langxie29-cpu/QS30-driver/symbols/README.md

# QS30-1 原理图符号建库说明书（供立创EDA 建库）

配套文件：
- 脚号映射：`docs/qs30_1_pin_mapping.csv`
- 符号规格（机器可读）：`symbols/QS30-1_symbol_spec.json`
- 管座封装草案：`symbols/QS30-1_socket_footprint_draft.json`（TBD，H03）
- 管座实测工作表：`docs/footprint/H03_管座实测工作表.md`
- 1:1 校对页：`docs/footprint/QS30-1_管座_1比1校对页.pdf`

## 1. 符号基本信息

| 属性 | 值 |
|---|---|
| 器件名（Symbol Name） | `QS30-1` |
| 位号前缀（Designator） | `J_T`（六只管座 J_T1…J_T6） |
| 器件类型 | 显示管 / 13 脚 |
| 数据手册来源 | S6 南昌电子管厂《QS30 型辉光放电数码管说明书》（版本见 `source_register.md`） |
| 封装 | 13 脚管座（J13-1A 形式）——**封装暂用 PROVISIONAL 草案，H03 关闭前不得投板** |
| 状态 | 符号 VERIFIED；封装 PROVISIONAL |

## 2. 脚号与命名（**必须 1:1，禁止按数字 0–9 重排**）

| 脚号 | 名称 | 电气类型 | 处理 |
|---|---|---|---|
| 1 | IC_KEEP_OPEN | 无连接 | 悬空 |
| 2 | A | 阳极 | 接 HV_BUS 经 20 kΩ 限流 |
| 3 | K0 | 阴极 | 数字 0 |
| 4 | K9 | 阴极 | 数字 9 |
| 5 | K8 | 阴极 | 数字 8 |
| 6 | K7 | 阴极 | 数字 7 |
| 7 | K6 | 阴极 | 数字 6 |
| 8 | IC8_KEEP_OPEN | 无连接 | 悬空（**不接地**） |
| 9 | K5 | 阴极 | 数字 5 |
| 10 | K4 | 阴极 | 数字 4 |
| 11 | K3 | 阴极 | 数字 3 |
| 12 | K2 | 阴极 | 数字 2 |
| 13 | K1 | 阴极 | 数字 1 |

> 注意：3–7、9–13 的**顺序不是 0,1,2…9**，而是原厂电极接线图的顺序（3=K0、4=K9、5=K8、6=K7、7=K6、9=K5、10=K4、11=K3、12=K2、13=K1）。
> 任何"按数字顺序重排"都会导致显示错位，属必须拦截的错误。

## 3. 建库步骤（立创EDA 专业版）

1. 新建符号 → 名称 `QS30-1`，位号前缀 `J_T`。
2. 画矩形外框（建议 20 × 30 mm 视觉比例，非机械尺寸）。
3. 放置 13 个引脚，按上表填 **脚号** 与 **名称**；引脚朝向：阳极在上、阴极在下或按可读性分列（不影响网表）。
4. 引脚电气类型：1/8 设为 `无连接/NC`；2 设为 `阳极`；其余设为 `无源/阴极`（立创EDA 中按可用的电气类型选择即可）。
5. 属性里填写：`Manufacturer=南昌电子管厂`、`MPN=QS30-1`、`Datasheet=S6 原厂说明书（归档文件）`、`Status=HOLD(批次验证)`。
6. 关联封装：使用 13 脚管座封装草案（H03 关闭后替换为实测版）；**封装焊盘号必须等于 1–13**。
7. 在符号上标注：`1/8脚悬空`、`Ea=170V Ra=20k Ik≈2.25mA`，避免后人误接。

## 4. 建库后必须做的核对（签审证据）

- [ ] 原理图符号脚号 = 本表 = 封装焊盘号 = 实物管脚号（4 方一致，逐页签字）
- [ ] 用"1 脚方向图 + 1:1 打印图"与实物管座比对
- [ ] 3D 模型只作外观参考，**不得**用外观吻合替代脚号正确
- [ ] 与 `docs/qs30_1_pin_mapping.csv` 逐行比对（可用脚本：`python design/build.py` 的 ERC 检查不覆盖本项，需人工签字）

## 5. 已知限制

- 符号电气映射 VERIFIED（原厂图）；**观察面/封装坐标**仍是 H03 的实测内容。
- 无小数点/冒号电极；若后续需要，必须另立显示器件与 BOM/HOLD，不占用 1/8 脚。
