langxie29-cpu/QS30-driver/design_decisions.md

# QS30-6 REV.A 设计决策表

版本 REV.A ｜ 日期 2026-10-18 ｜ 状态：**HOLD（可继续 PCB 预布局，禁止投板/生产放行）**

状态定义：`VERIFIED` 有原厂原文或实测证据 ｜ `STRONGLY SUPPORTED` 有充分可靠资料 ｜
`PROVISIONAL` 合理候选、仍需验证 ｜ `HOLD` 缺关键证据 ｜ `FAIL` 已发现不满足要求。

---

## D-01 QS30-1 电极与脚号定义 —— VERIFIED（原厂说明书 S6）

依据：南昌电子管厂《QS30 型辉光放电数码管说明书》"电极接线图"（扫描页放大读图，见
`docs/source_scans/QS30-1_电极接线图.png`）。图为**管底 13 脚圆周排列**，编号 1–13 顺时针；
图内未标注"顶视/底视"，观察方向仍属 H03 的验证内容，但**电气映射本身已由原厂图确定**。

| 物理脚号 | 功能 | 原理图处理 | 封装焊盘 |
|---|---|---|---|
| 1 | 内部电极（非显示，原厂图仅标 ①） | `IC_KEEP_OPEN`，悬空 | 保留焊盘，不接线 |
| 2 | 阳极 A | `A_T1..A_T6` | 1:1 |
| 3 | 数字 0 阴极 K0 | `K_Tn_0` | 1:1 |
| 4 | 数字 9 阴极 K9 | `K_Tn_9` | 1:1 |
| 5 | 数字 8 阴极 K8 | `K_Tn_8` | 1:1 |
| 6 | 数字 7 阴极 K7 | `K_Tn_7` | 1:1 |
| 7 | 数字 6 阴极 K6 | `K_Tn_6` | 1:1 |
| 8 | 内部电极（非显示） | `IC8_KEEP_OPEN`，悬空，**不接地** | 保留焊盘，不接线 |
| 9 | 数字 5 阴极 K5 | `K_Tn_5` | 1:1 |
| 10 | 数字 4 阴极 K4 | `K_Tn_4` | 1:1 |
| 11 | 数字 3 阴极 K3 | `K_Tn_3` | 1:1 |
| 12 | 数字 2 阴极 K2 | `K_Tn_2` | 1:1 |
| 13 | 数字 1 阴极 K1 | `K_Tn_1` | 1:1 |

**结论**：旧交接文件的候选映射（3=K0、4=K9、5=K8、6=K7、7=K6、9=K5…13=K1，1/8 脚不接）
与原厂图一致，予以采纳；符号脚号 = 物理脚号 = 封装焊盘号，**禁止按数字 0–9 重排**。
无小数点/冒号电极（原厂图只有 10 个数字阴极 + 阳极 + 2 个内部电极）。

## D-02 工作参数与额定值 —— VERIFIED（S6 原厂"基本参数"表）

| 参数 | 原厂值 | 本单位处理 |
|---|---|---|
| 起辉电压 Uz | ≤150 V | HV_BUS 设计 172 V > 150 V，正常起辉 |
| 熄灭电压 Ux | ≥100 V | 断电/降额时低于 100 V 全灭，可用于安全判定 |
| 工作电压(直流) Ea | 170 V（原厂推荐点） | 设计 172.18 V（+1.3%），见 D-04 |
| 阴极工作电流 Ik | 1.5 / 2.25 / 3 mA（最小/中心/最大） | 设计 ≈2.36 mA，在 1.5–3 mA 内 |
| 限流电阻 Ra | 20 kΩ @170 V（推荐表：170/20、200/33、220/43、250/56、280/68、300/82） | 20 kΩ（2×10 kΩ/2 W 串联） |
| 寿命 | 1000 h | 长期常亮显示需按此评估（记录为限制条件） |
| 外形 | φ30.2；总高 34±1.5；本体 26±0.5；13×φ1.3；显示高度 15–16 mm | 用于结构/管座间距初值 |
| 管基 | GB 787-74 J13-1A | 机械尺寸仍需 H03 证据 |
| 重量 | ≤15 g | 结构评估参考 |

## D-03 驱动架构与 HV5622 数量 —— VERIFIED（S5 数据手册重算）

- 需求：6 管 × 10 数字 = **60 路**独立数字阴极通道（静态驱动，不扫描）。
- S5：HV5622 = 32-bit 移位寄存器 + **32 路**开漏高压输出；VDD 10.8–13.2 V；
  HVOUT 推荐 ≤220 V、绝对最大 230 V；灌电流 ≥100 mA；44 脚 PQFP/PLCC。
- **重算结论：2 片 × 32 = 64 路 ≥ 60 路，采用 2 片**。旧交接文件的"3 片 / 96 路"不再成立，
  除非增加 4 位以上扩展显示；本次无该需求。帧长相应由 96 bit 改为 **64 bit**。
- 通道分配：CH0–31 → U21（HVOUT1–32），CH32–63 → U22（HVOUT1–32）；CH60–63 备用、输出不接。
- 每管 10 路连续分配：`CH = (管位−1)×10 + 数字`，于是 **J_T4 跨越 U21/U22 边界**
  （数字 0–1 在 U21，数字 2–9 在 U22），必须逐位验证，见 D-07。

## D-04 高压工作点与阳极支路 —— PROVISIONAL（值），VERIFIED（依据）

- HV_BUS 目标 172.18 V = 2.5 V × (1 + 1500 kΩ / 22.1 kΩ)，由 R69/R70（2×750 kΩ）+ R71（22.1 kΩ）设定。
- 每管限流：R90…R101 = 2×10 kΩ/2 W 串联 = 20 kΩ（原厂推荐值）。
  - 正常：I ≈ (172.18 − U_tube)/20 kΩ；若 U_tube≈125 V 则 2.36 mA，管耗 ≈0.29 W。
  - 单管短路（阳极–阴极直通）：电阻耗散 172.18²/20 kΩ ≈ **1.48 W**（每只 2 W 电阻 0.74 W，37%）。
  - 因此**不得**用 1/4 W 或单只 1 W 电阻替代。
- 六管总负载：6×2.36 mA ≈ 14.2 mA → 2.44 W；加泄放 0.86 mA + 反馈分压 0.11 mA → ≈2.61 W。
- 工作点未冻结原因：U_tube 随批次/电流/温度变化，必须用单管夹具实测（H02/H06）后按
  `R_A = (Ea − U_tube − V_sink) / I` 复核。

## D-05 HV5622 控制极性与安全默认态 —— VERIFIED（S5 Table 3-2）

| 输入 | 取值 | 结论 |
|---|---|---|
| POL | 固定接 DRV_VDD（高） | POL=H 时 BL=L → 全部关断；BL=H → 由锁存数据决定 |
| BL | 低 = 消隐（全部关断） | 12 V 域 10 kΩ 下拉，3.3 V 失电/转换器未供电时为低 |
| LE | 高电平把移位寄存器装入锁存器（Table 3-2 "Load Latches"） | 数据手册引脚名带横线，但真值表明确 LE=H 装载，按真值表执行 |
| CLK | **下降沿**移位 | SPI 采样边沿须实测匹配 |
| DATA | 1 = 通道导通（POL=H、BL=H） | 全 0 帧 = 全灭 |

**关键风险（已在硬件中处理）**：POL=L 且 BL=L 时器件为"All On"。因此 POL 不接 MCU、不悬空；
同时升压使能受 DRV_VDD 电源良好（DRV_PG）门控，驱动未上电时高压不会建立。

## D-06 3.3 V → 12 V 电平转换 —— VERIFIED（S13 引脚），PROVISIONAL（时序实测）

- U3/U4 = CD40109B：VCC=3V3、VDD=DRV_VDD、VSS=GND；每个通道独立 ENABLE 接 3V3。
  - 3.3 V 失电 → ENABLE=0 → 输出高阻，同时 12 V 域每个输入有 10 kΩ 下拉 → **确定低电平/消隐**。
  - 引脚：1 VCC、2/7/9/15 ENABLE A–D、3/6/10/14 A–D、4/5/11/13 E–H、8 VSS、12 NC、16 VDD。
  - 通道分配：DIN/CLK/LAT/ALLOW → E/F/G/H；第二片用于 HV_EN_REQ（其余通道输入接地）。
- 输入高电平要求：器件规定输入摆幅须到 ≥0.7·VCC；VCC=3.3 V → VIH≈2.31 V，3.3 V GPIO 满足。
- 传播延迟：VCC=5 V/VDD=10 V 时最大 300 ns；3.3 V/12 V 条件下按 **≤600 ns 暂估**（待实测）。
  → **SPI 起始频率取 100 kHz，上限按 200 kHz 评估**（周期 5 µs，留 ≥8 倍裕量）。
  该限值远低于 HV5622 的 8 MHz 能力，显示刷新不受影响。

## D-07 通道映射与串行位序 —— 映射 VERIFIED，位序 PROVISIONAL

- 完整表见 `docs/channel_mapping.csv`（64 行）与 `docs/schematic/QS30-6_REV.A_通道映射表.png`。
- HVOUT↔PQFP 引脚（S5 Table 2-1）：HVOUT1→pin22、HVOUT2→pin21 … HVOUT22→pin1；
  HVOUT23→pin44、HVOUT24→pin43 … HVOUT32→pin35。
- 串行位序假设：64 bit 帧，bit0 先发，`bit_j = CH(63−j)`（U21 的近端位在最后）。
  **必须用 walking-one 实测**（0x0000000000000001、0x0000000000000002…逐位）确定
  近端/远端器件与字节位序，不得用软件数组掩盖镜像封装。位序确认前不得写死固件 LUT。

## D-08 电源架构与预算 —— PROVISIONAL（数值来自计算/仿真）

```
J1 12V → F1(PPTC 1.5A) → D1(TVS) → D2(SS54 反接) = EXT12 (≈11.5 V)
EXT12 → U1 TPS54202 → EXT5 (5.08 V) ─┐
VBUS (USB-C) ────────────────────────┴→ D3/D4 双肖特基 OR → 5V_SYS (≈4.73 V) → U2 SY8089A → 3V3 (3.315 V)
EXT12 → Q1(DMP3098L, 默认关断) → DRV_VDD (≈11.45 V) → U21/U22 VDD、CD40109B VDD
EXT12 → Q26(默认关断) → HV_IN → U20 UC3843 升压 → HV_BUS 172 V
```

| 域 | 设计值 | 负载/预算 | 依据 |
|---|---|---|---|
| EXT12 | 11.5 V（12 V−0.5 V） | 总 ≈0.60 A（7.2 W） | 计算：升压 0.29 A + 5 V 级 0.28 A + 驱动逻辑 0.03 A |
| EXT5 | 5.08 V | ≤0.8 A | TPS54202 2 A |
| 5V_SYS | ≈4.73 V（EXT5−0.35 V）或 4.65 V（VBUS−0.35 V） | ≈0.63 A | SY8089A 2 A / TPS54202 2 A |
| 3V3 | 3.315 V | 800 mA 分配（模组 500 + 接口 50 + 扩展 50 + 瞬态 200） | S1 要求 ≥500 mA 供电能力；1 A 以上稳压器 |
| DRV_VDD | ≈11.45 V | HV5622 静态 + 6 路灌电流 | 必须在 10.8–13.2 V 内（S5） |
| HV_BUS | 172.18 V | 六管 14.2 mA + 泄放/分压 | S6 + D-03 |

- **USB 单独供电限制**：USB-C 仅声明默认 500 mA（CC 5.1 kΩ）。仅 USB 供电时固件必须关闭
  Wi-Fi 发射并限制负载；整机满功能不得依赖 USB 供电（H05 验证项）。
- 3.3 V 瞬态：模组 Wi-Fi 发射峰值按 S1 的 ≥500 mA 供电要求预留，实测项见 test_plan 阶段 A。

## D-09 硬件使能门控 —— PROVISIONAL（门限已计算，器件候选）

| 信号 | 判据 | 计算 |
|---|---|---|
| EXT12_PG | EXT12 ≥ 10.80 V | 2.5 V×(100 k+30.1 k)/30.1 k = 10.80 V |
| P3V3_PG | 3V3 ≥ 3.107 V | 2.5 V×(10 k+41.2 k)/41.2 k = 3.107 V |
| DRV_PG | DRV_VDD ≥ 10.41 V | 2.5 V×(100 k+31.6 k)/31.6 k = 10.41 V |
| FAULT_OK | HV_FAULT_N 高（无故障） | 故障分压：11.45 V→3.06 V；故障时 0 V |
| **DRV_VDD_EN** | EXT12_PG · 3V3_PG · HV_EN_REQ | 74HC08 门 1+2 |
| **HV_EN** | DRV_PG · FAULT_OK · HV_EN_REQ | 74HC08 门 3+4 |

- MCU 只能"请求"（GPIO16 = HV_EN_REQ）；上述组合由 **74HC08 + 比较器 + 基准** 在硬件中完成。
- 全部输出默认低：74HC08 由 3V3 供电，3V3 未建立时输出低；HV_EN 另有 100 kΩ 下拉；
  Q1/Q26 栅极经 100 kΩ 上拉到源极 → **默认关断**。
- 掉电顺序：先消隐（DRV_BL 低）→ 关升压 → HV 泄放 → 再撤驱动逻辑电源；失电时
  12 V 域下拉保证 BL 低、HV_EN 低。

## D-10 独立硬件过压保护 —— PROVISIONAL（电路已设计，尚需实物验证）

- 取样：R75/R76 = 2×750 kΩ、R77 = 19.1 kΩ → 触发 198.8 V（2.5 V TL431 基准）。
- 比较器：U23 LM393（由 EXT12 供电，独立于 MCU 与 3.3 V）。
- 锁存：Q21(PNP)+Q22(NPN) 分立 SCR；触发后 Q23 拉低 UC3843 COMP（占空比→0），
  Q24 拉低 `HV_FAULT_N`（低有效，经分压进 MCU GPIO7，并作为 FAULT_OK 参与门控）。
- 受控恢复：MCU GPIO18 脉冲 → Q25 拉低 OVP_LATCH；仅当 HV 已降到 198.8 V 以下才真正释放。
- 阈值裕量：HV_BUS 172 V < 198.8 V < HV5622 推荐 220 V / 绝对最大 230 V；
  输出电容 250 V 额定 > 198.8 V（含启动过冲 180.7 V，仿真值）。
- **仿真（`design/sim_boost.py` S7/S8）**：反馈分压开路时输出在 142 ms 冲到 198.8 V，
  被 OVP 关断并锁存；复位后因故障未消除在 558 ms 再次触发。

### 故障 → 关断路径矩阵

| 故障 | 关断路径 | 仿真/证据 | 仍需实物验证 |
|---|---|---|---|
| ESP32 死机/复位 | HV_EN_REQ 复位为低 → HV_EN 低 → Q26 关断；无 MCU 也能保持 OVP/过流保护 | 逻辑分析 | 上电/复位瞬态 |
| ADC 读数错误 | ADC 仅监控；硬件 OVP 独立 | 设计 | 分压/ADC 校准 |
| GPIO 卡在高电平（HV_EN_REQ） | 仍需 EXT12_PG·3V3_PG·DRV_PG·FAULT_OK 同时成立；OVP 独立 | 设计 | 注入故障测试 |
| 反馈分压断路 | FB=0 → 满占空 → 198.8 V OVP 锁存（S7） | 仿真 S7 | 实物断路测试 |
| 升压输出超过上限 | OVP 比较器 → SCR 锁存 → COMP 拉低 + HV_FAULT_N | 仿真 S7/S8 | 阈值容差实测 |
| 驱动电源先于高压掉电 | DRV_BL/DRV 域下拉 → 全关；且 HV_EN 需 DRV_PG | 设计 | 时序示波器 |
| 输入电源突然断开 | HV 通过 200 kΩ 泄放到 50 V 需 ≈3.8 s（S9）；期间保持隔离 | 仿真 S9 | 实测下降曲线/等待时间 |
| 单通道/单管短路 | 阳极电阻限流 1.48 W；驱动输出 Off 态 10 µA | 计算 | 单管短路试验 |

## D-11 升压变换器设计 —— PROVISIONAL（计算+仿真），待实测

| 项目 | 取值 | 依据 |
|---|---|---|
| 拓扑 | Boost，UC3843 峰值电流模式 | 12 V→172 V，输出 ≈2.6 W |
| fsw | 78 kHz = 1.72/(10 kΩ×2.2 nF) | UC3843 RT/CT |
| L20 | 220 µH，**Isat ≥5 A** | 稳态 ΔI≈0.65 A；启动浪涌峰值 2.9–3.1 A（仿真） |
| Q20 | IRF740（400 V/10 A，TO-220） | 172 V + 振铃，2 倍以上裕量 |
| D20 | UF4007（1000 V/1 A，快恢复） | 反压 172 V；浪涌电流容限 |
| 采样 | 1 Ω/1 W → 1 V 门限 = 1 A 峰值限流 | UC3843 ISENSE 1 V |
| Cout | 2×10 µF/250 V + 0.1 µF/630 V | 纹波/储能；250 V 额定 |
| 泄放 | 2×100 kΩ = 200 kΩ（τ≈4 s） | 断电到 50 V 实测仿真 3.84 s |
| 反馈 | 2×750 kΩ / 22.1 kΩ → 172.18 V | UC3843 VFB 2.5 V |
| 软启动 | COMP 22 µF（≈1 mA 上拉，参考斜坡 150 ms） | 启动过冲 180.7 V（+5.0%） |
| RCD 钳位 | D21 + 10 nF/630 V + 100 kΩ/2 W | 抑制漏感尖峰 |

**启动浪涌发现（重要）**：HV_EN 接通瞬间，HV_IN 经 L20、D20 直接给 20 µF 充电，
峰值电流由 L–C 与 DCR 决定，仿真 **2.9–3.1 A**（12 V/220 µH/20 µF）。
→ 必须选用 Isat ≥5 A 电感；PPTC(1.5 A hold) 的 I²t 需实测确认不误动作；
  二极管 30 A 浪涌余量足够。若实测浪涌超标，在 H06 内评估 NTC/预充电阻方案。

**仿真关键结果**（行为模型，详见 `sim/results/summary.json`）：

| 场景 | 稳态电压 | 峰值 | 过冲 | 备注 |
|---|---|---|---|---|
| S1 启动（六管） | 172.08 V | 180.75 V | +4.97% | 未触发 OVP |
| S4 六管稳态 | 172.08 V | — | — | 纹波 1.1 Vpp，效率 77.6% |
| S2 空载（消隐） | 172.19 V | 187.4 V | +8.8% | 效率 57%（轻载） |
| S3 单管 | 171.81 V | — | +7.9% | 效率 59.6% |
| S5 负载突变 6→1→6 | 172.34 V | 180.75 V | — | 效率 79.0% |
| S6 输入 12/11.4/12.6 V | 172.21 V | 180.3 V | — | 效率 77.7% |
| S7 反馈开路 | — | 198.80 V | — | 142 ms 触发 OVP 并锁存 |
| S8 锁存→复位 | — | 198.81 V | — | 558 ms 再次触发 |
| S9 断电 | — | — | — | 到 50 V 用时 **3.84 s** |
| S10 输出短路 10 Ω | 10.8 V | — | — | 峰值限流工作，无 OVP 误动作 |

## D-12 MCU / USB / 接口分配 —— 与交接文件一致（可追溯）

- 焊接焊盘编号已用 S1/S2 核对，GPIO/焊盘/网络对照由 `docs/erc_report.md` 的 ERC-04 自动校验通过。
- 与交接文件的差异：新增 **GPIO18=OVP_RST**（过压锁存受控复位）；GPIO13/GPIO21 仍作扩展。
- USB：GPIO19=D−、GPIO20=D+；22 Ω 串联（S1b 建议 22/33 Ω）；CC1/CC2 各 5.1 kΩ；
  U11 USBLC6-2SC6 靠近连接器；VBUS 与 5V_SYS 经肖特基 OR（反向阻断）。
- UART0：GPIO43(TXD0)/GPIO44(RXD0)，TXD0 串 499 Ω（S1b 建议），3V3 参考点经 0 Ω（默认不装）。
- 启动：EN=10 kΩ+1 µF；GPIO0=10 kΩ 上拉 + BOOT 按键；GPIO46=10 kΩ 下拉；GPIO3/45 不接外设。
- 扩展/测试：TP1–TP20、J4（3V3/GND/IO13/IO21/I2C）。

## D-13 PCB 分区与层叠 —— PROVISIONAL（预布局）

- 建议外形 **230 × 120 mm**，4 层（信号–地–电源–底层），两层板仅在回流/禁布/抗扰实测通过后采用。
- 六个管座沿上侧排布，中心距 **36 mm**（φ30.2 + 插拔/散热余量；待 H03 实测管座后冻结）。
- 天线：模组天线端朝板边并伸出；天线投影区及两侧全层禁铜/禁线/禁孔/禁件；
  外壳各方向建议 ≥15 mm 净空（H08）。
- 高压区（升压/OVP/驱动）与 USB/天线/按键分区，中间设 2 mm 隔离槽/禁布带（H07 定稿）。
- USB 差分 90 Ω ±10%（按板厂层叠计算，不复制他板线宽）；下方连续地参考。
- HV 网络（HV_BUS、SW_HV、阳极、阴极、采样/反馈）单独网络类别，规则暂按 1.0 mm 间距占位。

## D-15 管座封装草案的“不猜测”策略 —— PROVISIONAL

- 原厂资料只给**管子**尺寸（φ30.2、34±1.5、26±0.5、13×φ1.3）与**电气脚号关系**，
  不给**管座焊脚坐标**；GB 787-74 正文未取得，且"J13-1A"是管基型号、不等于任何在售管座。
- 因此封装草案（`symbols/QS30-1_socket_footprint_draft.json`）只包含：
  脚号 1:1 规则、管体参考尺寸、13 等分角度（360/13），**所有焊盘几何字段为 TBD/None**；
  生成脚本内置校验，若出现任何被猜出来的数值数字则直接失败（已验证 PASS）。
- 1:1 校对页（300 dpi）只画已核实尺寸 + 100 mm 标尺 + 待填表格，用于现场叠图测量；
  实测结果填回 JSON 后方可生成封装 v2（H03 关闭证据）。

## D-16 仿真可信度策略 —— 步长必须收敛

- 开关级模型用固定步长（开关周期 1/N）。步长过粗会显著改变结论：
  Ts/40 时稳态电压偏高 **13.5%**、峰值偏高 8.7%（见 `sim/results/convergence.md`）。
- 因此规定：**主仿真使用 Ts/80**（相对 Ts/160 的稳态偏差 ≤0.4%、峰值 ≤0.01%）；
  任何引用仿真数字的文档必须同时写明模型类型与步长，禁止只报结果。
- 该模型不是器件级 SPICE；SPICE 引擎在本环境不可用（KiCad 安装需管理员权限、
  ngspice 下载被 403），`sim/boost_uc3843.cir` 为参考网表且**未执行**。

## D-18 仿真证据分级 —— 三种证据，用途不同

| 级别 | 工具 | 覆盖 | 已执行? |
|---|---|---|---|
| A. 厂商 SPICE | ngspice/LTspice | 器件级开关/寄生/环路 | **否**（环境无该软件，网表未执行） |
| B. 仓库自带 SPICE 子集 | `sim/minispice.py` | 功率级 RLC+二极管+压控开关、固定占空比 | **是**：解析解自检 PASS；升压功率级 Vout 171.99 V vs 解析 171.95 V、iL 峰值 503 vs 510 mA、纹波 8.7 vs 9.0 mVpp、效率 95.9% |
| C. 行为模型 | `design/sim_boost.py` | 闭环、软启动、OVP 锁存/复位、泄放、短路 | **是**：S1–S10，步长 Ts/80 收敛 |

- 结论引用规则：**功率级数值**优先用 B（有解析对照）；**闭环/保护行为**用 C；
  器件级尖峰、EMI、温升必须等 A 或实物（H06）。
- Coss 敏感性（B）：100 pF 开关节点电容使效率从 95.9% 降到 91.0% → 低 Coss 器件是硬要求。
- B 源已支持并自检 PASS；但**闭环** SPICE 的环路时间常数 ≈170 ms（CINT 22 µF + Ki 1.3e-4），
  按开关级步长需 >10⁶ 步，超出本环境算力 → 闭环仍以 C（行为模型）为准，
  `sim/boost_uc3843.cir` 继续标注为未执行参考网表。

## D-19 网表级 DRC 预检 —— 把能机器检查的项先查掉

在无立创EDA 的环境里，用 `design/drc_precheck.py` 从同一设计数据库做 10 项
**隔离/端点/规则覆盖**检查（当前 10/10 PASS）：

| 检查 | 内容 |
|---|---|
| D1 | HV 网络端点必须在高压允许清单（防高压误连低压器件） |
| D2 | 3.3 V 器件不得直接连 HV/DRV 网络 |
| D3 | 12 V 域器件不得连 3V3 |
| D4/D5 | 60 路阴极 / 6 路阳极网络端点结构正确（各 2 端点） |
| D6 | HV_BUS 端点清单审计（17 个端点全部白名单） |
| D7 | HV 网络测试点白名单（TP6/TP19，须丝印高压警告） |
| D8 | HV 网络类别/间距规则覆盖（1.0 mm 占位，H07 定稿） |
| D9 | MCU 页不出现 HV 器件（HV 分压电阻画在 MCU 页 → 必须在高压区布置） |
| D10 | HV 网络与 3V3 网络无共享器件 |

**边界**：这不是原生 DRC；布线间距、孔径、天线禁布、爬电距离必须等 H07/H09 的 EDA 执行。

## 基线数字（单一事实来源：docs/design_summary.json）

- 器件 **227** 个、引脚 **736** 个、网络 **172** 个、已用通道 **60** 路（2×HV5622 共 64 路，4 路备用）；
- 19 项 ERC 检查 0 错误 0 告警；DRC 预检 14/14；测试计划一致性 5/5。

## D-20 HOLD 证据验收框架 —— 把"缺什么证据"变成可执行检查

`design/evidence_templates.py` 从设计数据库生成 10 个证据模板（`docs/evidence/`），
**期望值/判据自动填入**（如 QS30-1 期望发光脚、OVP 197.3–200.3 V、纹波 <200 mVpp、
滞放 ≤5 s、浪涌 ≤3.5 A），避免人工抄错；`design/evidence_check.py` 把每个 HOLD 判为：

| 状态 | 含义 |
|---|---|
| 未提交 | 全部单元格仍为 FILL |
| 部分提交 | 有填写但未填完 |
| 已提交·判据通过 | 全部填写且落在设计判据内 |
| 已提交·判据失败 | 有数值越界/映射错误（输出具体失败项） |

框架自测（`docs/evidence_selftest.md`）用合成数据证明：未提交→正确识别；合法数据→7/7 通过；
人为注入 3 处错误（OVP 215 V、walking-one 错位、非显示脚"发光"）→ 校验器准确捕获并退出码 2。
**自动校验不替代签审**：PASS 后仍需在 `HOLD_REGISTER.md` 记录签署人/日期/版本。

## D-21 闭环 SPICE：平均模型（已执行）

| 项 | 内容 |
|---|---|
| 模型 | 平均开关节点 `v_sw=(1−d)(Vout+Vf)`；平均二极管电流 `(1−d)·iL` 注入输出；L/C 显式积分 |
| 控制器 | 与 BOM 相同的 CINT 22 µF、Ki=1.3e-4 A/V、Kp=0.05（PI） |
| 已执行 | 启动/稳态 300 ms、负载 +50% 与输入 12→11.4 V 阶跃 500 ms（步长 20 µs） |
| 结果 | 172.18 V（误差 3 mV）、duty 0.931、iL 219 mA；负载 +50% 下探 0.25 V；输入 12→11.4 V 下探 3.90 V/恢复 8 ms；闭环判据 **8/8**；初值取工作点，启动暂态由行为模型 S1 覆盖 |
| 边界 | 不含开关纹波/器件应力（开关级覆盖）；不含 OVP 锁存（行为模型 S7/S8 覆盖）；R72/C56 实际补偿相位裕度需 H06 实测 |
| 与开关级闭环的关系 | 开关级闭环受算力限制未执行（I-23）→ 用「平均模型闭环 + 开关级开环 + 行为模型」三段证据组合 |

## D-22 独立 OVP 的 SPICE 侧证据（保护逻辑行为模型）

`sim/boost_ovp_logic.cir`：升压级等效为限流受控电流源 + 输出电容，验证保护**时序**：

| 判据 | 结果 |
|---|---|
| 首次触发电压 198.8±3 V | **198.92 V**（1.14 ms） |
| 触发后锁存并关断 | PASS（0.05–0.59 s 内 latch≈1、EN=0） |
| 泄放（0.3 s 时 <150 V） | 123.1 V |
| 复位脉冲释放锁存 | PASS（GPIO18 脉冲；等价"SCR 在 OVP 有效时不可复位"，故复位仅在 HV 低于阈值时生效） |
| 故障未消除 → 再次锁存 | PASS |
| 全过程最大电压 ≤205 V | 201.92 V |
| 最终保持锁存/关断 | PASS |

与行为模型 S7/S8（198.80 V 触发 / 142 ms；复位后 558 ms 再触发）互为独立证据；
器件级 SCR 维持电流/触发延迟/结温仍属 H06。

## D-23 HOLD 签署联动 —— 自动证据 + 人工签审

`design/hold_signoff.py` 读取自动证据状态与 `docs/HOLD_SIGNOFF.csv` 签署表，联动规则：

| 自动证据 | 签署 | 联动结果 |
|---|---|---|
| complete | 签署齐全 + CLOSED | **CLOSED**（解除阻塞） |
| complete | 未签署 | PENDING_SIGN |
| missing/partial/fail | 决定 CLOSED | **VIOLATION**（必须撤销） |
| H01/H09（无 CSV） | 未签署 | MANUAL（需人工审查记录） |

**自动校验不能单独关闭 HOLD**：证据通过只把状态推进到"待签署"，必须人工签审才解除投板/生产阻塞。

## D-24 环路参数敏感性扫描（供 H06 补偿调整）

`design/loop_scan.py`：27 组 CINT/Ki/Kp × 输入阶跃，结果 `docs/loop_scan.md/csv`：

| 结论 | 数据 |
|---|---|
| 比例项主导下探 | Kp 0→0.05→0.15：下探 8.2→4.1→2.1 V |
| 积分项影响恢复/稳态 | Ki 过小 + CINT 47 µF + Kp 0.15 → 末段振荡 95 mV（不稳定） |
| BOM 参考点 | CINT 22 µF / Ki 1.3e-4 / Kp 0.05 → 下探 4.10 V，恢复 9 ms |
| 26/27 组稳定 | 仅 1 组振荡（给出稳定边界） |

**边界**：PI 等效 ≠ UC3843 电流模式 Type-II 补偿（R72 10 k / C56 0.1 µF / C55 22 µF 软启动）；
本扫描只用于趋势与稳定性边界，R72/C56 最终值须 H06 实测相位裕度确定。

## D-25 OVP 复位时序窗口（SPICE 行为模型）

`design/ovp_timing_scan.py`（7 组复位脉宽）：

| 结论 | 数据 |
|---|---|
| 不复位时锁存保持 | 0.9 s 内保持（latch>0.9），输出安全泄放 |
| 可靠复位最小脉宽 | 0.2 ms（20 µs 步长分辨率） |
| 复位后故障未消除 | 再次锁存，最大电压 201.3–201.9 V |
| 复位有效性条件 | 仅当 HV 低于 OVP 阈值（OVP 有效时复位无效） |

**边界**：行为级 SCR 等效，不含维持电流/门极延迟/结温/dV/dt 误触发 → H06 实物时序窗口。

## D-26 测试计划机器可读化与一致性检查

`docs/test_plan.md`（人读）整理为 `docs/test_plan.csv`（37 项，阶段 A–E，含证据目标），
`design/test_plan_check.py` 做 5 项检查（**5/5 PASS**）：

| 检查 | 内容 |
|---|---|
| T1 | 序号唯一、阶段 A–E 齐全、状态合法 |
| T2 | 每个 evidence_target 的 HOLD 合法且证据文件存在 |
| T3 | 10 个证据 CSV 全部被测试计划引用（无孤立证据） |
| T4 | 阶段↔证据映射（C→H06、C0→H07、D→H02/H03、B→H04、E3→H08） |
| T5 | test_plan.md 与 CSV 序号集合一致（防文档漂移） |

新增 C0（PCB 高压间距/爬电实测）测试项，补上 H07 的硬件验证入口。

## D-27 固件约束清单（从设计数据库派生）

`design/firmware_constraints.py` 从网表与通道映射自动生成 `docs/firmware_constraints.md/json`，
**GPIO/网络名不手写**（防止与原理图脱节）。当前：8 个控制脚（DISP_DIN/CLK/LAT/ALLOW、
HV_EN_REQ、OVP_RST、HV_SENSE_ADC、HVF_NODE）、**64 位帧**（60 用 + 4 备）、13 条约束：

| 类别 | 关键约束 |
|---|---|
| 帧/位序 | 64 位，MSB-first，bit=63−ch（H04 实测前 PROVISIONAL） |
| 时序 | CLK 下降沿移位，LE 高装载；SPI ≤200 kHz（起始 100 kHz） |
| 消隐 | DISP_ALLOW(IO15) → CD40109B → DRV_BL：BL=0 全关 |
| 门控 | HV_EN_REQ 仅在自检通过后置 1；复位期间必须为 0 |
| 故障 | 读 HVF_NODE(IO7)；FAULT_OK=0 硬件关 HV；不得自动反复复位 |
| OVP 复位 | 脉宽 ≥0.2 ms，且 HV<198.8 V 时才有效 |
| 供电 | USB-only ≤500 mA；备用通道 ch60–63 发 0 |

## D-28 跨文档关键数字一致性检查

`design/doc_number_check.py` 把"单一事实来源=机器可读结果"落到检查上（**5/5 PASS**）：

| 检查 | 内容 |
|---|---|
| C1 | 关键数字在 README 与 design_decisions 均出现（172.18/198.8/95.9%/227/736/60） |
| C2 | 当前文档不得出现废弃旧值（95.8%、"负载 158 ms"误归因、"启动建立时间"） |
| C3 | 平均模型判据必须是 8/8（曾为 7/7） |
| C4 | 审查包页数与 CHANGELOG 最后记录一致 |
| C5 | 与 design_summary/spice_validation/drc_precheck/test_plan_check 的机器结果一致 |

本轮它实际抓到 4 处漂移（95.8%、158 ms 误归因、7/7、缺少基线数字）并已修正——说明检查有效。

## D-29 BOM 选型复核（关键器件降额/替代料）

`design/bom_review.py` 对 14 个关键器件做自动化降额检查（**5/5 PASS**）：

| 检查 | 规则 | 结果 |
|---|---|---|
| H1 | 关键器件均在 BOM 中 | 14/14 |
| H2 | L20 满足 Isat ≥5 A（F-04） | BOM 已更新为 `220 µH ≥5 A` |
| H3 | 高压器件额定 ≥ 248 V（max(172.18,198.8)×1.25） | Q20 400 V、D20 1000 V、C49/C52 630 V、C50/C51 250 V |
| H4 | 阳极电阻降额 ≤80% | 1.48 W / 2 W = 74% |
| H5 | 替代料/封装状态已列 | WARN：U20 的 DIP-8/SOIC-8 需在结构确定后冻结 |

**边界**：温度降额、纹波电流/ESR、磁芯饱和曲线、封装热阻仍需手册与实测（H06/H07）；
本复核不构成可下单依据；HOLD 未关闭前不得释放 Gerber。

## D-30 热与浪涌复核（参数区间法）

`design/thermal_review.py`：

- **HV5622 功耗**：静态驱动每管恒 1 路导通 → 每片同时导通 3 路；I=2.36 mA、VDD=11.45 V，
  静态电流 1–5 mA、Von 1–3 V、Rth_ja 40–80 °C/W（**均待手册核实**）→
  总功耗 19–78 mW，**温升 0.7–6.3 °C**（环境 25 °C）→ 热风险低；
- **PPTC/浪涌**（S1 波形）：峰值 3.12 A、60 ms 内 I²t ≈ **0.0010 A²·s**、超 1.5 A 仅 0.1 ms
  → 远低于典型 1812 PPTC 的 I²t 下限（0.1 A²·s 量级），**预期不误动作**；
- 新增 open_issues **I-25**：PPTC 手册 I²t/触发曲线与 HV5622 手册参数需核实 → H05/H06 实测。

## D-31 投板前检查清单（自动汇总，硬性拒绝放行）

`design/preflight_checklist.py` 汇总 11 项机器检查与 9 个 HOLD，输出
`docs/preflight_checklist.md`：

- 规则：**任一 HOLD 未 CLOSED 或任一机器检查 FAIL → RELEASE BLOCKED**；
- 当前：机器检查 **11/11 PASS**，HOLD **CLOSED 0/9** → **RELEASE BLOCKED**（不得投板/下单/Gerber）；
- 明确"本脚本不会自动放行"，放行必须人工签署 + 原生 EDA ERC/DRC（H09）；
- 列出 12 项投板前必须关闭/冻结的事项（含 U20 封装、HV5622 手册参数、PPTC I²t）。

## D-17 仍未冻结的内容

见 `HOLD_REGISTER.md`（H01–H09）。**任何 HOLD 未关闭前，本设计不得投板、不得标注 production-ready。**
