langxie29-cpu/QS30-driver/HOLD_REGISTER.md

# QS30-6 REV.A HOLD 登记册

只保留**真正缺乏证据、必须阻止设计冻结或生产放行**的问题。
关闭单项 ≠ 整机放行；全部关闭后仍须另行设计审查与授权。

当前状态：**H01–H09 全部未关闭**。更新日期 2026-10-18。

**签署联动已就绪**：`docs/HOLD_SIGNOFF.csv` + `design/hold_signoff.py`
（CLOSED = 自动证据通过 **且** 签署齐全；证据未通过却签 CLOSED 记为 VIOLATION）。

**证据模板已就绪**：`docs/evidence/`（10 个 CSV，期望值与判据自动填入）；
填表后运行 `python design/evidence_check.py` 自动判定「未提交/部分/通过/失败」，
报告见 `docs/hold_closure_report.md`；框架自身已用合成数据自测（`docs/evidence_selftest.md`）。
自动校验通过后仍需在本表人工签署关闭。

| 编号 | 待关闭事项 | 关闭所需证据（可验收） | 当前进展 | 责任（建议） |
|---|---|---|---|---|
| H01 | 完整基线 / 原理图审查 | 旧交接正文、旧原理图/网表、BOM 纳入版本库；本 REV.A 网表逐网络比对记录；逐页审查签字 | 本仓库已产出 REV.A 网表（225 器件/732 引脚/172 网络）与连接表；旧基线缺失 | 硬件设计与复核 |
| H02 | QS30-1 实物管脚与工作点 | 商标/批次照片；逐脚限流点亮记录（2=A、3..13=K0,K9..K1、1/8 不接）；U_tube、I、起辉/熄灭电压；观察面记录 | 原厂图映射已 VERIFIED；实物未测 | 硬件测试 |
| H03 | J13-1A 管座与 PCB 封装 | 厂家机械图或实测：13 触点→焊脚通断表、各焊脚 XY/脚径/公差、1 脚定位缺口、观察面标注、1:1 打印比对、试插证据 | **封装未定义**：已产出参数化草案（全部 TBD、脚本校验无猜测数值）+ 1:1 校对页 + H03 实测工作表；仍缺实测数据与采购件型号。GB 787-74 正文未取得 | 结构与 PCB |
| H04 | 驱动器与电平转换 | HV5622 型号/封装锁定（PQFP-44）；CD40109B 时序实测；96→64 bit 链路 walking-one 位序表；极性真值表；失电回灌与上电状态实测 | 引脚/真值表 VERIFIED；位序与时序未测 | 硬件 + 固件 |
| H05 | 输入、3.3 V 与 USB 供电 | 12 V 输入范围/浪涌/PPTC 实测；TPS54202/SY8089A 选型与热/纹波/瞬态；Wi-Fi TX 峰值与压降；USB-only 电流 ≤500 mA；电源切换四状态 | 预算与候选件已定；全部未实测 | 电源设计 |
| H06 | 高压电源与每管限流 | 实物工作点（H02）确认；仿真→实物：启动过冲、空载/单管/六管、输入变化、负载突变、短路；OVP 阈值容差与锁存/复位；断电泄放曲线与等待时间；阳极电阻温升；浪涌电流；**开关损耗/Coss（SPICE 提示 100 pF 时效率 91%）**；**环路相位裕度（R72/C56 最终取值，见 loop_scan.md）**；**OVP 复位最小脉宽/锁存保持（见 ovp_timing.md）**；**U21/U22 温升与 VDD 电流、PPTC 启动波形（见 thermal_review.md）** | 行为模型 S1–S10 + 功率级 SPICE + 平均模型闭环（8/8）+ OVP 保护逻辑 SPICE（7/7）+ 环路扫描（26/27 稳定） | 电源 + 硬件测试 |
| H07 | 高压布局与结构绝缘 | 最大工作电压/瞬态前提；材料/污染等级/适用标准；间隙与爬电距离定稿并写入 EDA 规则；管座耐压；可触及区域审查 | 预布局分区草案；规则为 1.0 mm 占位；**网表级 DRC 预检 10/10 PASS（隔离/端点/覆盖）** | PCB + 结构 |
| H08 | 天线与整机 RF | 最终外壳与天线位置；禁布区检查；升压关闭/带载/六管切换三状态下的 Wi-Fi 吞吐、重连、距离；装壳复测 | 天线禁布与模组摆放草案 | PCB + 固件测试 |
| H09 | EDA 规则与系统验收 | 符号脚号↔封装焊盘↔实物触点一致性签字；立创EDA 原生 ERC/DRC 报告与逐条解释；BOM 可制造性；复位/下载/失效状态；温升与长时显示记录 | 网表级自动检查 17 项通过；原生 ERC/DRC 未执行 | 联合复核 |

## 放行判据（闸门）

1. **不得投板**：H01、H02、H03、H04、H05、H06、H07 任一未关闭 → 不允许生成/释放 Gerber。
2. **不得生产**：H08、H09 未关闭或不通过 → 不做小批量。
3. **不得标注 production-ready**：全部关闭且整机按 `docs/test_plan.md` 阶段 E 通过。
4. 任何"相似料号替代/近似尺寸/参考其他板"的做法都必须先回到本表新增 HOLD 项，不得口头放行。
