langxie29-cpu/QS30-driver/docs/doc_consistency.md

# 文档关键数字一致性检查

由 `design/doc_number_check.py` 自动生成；**5/5 项通过**。

| 编号 | 结果 | 内容 |
|---|---|---|
| C1 | PASS | README 与 design_decisions 均包含关键数字 |
| C2 | PASS | 当前状态文档无废弃旧值 |
| C3 | PASS | 平均模型判据数量为 8/8 |
| C4 | PASS | 审查包实际 29 页，CHANGELOG 最后记录 29 页 |
| C5 | PASS | 机器结果一致（design_summary/spice/drc/test_plan） |

## 当前关键数字（单一事实来源：机器可读结果）

| 项目 | 值 |
|---|---|
| HV_BUS 稳态 | 172.18 V（误差 3 mV） |
| OVP 阈值 / 首次触发 | 198.8 V / 198.92 V |
| 功率级 SPICE 输出/效率 | 171.99 V / 95.9% |
| 平均模型闭环判据 | 8/8 |
| OVP 保护逻辑判据 | 7/7 |
| 器件/引脚/网络/通道 | 227 / 736 / 172 / 60 |
| ERC / DRC 预检 | 0/0 错误告警 / 14/14 |
| 测试计划一致性 | 5/5 |
| 审查包 | 29 页 |
