langxie29-cpu/QS30-driver/docs/hold_dashboard.md

# HOLD 进度看板（证据填写 + 关键路径）

- 证据提交：**0/7**；判据通过：**0/7**
- 说明：DASH 由 `design/hold_dashboard.py` 从 `docs/evidence/` 自动统计；自动校验不替代 `HOLD_REGISTER.md` 的人工签署。

| HOLD | 模板填写进度 | 自动校验状态 | 关键路径 / 下一步 |
|---|---|---|---|
| H02 | `----------` 0% (0/198) | 未提交 | 阻塞 H06 工作点与固件映射；先买 2–3 只 QS30-1 做单管夹具 |
| H03 | `----------` 0% (0/81) | 未提交 | **唯一阻塞 PCB 封装的机械项**；购样 13 脚管座后实测 |
| H04 | `----------` 0% (0/192) | 未提交 | 阻塞固件通道 LUT；需要焊好的驱动板 + 低压测试负载 |
| H05 | `----------` 0% (0/11) | 未提交 | 低压电源/ USB 供电实测；可与 H06 部分并行 |
| H06 | `----------` 0% (0/14) | 未提交 | 高压工作点/OVP/泄放/浪涌/温升；需隔离测试区与差分探头 |
| H07 | `----------` 0% (0/10) | 未提交 | 高压间距与爬电标准定稿；与 H03 封装尺寸联动 |
| H08 | `----------` 0% (0/16) | 未提交 | 整机 RF；需外壳与整机装配 |

## 关键路径（按阻塞影响排序）

1. **H03 管座实测** → 冻结 PCB 封装（唯一机械阻塞项）→ 才能投板；
2. **H02 单管工作点** → 确认 Ea/Ra/电流 → H06 高压额定值；
3. **H06 高压实测** → OVP/泄放/浪涌/温升 → 安全放行依据；
4. **H04 walking-one** → 冻结固件通道 LUT；
5. **H05 低压实测** → 3.3 V/USB 供电验收；
6. **H07 间距标准** → 写入 EDA 规则（与 H03 联动）；
7. **H08 整机 RF** → 装壳后验收（最后一项）。

## 当前可并行推进的软件侧工作

- 立创EDA 工程按 `docs/lceda_implementation_guide.md` 重建（H01/H09）；
- 固件通道映射以 `docs/channel_mapping.csv` 为输入，位序待 H04 回填；
- 高压/低压测试按 `docs/test_plan.md` 阶段 A–E 执行并回填证据模板。
