langxie29-cpu/QS30-driver/docs/loop_scan.md

# 环路参数敏感性扫描（平均模型）

- 扫描：CINT ∈ [10.0, 22.0, 47.0] µF × Ki ∈ [65.0, 130.0, 260.0]e-6 × Kp ∈ [0.0, 0.05, 0.15] = **27 组**；步长 20 µs，450 ms
- 场景：初值=工作点，150 ms 时输入 12→11.4 V（负载不变）；指标=电压下探、恢复(±1%)、稳态误差、末段峰峰值（振荡指示）

## 参考点与推荐

- **BOM 参数（参考）**：CINT 22 µF / Ki 1.3e-4 / Kp 0.05 → 下探 4.10 V，恢复 **9 ms**，稳态误差 3.3 mV
- **扫描最优**：CINT 10 µF / Ki 2.60e-04 / Kp 0.15 → 下探 2.12 V，恢复 **2 ms**，末段峰峰 0.0 mV
- 稳定性：**26/27** 组无振荡（末段峰峰 <50 mV）；有振荡/失败 1 组

## 全部结果（按恢复时间排序）

| CINT (µF) | Ki | Kp | 稳态 (V) | 误差 (mV) | 下探 (V) | 恢复 (ms) | 末段峰峰 (mV) | 稳定 |
|---|---|---|---|---|---|---|---|---|
| 10 | 2.60e-04 | 0.15 | 172.18 | 3.3 | 2.12 | 2 | 0.0 | 是 ★推荐 |
| 10 | 1.30e-04 | 0.15 | 172.18 | 3.3 | 2.15 | 2 | 0.0 | 是 |
| 22 | 2.60e-04 | 0.15 | 172.18 | 3.3 | 2.16 | 2 | 0.0 | 是 |
| 10 | 6.50e-05 | 0.15 | 172.18 | 3.2 | 2.17 | 2 | 0.2 | 是 |
| 22 | 6.50e-05 | 0.15 | 172.17 | 14.3 | 2.18 | 2 | 19.9 | 是 |
| 22 | 1.30e-04 | 0.15 | 172.18 | 3.0 | 2.17 | 2 | 0.5 | 是 |
| 47 | 2.60e-04 | 0.15 | 172.18 | 2.9 | 2.17 | 2 | 0.9 | 是 |
| 47 | 6.50e-05 | 0.15 | 172.00 | 176.8 | 2.18 | 2 | 95.0 | 否 |
| 47 | 1.30e-04 | 0.15 | 172.16 | 20.0 | 2.18 | 2 | 24.6 | 是 |
| 10 | 2.60e-04 | 0.05 | 172.18 | 3.3 | 3.77 | 3 | 0.0 | 是 |
| 10 | 1.30e-04 | 0.05 | 172.18 | 3.3 | 3.97 | 3 | 0.0 | 是 |
| 22 | 2.60e-04 | 0.05 | 172.18 | 3.3 | 3.99 | 4 | 0.0 | 是 |
| 10 | 6.50e-05 | 0.00 | 172.18 | 3.3 | 8.13 | 7 | 0.0 | 是 |
| 22 | 1.30e-04 | 0.00 | 172.18 | 3.3 | 8.22 | 8 | 0.0 | 是 |
| 10 | 6.50e-05 | 0.05 | 172.18 | 3.3 | 4.09 | 8 | 0.0 | 是 |
| 22 | 2.60e-04 | 0.00 | 172.18 | 3.3 | 7.49 | 8 | 0.0 | 是 |
| 47 | 2.60e-04 | 0.00 | 172.18 | 3.3 | 8.28 | 8 | 0.0 | 是 |
| 10 | 1.30e-04 | 0.00 | 172.18 | 3.3 | 7.37 | 8 | 0.0 | 是 |
| 22 | 1.30e-04 | 0.05 | 172.18 | 3.3 | 4.10 | 9 | 0.0 | 是 ←BOM |
| 47 | 2.60e-04 | 0.05 | 172.18 | 3.3 | 4.11 | 10 | 0.0 | 是 |
| 22 | 6.50e-05 | 0.00 | 172.18 | 3.3 | 8.74 | 16 | 0.0 | 是 |
| 47 | 1.30e-04 | 0.00 | 172.18 | 3.3 | 8.78 | 17 | 0.0 | 是 |
| 22 | 6.50e-05 | 0.05 | 172.18 | 3.1 | 4.16 | 17 | 0.4 | 是 |
| 47 | 1.30e-04 | 0.05 | 172.18 | 3.0 | 4.16 | 19 | 0.6 | 是 |
| 10 | 2.60e-04 | 0.00 | 172.18 | 3.3 | 6.43 | 21 | 0.0 | 是 |
| 47 | 6.50e-05 | 0.00 | 172.18 | 3.2 | 9.10 | 34 | 0.0 | 是 |
| 47 | 6.50e-05 | 0.05 | 172.15 | 25.6 | 4.19 | 36 | 35.3 | 是 |

## 工程解读与边界

1. **现有参数稳定**：BOM 参考点（CINT 22 µF）输入阶跃下探 4.10 V、恢复 9 ms；静态显示时每管恒有 1 路阴极导通、负载变化很小，故该响应可接受。
2. **加快环路的代价**：减小 CINT 或增大 Ki 会缩短恢复时间，但需关注输入阶跃下探与末段振荡；扫描给出稳定边界，供 H06 调整 R72/C56 时参考。
3. **不等同于 UC3843 补偿设计**：本模型是 PI 等效（电压模式平均模型），真实 UC3843 为电流模式 + Type-II 补偿（R72 10 k / C56 0.1 µF / C55 22 µF 软启动）；R72/C56 的最终取值必须由 H06 实测相位裕度确定，本扫描只提供趋势与稳定性边界。
4. 本扫描不含开关纹波/器件应力（见 `spice_validation.md` 第 2 节）与 OVP 逻辑（见 §3.5）。
