langxie29-cpu/QS30-driver/docs/thermal_review.md

# 热与浪涌复核（HV5622 功耗 / PPTC 启动浪涌）

> 本复核的器件参数（HV5622 静态电流、Von、PQFP-44 Rth_ja、PPTC I²t）**尚未从手册核实**，全部用参数区间表达；结论只作 H06 实测的预期范围，不是验证数据。

## 1. HV5622 驱动 IC 功耗与温升估算

- 静态驱动：每管恒有 1 路阴极导通 → 每片 HV5622 同时导通 **3** 路；
- 单通道电流 **2.36 mA**（H02 期望 1.5–3 mA 中点），DRV_VDD = 11.45 V；

| 假设 VDD 静态电流 | 假设 Von | 导通损耗 | 静态损耗 | 合计 | 温升 @Rth=40/60/80 °C/W |
|---|---|---|---|---|---|
| 1 mA | 1.0 V | 7.1 mW | 11 mW | **19 mW** | 0.7 / 1.1 / 1.5 °C |
| 1 mA | 2.0 V | 14.2 mW | 11 mW | **26 mW** | 1.0 / 1.5 / 2.0 °C |
| 1 mA | 3.0 V | 21.2 mW | 11 mW | **33 mW** | 1.3 / 2.0 / 2.6 °C |
| 3 mA | 1.0 V | 7.1 mW | 34 mW | **41 mW** | 1.7 / 2.5 / 3.3 °C |
| 3 mA | 2.0 V | 14.2 mW | 34 mW | **49 mW** | 1.9 / 2.9 / 3.9 °C |
| 3 mA | 3.0 V | 21.2 mW | 34 mW | **56 mW** | 2.2 / 3.3 / 4.4 °C |
| 5 mA | 1.0 V | 7.1 mW | 57 mW | **64 mW** | 2.6 / 3.9 / 5.1 °C |
| 5 mA | 2.0 V | 14.2 mW | 57 mW | **71 mW** | 2.9 / 4.3 / 5.7 °C |
| 5 mA | 3.0 V | 21.2 mW | 57 mW | **78 mW** | 3.1 / 4.7 / 6.3 °C |

- 估算温升范围 **0.7–6.3 °C**（环境 25 °C → 结温约 26–31 °C），**远低于常规 125 °C 结温上限**；
- 结论：HV5622 热风险低（60 路并非同时导通，静态驱动只有 6 路同时导通）；但仍需 H06 实测 U21/U22 表面温升与 VDD 电流，确认手册参数。

## 2. PPTC 与启动浪涌（来自行为模型 S1 波形）

- 启动电感电流峰值 **3.12 A**（5.1 ms）；
- 启动 60 ms 内 ∫i²dt ≈ **0.0010 A²·s**；超 1.5 A 持续时间 ≈ **0.1 ms**；
- 判据（工程经验量级，待手册确认）：I²t < 0.1 A²·s（典型 1812 PPTC 下限），超保持电流时间 < 50 ms → **通过（预期不误动作）**

| 项 | 结果 | 判据 | 结论 |
|---|---|---|---|
| 峰值电流 | 3.12 A | PPTC 1.5 A 保持（短时可超） | 需实测波形 |
| I²t | 0.0010 A²·s | <0.1（典型 1812 PPTC 下限） | PASS |
| 超 1.5 A 时间 | 0.1 ms | <50 ms | PASS |

## 3. 待关闭项

- **PPTC 手册 I²t / 触发时间曲线**未核实 → 新增 open_issues I-25；H05/H06 实测必须记录启动波形；
- HV5622 手册的 VDD 静态电流、Von、PQFP-44 热阻未核实 → 实测 U21/U22 温升与 VDD 电流；
- 本复核不改变任何 BOM 选型；若实测温升或 PPTC 误动作，按 D-29/CHANGELOG 流程变更。
