langxie29-cpu/QS30-driver/docs/footprint/H03_管座实测工作表.md

# H03 管座实测工作表（QS30-6 REV.A）

用途：关闭 `HOLD_REGISTER.md` 的 **H03（J13-1A 管座与 PCB 封装）**。
配套：`docs/footprint/QS30-1_管座_1比1校对页.pdf`（1:1 打印图）、
`symbols/QS30-1_socket_footprint_draft.json`（待填参数）。

**未完成本表前：不得生成 PCB 封装、不得投板。不得用"13 脚""外观相似"推断兼容。**

## 0. 已知（原厂资料，非本表内容）

| 项 | 值 | 来源 |
|---|---|---|
| 管子玻壳最大直径 | φ30.2 mm | S6 原厂外形图 |
| 管子总高 / 本体高 | 34±1.5 / 26±0.5 mm | S6 |
| 管子引脚 | 13 × φ1.3 mm | S6 |
| 管基标准 | GB 787-74 J13-1A | S6 参数表 |
| 电极映射 | 2=A；3=K0、4=K9、5=K8、6=K7、7=K6、9=K5、10=K4、11=K3、12=K2、13=K1；1/8 悬空 | S6 电极接线图 |

## 1. 采购件信息

| 项 | 填写 |
|---|---|
| 管座完整型号 | |
| 生产厂 / 供应商 | |
| 数据手册或机械图版本（附文件） | |
| 采购批次 | |
| 数量 | |

## 2. 机械实测（每项记录 3 个样本，单位 mm，精度 0.05）

| 编号 | 测量项 | 样本1 | 样本2 | 样本3 | 备注 |
|---|---|---|---|---|---|
| M1 | 节圆直径（13 焊脚所在圆） | | | | 非等分时改为逐个极坐标 |
| M2 | 相邻焊脚中心距（实测 3 处） | | | | |
| M3 | 焊脚直径/宽度 | | | | |
| M4 | 焊脚长度（座底面以下） | | | | |
| M5 | 座体最大外径 | | | | |
| M6 | 座高（PCB 面到插管面） | | | | |
| M7 | 安装孔位置（相对 1 脚）/ 孔径 | | | | |
| M8 | 外形轮廓（方/圆、倒角、缺口） | | | | |
| M9 | 定位缺口或 1 脚特征（照片+描述） | | | | |
| M10 | 插拔行程 / 插拔力（N） | | | | |

## 3. 观察面与方向（必须四项分别标注）

| 视图 | 说明 | 1 脚位置（画/写） |
|---|---|---|
| 管子管底视图（引脚面向观察者） | | |
| 管座插入口顶视图（插管方向看） | | |
| 管座焊脚底视图（焊接面看） | | |
| PCB 顶层封装图（EDA 中） | | |

> 翻转观察会镜像；**不得**沿用屏幕上的顺/逆时针编号。用定位缺口或唯一的不对称脚位配准。

## 4. 触点→焊脚通断表（万用表通断档，仅证明机械/管座连通，不证明管内电极）

| 触点号 | 焊脚号 | 通断 | 是否交叉引出 |
|---|---|---|---|
| 1 | | | |
| 2 | | | |
| … | | | |
| 13 | | | |

管脚实际电气映射仍以 **S6 原厂电极图** 为准（H02 用单管夹具另行验证辉光映射）。

## 5. 1:1 校验

1. 用 `QS30-1_管座_1比1校对页.pdf` 按"实际大小/100%"打印；先量标尺应为 100.0 mm。
2. 把管座放在 φ30.2 圆与灰色 13 等分环上：记录焊脚相对参考环的偏差（角度/径向）。
3. 叠图拍照（管座、打印页、直尺同框）。
4. 依据测量结果填写 `symbols/QS30-1_socket_footprint_draft.json` 的 `tbd_from_h03` 全部字段，
   再生成封装 v2；**不得**在未填写时导出 Gerber。

## 6. H03 关闭判据

- [ ] 采购件型号与机械图/实测一致
- [ ] M1–M10 全部有记录
- [ ] 四种视图各有 1 脚标注
- [ ] 13 触点→焊脚通断表完成
- [ ] 1:1 叠图照片归档
- [ ] 封装草案 TBD 字段全部填齐并升版本（v2），符号-焊盘-实物三方一致签字
