langxie29-cpu/QS30-driver/docs/hold_closure_report.md

# HOLD 关闭证据自动校验报告

- 已提交 HOLD：0/7；通过：0
- 生成时间：由 `design/evidence_check.py` 运行

> 自动校验只检查数据是否齐全、是否落在设计判据内；HOLD 正式关闭仍需 `HOLD_REGISTER.md` 的人工签署。

| HOLD | 状态 | 说明 |
|---|---|---|
| H02 | 未提交 | 逐脚 0/156，工作点 0/42 |
| H03 | 未提交 | 测量 0/30，视图 0/12，通断 0/26 |
| H04 | 未提交 | 0/128 |
| H05 | 未提交 | 0/11 |
| H06 | 未提交 | 0/14 |
| H07 | 未提交 | 0/10 |
| H08 | 未提交 | 0/16 |

## 用法

1. 打开 `docs/evidence/` 下对应 CSV，把 `FILL` 替换为实测值；
2. `python design/evidence_check.py`；
3. 通过后在 `HOLD_REGISTER.md` 记录签署人/日期/版本（自动校验不代替签审）。
