langxie29-cpu/QS30-driver/docs/drc_precheck.md

# QS30-6 REV.A 网表级 DRC 预检

由 `design/drc_precheck.py` 从设计数据库自动生成；**14/14 项通过**。

> 说明：这不是立创EDA 原生 DRC。布线/间距/孔径/天线禁布等必须在 EDA 中执行（H09）；本文件只做**能机器验证的网表级隔离与端点检查**，为 H07（高压间距）与 H09（EDA 规则）提供输入。

| 编号 | 结果 | 内容 |
|---|---|---|
| D1 | PASS | HV 网络 88 个，端点全部在高压允许清单 |
| D2 | PASS | 3.3 V 器件未直接连接 HV/DRV 网络 |
| D3 | PASS | 12 V 域器件未连接到 3V3 网络 |
| D4 | PASS | 60 路阴极网络均为 (HV5622 输出, 管座脚) 两端点 |
| D5 | PASS | 6 路阳极网络均为 (限流电阻, 管座脚) 两端点 |
| D6 | PASS | HV_BUS 端点 17 个：C49.2, C50.1, C51.1, C52.1, D20.1, R100.1, R27.1, R66.2, R67.1, R69.1, R75.1, R90.1, R92.1, R94.1, R96.1, R98.1, TP6.1 |
| D7 | PASS | HV 网络测试点 ['TP19.1', 'TP6.1']（白名单 ['TP19', 'TP6']，须在丝印标注高压） |
| D8 | PASS | HV 网络已分配网络类别（间距规则 1.0 mm 占位，H07 定稿前不得投板） |
| D9 | PASS | 02_MCU 页 HV 器件检查：注意 ['R27(02_MCU)', 'R28(02_MCU)', 'R29(02_MCU)', 'R30(02_MCU)']（高压分压电阻画在 MCU 页，PCB 必须布置在高压区，见预布局 Z4） |
| D10 | PASS | HV 网络与 3V3 网络无共享器件（除电阻分压/限流，白名单已覆盖） |
| D11 | PASS | 封装草案：status=PROVISIONAL, pad_count=13, 脚号 1:1=通过, 猜测尺寸=无 |
| D12 | PASS | 映射表 334 行，符号脚号=封装焊盘 1:1 |
| D13 | PASS | BOM 227 行：重复位号 无，缺封装 无，HOLD 位号 6 个（不得进入可下单 BOM） |
| D14 | PASS | 证据模板 10 个；自动校验状态：已提交 0/7，通过 0/7 |

## HV 网络清单（端点）

| 网络 | 类别 | 端点数 | 端点 |
|---|---|---|---|
| A_MID1 | HV | 2 | R90.2, R91.1 |
| A_MID2 | HV | 2 | R92.2, R93.1 |
| A_MID3 | HV | 2 | R94.2, R95.1 |
| A_MID4 | HV | 2 | R96.2, R97.1 |
| A_MID5 | HV | 2 | R98.2, R99.1 |
| A_MID6 | HV | 2 | R100.2, R101.1 |
| A_T1 | HV | 2 | J31.2, R91.2 |
| A_T2 | HV | 2 | J32.2, R93.2 |
| A_T3 | HV | 2 | J33.2, R95.2 |
| A_T4 | HV | 2 | J34.2, R97.2 |
| A_T5 | HV | 2 | J35.2, R99.2 |
| A_T6 | HV | 2 | J36.2, R101.2 |
| BLEED_MID | HV | 3 | R67.2, R68.1, C53.1 |
| CLAMP_N | HV | 3 | D21.1, C49.1, R66.1 |
| COMP_N | HV | 4 | U20.1, C55.1, R72.1, Q23.3 |
| CS_N | HV | 3 | R62.1, R63.1, Q20.3 |
| FB_HV | HV | 4 | U20.2, R70.2, R71.1, C54.1 |
| FB_MID | HV | 2 | R69.2, R70.1 |
| HVS_MID | HV | 2 | R27.2, R28.1 |
| HVS_NODE | HV | 3 | R28.2, R29.1, R30.1 |
| HV_BUS | HV | 17 | R27.1, R90.1, R92.1, R94.1, R96.1, R98.1, R100.1, D20.1, C49.2, R66.2, C50.1, C51.1, C52.1, R67.1, R69.1, R75.1, TP6.1 |
| K_T1_0 | HV | 2 | J31.3, U21.22 |
| K_T1_1 | HV | 2 | J31.13, U21.21 |
| K_T1_2 | HV | 2 | J31.12, U21.20 |
| K_T1_3 | HV | 2 | J31.11, U21.19 |
| K_T1_4 | HV | 2 | J31.10, U21.18 |
| K_T1_5 | HV | 2 | J31.9, U21.17 |
| K_T1_6 | HV | 2 | J31.7, U21.16 |
| K_T1_7 | HV | 2 | J31.6, U21.15 |
| K_T1_8 | HV | 2 | J31.5, U21.14 |
| K_T1_9 | HV | 2 | J31.4, U21.13 |
| K_T2_0 | HV | 2 | J32.3, U21.12 |
| K_T2_1 | HV | 2 | J32.13, U21.11 |
| K_T2_2 | HV | 2 | J32.12, U21.10 |
| K_T2_3 | HV | 2 | J32.11, U21.9 |
| K_T2_4 | HV | 2 | J32.10, U21.8 |
| K_T2_5 | HV | 2 | J32.9, U21.7 |
| K_T2_6 | HV | 2 | J32.7, U21.6 |
| K_T2_7 | HV | 2 | J32.6, U21.5 |
| K_T2_8 | HV | 2 | J32.5, U21.4 |
| K_T2_9 | HV | 2 | J32.4, U21.3 |
| K_T3_0 | HV | 2 | J33.3, U21.2 |
| K_T3_1 | HV | 2 | J33.13, U21.1 |
| K_T3_2 | HV | 2 | J33.12, U21.44 |
| K_T3_3 | HV | 2 | J33.11, U21.43 |
| K_T3_4 | HV | 2 | J33.10, U21.42 |
| K_T3_5 | HV | 2 | J33.9, U21.41 |
| K_T3_6 | HV | 2 | J33.7, U21.40 |
| K_T3_7 | HV | 2 | J33.6, U21.39 |
| K_T3_8 | HV | 2 | J33.5, U21.38 |
| K_T3_9 | HV | 2 | J33.4, U21.37 |
| K_T4_0 | HV | 2 | J34.3, U21.36 |
| K_T4_1 | HV | 2 | J34.13, U21.35 |
| K_T4_2 | HV | 2 | J34.12, U22.22 |
| K_T4_3 | HV | 2 | J34.11, U22.21 |
| K_T4_4 | HV | 2 | J34.10, U22.20 |
| K_T4_5 | HV | 2 | J34.9, U22.19 |
| K_T4_6 | HV | 2 | J34.7, U22.18 |
| K_T4_7 | HV | 2 | J34.6, U22.17 |
| K_T4_8 | HV | 2 | J34.5, U22.16 |
| K_T4_9 | HV | 2 | J34.4, U22.15 |
| K_T5_0 | HV | 2 | J35.3, U22.14 |
| K_T5_1 | HV | 2 | J35.13, U22.13 |
| K_T5_2 | HV | 2 | J35.12, U22.12 |
| K_T5_3 | HV | 2 | J35.11, U22.11 |
| K_T5_4 | HV | 2 | J35.10, U22.10 |
| K_T5_5 | HV | 2 | J35.9, U22.9 |
| K_T5_6 | HV | 2 | J35.7, U22.8 |
| K_T5_7 | HV | 2 | J35.6, U22.7 |
| K_T5_8 | HV | 2 | J35.5, U22.6 |
| K_T5_9 | HV | 2 | J35.4, U22.5 |
| K_T6_0 | HV | 2 | J36.3, U22.4 |
| K_T6_1 | HV | 2 | J36.13, U22.3 |
| K_T6_2 | HV | 2 | J36.12, U22.2 |
| K_T6_3 | HV | 2 | J36.11, U22.1 |
| K_T6_4 | HV | 2 | J36.10, U22.44 |
| K_T6_5 | HV | 2 | J36.9, U22.43 |
| K_T6_6 | HV | 2 | J36.7, U22.42 |
| K_T6_7 | HV | 2 | J36.6, U22.41 |
| K_T6_8 | HV | 2 | J36.5, U22.40 |
| K_T6_9 | HV | 2 | J36.4, U22.39 |
| LATCH_B | HV | 4 | Q21.1, Q22.3, R79.1, R80.2 |
| OVP_LATCH | HV | 8 | Q21.3, Q22.1, R81.1, C60.1, R82.1, R83.1, Q25.3, TP19.1 |
| OVP_MID | HV | 2 | R75.2, R76.1 |
| OVP_SET | HV | 3 | U23.1, R78.1, R80.1 |
| OVP_SNS | HV | 4 | U23.3, R76.2, R77.1, C58.1 |
| SW_HV | HV | 4 | Q20.2, L20.2, D20.2, D21.2 |
| VREF_OVP | HV | 5 | U23.2, U24.1, U24.2, R74.2, C57.1 |
