langxie29-cpu/QS30-driver/docs/evidence_selftest.md

# 证据校验框架自测（合成数据）

> 本文件由 `design/evidence_selftest.py` 生成。所用数据为**合成数据**，唯一目的是证明校验器能识别「未提交/部分/完整/失败」四种状态，**不代表实物测试结果**。

## 1. 模板原样（未提交）

- 退出码：0（期望 0，无失败项）
- 结论：正确识别为未提交

## 2. 合成数据全部合法

- 退出码：0（期望 0）
- 结论：7 项 HOLD 均判为已提交且通过

## 3. 注入 3 处非法值

- 退出码：2（期望 2）
- 结论：校验器成功捕获（H02/H04/H06 判据失败）

### 校验器输出摘录

```
# HOLD 关闭证据自动校验报告

- 已提交 HOLD：7/7；通过：4
- 生成时间：由 `design/evidence_check.py` 运行

> 自动校验只检查数据是否齐全、是否落在设计判据内；HOLD 正式关闭仍需 `HOLD_REGISTER.md` 的人工签署。

| HOLD | 状态 | 说明 |
|---|---|---|
| H02 | **已提交·判据失败** | J_T1.1 期望 IC_KEEP_OPEN 发光 N，实测 Y |
| H03 | 已提交·判据通过 | — |
| H04 | **已提交·判据失败** | CH0 期望 J_T1/0，实测 J_T2/3; CH13 观测重复 J_T2/3 |
| H05 | 已提交·判据通过 | — |
| H06 | **已提交·判据失败** | C5-OVPtrip 实测 215.0 不在 [197.3, 200.3] |
| H07 | 已提交·判据通过 | — |
| H08 | 已提交·判据通过 | — |

## 用法

1. 打开 `docs/evidence/` 下对应 CSV，把 `FILL` 替换为实测值；
2. `python design/evidence_check.py`；
3. 通过后在 `HOLD_REGISTER.md` 记录签署人/日期/版本（自动校验不代替签审）。
```
