langxie29-cpu/QS30-driver/docs/footprint/QS30-1_管座_1比1校对页.pdf

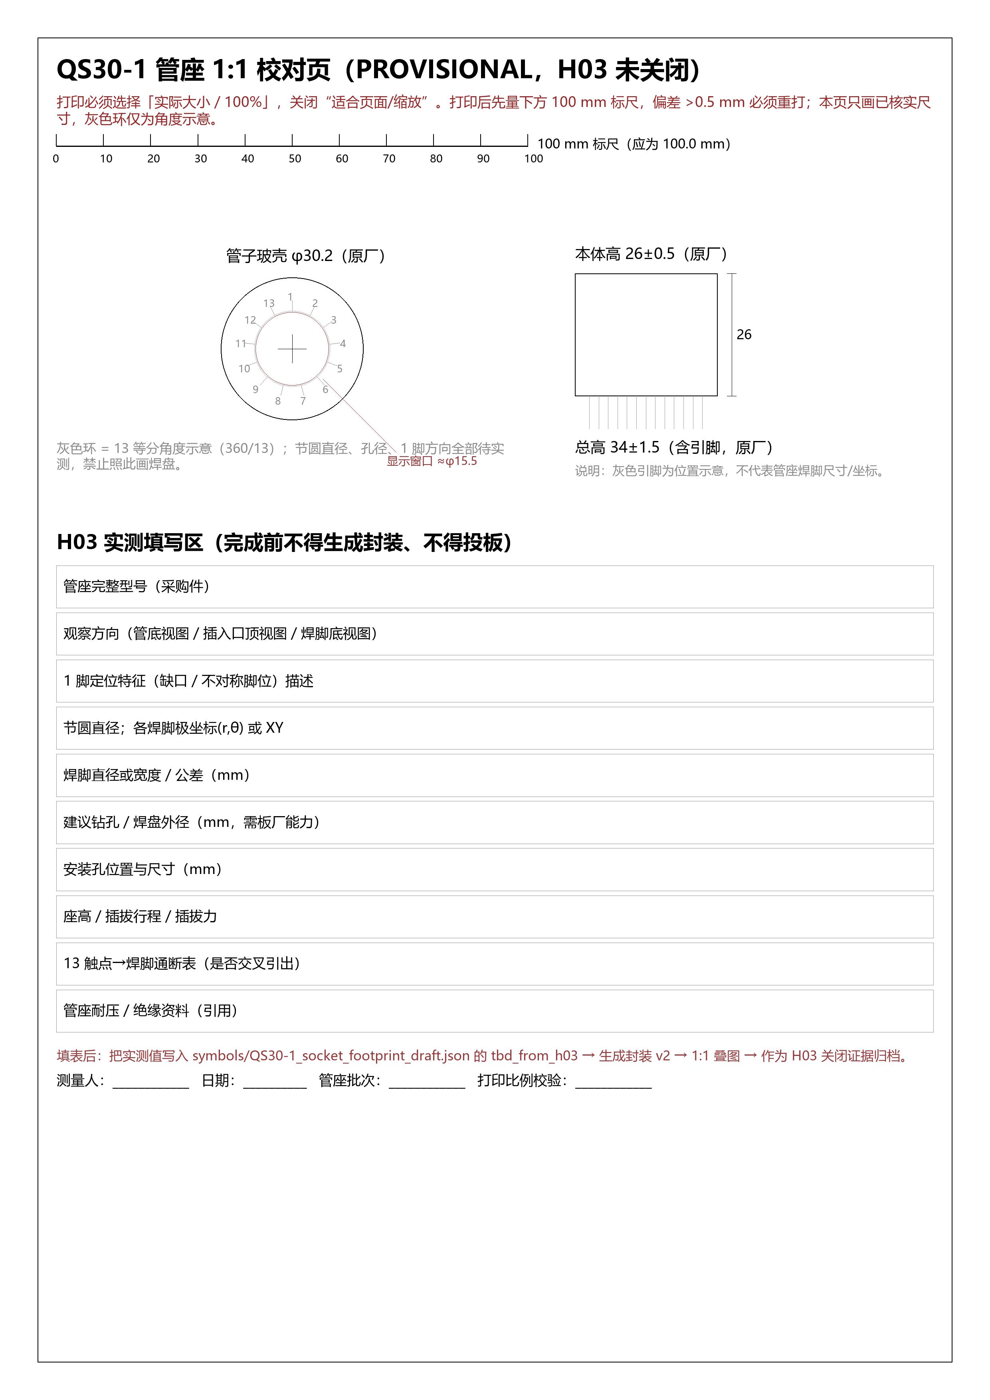
[picture p1: page 1]
