langxie29-cpu/QS30-driver/docs/prelayout/QS30-6_REV.A_prelayout.pdf

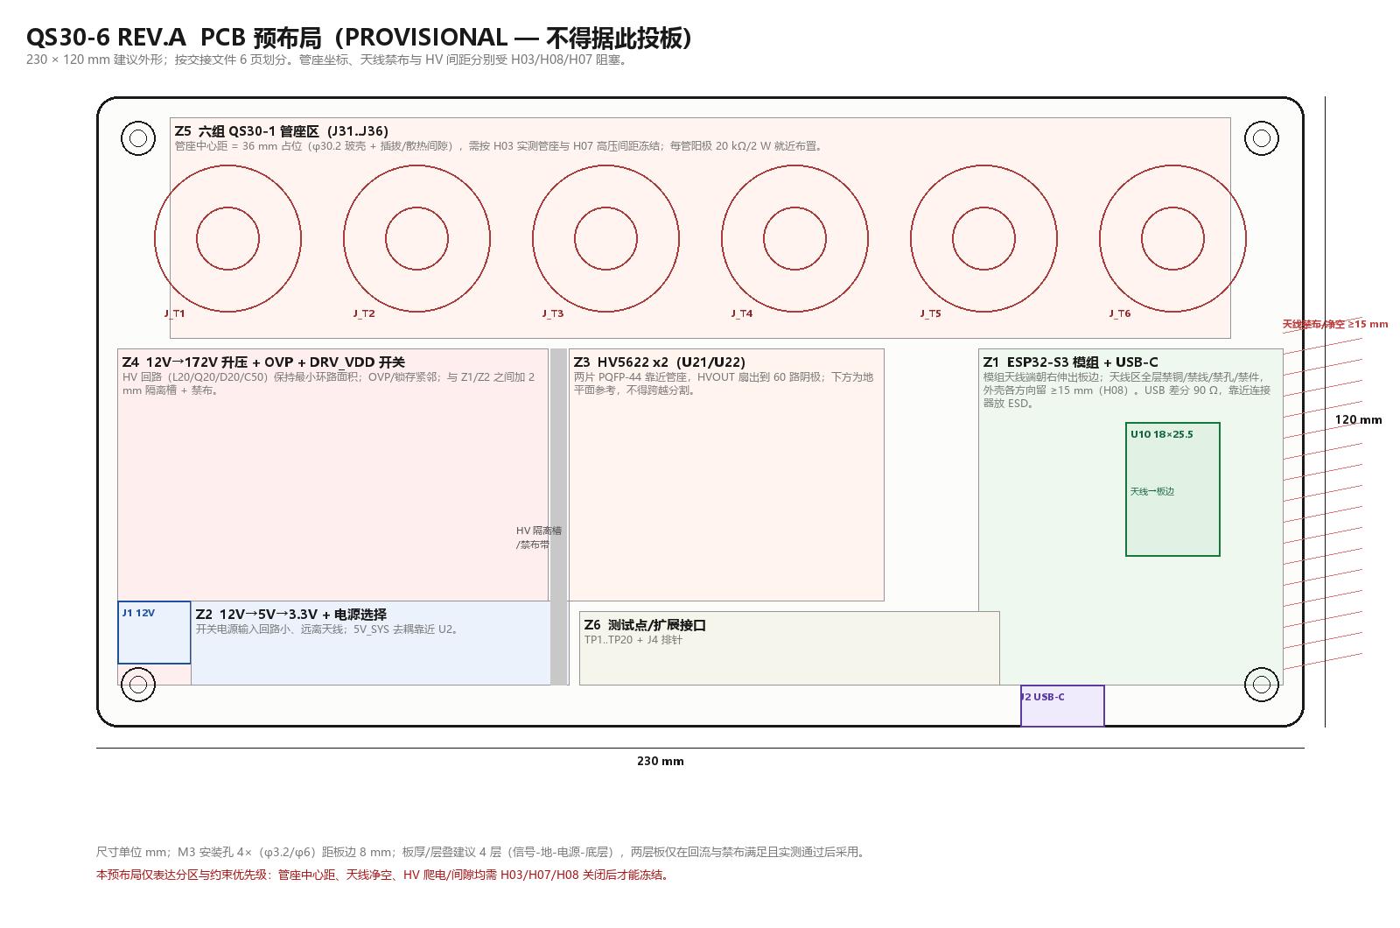
[picture p2: page 1]
