langxie29-cpu/QS30-driver/docs/schematic/page_01.png

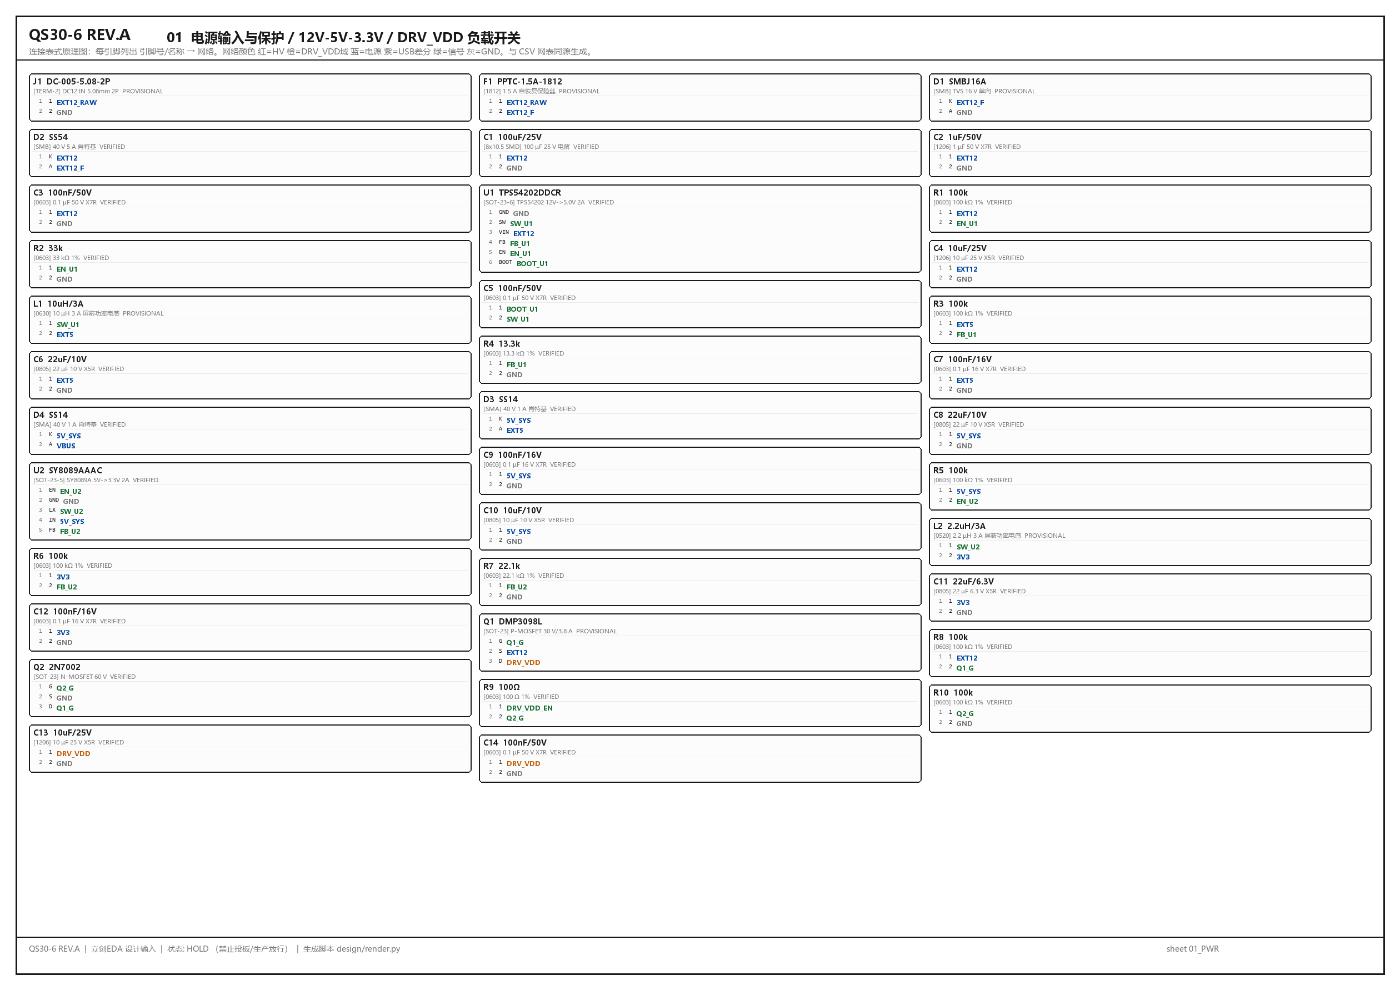
docs/schematic/page_01.png
