langxie29-cpu/QS30-driver/docs/schematic/page_02.png

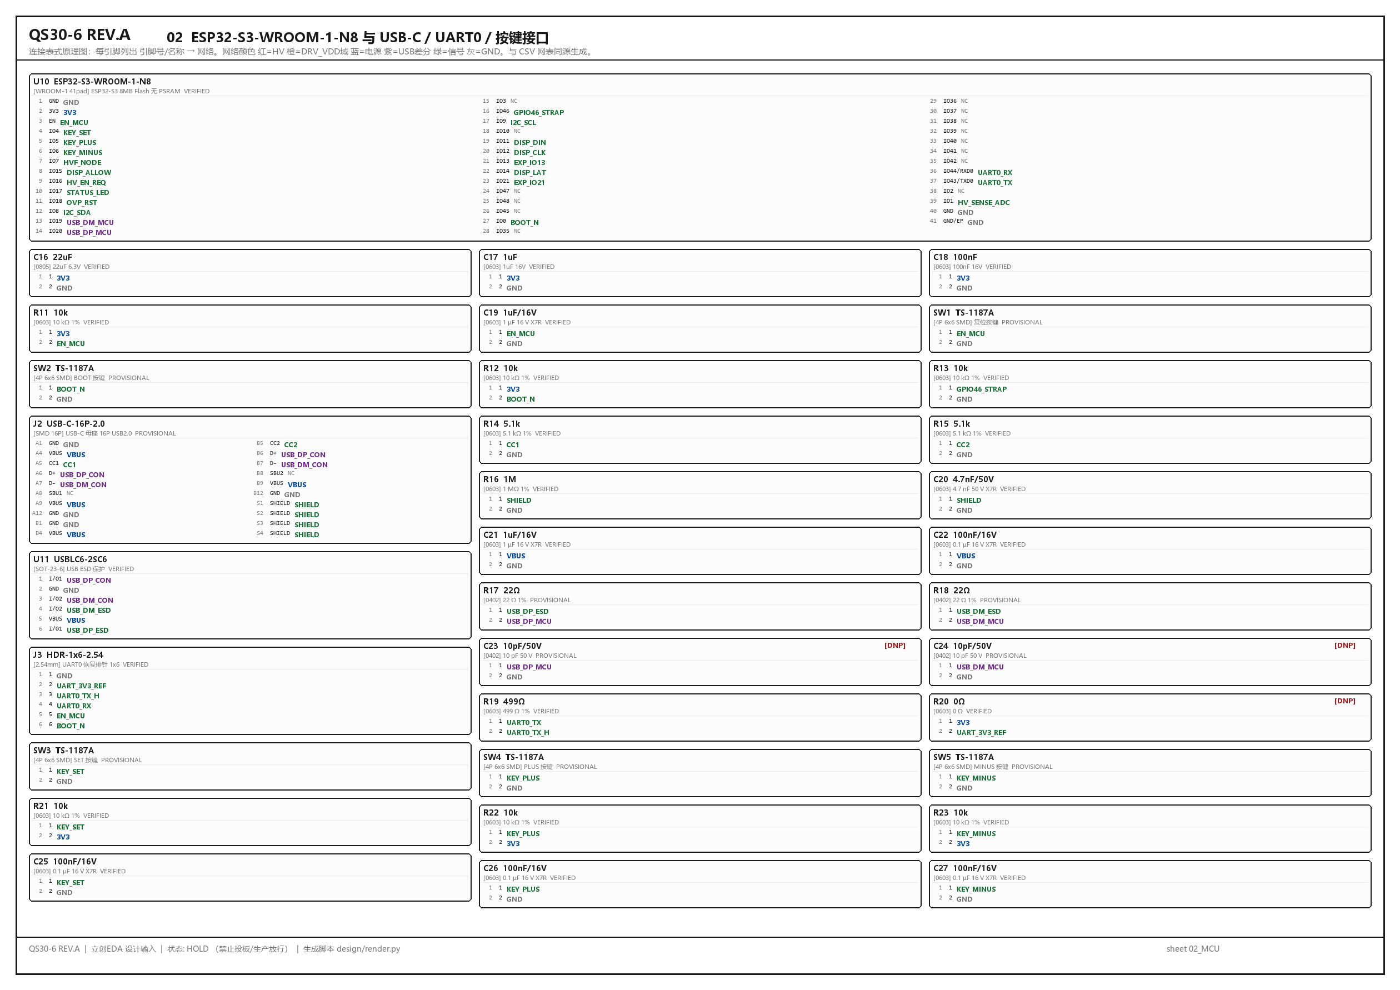
docs/schematic/page_02.png
