langxie29-cpu/QS30-driver/docs/schematic/page_03.png

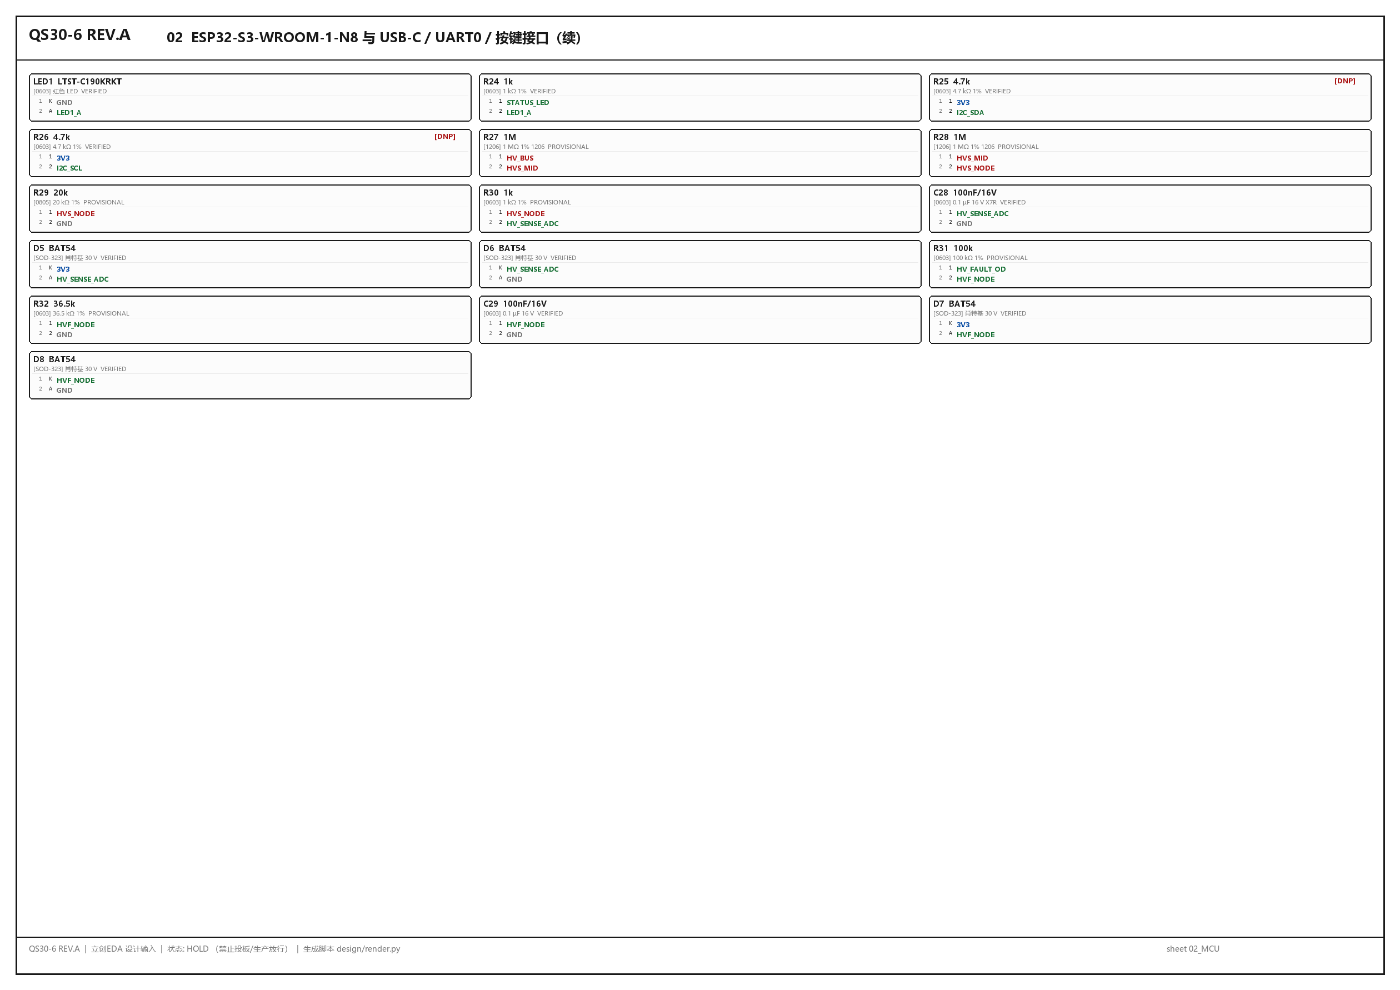
docs/schematic/page_03.png
