langxie29-cpu/QS30-driver/docs/schematic/page_04.png

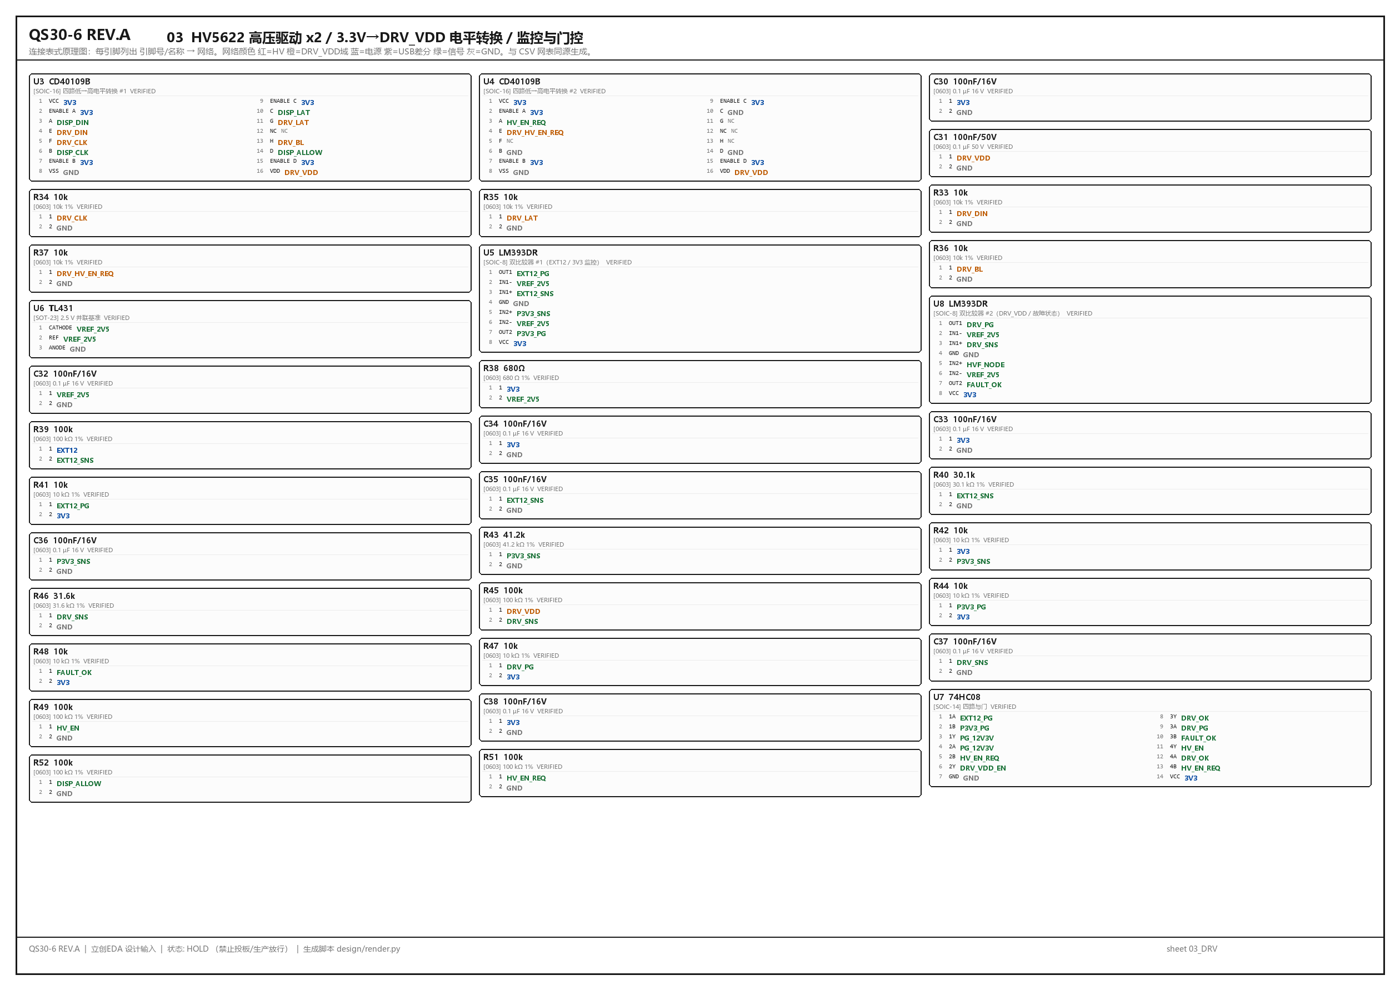
docs/schematic/page_04.png
