langxie29-cpu/QS30-driver/docs/schematic/page_05.png

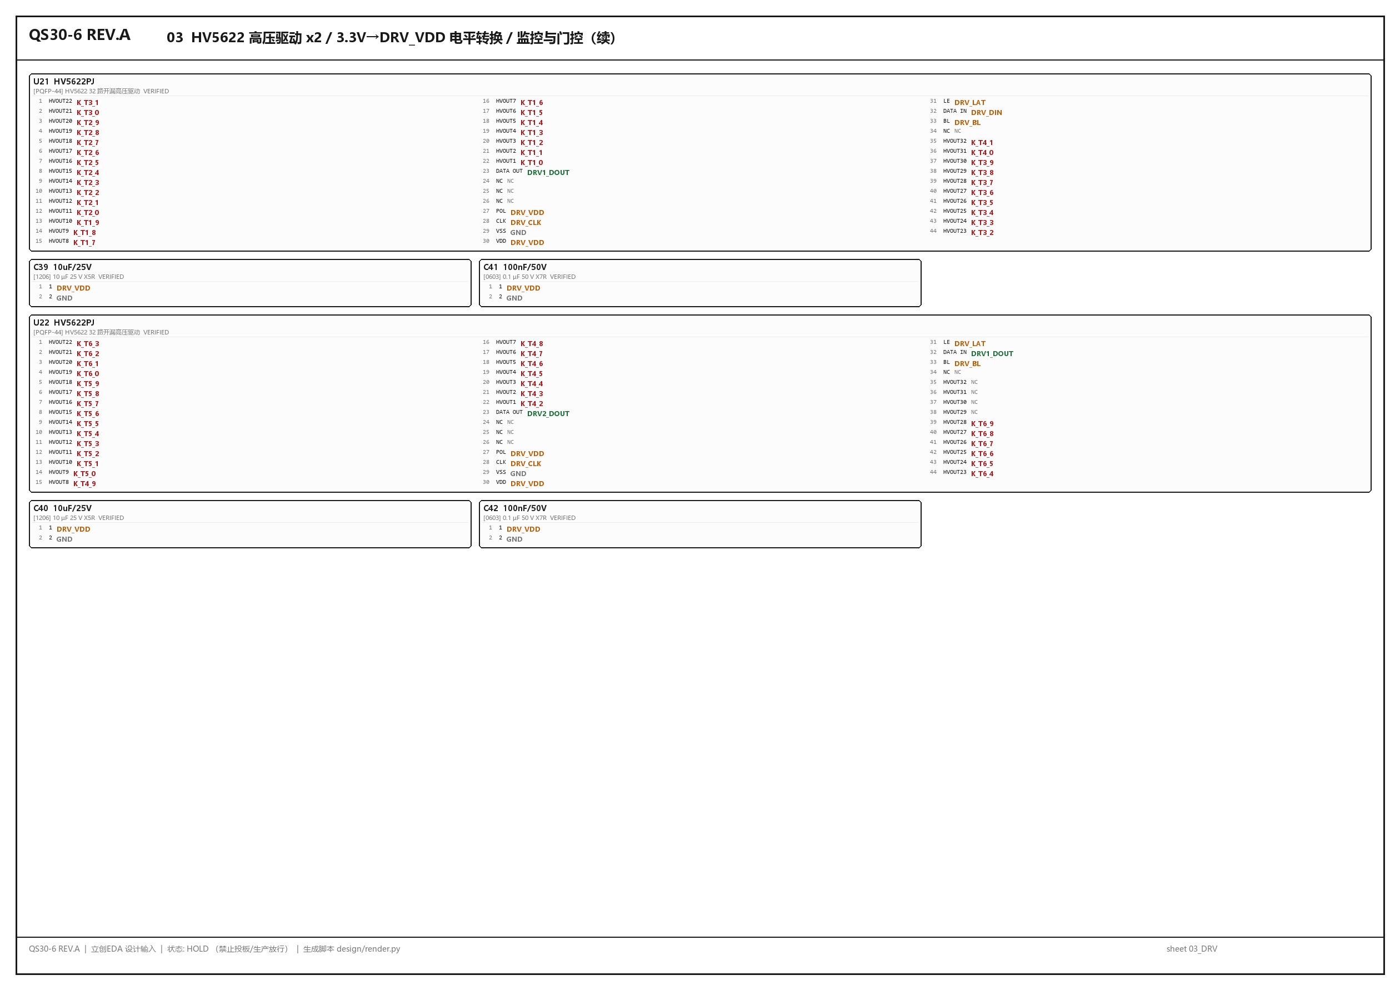
docs/schematic/page_05.png
