langxie29-cpu/QS30-driver/docs/schematic/page_06.png

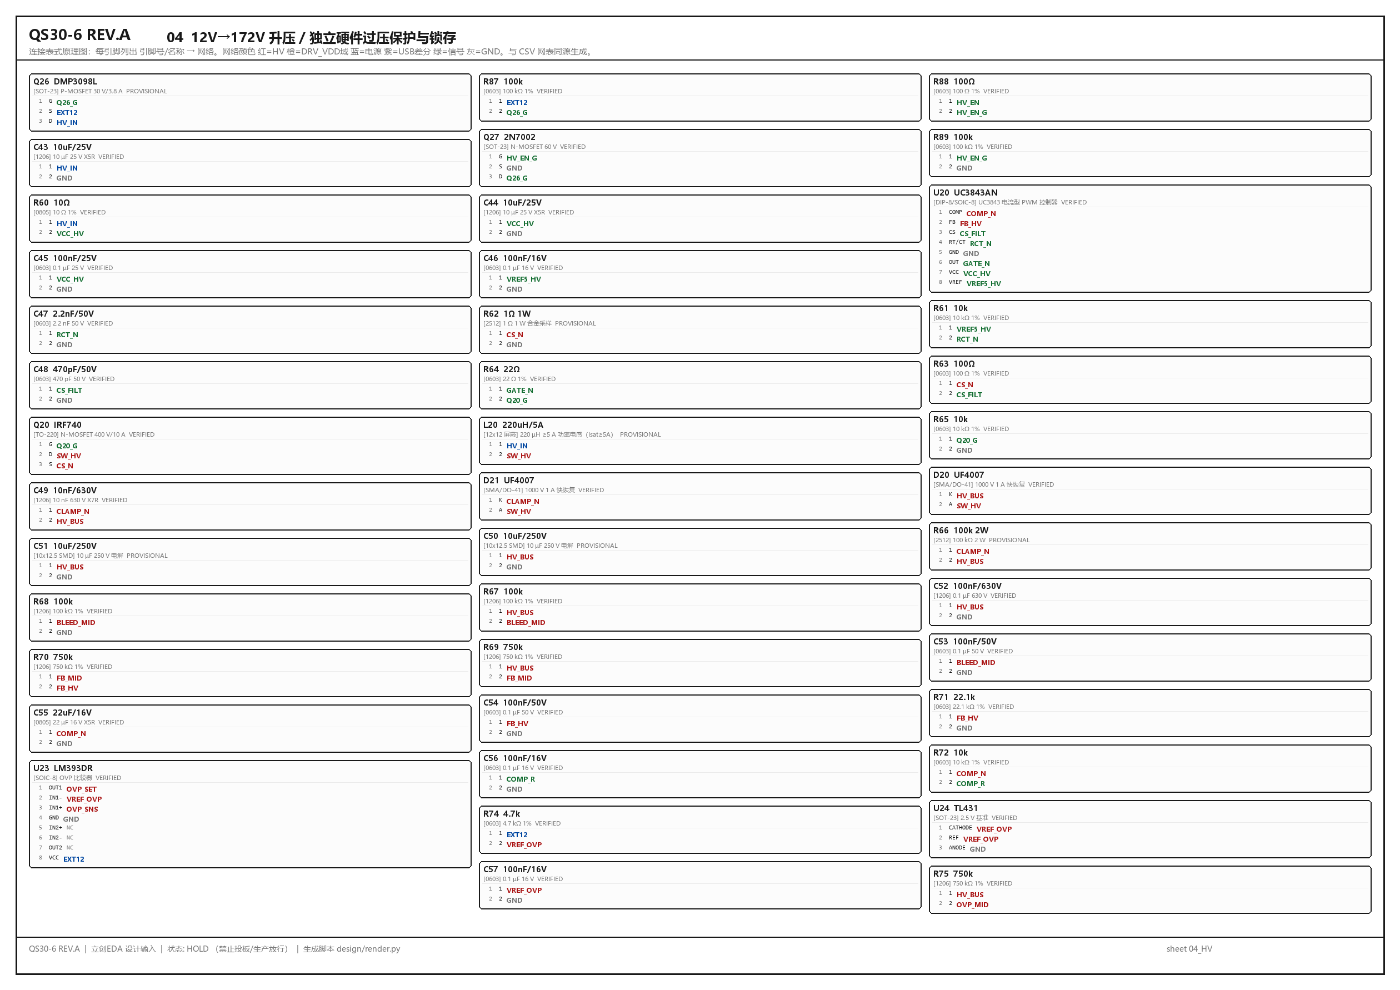
docs/schematic/page_06.png
