langxie29-cpu/QS30-driver/docs/schematic/page_07.png

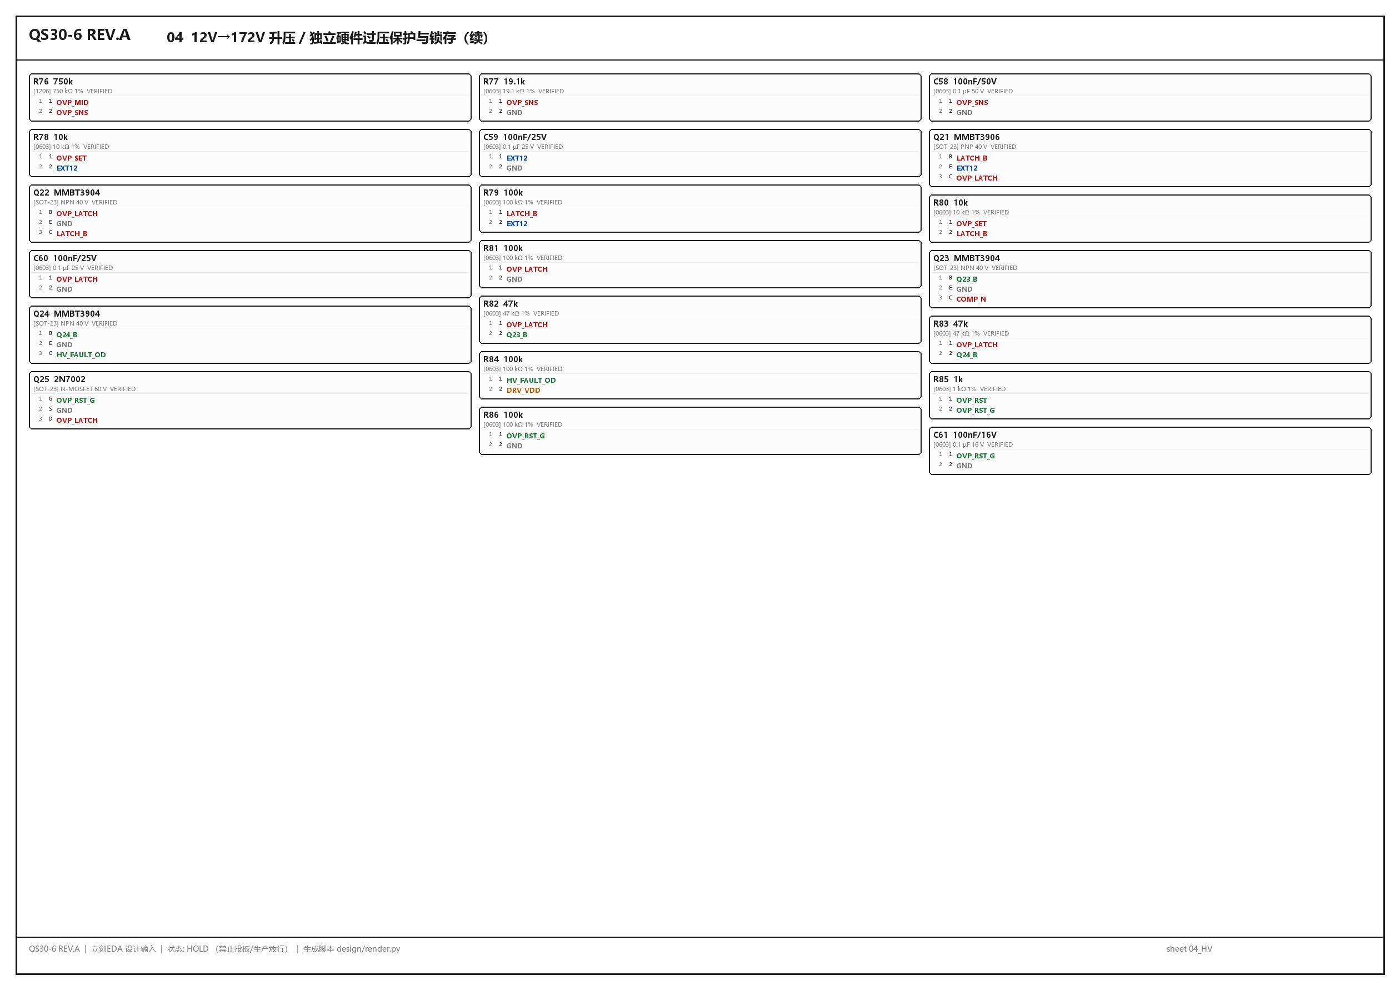
docs/schematic/page_07.png
