langxie29-cpu/QS30-driver/docs/schematic/page_08.png

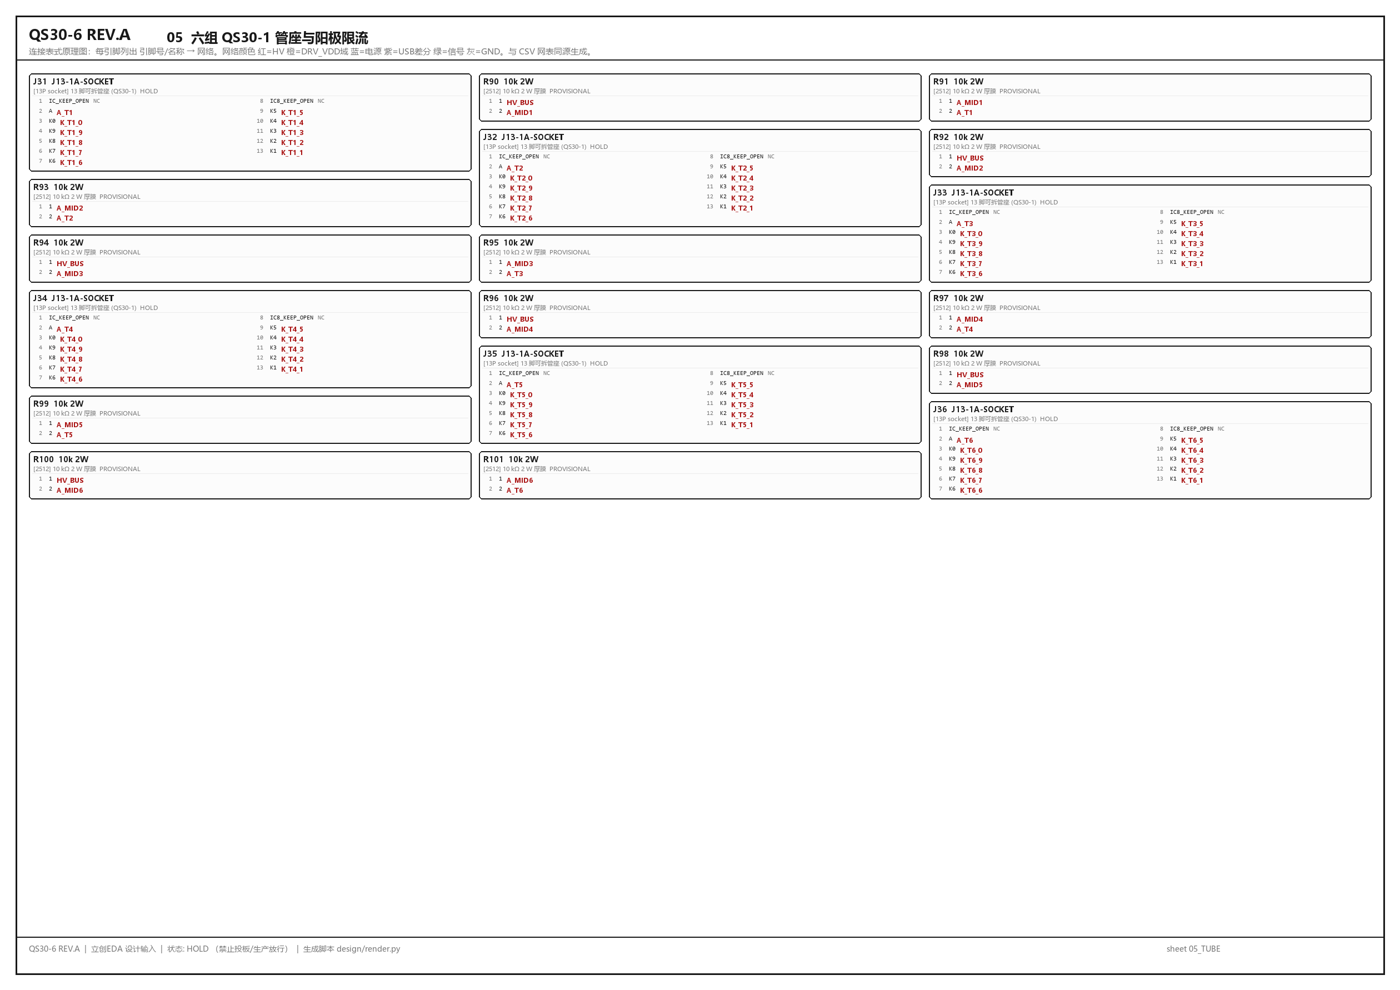
docs/schematic/page_08.png
