langxie29-cpu/QS30-driver/docs/schematic/QS30-6_REV.A_系统框图.png

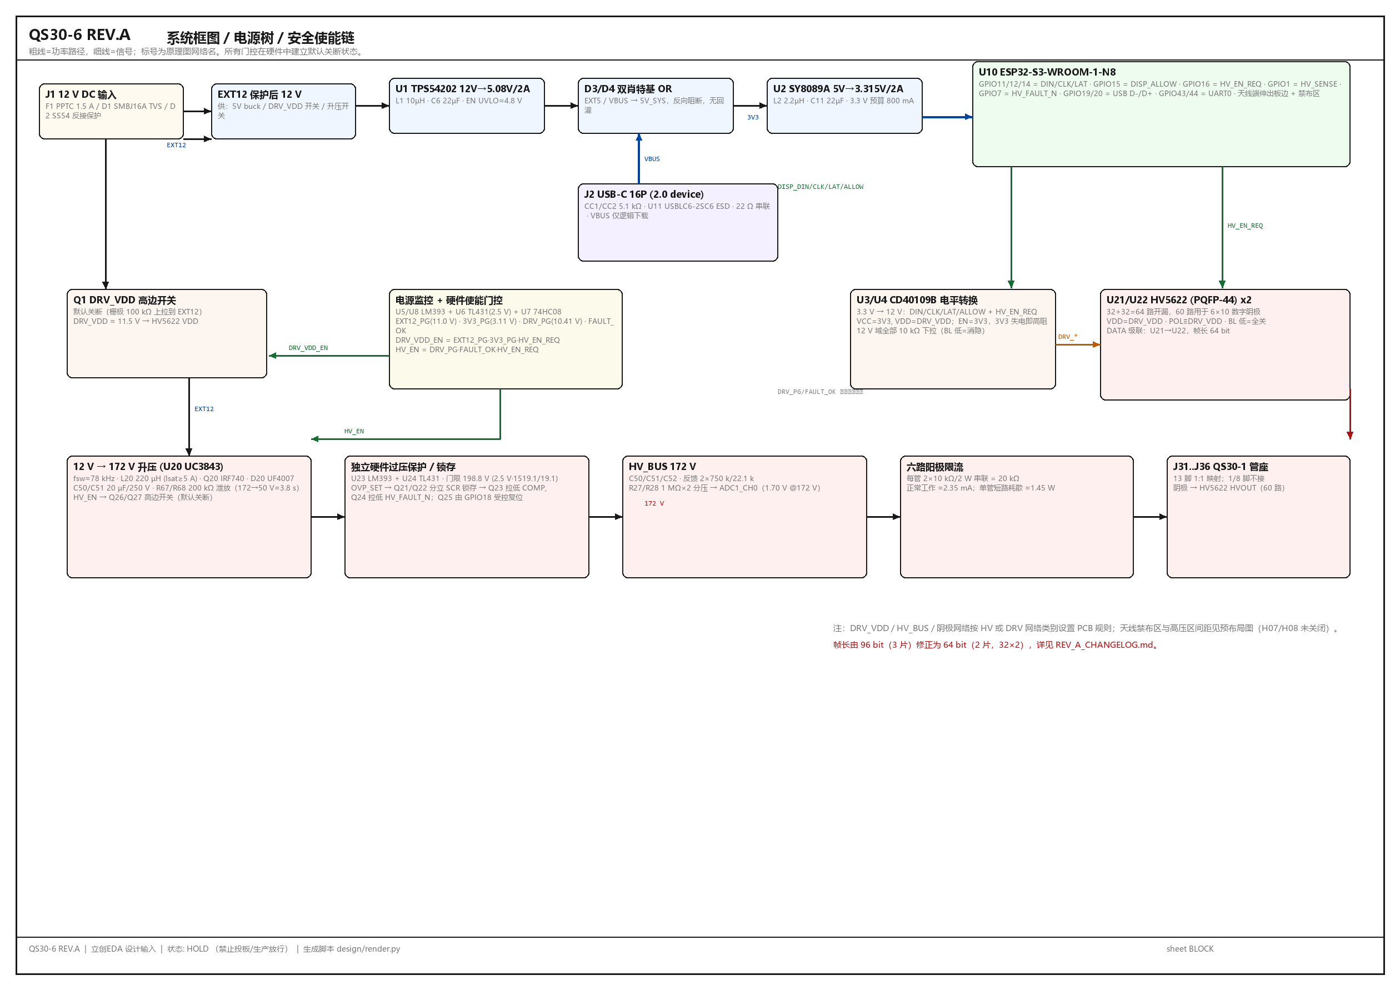
docs/schematic/QS30-6_REV.A_系统框图.png
