langxie29-cpu/QS30-driver/docs/schematic/QS30-6_REV.A_通道映射表.png

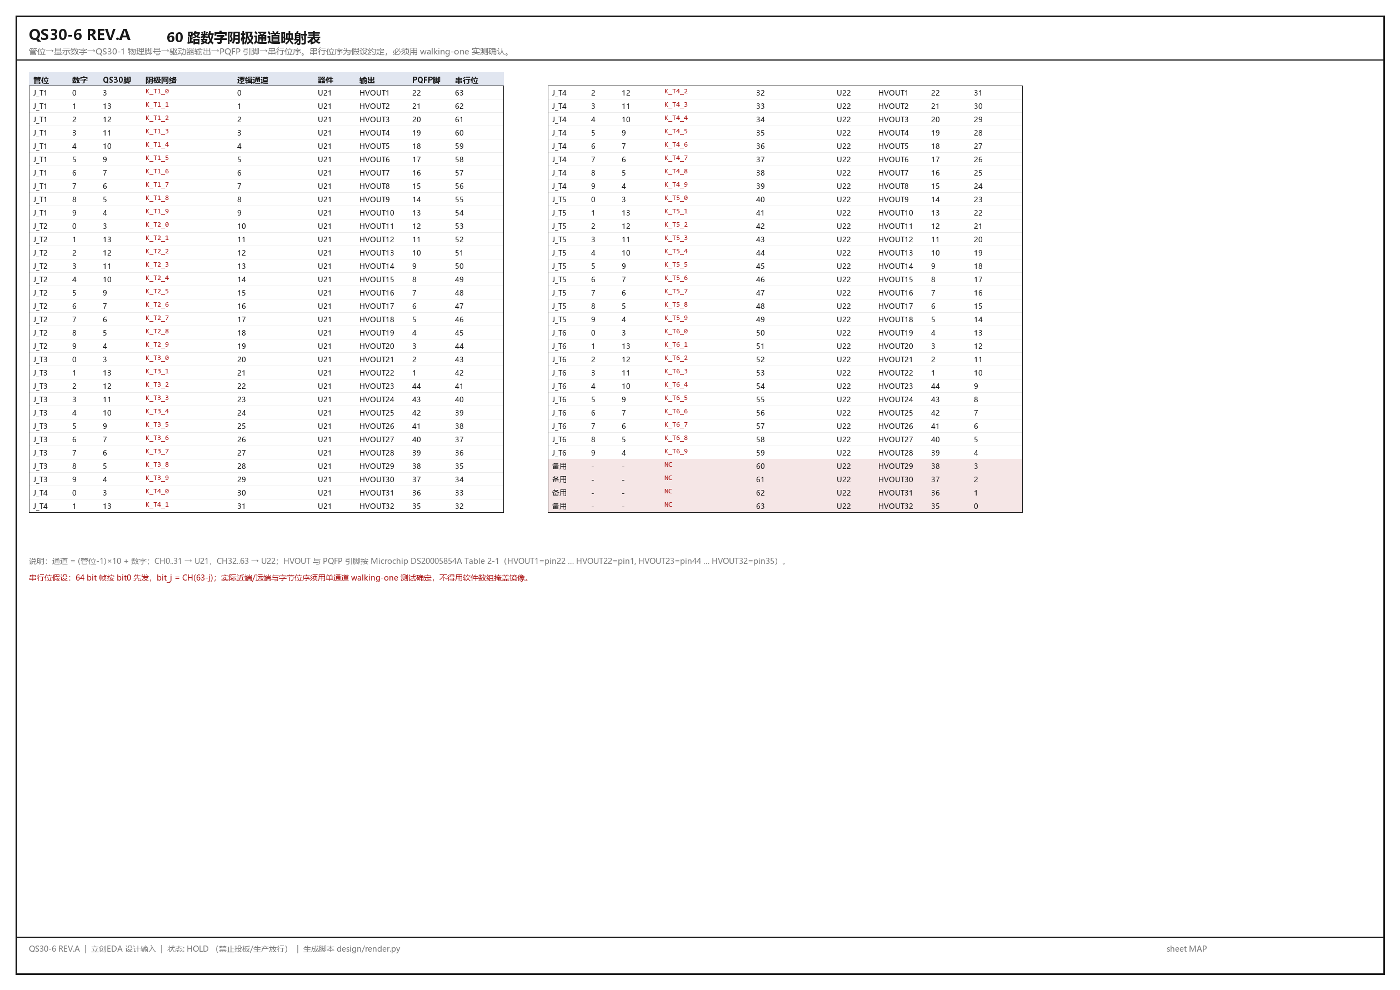
docs/schematic/QS30-6_REV.A_通道映射表.png
