langxie29-cpu/QS30-driver/docs/source_scans/CD40109B_逻辑图引脚注记.png

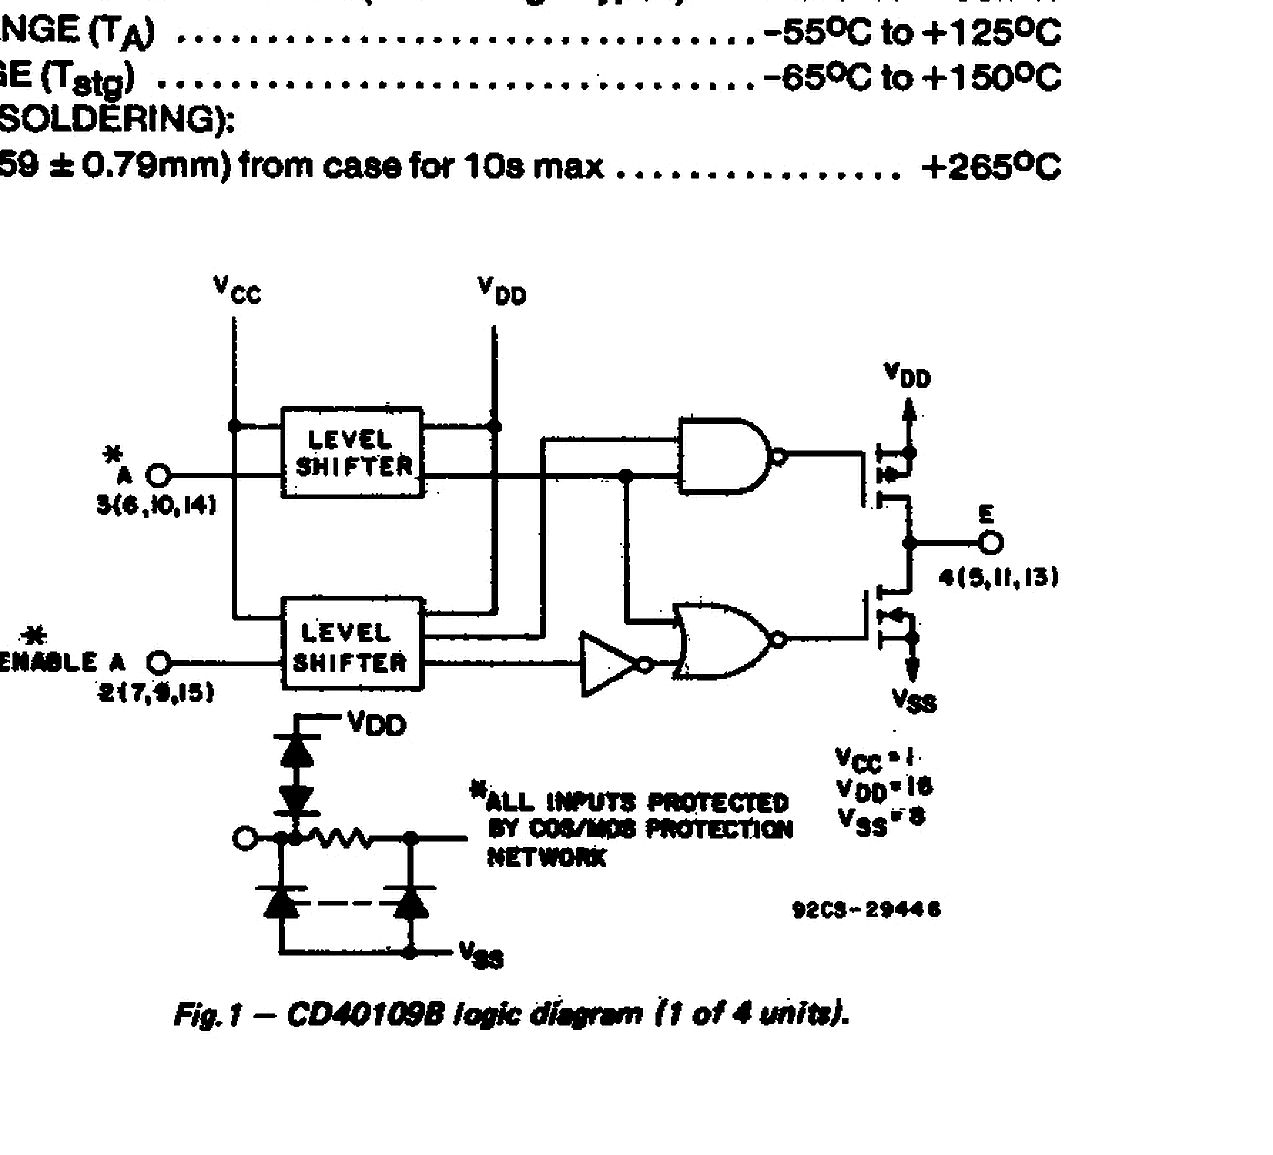
docs/source_scans/CD40109B_逻辑图引脚注记.png
