langxie29-cpu/QS30-driver/docs/source_scans/HV5622_PQFP44_引脚表.png

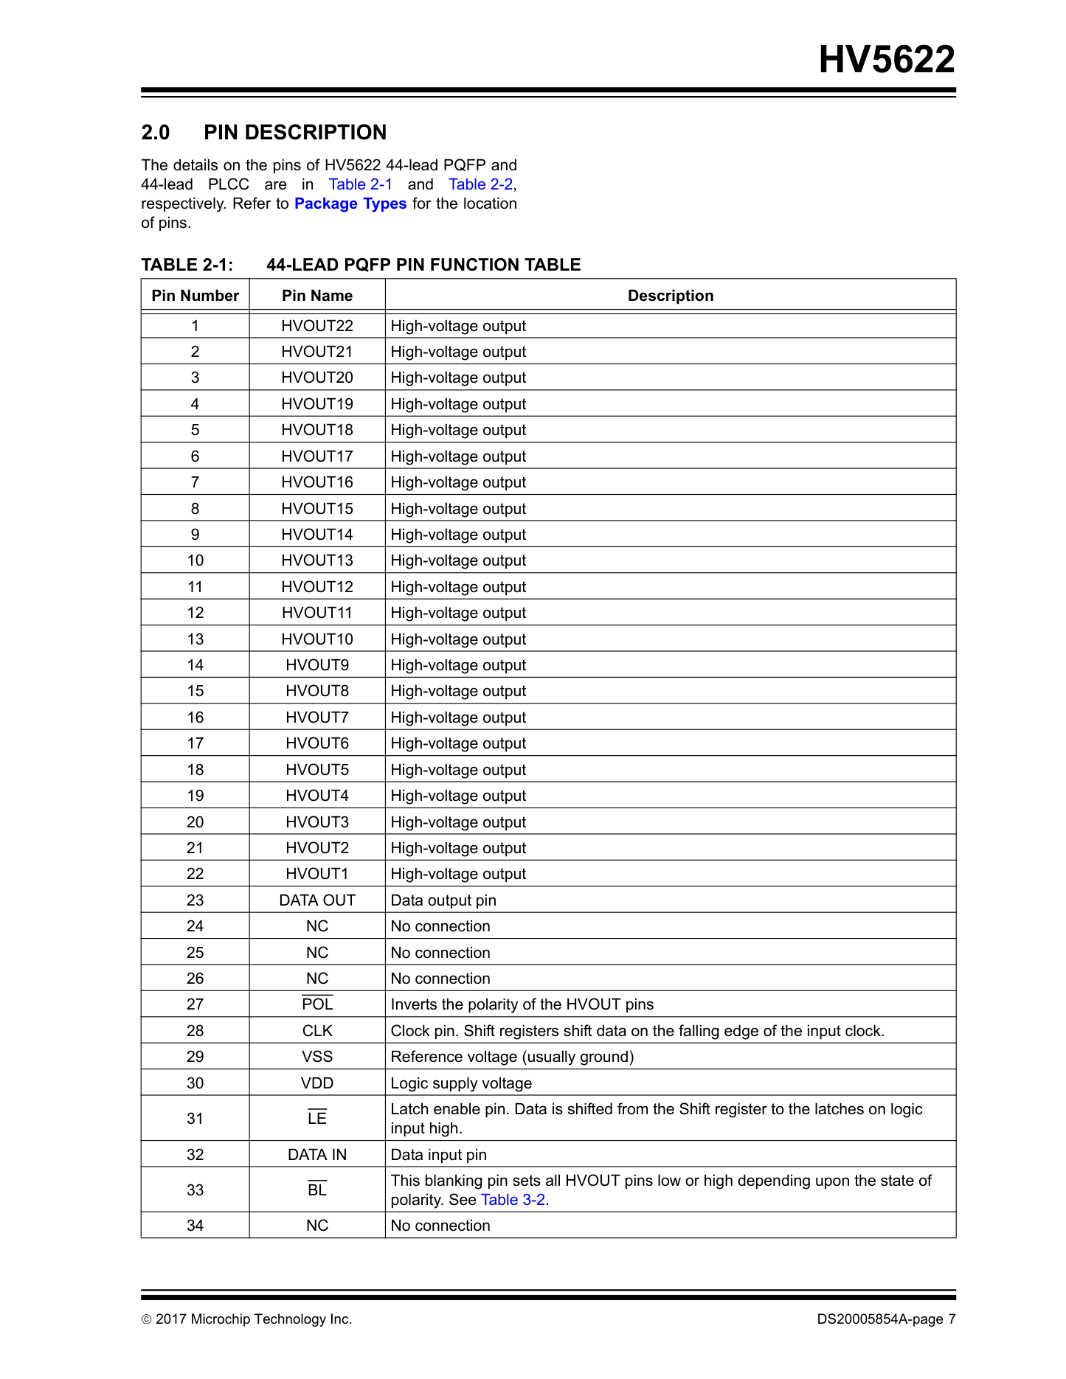
docs/source_scans/HV5622_PQFP44_引脚表.png
