langxie29-cpu/QS30-driver/docs/source_scans/HV5622_真值表.png

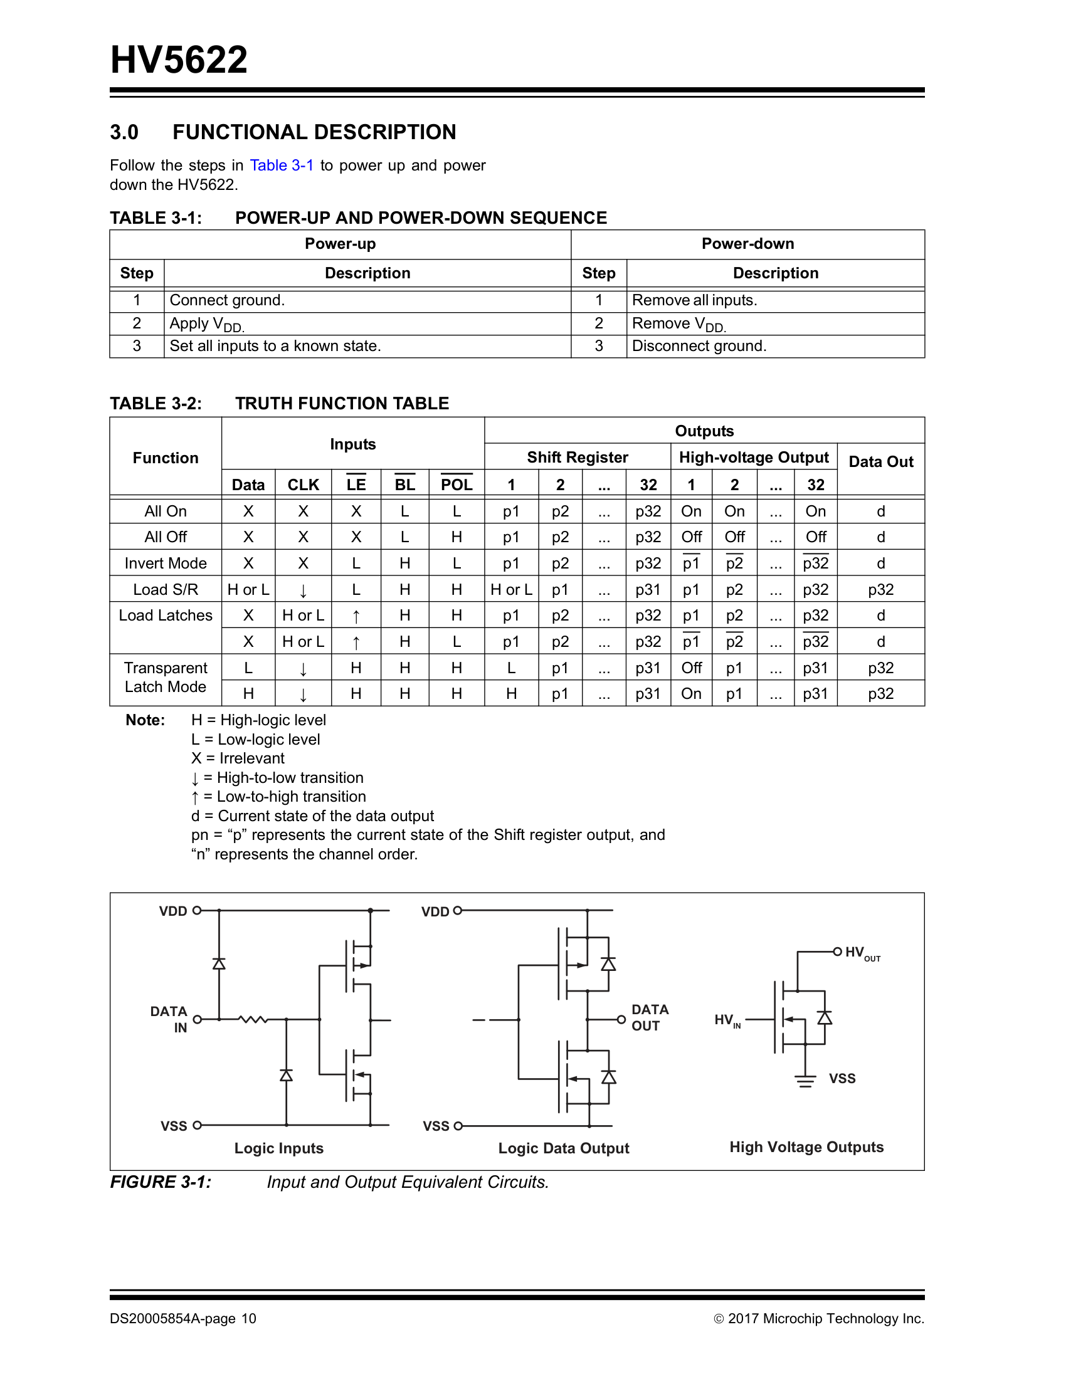
docs/source_scans/HV5622_真值表.png
