langxie29-cpu/QS30-driver/docs/source_scans/QS30-1_原厂说明书_p1_外形与电极接线图.png

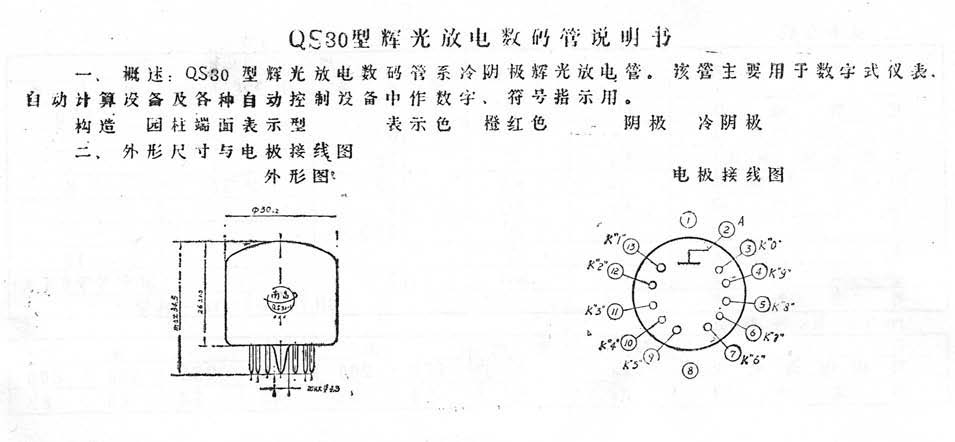
docs/source_scans/QS30-1_原厂说明书_p1_外形与电极接线图.png
