langxie29-cpu/QS30-driver/docs/source_scans/QS30-1_原厂说明书_p2_基本参数表.png

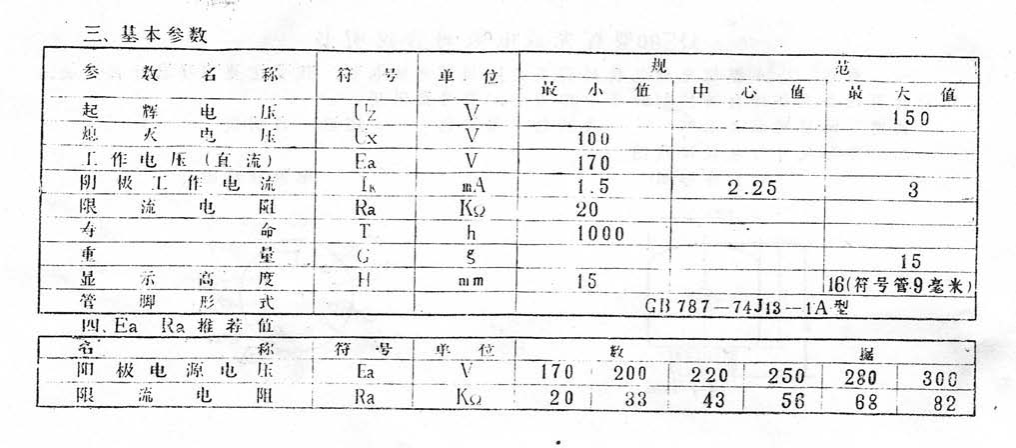
docs/source_scans/QS30-1_原厂说明书_p2_基本参数表.png
