langxie29-cpu/QS30-driver/docs/source_scans/QS30-1_外形图_放大.png

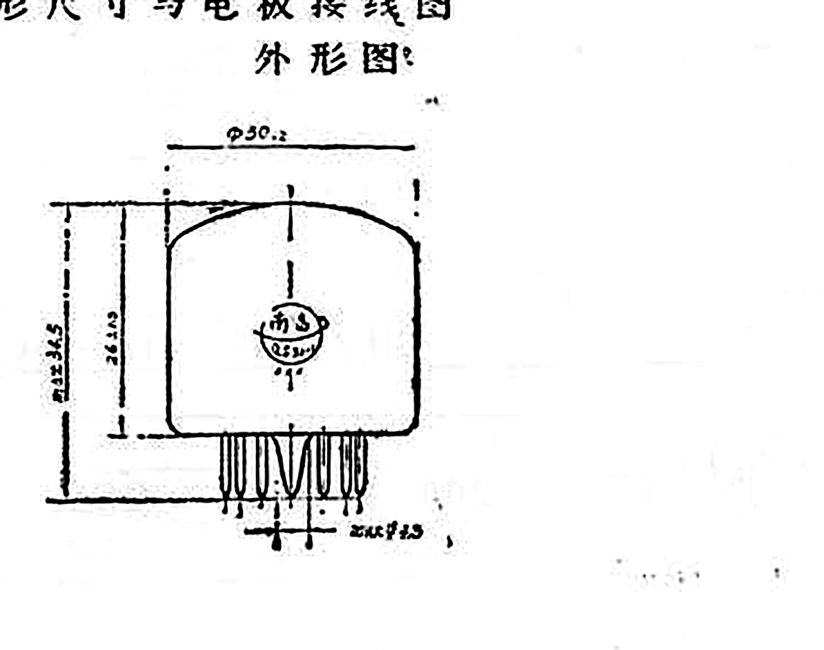
docs/source_scans/QS30-1_外形图_放大.png
