langxie29-cpu/QS30-driver/docs/source_scans/QS30-1_电极接线图_放大.png

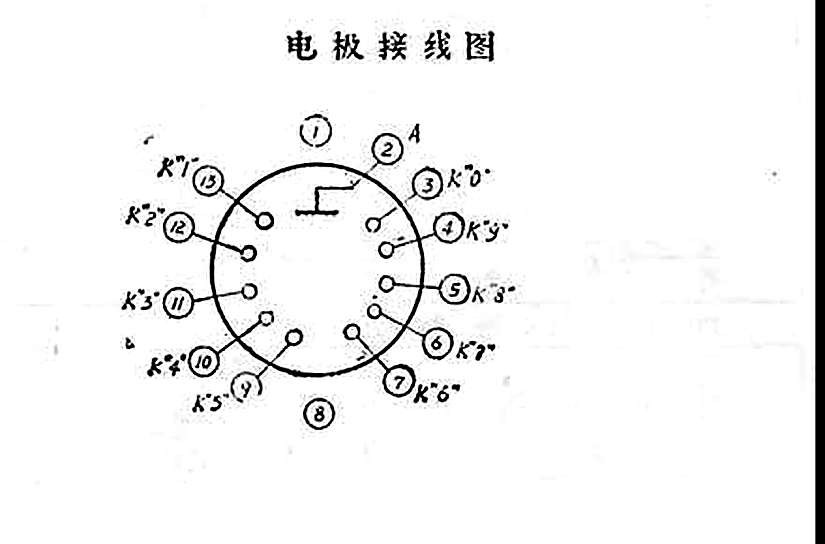
docs/source_scans/QS30-1_电极接线图_放大.png
