langxie29-cpu/QS30-driver/docs/source_scans/SN74HC08_引脚表.png

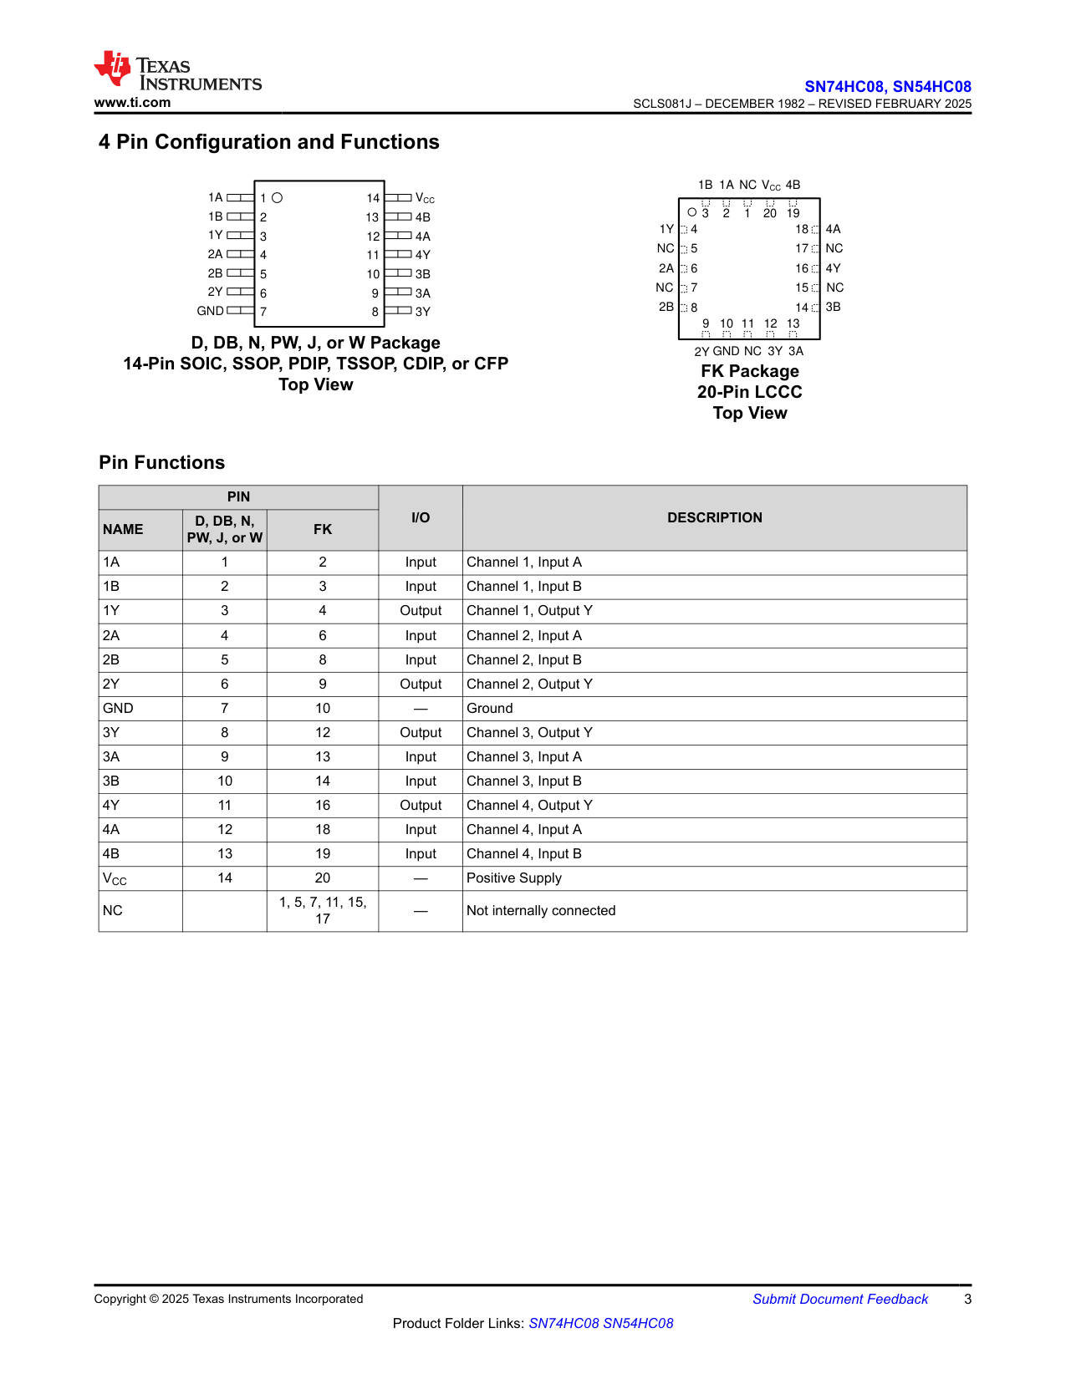
docs/source_scans/SN74HC08_引脚表.png
