langxie29-cpu/QS30-driver/docs/source_scans/TL431_DBZ_SOT23引脚.png

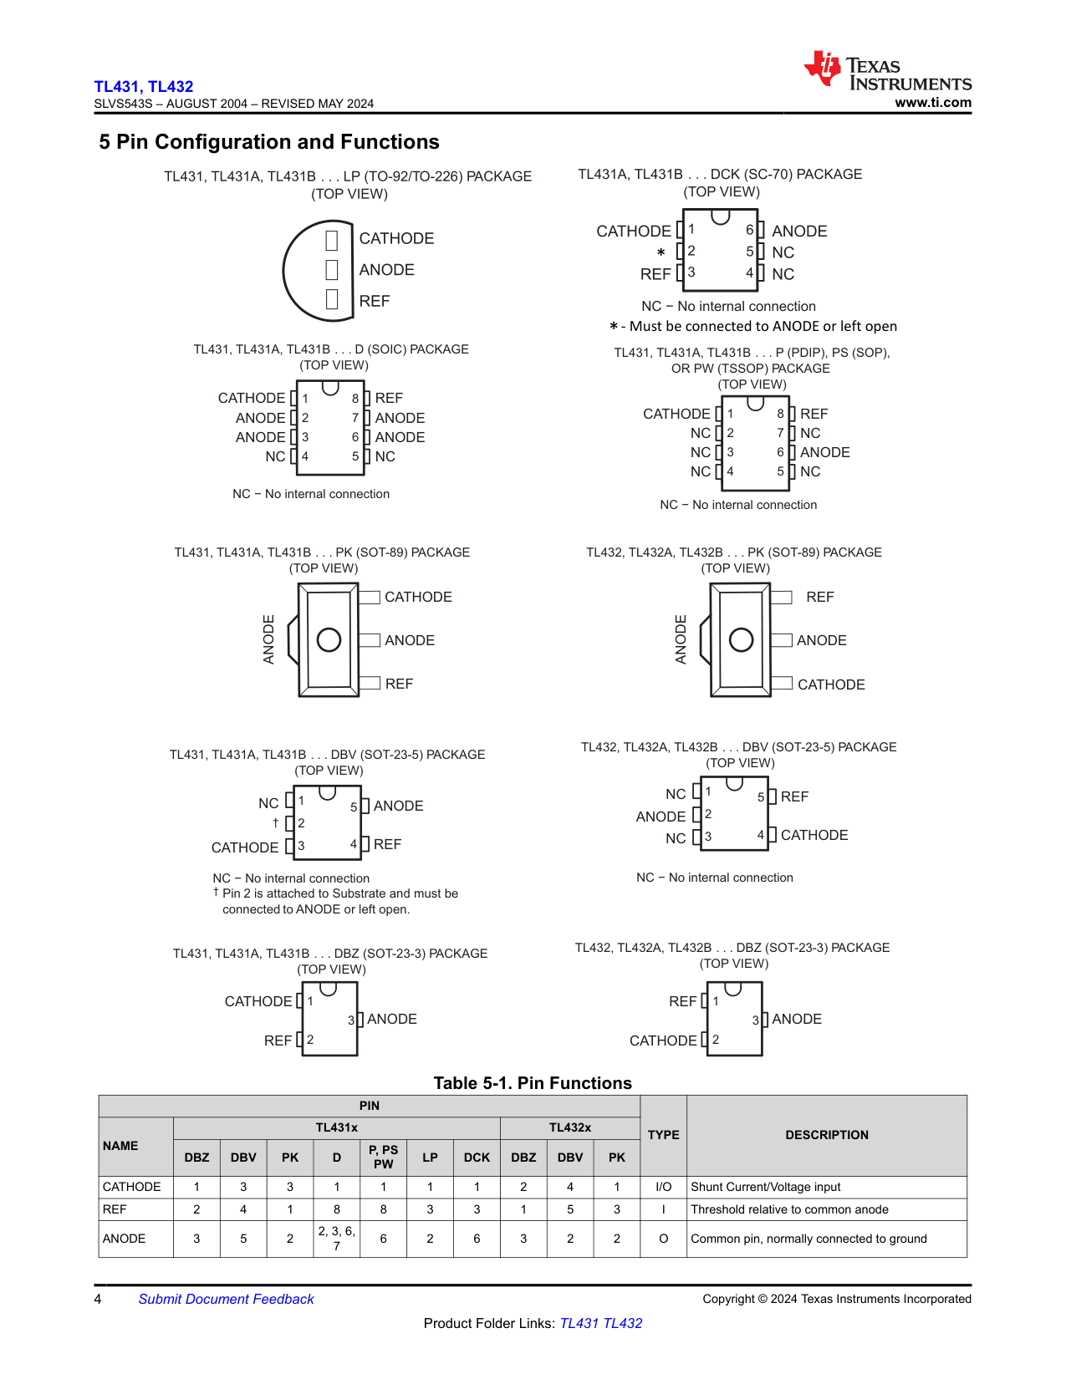
docs/source_scans/TL431_DBZ_SOT23引脚.png
