langxie29-cpu/QS30-driver/docs/source_scans/UC3843_引脚配置.png

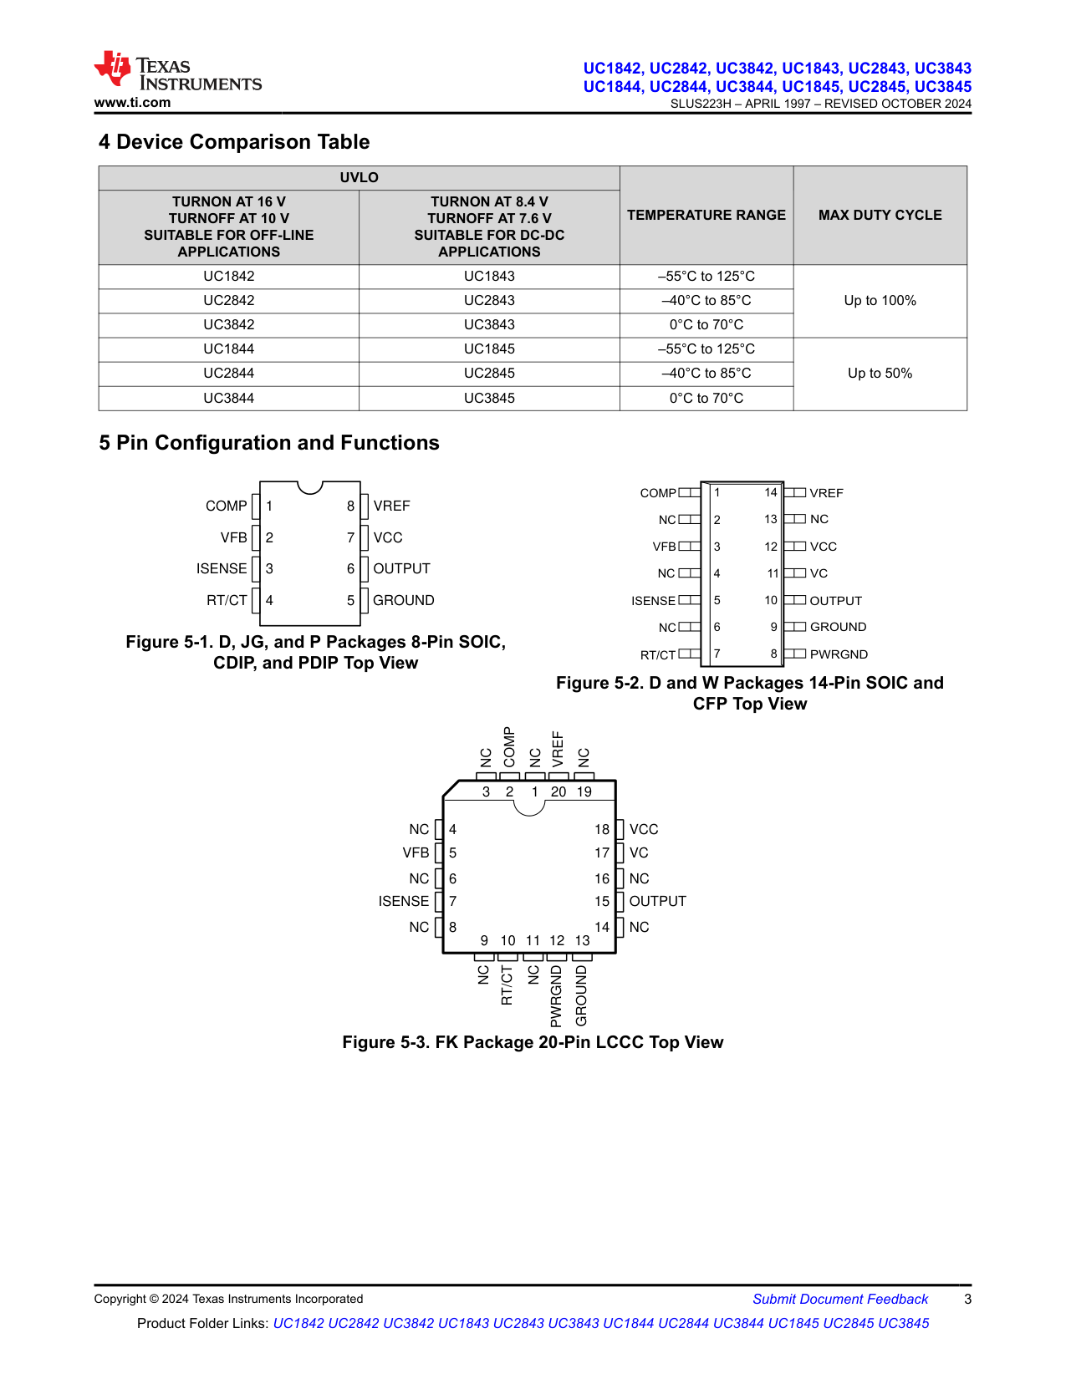
docs/source_scans/UC3843_引脚配置.png
