langxie29-cpu/QS30-driver/docs/source_scans/USBLC6-2SC6_引脚图.png

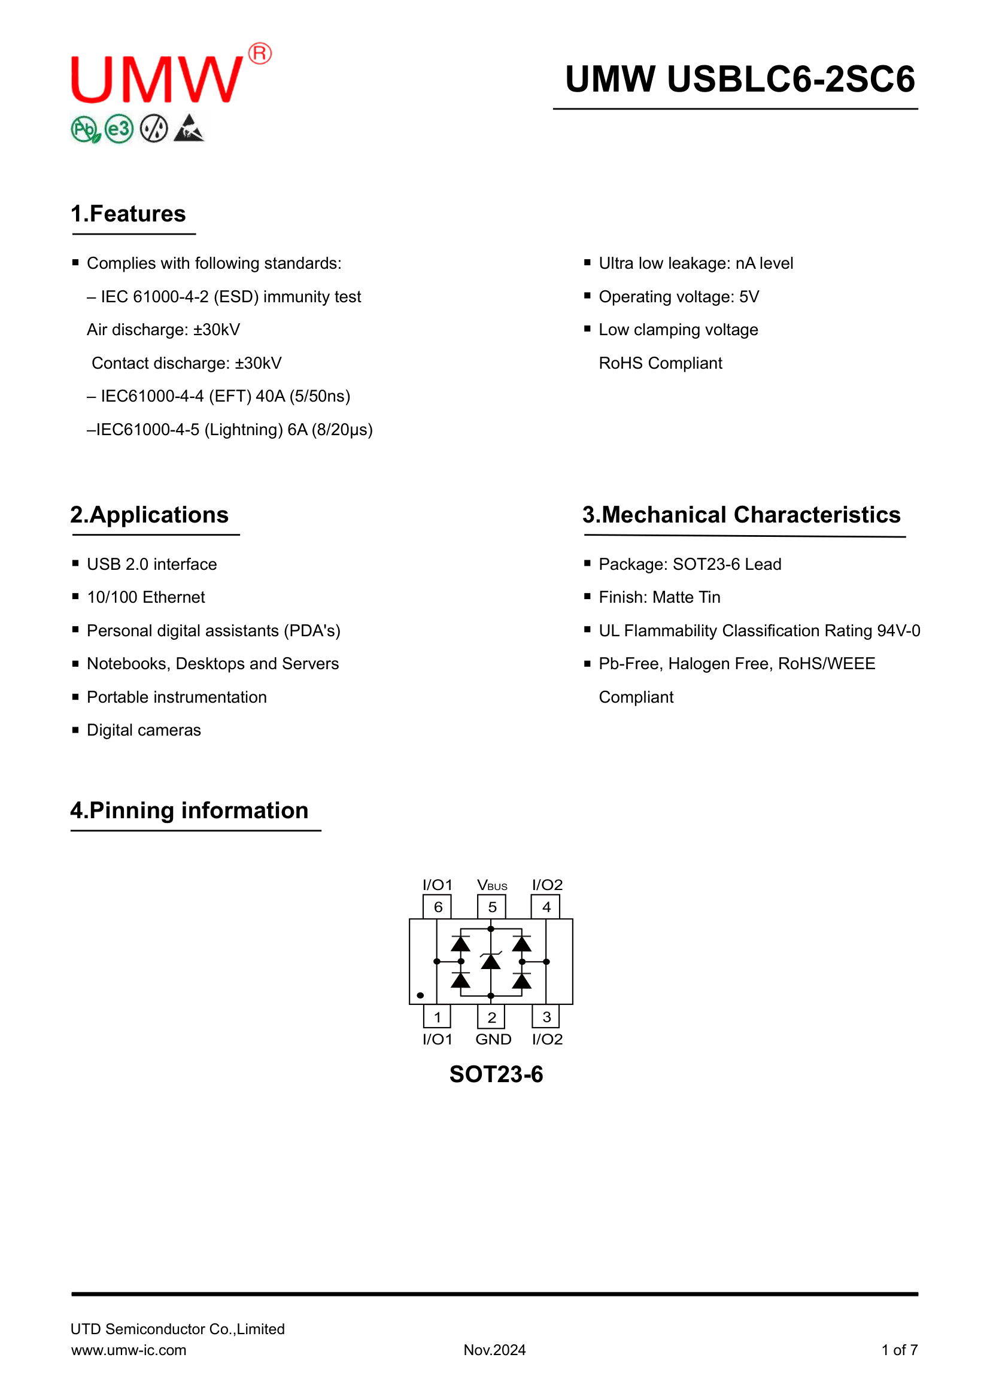
docs/source_scans/USBLC6-2SC6_引脚图.png
