langxie29-cpu/QS30-driver/docs/bom_review.md

# BOM 选型复核（关键器件降额/替代料/封装状态）

由 `design/bom_review.py` 从 `bom/QS30-6_REV.A_BOM.csv` 与设计应力生成；**5/5 项自动检查通过**。

设计应力：HV_BUS **172.18 V**、OVP **198.8 V** → 高压器件额定要求 ≥ **248 V**（1.25×）；阳极电阻单管短路 **1.48 W**。

| 编号 | 结果 | 内容 |
|---|---|---|
| H1 | PASS | 关键器件 14 个均在 BOM 中 |
| H2 | PASS | L20 标注满足 Isat ≥5 A：`220 µH ≥5 A 功率电感（Isat≥5A）` |
| H3 | PASS | 高压器件额定电压 ≥ 248 V（HV_BUS/OVP ×1.25） |
| H4 | PASS | 阳极电阻 2 W，单管短路 1.48 W → 降额 74% ≤80% |
| H5 | PASS | 替代料/封装状态：均已列出替代料 |

## 关键器件复核表

| 位号 | 类别 | BOM 值 | 选型要求 | 选型理由 | 替代料 |
|---|---|---|---|---|---|
| Q20 | 高压开关 | N-MOSFET 400 V/10 A | Vds ≥ 248 V | 400 V/10 A 覆盖 198.8 V OVP 与开关尖峰；Rds_on 0.55 Ω 决定导通损耗 | IRF840 / STP4N90K5（Vds≥500 V） |
| D20 | 升压二极管 | 1000 V 1 A 快恢复 | Vrrm ≥ 248 V | 1000 V 快恢复；1 A 平均足够（Iout≈15 mA，Ipk≈0.5 A） | US1M / ES1J（快恢复） |
| C49 | 高压电容 | 10 nF 630 V X7R | 额定 ≥ 248 V | 630 V X7R 吸收开关尖峰；DC 偏压下降容需实测 | 2×0.1 µF 串联提高耐压 |
| C50 | 高压储能 | 10 µF 250 V 电解 | 额定 ≥ 248 V | 250 V 电解，172 V 下 45% 裕量；20 µF 决定纹波/保持时间 | 220 µF/250 V（体积换纹波） |
| C51 | 高压储能 | 10 µF 250 V 电解 | 额定 ≥ 248 V | 与 C50 并联 | 同 C50 |
| C52 | 高压电容 | 0.1 µF 630 V | 额定 ≥ 248 V | 630 V 缓冲/去耦 | — |
| L20 | 升压电感 | 220 µH ≥5 A 功率电感（Isat≥5A） | Isat ≥ 5 A | 220 µH；启动浪涌 2.9–3.1 A，留 1.6× 裕量 | SUMIDA/CDRH 系列 ≥5 A 屏蔽 |
| U21 | 高压驱动 | HV5622 32 路开漏高压驱动 | Vpp ≥ 200 V；32 通道 | 64 路=2×32；Vpp 覆盖 172 V + 余量；PQFP-44 散热焊盘 | HV5622 同型号替代需核对 Vpp/封装 |
| U22 | 高压驱动 | HV5622 32 路开漏高压驱动 | Vpp ≥ 200 V；32 通道 | 同 U21 | 同 U21 |
| U20 | PWM 控制器 | UC3843 电流型 PWM 控制器 | Vcc 12 V；DIP-8/SOIC-8 | 电流模式；封装需在结构与散热确定后冻结（WARN） | UC3843AN（DIP-8）或 SOIC-8 二选一 |
| U23 | OVP 比较器 | OVP 比较器 | 开漏/推挽；SOIC-8 | LM393 双比较器，一路 OVP 一路故障 | LM2903（温度范围更宽） |
| R90 | 阳极限流 | 10 kΩ 2 W 厚膜 | 降额 ≤80%（1.48 W / 2 W） | 单管短路时 1.48 W；2512 2 W 需考虑温升降额 | 2×1 W 2512 串联/并联 |
| F1 | 输入保护 | 1.5 A 自恢复保险丝 | 保持电流 ≥ 0.6 A；I²t 可承受浪涌 | 稳态 0.6 A；浪涌 2.9 A 短时 | 1.5 A/2 A PPTC |
| J1 | 输入端子 | DC12 IN 5.08mm 2P | ≥12 V/1 A | 12 V 输入 5.08 mm 2P（机械形式待结构确认） | 5.08 mm 2P 或 5.5×2.1 DC 座 |

## 说明

- 自动检查只覆盖**能机器判定的降额/建议**；温度降额、纹波电流、ESR、磁芯饱和曲线、封装热阻仍需器件手册与实测（H06/H07）；
- 本表不是可下单 BOM：所有 HOLD 关闭前不得释放 Gerber/下单（HOLD_REGISTER）。
