langxie29-cpu/QS30-driver/bom/QS30-6_REV.A_BOM.csv

ref | mpn | value | package | sheet | status | population | source | description | note
J1 | DC-005-5.08-2P | DC12 IN 5.08mm 2P | TERM-2 | 01_PWR | PROVISIONAL |  | D4 | 12 V DC 输入端子（机械形式待结构确认） | H05/H07
F1 | PPTC-1.5A-1812 | 1.5 A 自恢复保险丝 | 1812 | 01_PWR | PROVISIONAL |  | D4 | 输入过流保护（保持电流 1.5 A） | H05
D1 | SMBJ16A | TVS 16 V 单向 | SMB | 01_PWR | PROVISIONAL |  | D4 | 12 V 输入端瞬态抑制（Standoff 16 V） | H05
D2 | SS54 | 40 V 5 A 肖特基 | SMB | 01_PWR | VERIFIED |  | D4 | 输入反接保护 + 反向阻断（Vf≈0.45 V @1 A） | H05：如需低压降可改理想二极管
C1 | 100uF/25V | 100 µF 25 V 电解 | 8x10.5 SMD | 01_PWR | VERIFIED |  | D4 | 输入储能
C2 | 1uF/50V | 1 µF 50 V X7R | 1206 | 01_PWR | VERIFIED |  | D4 | 输入高频旁路
C3 | 100nF/50V | 0.1 µF 50 V X7R | 0603 | 01_PWR | VERIFIED |  | D4 | 输入高频旁路
U1 | TPS54202DDCR | TPS54202 12V->5.0V 2A | SOT-23-6 | 01_PWR | VERIFIED |  | S8 | 同步降压 12 V -> 5.08 V / 2 A, 500 kHz, 内置软启动 | H05：纹波/温升/EMI 待测
R1 | 100k | 100 kΩ 1% | 0603 | 01_PWR | VERIFIED |  | S8 | EN 分压上臂（UVLO≈4.8 V）
R2 | 33k | 33 kΩ 1% | 0603 | 01_PWR | VERIFIED |  | S8 | EN 分压下臂
C4 | 10uF/25V | 10 µF 25 V X5R | 1206 | 01_PWR | VERIFIED |  | S8 | U1 输入旁路
C5 | 100nF/50V | 0.1 µF 50 V X7R | 0603 | 01_PWR | VERIFIED |  | S8 | BOOT 自举电容
L1 | 10uH/3A | 10 µH 3 A 屏蔽功率电感 | 0630 | 01_PWR | PROVISIONAL |  | S8 | U1 储能电感，Isat≥3 A
R3 | 100k | 100 kΩ 1% | 0603 | 01_PWR | VERIFIED |  | S8 | 5 V 反馈上臂
R4 | 13.3k | 13.3 kΩ 1% | 0603 | 01_PWR | VERIFIED |  | S8 | 5 V 反馈下臂 → Vout=0.596*(1+100/13.3)=5.08 V
C6 | 22uF/10V | 22 µF 10 V X5R | 0805 | 01_PWR | VERIFIED |  | S8 | 5 V 输出电容
C7 | 100nF/16V | 0.1 µF 16 V X7R | 0603 | 01_PWR | VERIFIED |  | S8 | 5 V 输出高频旁路
D3 | SS14 | 40 V 1 A 肖特基 | SMA | 01_PWR | VERIFIED |  | S9 | 外部 5 V 理想二极管/肖特基 OR（反向阻断） | H05：候选 B 为理想二极管 IC，本图为参考实现
D4 | SS14 | 40 V 1 A 肖特基 | SMA | 01_PWR | VERIFIED |  | S9 | USB VBUS OR 支路（反向阻断）
C8 | 22uF/10V | 22 µF 10 V X5R | 0805 | 01_PWR | VERIFIED |  | S9 | 5V_SYS 储能（Wi-Fi 瞬态）
C9 | 100nF/16V | 0.1 µF 16 V X7R | 0603 | 01_PWR | VERIFIED |  | S9 | 5V_SYS 高频旁路
U2 | SY8089AAAC | SY8089A 5V->3.3V 2A | SOT-23-5 | 01_PWR | VERIFIED |  | S10 | 同步降压 5V_SYS -> 3.315 V / 2 A, 1 MHz | H05：3.3 V 容量按 800 mA 分配实测
R5 | 100k | 100 kΩ 1% | 0603 | 01_PWR | VERIFIED |  | S10 | U2 EN 上拉（默认开启）
C10 | 10uF/10V | 10 µF 10 V X5R | 0805 | 01_PWR | VERIFIED |  | S10 | U2 输入旁路
L2 | 2.2uH/3A | 2.2 µH 3 A 屏蔽功率电感 | 0520 | 01_PWR | PROVISIONAL |  | S10 | U2 储能电感
R6 | 100k | 100 kΩ 1% | 0603 | 01_PWR | VERIFIED |  | S10 | 3.3 V 反馈上臂
R7 | 22.1k | 22.1 kΩ 1% | 0603 | 01_PWR | VERIFIED |  | S10 | 3.3 V 反馈下臂 → Vout=0.6*(1+100/22.1)=3.315 V
C11 | 22uF/6.3V | 22 µF 6.3 V X5R | 0805 | 01_PWR | VERIFIED |  | S10 | 3.3 V 输出电容
C12 | 100nF/16V | 0.1 µF 16 V X7R | 0603 | 01_PWR | VERIFIED |  | S10 | 3.3 V 高频旁路
Q1 | DMP3098L | P-MOSFET 30 V/3.8 A | SOT-23 | 01_PWR | PROVISIONAL |  | S11 | DRV_VDD 高边开关（±20 V Vgs，无需钳位） | H04
R8 | 100k | 100 kΩ 1% | 0603 | 01_PWR | VERIFIED |  | S11 | Q1 栅极上拉至源极 → 默认关断
Q2 | 2N7002 | N-MOSFET 60 V | SOT-23 | 01_PWR | VERIFIED |  | S11 | Q1 栅极下拉驱动（低电平有效）
R9 | 100Ω | 100 Ω 1% | 0603 | 01_PWR | VERIFIED |  | S11 | Q2 栅极串联电阻
R10 | 100k | 100 kΩ 1% | 0603 | 01_PWR | VERIFIED |  | S11 | Q2 栅极下拉 → 上电默认关断
C13 | 10uF/25V | 10 µF 25 V X5R | 1206 | 01_PWR | VERIFIED |  | S11 | DRV_VDD 储能
C14 | 100nF/50V | 0.1 µF 50 V X7R | 0603 | 01_PWR | VERIFIED |  | S11 | DRV_VDD 高频旁路
U10 | ESP32-S3-WROOM-1-N8 | ESP32-S3 8MB Flash 无 PSRAM | WROOM-1 41pad | 02_MCU | VERIFIED |  | S1 | 主控模组，板载 PCB 天线，焊盘编号按 Espressif 数据手册表 3-1 | S1 焊盘表；H08 天线/整机 RF
C16 | 22uF | 22uF 6.3V | 0805 | 02_MCU | VERIFIED |  | S3 | 模组 3V3 去耦
C17 | 1uF | 1uF 16V | 0603 | 02_MCU | VERIFIED |  | S3 | 模组 3V3 去耦
C18 | 100nF | 100nF 16V | 0603 | 02_MCU | VERIFIED |  | S3 | 模组 3V3 去耦
R11 | 10k | 10 kΩ 1% | 0603 | 02_MCU | VERIFIED |  | S3 | EN 上拉（Espressif 推荐 10 kΩ）
C19 | 1uF/16V | 1 µF 16 V X7R | 0603 | 02_MCU | VERIFIED |  | S3 | EN RC 延时电容（Espressif 推荐 10k/1µF）
SW1 | TS-1187A | 复位按键 | 4P 6x6 SMD | 02_MCU | PROVISIONAL |  | S3 | RESET 按键（EN 拉低）
SW2 | TS-1187A | BOOT 按键 | 4P 6x6 SMD | 02_MCU | PROVISIONAL |  | S4 | 强制下载（GPIO0 拉低后释放 RESET）
R12 | 10k | 10 kΩ 1% | 0603 | 02_MCU | VERIFIED |  | S4 | GPIO0 上拉（Espressif 推荐）
R13 | 10k | 10 kΩ 1% | 0603 | 02_MCU | VERIFIED |  | S3 | GPIO46 下拉（保持官方默认启动条件）
J2 | USB-C-16P-2.0 | USB-C 母座 16P USB2.0 | SMD 16P | 02_MCU | PROVISIONAL |  | S2 | USB-C 设备端（USB 2.0 only） | H05：封装/沉板形式待确认
R14 | 5.1k | 5.1 kΩ 1% | 0603 | 02_MCU | VERIFIED |  | S2 | CC1 下拉（UFP 5.1 kΩ）
R15 | 5.1k | 5.1 kΩ 1% | 0603 | 02_MCU | VERIFIED |  | S2 | CC2 下拉（UFP 5.1 kΩ）
R16 | 1M | 1 MΩ 1% | 0603 | 02_MCU | VERIFIED |  | S2 | 屏蔽层泄放（RC 并联到 GND）
C20 | 4.7nF/50V | 4.7 nF 50 V X7R | 0603 | 02_MCU | VERIFIED |  | S2 | 屏蔽层高频接地
C21 | 1uF/16V | 1 µF 16 V X7R | 0603 | 02_MCU | VERIFIED |  | S2 | VBUS 旁路（连接器侧）
C22 | 100nF/16V | 0.1 µF 16 V X7R | 0603 | 02_MCU | VERIFIED |  | S2 | VBUS 高频旁路
U11 | USBLC6-2SC6 | USB ESD 保护 | SOT-23-6 | 02_MCU | VERIFIED |  | S12 | USB D+/D- ESD（I/O1: 1-6, I/O2: 3-4, VBUS:5）
R17 | 22Ω | 22 Ω 1% | 0402 | 02_MCU | PROVISIONAL |  | S2 | USB D+ 串联电阻（Espressif 建议 22/33 Ω，实测调整）
R18 | 22Ω | 22 Ω 1% | 0402 | 02_MCU | PROVISIONAL |  | S2 | USB D- 串联电阻
C23 | 10pF/50V | 10 pF 50 V | 0402 | 02_MCU | PROVISIONAL | DNP | S2 | USB D+ 对地预留电容（默认不装）
C24 | 10pF/50V | 10 pF 50 V | 0402 | 02_MCU | PROVISIONAL | DNP | S2 | USB D- 对地预留电容（默认不装）
J3 | HDR-1x6-2.54 | UART0 恢复排针 1x6 | 2.54mm | 02_MCU | VERIFIED |  | S3 | GND/3V3参考/TX/RX/EN/BOOT | 3V3 参考点经 0Ω(DNP) 连接，不默认向外供电
R19 | 499Ω | 499 Ω 1% | 0603 | 02_MCU | VERIFIED |  | S3 | U0TXD 串联电阻（Espressif 建议 499 Ω 抑制谐波）
R20 | 0Ω | 0 Ω | 0603 | 02_MCU | VERIFIED | DNP | S3 | 3V3 参考点限流/隔离（默认不装）
SW3 | TS-1187A | SET 按键 | 4P 6x6 SMD | 02_MCU | PROVISIONAL |  | S3 | SET 键（按下拉低）
SW4 | TS-1187A | PLUS 按键 | 4P 6x6 SMD | 02_MCU | PROVISIONAL |  | S3 | PLUS 键（按下拉低）
SW5 | TS-1187A | MINUS 按键 | 4P 6x6 SMD | 02_MCU | PROVISIONAL |  | S3 | MINUS 键（按下拉低）
R21 | 10k | 10 kΩ 1% | 0603 | 02_MCU | VERIFIED |  | S3 | 按键上拉
R22 | 10k | 10 kΩ 1% | 0603 | 02_MCU | VERIFIED |  | S3 | 按键上拉
R23 | 10k | 10 kΩ 1% | 0603 | 02_MCU | VERIFIED |  | S3 | 按键上拉
C25 | 100nF/16V | 0.1 µF 16 V X7R | 0603 | 02_MCU | VERIFIED |  | S3 | 按键硬件去抖
C26 | 100nF/16V | 0.1 µF 16 V X7R | 0603 | 02_MCU | VERIFIED |  | S3 | 按键硬件去抖
C27 | 100nF/16V | 0.1 µF 16 V X7R | 0603 | 02_MCU | VERIFIED |  | S3 | 按键硬件去抖
LED1 | LTST-C190KRKT | 红色 LED | 0603 | 02_MCU | VERIFIED |  | S3 | 状态指示（GPIO17 高有效）
R24 | 1k | 1 kΩ 1% | 0603 | 02_MCU | VERIFIED |  | S3 | LED 限流（约 1.3 mA @3.3 V）
R25 | 4.7k | 4.7 kΩ 1% | 0603 | 02_MCU | VERIFIED | DNP | S3 | I2C SDA 上拉（预留，默认不装）
R26 | 4.7k | 4.7 kΩ 1% | 0603 | 02_MCU | VERIFIED | DNP | S3 | I2C SCL 上拉（预留，默认不装）
R27 | 1M | 1 MΩ 1% 1206 | 1206 | 02_MCU | PROVISIONAL |  | S3 | HV 分压上臂 1/2（170 V 下每只约 85 V） | H06
R28 | 1M | 1 MΩ 1% 1206 | 1206 | 02_MCU | PROVISIONAL |  | S3 | HV 分压上臂 2/2 | H06
R29 | 20k | 20 kΩ 1% | 0805 | 02_MCU | PROVISIONAL |  | S3 | HV 分压下臂 → 172 V 对应 1.70 V（ADC1_CH0, ATTEN=3） | H06：分压比/钳位/回灌待复核
R30 | 1k | 1 kΩ 1% | 0603 | 02_MCU | PROVISIONAL |  | S3 | ADC 输入串联限流
C28 | 100nF/16V | 0.1 µF 16 V X7R | 0603 | 02_MCU | VERIFIED |  | S3 | ADC 滤波电容（Espressif 建议 0.1 µF）
D5 | BAT54 | 肖特基 30 V | SOD-323 | 02_MCU | VERIFIED |  | S3 | HV_SENSE 上限钳位到 3V3
D6 | BAT54 | 肖特基 30 V | SOD-323 | 02_MCU | VERIFIED |  | S3 | HV_SENSE 下限钳位到 GND
R31 | 100k | 100 kΩ 1% | 0603 | 02_MCU | PROVISIONAL |  | S3 | 故障开漏上拉分压上臂（DRV_VDD 11.5 V → 3.06 V） | H04
R32 | 36.5k | 36.5 kΩ 1% | 0603 | 02_MCU | PROVISIONAL |  | S3 | 故障分压下臂 → 无故障时 3.06 V
C29 | 100nF/16V | 0.1 µF 16 V | 0603 | 02_MCU | VERIFIED |  | S3 | 故障输入滤波
D7 | BAT54 | 肖特基 30 V | SOD-323 | 02_MCU | VERIFIED |  | S3 | 故障输入上限钳位
D8 | BAT54 | 肖特基 30 V | SOD-323 | 02_MCU | VERIFIED |  | S3 | 故障输入下限钳位
U3 | CD40109B | 四路低→高电平转换 #1 | SOIC-16 | 03_DRV | VERIFIED |  | S13 | DIN/CLK/LAT/ALLOW → 12 V 域，输出三态
U4 | CD40109B | 四路低→高电平转换 #2 | SOIC-16 | 03_DRV | VERIFIED |  | S13 | HV_EN_REQ → 12 V 域；其余通道接地
C30 | 100nF/16V | 0.1 µF 16 V | 0603 | 03_DRV | VERIFIED |  | S13 | U3/U4 VCC 旁路
C31 | 100nF/50V | 0.1 µF 50 V | 0603 | 03_DRV | VERIFIED |  | S13 | U3/U4 VDD 旁路
R33 | 10k | 10k 1% | 0603 | 03_DRV | VERIFIED |  | S3 | 12 V 域下拉：驱动未上电/高阻时保持低电平（BL 低=消隐）
R34 | 10k | 10k 1% | 0603 | 03_DRV | VERIFIED |  | S3 | 12 V 域下拉：驱动未上电/高阻时保持低电平（BL 低=消隐）
R35 | 10k | 10k 1% | 0603 | 03_DRV | VERIFIED |  | S3 | 12 V 域下拉：驱动未上电/高阻时保持低电平（BL 低=消隐）
R36 | 10k | 10k 1% | 0603 | 03_DRV | VERIFIED |  | S3 | 12 V 域下拉：驱动未上电/高阻时保持低电平（BL 低=消隐）
R37 | 10k | 10k 1% | 0603 | 03_DRV | VERIFIED |  | S3 | 12 V 域下拉：驱动未上电/高阻时保持低电平（BL 低=消隐）
U5 | LM393DR | 双比较器 #1（EXT12 / 3V3 监控） | SOIC-8 | 03_DRV | VERIFIED |  | S14 | 开漏输出，VCC=3V3
U8 | LM393DR | 双比较器 #2（DRV_VDD / 故障状态） | SOIC-8 | 03_DRV | VERIFIED |  | S14 | 开漏输出，VCC=3V3
U6 | TL431 | 2.5 V 并联基准 | SOT-23 | 03_DRV | VERIFIED |  | S17 | VREF=2.5 V 基准（Ika≈1.18 mA）；DBZ 引脚 1=C/2=REF/3=A
R38 | 680Ω | 680 Ω 1% | 0603 | 03_DRV | VERIFIED |  | S14 | TL431 偏置（(3.3-2.5)/680 = 1.18 mA）
C32 | 100nF/16V | 0.1 µF 16 V | 0603 | 03_DRV | VERIFIED |  | S14 | 基准旁路
C33 | 100nF/16V | 0.1 µF 16 V | 0603 | 03_DRV | VERIFIED |  | S14 | U5 旁路
C34 | 100nF/16V | 0.1 µF 16 V | 0603 | 03_DRV | VERIFIED |  | S14 | U8 旁路
R39 | 100k | 100 kΩ 1% | 0603 | 03_DRV | VERIFIED |  | S14 | EXT12 检测分压上臂 → 门限 10.80 V（=HV5622 VDD 下限）
R40 | 30.1k | 30.1 kΩ 1% | 0603 | 03_DRV | VERIFIED |  | S14 | EXT12 检测分压下臂（2.5 V*(130.1/30.1)=10.80 V）
C35 | 100nF/16V | 0.1 µF 16 V | 0603 | 03_DRV | VERIFIED |  | S14 | EXT12_PG 滤波（约 3 ms）
R41 | 10k | 10 kΩ 1% | 0603 | 03_DRV | VERIFIED |  | S14 | EXT12_PG 上拉
R42 | 10k | 10 kΩ 1% | 0603 | 03_DRV | VERIFIED |  | S14 | 3V3 检测分压上臂 → 门限 3.11 V
R43 | 41.2k | 41.2 kΩ 1% | 0603 | 03_DRV | VERIFIED |  | S14 | 3V3 检测分压下臂（2.5 V*(51.2/41.2)=3.11 V）
C36 | 100nF/16V | 0.1 µF 16 V | 0603 | 03_DRV | VERIFIED |  | S14 | 3V3_PG 滤波
R44 | 10k | 10 kΩ 1% | 0603 | 03_DRV | VERIFIED |  | S14 | 3V3_PG 上拉
R45 | 100k | 100 kΩ 1% | 0603 | 03_DRV | VERIFIED |  | S14 | DRV_VDD 检测分压上臂 → 门限 10.4 V
R46 | 31.6k | 31.6 kΩ 1% | 0603 | 03_DRV | VERIFIED |  | S14 | DRV_VDD 检测分压下臂（2.5 V*(131.6/31.6)=10.41 V）
C37 | 100nF/16V | 0.1 µF 16 V | 0603 | 03_DRV | VERIFIED |  | S14 | DRV_PG 滤波
R47 | 10k | 10 kΩ 1% | 0603 | 03_DRV | VERIFIED |  | S14 | DRV_PG 上拉
R48 | 10k | 10 kΩ 1% | 0603 | 03_DRV | VERIFIED |  | S14 | FAULT_OK 上拉
U7 | 74HC08 | 四路与门 | SOIC-14 | 03_DRV | VERIFIED |  | S15 | DRV_VDD_EN / HV_EN 硬件门控（EXT12_PG×3V3_PG×请求×DRV_PG×无故障）
C38 | 100nF/16V | 0.1 µF 16 V | 0603 | 03_DRV | VERIFIED |  | S15 | U7 旁路
R49 | 100k | 100 kΩ 1% | 0603 | 03_DRV | VERIFIED |  | S15 | HV_EN 下拉 → 上电/复位默认关断
R51 | 100k | 100 kΩ 1% | 0603 | 03_DRV | VERIFIED |  | S3 | HV_EN_REQ 外部下拉 → 上电/复位默认不请求升压
R52 | 100k | 100 kΩ 1% | 0603 | 03_DRV | VERIFIED |  | S3 | DISP_ALLOW 外部下拉 → 上电/复位默认消隐
U21 | HV5622PJ | HV5622 32 路开漏高压驱动 | PQFP-44 | 03_DRV | VERIFIED |  | S5 | 32-bit 移位寄存器 + 32 路 220 V 开漏输出 | S5：VPP 推荐 ≤220 V，绝对最大 230 V；VDD 10.8–13.2 V
C39 | 10uF/25V | 10 µF 25 V X5R | 1206 | 03_DRV | VERIFIED |  | S5 | U21 VDD 储能
C41 | 100nF/50V | 0.1 µF 50 V X7R | 0603 | 03_DRV | VERIFIED |  | S5 | U21 VDD 高频旁路
U22 | HV5622PJ | HV5622 32 路开漏高压驱动 | PQFP-44 | 03_DRV | VERIFIED |  | S5 | 32-bit 移位寄存器 + 32 路 220 V 开漏输出 | S5：VPP 推荐 ≤220 V，绝对最大 230 V；VDD 10.8–13.2 V
C40 | 10uF/25V | 10 µF 25 V X5R | 1206 | 03_DRV | VERIFIED |  | S5 | U22 VDD 储能
C42 | 100nF/50V | 0.1 µF 50 V X7R | 0603 | 03_DRV | VERIFIED |  | S5 | U22 VDD 高频旁路
J31 | J13-1A-SOCKET | 13 脚可拆管座 (QS30-1) | 13P socket | 05_TUBE | HOLD |  | S6 | 管座焊脚坐标/孔径/视图未实测，封装为 PROVISIONAL | H03：J13-1A 尺寸/触点/1 脚视图/1:1 比对
R90 | 10k 2W | 10 kΩ 2 W 厚膜 | 2512 | 05_TUBE | PROVISIONAL |  | S6 | J_T1 阳极限流电阻 1/2（20 kΩ/2 W 支路） | H06：故障耗散 1.45 W 需实测/降额
R91 | 10k 2W | 10 kΩ 2 W 厚膜 | 2512 | 05_TUBE | PROVISIONAL |  | S6 | J_T1 阳极限流电阻 2/2 | H06
J32 | J13-1A-SOCKET | 13 脚可拆管座 (QS30-1) | 13P socket | 05_TUBE | HOLD |  | S6 | 管座焊脚坐标/孔径/视图未实测，封装为 PROVISIONAL | H03：J13-1A 尺寸/触点/1 脚视图/1:1 比对
R92 | 10k 2W | 10 kΩ 2 W 厚膜 | 2512 | 05_TUBE | PROVISIONAL |  | S6 | J_T2 阳极限流电阻 1/2（20 kΩ/2 W 支路） | H06：故障耗散 1.45 W 需实测/降额
R93 | 10k 2W | 10 kΩ 2 W 厚膜 | 2512 | 05_TUBE | PROVISIONAL |  | S6 | J_T2 阳极限流电阻 2/2 | H06
J33 | J13-1A-SOCKET | 13 脚可拆管座 (QS30-1) | 13P socket | 05_TUBE | HOLD |  | S6 | 管座焊脚坐标/孔径/视图未实测，封装为 PROVISIONAL | H03：J13-1A 尺寸/触点/1 脚视图/1:1 比对
R94 | 10k 2W | 10 kΩ 2 W 厚膜 | 2512 | 05_TUBE | PROVISIONAL |  | S6 | J_T3 阳极限流电阻 1/2（20 kΩ/2 W 支路） | H06：故障耗散 1.45 W 需实测/降额
R95 | 10k 2W | 10 kΩ 2 W 厚膜 | 2512 | 05_TUBE | PROVISIONAL |  | S6 | J_T3 阳极限流电阻 2/2 | H06
J34 | J13-1A-SOCKET | 13 脚可拆管座 (QS30-1) | 13P socket | 05_TUBE | HOLD |  | S6 | 管座焊脚坐标/孔径/视图未实测，封装为 PROVISIONAL | H03：J13-1A 尺寸/触点/1 脚视图/1:1 比对
R96 | 10k 2W | 10 kΩ 2 W 厚膜 | 2512 | 05_TUBE | PROVISIONAL |  | S6 | J_T4 阳极限流电阻 1/2（20 kΩ/2 W 支路） | H06：故障耗散 1.45 W 需实测/降额
R97 | 10k 2W | 10 kΩ 2 W 厚膜 | 2512 | 05_TUBE | PROVISIONAL |  | S6 | J_T4 阳极限流电阻 2/2 | H06
J35 | J13-1A-SOCKET | 13 脚可拆管座 (QS30-1) | 13P socket | 05_TUBE | HOLD |  | S6 | 管座焊脚坐标/孔径/视图未实测，封装为 PROVISIONAL | H03：J13-1A 尺寸/触点/1 脚视图/1:1 比对
R98 | 10k 2W | 10 kΩ 2 W 厚膜 | 2512 | 05_TUBE | PROVISIONAL |  | S6 | J_T5 阳极限流电阻 1/2（20 kΩ/2 W 支路） | H06：故障耗散 1.45 W 需实测/降额
R99 | 10k 2W | 10 kΩ 2 W 厚膜 | 2512 | 05_TUBE | PROVISIONAL |  | S6 | J_T5 阳极限流电阻 2/2 | H06
J36 | J13-1A-SOCKET | 13 脚可拆管座 (QS30-1) | 13P socket | 05_TUBE | HOLD |  | S6 | 管座焊脚坐标/孔径/视图未实测，封装为 PROVISIONAL | H03：J13-1A 尺寸/触点/1 脚视图/1:1 比对
R100 | 10k 2W | 10 kΩ 2 W 厚膜 | 2512 | 05_TUBE | PROVISIONAL |  | S6 | J_T6 阳极限流电阻 1/2（20 kΩ/2 W 支路） | H06：故障耗散 1.45 W 需实测/降额
R101 | 10k 2W | 10 kΩ 2 W 厚膜 | 2512 | 05_TUBE | PROVISIONAL |  | S6 | J_T6 阳极限流电阻 2/2 | H06
Q26 | DMP3098L | P-MOSFET 30 V/3.8 A | SOT-23 | 04_HV | PROVISIONAL |  | S16 | 升压输入高边开关（HV_EN 硬件门控，默认关断） | H06
R87 | 100k | 100 kΩ 1% | 0603 | 04_HV | VERIFIED |  | S16 | Q26 栅极上拉 → 默认关断
R88 | 100Ω | 100 Ω 1% | 0603 | 04_HV | VERIFIED |  | S16 | Q27 栅极串联电阻
Q27 | 2N7002 | N-MOSFET 60 V | SOT-23 | 04_HV | VERIFIED |  | S16 | Q26 栅极驱动
R89 | 100k | 100 kΩ 1% | 0603 | 04_HV | VERIFIED |  | S16 | Q27 栅极下拉 → HV_EN 悬空时关断
C43 | 10uF/25V | 10 µF 25 V X5R | 1206 | 04_HV | VERIFIED |  | S16 | HV_IN 输入储能
U20 | UC3843AN | UC3843 电流型 PWM 控制器 | DIP-8/SOIC-8 | 04_HV | VERIFIED |  | S17 | 升压控制器，fsw≈78 kHz，峰值电流限制≈1 A | H06：开关频率/占空比/环路待实测
R60 | 10Ω | 10 Ω 1% | 0805 | 04_HV | VERIFIED |  | S17 | VCC 滤波电阻
C44 | 10uF/25V | 10 µF 25 V X5R | 1206 | 04_HV | VERIFIED |  | S17 | VCC_HV 储能
C45 | 100nF/25V | 0.1 µF 25 V | 0603 | 04_HV | VERIFIED |  | S17 | VCC_HV 高频旁路
C46 | 100nF/16V | 0.1 µF 16 V | 0603 | 04_HV | VERIFIED |  | S17 | VREF 旁路
R61 | 10k | 10 kΩ 1% | 0603 | 04_HV | VERIFIED |  | S17 | RT（f≈1.72/(RT·CT)=78 kHz）
C47 | 2.2nF/50V | 2.2 nF 50 V | 0603 | 04_HV | VERIFIED |  | S17 | CT
R62 | 1Ω 1W | 1 Ω 1 W 合金采样 | 2512 | 04_HV | PROVISIONAL |  | S17 | 峰值电流采样（1 V 门限 → 1 A） | H06
R63 | 100Ω | 100 Ω 1% | 0603 | 04_HV | VERIFIED |  | S17 | CS 滤波电阻
C48 | 470pF/50V | 470 pF 50 V | 0603 | 04_HV | VERIFIED |  | S17 | CS 前沿消隐滤波（τ≈47 ns）
R64 | 22Ω | 22 Ω 1% | 0603 | 04_HV | VERIFIED |  | S17 | MOSFET 栅极串联电阻
R65 | 10k | 10 kΩ 1% | 0603 | 04_HV | VERIFIED |  | S17 | MOSFET 栅极下拉
Q20 | IRF740 | N-MOSFET 400 V/10 A | TO-220 | 04_HV | VERIFIED |  | S18 | 升压主开关（400 V 器件，Vds 峰值≈172 V+振铃） | H06：需实测 Vds 振铃/温升/雪崩
L20 | 220uH/5A | 220 µH ≥5 A 功率电感（Isat≥5A） | 12x12 屏蔽 | 04_HV | PROVISIONAL |  | S17 | 升压电感，Isat≥2 A，DCR 尽量低 | H06：ΔI≈0.65 A @78 kHz
D20 | UF4007 | 1000 V 1 A 快恢复 | SMA/DO-41 | 04_HV | VERIFIED |  | S17 | 升压整流二极管（反压 172 V，1000 V 额定）
D21 | UF4007 | 1000 V 1 A 快恢复 | SMA/DO-41 | 04_HV | VERIFIED |  | S17 | RCD 钳位二极管
C49 | 10nF/630V | 10 nF 630 V X7R | 1206 | 04_HV | VERIFIED |  | S17 | RCD 钳位电容
R66 | 100k 2W | 100 kΩ 2 W | 2512 | 04_HV | PROVISIONAL |  | S17 | RCD 钳位电阻 | H06
C50 | 10uF/250V | 10 µF 250 V 电解 | 10x12.5 SMD | 04_HV | PROVISIONAL |  | S17 | HV_BUS 储能 | H06
C51 | 10uF/250V | 10 µF 250 V 电解 | 10x12.5 SMD | 04_HV | PROVISIONAL |  | S17 | HV_BUS 储能 | H06
C52 | 100nF/630V | 0.1 µF 630 V | 1206 | 04_HV | VERIFIED |  | S17 | HV_BUS 高频旁路
R67 | 100k | 100 kΩ 1% | 1206 | 04_HV | VERIFIED |  | S17 | HV 泄放电阻 1/2
R68 | 100k | 100 kΩ 1% | 1206 | 04_HV | VERIFIED |  | S17 | HV 泄放电阻 2/2（合计 200 kΩ，τ≈4.0 s）
C53 | 100nF/50V | 0.1 µF 50 V | 0603 | 04_HV | VERIFIED |  | S17 | HV 泄放交流旁路
R69 | 750k | 750 kΩ 1% | 1206 | 04_HV | VERIFIED |  | S17 | HV 反馈上臂 1/2
R70 | 750k | 750 kΩ 1% | 1206 | 04_HV | VERIFIED |  | S17 | HV 反馈上臂 2/2
R71 | 22.1k | 22.1 kΩ 1% | 0603 | 04_HV | VERIFIED |  | S17 | HV 反馈下臂 → Vout=172.2 V
C54 | 100nF/50V | 0.1 µF 50 V | 0603 | 04_HV | VERIFIED |  | S17 | 反馈滤波
C55 | 22uF/16V | 22 µF 16 V X5R | 0805 | 04_HV | VERIFIED |  | S17 | COMP 软启动电容（≈50 ms）
R72 | 10k | 10 kΩ 1% | 0603 | 04_HV | VERIFIED |  | S17 | 环路补偿零极点电阻
C56 | 100nF/16V | 0.1 µF 16 V | 0603 | 04_HV | VERIFIED |  | S17 | 环路补偿电容
U23 | LM393DR | OVP 比较器 | SOIC-8 | 04_HV | VERIFIED |  | S19 | 独立于 MCU 的过压检测（门限 198.8 V）
U24 | TL431 | 2.5 V 基准 | SOT-23 | 04_HV | VERIFIED |  | S17 | OVP 基准（2.5 V），DBZ 1=C/2=REF/3=A
R74 | 4.7k | 4.7 kΩ 1% | 0603 | 04_HV | VERIFIED |  | S19 | OVP 基准偏置（(12-2.5)/4.7k≈2 mA）
C57 | 100nF/16V | 0.1 µF 16 V | 0603 | 04_HV | VERIFIED |  | S19 | OVP 基准旁路
R75 | 750k | 750 kΩ 1% | 1206 | 04_HV | VERIFIED |  | S19 | OVP 取样上臂 1/2
R76 | 750k | 750 kΩ 1% | 1206 | 04_HV | VERIFIED |  | S19 | OVP 取样上臂 2/2
R77 | 19.1k | 19.1 kΩ 1% | 0603 | 04_HV | VERIFIED |  | S19 | OVP 取样下臂 → 触发电压 2.5 V*(1519.1/19.1)=198.8 V
C58 | 100nF/50V | 0.1 µF 50 V | 0603 | 04_HV | VERIFIED |  | S19 | OVP 取样滤波（响应 τ≈2 ms）
R78 | 10k | 10 kΩ 1% | 0603 | 04_HV | VERIFIED |  | S19 | OVP_SET 上拉
C59 | 100nF/25V | 0.1 µF 25 V | 0603 | 04_HV | VERIFIED |  | S19 | OVP 比较器旁路
Q21 | MMBT3906 | PNP 40 V | SOT-23 | 04_HV | VERIFIED |  | S19 | 锁存 SCR 上半（PNP）
Q22 | MMBT3904 | NPN 40 V | SOT-23 | 04_HV | VERIFIED |  | S19 | 锁存 SCR 下半（NPN）
R79 | 100k | 100 kΩ 1% | 0603 | 04_HV | VERIFIED |  | S19 | 锁存初始关断偏置
R80 | 10k | 10 kΩ 1% | 0603 | 04_HV | VERIFIED |  | S19 | OVP_SET → 锁存置位注入
R81 | 100k | 100 kΩ 1% | 0603 | 04_HV | VERIFIED |  | S19 | OVP_LATCH 关断偏置
C60 | 100nF/25V | 0.1 µF 25 V | 0603 | 04_HV | VERIFIED |  | S19 | 锁存抗干扰
Q23 | MMBT3904 | NPN 40 V | SOT-23 | 04_HV | VERIFIED |  | S19 | 锁存 → 拉低 COMP，强制占空比 0
R82 | 47k | 47 kΩ 1% | 0603 | 04_HV | VERIFIED |  | S19 | Q23 基极电阻
Q24 | MMBT3904 | NPN 40 V | SOT-23 | 04_HV | VERIFIED |  | S19 | 锁存 → 拉低 HV_FAULT_N（低有效故障）
R83 | 47k | 47 kΩ 1% | 0603 | 04_HV | VERIFIED |  | S19 | Q24 基极电阻
R84 | 100k | 100 kΩ 1% | 0603 | 04_HV | VERIFIED |  | S19 | HV_FAULT_OD 上拉至 DRV_VDD（失电时被下拉为故障态）
Q25 | 2N7002 | N-MOSFET 60 V | SOT-23 | 04_HV | VERIFIED |  | S19 | 锁存复位开关（MCU GPIO18 脉冲高有效）
R85 | 1k | 1 kΩ 1% | 0603 | 04_HV | VERIFIED |  | S19 | OVP_RST 栅极串联电阻
R86 | 100k | 100 kΩ 1% | 0603 | 04_HV | VERIFIED |  | S19 | OVP_RST 栅极下拉 → 默认不复位
C61 | 100nF/16V | 0.1 µF 16 V | 0603 | 04_HV | VERIFIED |  | S19 | OVP_RST 抗干扰
TP1 | TP-EXT12 | 测试点 EXT12 | 1.0mm pad | 06_TP | VERIFIED |  | S20 | 12 V 保护后输入
TP2 | TP-EXT5 | 测试点 EXT5 | 1.0mm pad | 06_TP | VERIFIED |  | S20 | 12V->5V 输出
TP3 | TP-5V_SYS | 测试点 5V_SYS | 1.0mm pad | 06_TP | VERIFIED |  | S20 | 5 V 电源选择输出
TP4 | TP-3V3 | 测试点 3V3 | 1.0mm pad | 06_TP | VERIFIED |  | S20 | 3.3 V 主电源
TP5 | TP-DRV_VDD | 测试点 DRV_VDD | 1.0mm pad | 06_TP | VERIFIED |  | S20 | HV5622 逻辑电源 12 V
TP6 | TP-HV_BUS | 测试点 HV_BUS | 1.0mm pad | 06_TP | VERIFIED |  | S20 | 170 V 高压母线
TP7 | TP-GND | 测试点 GND | 1.0mm pad | 06_TP | VERIFIED |  | S20 | 地
TP8 | TP-EN_MCU | 测试点 EN_MCU | 1.0mm pad | 06_TP | VERIFIED |  | S20 | 模组 EN
TP9 | TP-BOOT_N | 测试点 BOOT_N | 1.0mm pad | 06_TP | VERIFIED |  | S20 | GPIO0/BOOT
TP10 | TP-UART0_TX | 测试点 UART0_TX | 1.0mm pad | 06_TP | VERIFIED |  | S20 | UART0 TX
TP11 | TP-UART0_RX | 测试点 UART0_RX | 1.0mm pad | 06_TP | VERIFIED |  | S20 | UART0 RX
TP12 | TP-HV_SENSE_ADC | 测试点 HV_SENSE_ADC | 1.0mm pad | 06_TP | VERIFIED |  | S20 | HV 分压 ADC 节点
TP13 | TP-HVF_NODE | 测试点 HVF_NODE | 1.0mm pad | 06_TP | VERIFIED |  | S20 | 故障检测节点
TP14 | TP-EXT12_PG | 测试点 EXT12_PG | 1.0mm pad | 06_TP | VERIFIED |  | S20 | 12 V 电源良好
TP15 | TP-P3V3_PG | 测试点 P3V3_PG | 1.0mm pad | 06_TP | VERIFIED |  | S20 | 3.3 V 电源良好
TP16 | TP-DRV_PG | 测试点 DRV_PG | 1.0mm pad | 06_TP | VERIFIED |  | S20 | DRV_VDD 电源良好
TP17 | TP-HV_EN | 测试点 HV_EN | 1.0mm pad | 06_TP | VERIFIED |  | S20 | 高压使能（门控后）
TP18 | TP-DRV_HV_EN_REQ | 测试点 DRV_HV_EN_REQ | 1.0mm pad | 06_TP | VERIFIED |  | S20 | 12 V 域高压请求
TP19 | TP-OVP_LATCH | 测试点 OVP_LATCH | 1.0mm pad | 06_TP | VERIFIED |  | S20 | 过压锁存状态
TP20 | TP-DRV2_DOUT | 测试点 DRV2_DOUT | 1.0mm pad | 06_TP | VERIFIED |  | S20 | HV5622 级联数据输出
J4 | HDR-1x6-2.54 | 扩展接口 1x6 | 2.54mm | 06_TP | VERIFIED |  | S3 | 3V3/GND/IO13/IO21/I2C（未承诺接口）
