langxie29-cpu/QS30-driver/bom/QS30-6_REV.A_BOM_qty.csv

mpn_or_value | value | package | status | qty_populated | refs_populated | refs_dnp
100k | 100 kΩ 1% | 0603 | VERIFIED | 17 | R1 R3 R5 R6 R8 R10 R39 R45 R49 R51 R52 R87 R89 R79 R81 R84 R86
10k | 10 kΩ 1% | 0603 | VERIFIED | 16 | R11 R12 R13 R21 R22 R23 R41 R42 R44 R47 R48 R61 R65 R72 R78 R80
100nF/16V | 0.1 µF 16 V | 0603 | VERIFIED | 13 | C29 C30 C32 C33 C34 C35 C36 C37 C38 C46 C56 C57 C61
10k 2W | 10 kΩ 2 W 厚膜 | 2512 | PROVISIONAL | 12 | R90 R91 R92 R93 R94 R95 R96 R97 R98 R99 R100 R101
100nF/16V | 0.1 µF 16 V X7R | 0603 | VERIFIED | 8 | C7 C9 C12 C22 C25 C26 C27 C28
10uF/25V | 10 µF 25 V X5R | 1206 | VERIFIED | 6 | C4 C13 C39 C40 C43 C44
J13-1A-SOCKET | 13 脚可拆管座 (QS30-1) | 13P socket | HOLD | 6 | J31 J32 J33 J34 J35 J36
100nF/50V | 0.1 µF 50 V X7R | 0603 | VERIFIED | 5 | C3 C5 C14 C41 C42
10k | 10k 1% | 0603 | VERIFIED | 5 | R33 R34 R35 R36 R37
100nF/50V | 0.1 µF 50 V | 0603 | VERIFIED | 4 | C31 C53 C54 C58
750k | 750 kΩ 1% | 1206 | VERIFIED | 4 | R69 R70 R75 R76
BAT54 | 肖特基 30 V | SOD-323 | VERIFIED | 4 | D5 D6 D7 D8
100nF/25V | 0.1 µF 25 V | 0603 | VERIFIED | 3 | C45 C59 C60
100Ω | 100 Ω 1% | 0603 | VERIFIED | 3 | R9 R88 R63
2N7002 | N-MOSFET 60 V | SOT-23 | VERIFIED | 3 | Q2 Q27 Q25
MMBT3904 | NPN 40 V | SOT-23 | VERIFIED | 3 | Q22 Q23 Q24
100k | 100 kΩ 1% | 1206 | VERIFIED | 2 | R67 R68
10uF/250V | 10 µF 250 V 电解 | 10x12.5 SMD | PROVISIONAL | 2 | C50 C51
1M | 1 MΩ 1% 1206 | 1206 | PROVISIONAL | 2 | R27 R28
1k | 1 kΩ 1% | 0603 | VERIFIED | 2 | R24 R85
1uF/16V | 1 µF 16 V X7R | 0603 | VERIFIED | 2 | C19 C21
22.1k | 22.1 kΩ 1% | 0603 | VERIFIED | 2 | R7 R71
22uF/10V | 22 µF 10 V X5R | 0805 | VERIFIED | 2 | C6 C8
22Ω | 22 Ω 1% | 0402 | PROVISIONAL | 2 | R17 R18
47k | 47 kΩ 1% | 0603 | VERIFIED | 2 | R82 R83
5.1k | 5.1 kΩ 1% | 0603 | VERIFIED | 2 | R14 R15
DMP3098L | P-MOSFET 30 V/3.8 A | SOT-23 | PROVISIONAL | 2 | Q1 Q26
HV5622PJ | HV5622 32 路开漏高压驱动 | PQFP-44 | VERIFIED | 2 | U21 U22
SS14 | 40 V 1 A 肖特基 | SMA | VERIFIED | 2 | D3 D4
UF4007 | 1000 V 1 A 快恢复 | SMA/DO-41 | VERIFIED | 2 | D20 D21
100k | 100 kΩ 1% | 0603 | PROVISIONAL | 1 | R31
100k 2W | 100 kΩ 2 W | 2512 | PROVISIONAL | 1 | R66
100nF | 100nF 16V | 0603 | VERIFIED | 1 | C18
100nF/630V | 0.1 µF 630 V | 1206 | VERIFIED | 1 | C52
100uF/25V | 100 µF 25 V 电解 | 8x10.5 SMD | VERIFIED | 1 | C1
10nF/630V | 10 nF 630 V X7R | 1206 | VERIFIED | 1 | C49
10uF/10V | 10 µF 10 V X5R | 0805 | VERIFIED | 1 | C10
10uH/3A | 10 µH 3 A 屏蔽功率电感 | 0630 | PROVISIONAL | 1 | L1
10Ω | 10 Ω 1% | 0805 | VERIFIED | 1 | R60
13.3k | 13.3 kΩ 1% | 0603 | VERIFIED | 1 | R4
19.1k | 19.1 kΩ 1% | 0603 | VERIFIED | 1 | R77
1M | 1 MΩ 1% | 0603 | VERIFIED | 1 | R16
1k | 1 kΩ 1% | 0603 | PROVISIONAL | 1 | R30
1uF | 1uF 16V | 0603 | VERIFIED | 1 | C17
1uF/50V | 1 µF 50 V X7R | 1206 | VERIFIED | 1 | C2
1Ω 1W | 1 Ω 1 W 合金采样 | 2512 | PROVISIONAL | 1 | R62
2.2nF/50V | 2.2 nF 50 V | 0603 | VERIFIED | 1 | C47
2.2uH/3A | 2.2 µH 3 A 屏蔽功率电感 | 0520 | PROVISIONAL | 1 | L2
20k | 20 kΩ 1% | 0805 | PROVISIONAL | 1 | R29
220uH/5A | 220 µH ≥5 A 功率电感（Isat≥5A） | 12x12 屏蔽 | PROVISIONAL | 1 | L20
22uF | 22uF 6.3V | 0805 | VERIFIED | 1 | C16
22uF/16V | 22 µF 16 V X5R | 0805 | VERIFIED | 1 | C55
22uF/6.3V | 22 µF 6.3 V X5R | 0805 | VERIFIED | 1 | C11
22Ω | 22 Ω 1% | 0603 | VERIFIED | 1 | R64
30.1k | 30.1 kΩ 1% | 0603 | VERIFIED | 1 | R40
31.6k | 31.6 kΩ 1% | 0603 | VERIFIED | 1 | R46
33k | 33 kΩ 1% | 0603 | VERIFIED | 1 | R2
36.5k | 36.5 kΩ 1% | 0603 | PROVISIONAL | 1 | R32
4.7k | 4.7 kΩ 1% | 0603 | VERIFIED | 1 | R74 | R25 R26
4.7nF/50V | 4.7 nF 50 V X7R | 0603 | VERIFIED | 1 | C20
41.2k | 41.2 kΩ 1% | 0603 | VERIFIED | 1 | R43
470pF/50V | 470 pF 50 V | 0603 | VERIFIED | 1 | C48
499Ω | 499 Ω 1% | 0603 | VERIFIED | 1 | R19
680Ω | 680 Ω 1% | 0603 | VERIFIED | 1 | R38
74HC08 | 四路与门 | SOIC-14 | VERIFIED | 1 | U7
CD40109B | 四路低→高电平转换 #1 | SOIC-16 | VERIFIED | 1 | U3
CD40109B | 四路低→高电平转换 #2 | SOIC-16 | VERIFIED | 1 | U4
DC-005-5.08-2P | DC12 IN 5.08mm 2P | TERM-2 | PROVISIONAL | 1 | J1
ESP32-S3-WROOM-1-N8 | ESP32-S3 8MB Flash 无 PSRAM | WROOM-1 41pad | VERIFIED | 1 | U10
HDR-1x6-2.54 | UART0 恢复排针 1x6 | 2.54mm | VERIFIED | 1 | J3
HDR-1x6-2.54 | 扩展接口 1x6 | 2.54mm | VERIFIED | 1 | J4
IRF740 | N-MOSFET 400 V/10 A | TO-220 | VERIFIED | 1 | Q20
LM393DR | 双比较器 #1（EXT12 / 3V3 监控） | SOIC-8 | VERIFIED | 1 | U5
LM393DR | 双比较器 #2（DRV_VDD / 故障状态） | SOIC-8 | VERIFIED | 1 | U8
LM393DR | OVP 比较器 | SOIC-8 | VERIFIED | 1 | U23
LTST-C190KRKT | 红色 LED | 0603 | VERIFIED | 1 | LED1
MMBT3906 | PNP 40 V | SOT-23 | VERIFIED | 1 | Q21
PPTC-1.5A-1812 | 1.5 A 自恢复保险丝 | 1812 | PROVISIONAL | 1 | F1
SMBJ16A | TVS 16 V 单向 | SMB | PROVISIONAL | 1 | D1
SS54 | 40 V 5 A 肖特基 | SMB | VERIFIED | 1 | D2
SY8089AAAC | SY8089A 5V->3.3V 2A | SOT-23-5 | VERIFIED | 1 | U2
TL431 | 2.5 V 并联基准 | SOT-23 | VERIFIED | 1 | U6
TL431 | 2.5 V 基准 | SOT-23 | VERIFIED | 1 | U24
TP-3V3 | 测试点 3V3 | 1.0mm pad | VERIFIED | 1 | TP4
TP-5V_SYS | 测试点 5V_SYS | 1.0mm pad | VERIFIED | 1 | TP3
TP-BOOT_N | 测试点 BOOT_N | 1.0mm pad | VERIFIED | 1 | TP9
TP-DRV2_DOUT | 测试点 DRV2_DOUT | 1.0mm pad | VERIFIED | 1 | TP20
TP-DRV_HV_EN_REQ | 测试点 DRV_HV_EN_REQ | 1.0mm pad | VERIFIED | 1 | TP18
TP-DRV_PG | 测试点 DRV_PG | 1.0mm pad | VERIFIED | 1 | TP16
TP-DRV_VDD | 测试点 DRV_VDD | 1.0mm pad | VERIFIED | 1 | TP5
TP-EN_MCU | 测试点 EN_MCU | 1.0mm pad | VERIFIED | 1 | TP8
TP-EXT12 | 测试点 EXT12 | 1.0mm pad | VERIFIED | 1 | TP1
TP-EXT12_PG | 测试点 EXT12_PG | 1.0mm pad | VERIFIED | 1 | TP14
TP-EXT5 | 测试点 EXT5 | 1.0mm pad | VERIFIED | 1 | TP2
TP-GND | 测试点 GND | 1.0mm pad | VERIFIED | 1 | TP7
TP-HVF_NODE | 测试点 HVF_NODE | 1.0mm pad | VERIFIED | 1 | TP13
TP-HV_BUS | 测试点 HV_BUS | 1.0mm pad | VERIFIED | 1 | TP6
TP-HV_EN | 测试点 HV_EN | 1.0mm pad | VERIFIED | 1 | TP17
TP-HV_SENSE_ADC | 测试点 HV_SENSE_ADC | 1.0mm pad | VERIFIED | 1 | TP12
TP-OVP_LATCH | 测试点 OVP_LATCH | 1.0mm pad | VERIFIED | 1 | TP19
TP-P3V3_PG | 测试点 P3V3_PG | 1.0mm pad | VERIFIED | 1 | TP15
TP-UART0_RX | 测试点 UART0_RX | 1.0mm pad | VERIFIED | 1 | TP11
TP-UART0_TX | 测试点 UART0_TX | 1.0mm pad | VERIFIED | 1 | TP10
TPS54202DDCR | TPS54202 12V->5.0V 2A | SOT-23-6 | VERIFIED | 1 | U1
TS-1187A | 复位按键 | 4P 6x6 SMD | PROVISIONAL | 1 | SW1
TS-1187A | BOOT 按键 | 4P 6x6 SMD | PROVISIONAL | 1 | SW2
TS-1187A | SET 按键 | 4P 6x6 SMD | PROVISIONAL | 1 | SW3
TS-1187A | PLUS 按键 | 4P 6x6 SMD | PROVISIONAL | 1 | SW4
TS-1187A | MINUS 按键 | 4P 6x6 SMD | PROVISIONAL | 1 | SW5
UC3843AN | UC3843 电流型 PWM 控制器 | DIP-8/SOIC-8 | VERIFIED | 1 | U20
USB-C-16P-2.0 | USB-C 母座 16P USB2.0 | SMD 16P | PROVISIONAL | 1 | J2
USBLC6-2SC6 | USB ESD 保护 | SOT-23-6 | VERIFIED | 1 | U11
0Ω | 0 Ω | 0603 | VERIFIED | 0 |  | R20
10pF/50V | 10 pF 50 V | 0402 | PROVISIONAL | 0 |  | C23 C24
