langxie29-cpu/QS30-driver/netlist/QS30-6_REV.A_netlist.csv

ref | mpn | value | package | sheet | pin | pin_name | net | net_class | part_status | population | source | note
J1 | DC-005-5.08-2P | DC12 IN 5.08mm 2P | TERM-2 | 01_PWR | 1 | 1 | EXT12_RAW | POWER | PROVISIONAL |  | D4 | H05/H07
J1 | DC-005-5.08-2P | DC12 IN 5.08mm 2P | TERM-2 | 01_PWR | 2 | 2 | GND | GND | PROVISIONAL |  | D4 | H05/H07
F1 | PPTC-1.5A-1812 | 1.5 A 自恢复保险丝 | 1812 | 01_PWR | 1 | 1 | EXT12_RAW | POWER | PROVISIONAL |  | D4 | H05
F1 | PPTC-1.5A-1812 | 1.5 A 自恢复保险丝 | 1812 | 01_PWR | 2 | 2 | EXT12_F | POWER | PROVISIONAL |  | D4 | H05
D1 | SMBJ16A | TVS 16 V 单向 | SMB | 01_PWR | 1 | K | EXT12_F | POWER | PROVISIONAL |  | D4 | H05
D1 | SMBJ16A | TVS 16 V 单向 | SMB | 01_PWR | 2 | A | GND | GND | PROVISIONAL |  | D4 | H05
D2 | SS54 | 40 V 5 A 肖特基 | SMB | 01_PWR | 1 | K | EXT12 | POWER | VERIFIED |  | D4 | H05：如需低压降可改理想二极管
D2 | SS54 | 40 V 5 A 肖特基 | SMB | 01_PWR | 2 | A | EXT12_F | POWER | VERIFIED |  | D4 | H05：如需低压降可改理想二极管
C1 | 100uF/25V | 100 µF 25 V 电解 | 8x10.5 SMD | 01_PWR | 1 | 1 | EXT12 | POWER | VERIFIED |  | D4
C1 | 100uF/25V | 100 µF 25 V 电解 | 8x10.5 SMD | 01_PWR | 2 | 2 | GND | GND | VERIFIED |  | D4
C2 | 1uF/50V | 1 µF 50 V X7R | 1206 | 01_PWR | 1 | 1 | EXT12 | POWER | VERIFIED |  | D4
C2 | 1uF/50V | 1 µF 50 V X7R | 1206 | 01_PWR | 2 | 2 | GND | GND | VERIFIED |  | D4
C3 | 100nF/50V | 0.1 µF 50 V X7R | 0603 | 01_PWR | 1 | 1 | EXT12 | POWER | VERIFIED |  | D4
C3 | 100nF/50V | 0.1 µF 50 V X7R | 0603 | 01_PWR | 2 | 2 | GND | GND | VERIFIED |  | D4
U1 | TPS54202DDCR | TPS54202 12V->5.0V 2A | SOT-23-6 | 01_PWR | 1 | GND | GND | GND | VERIFIED |  | S8 | H05：纹波/温升/EMI 待测
U1 | TPS54202DDCR | TPS54202 12V->5.0V 2A | SOT-23-6 | 01_PWR | 2 | SW | SW_U1 | SIGNAL | VERIFIED |  | S8 | H05：纹波/温升/EMI 待测
U1 | TPS54202DDCR | TPS54202 12V->5.0V 2A | SOT-23-6 | 01_PWR | 3 | VIN | EXT12 | POWER | VERIFIED |  | S8 | H05：纹波/温升/EMI 待测
U1 | TPS54202DDCR | TPS54202 12V->5.0V 2A | SOT-23-6 | 01_PWR | 4 | FB | FB_U1 | SIGNAL | VERIFIED |  | S8 | H05：纹波/温升/EMI 待测
U1 | TPS54202DDCR | TPS54202 12V->5.0V 2A | SOT-23-6 | 01_PWR | 5 | EN | EN_U1 | SIGNAL | VERIFIED |  | S8 | H05：纹波/温升/EMI 待测
U1 | TPS54202DDCR | TPS54202 12V->5.0V 2A | SOT-23-6 | 01_PWR | 6 | BOOT | BOOT_U1 | SIGNAL | VERIFIED |  | S8 | H05：纹波/温升/EMI 待测
R1 | 100k | 100 kΩ 1% | 0603 | 01_PWR | 1 | 1 | EXT12 | POWER | VERIFIED |  | S8
R1 | 100k | 100 kΩ 1% | 0603 | 01_PWR | 2 | 2 | EN_U1 | SIGNAL | VERIFIED |  | S8
R2 | 33k | 33 kΩ 1% | 0603 | 01_PWR | 1 | 1 | EN_U1 | SIGNAL | VERIFIED |  | S8
R2 | 33k | 33 kΩ 1% | 0603 | 01_PWR | 2 | 2 | GND | GND | VERIFIED |  | S8
C4 | 10uF/25V | 10 µF 25 V X5R | 1206 | 01_PWR | 1 | 1 | EXT12 | POWER | VERIFIED |  | S8
C4 | 10uF/25V | 10 µF 25 V X5R | 1206 | 01_PWR | 2 | 2 | GND | GND | VERIFIED |  | S8
C5 | 100nF/50V | 0.1 µF 50 V X7R | 0603 | 01_PWR | 1 | 1 | BOOT_U1 | SIGNAL | VERIFIED |  | S8
C5 | 100nF/50V | 0.1 µF 50 V X7R | 0603 | 01_PWR | 2 | 2 | SW_U1 | SIGNAL | VERIFIED |  | S8
L1 | 10uH/3A | 10 µH 3 A 屏蔽功率电感 | 0630 | 01_PWR | 1 | 1 | SW_U1 | SIGNAL | PROVISIONAL |  | S8
L1 | 10uH/3A | 10 µH 3 A 屏蔽功率电感 | 0630 | 01_PWR | 2 | 2 | EXT5 | POWER | PROVISIONAL |  | S8
R3 | 100k | 100 kΩ 1% | 0603 | 01_PWR | 1 | 1 | EXT5 | POWER | VERIFIED |  | S8
R3 | 100k | 100 kΩ 1% | 0603 | 01_PWR | 2 | 2 | FB_U1 | SIGNAL | VERIFIED |  | S8
R4 | 13.3k | 13.3 kΩ 1% | 0603 | 01_PWR | 1 | 1 | FB_U1 | SIGNAL | VERIFIED |  | S8
R4 | 13.3k | 13.3 kΩ 1% | 0603 | 01_PWR | 2 | 2 | GND | GND | VERIFIED |  | S8
C6 | 22uF/10V | 22 µF 10 V X5R | 0805 | 01_PWR | 1 | 1 | EXT5 | POWER | VERIFIED |  | S8
C6 | 22uF/10V | 22 µF 10 V X5R | 0805 | 01_PWR | 2 | 2 | GND | GND | VERIFIED |  | S8
C7 | 100nF/16V | 0.1 µF 16 V X7R | 0603 | 01_PWR | 1 | 1 | EXT5 | POWER | VERIFIED |  | S8
C7 | 100nF/16V | 0.1 µF 16 V X7R | 0603 | 01_PWR | 2 | 2 | GND | GND | VERIFIED |  | S8
D3 | SS14 | 40 V 1 A 肖特基 | SMA | 01_PWR | 1 | K | 5V_SYS | POWER | VERIFIED |  | S9 | H05：候选 B 为理想二极管 IC，本图为参考实现
D3 | SS14 | 40 V 1 A 肖特基 | SMA | 01_PWR | 2 | A | EXT5 | POWER | VERIFIED |  | S9 | H05：候选 B 为理想二极管 IC，本图为参考实现
D4 | SS14 | 40 V 1 A 肖特基 | SMA | 01_PWR | 1 | K | 5V_SYS | POWER | VERIFIED |  | S9
D4 | SS14 | 40 V 1 A 肖特基 | SMA | 01_PWR | 2 | A | VBUS | POWER | VERIFIED |  | S9
C8 | 22uF/10V | 22 µF 10 V X5R | 0805 | 01_PWR | 1 | 1 | 5V_SYS | POWER | VERIFIED |  | S9
C8 | 22uF/10V | 22 µF 10 V X5R | 0805 | 01_PWR | 2 | 2 | GND | GND | VERIFIED |  | S9
C9 | 100nF/16V | 0.1 µF 16 V X7R | 0603 | 01_PWR | 1 | 1 | 5V_SYS | POWER | VERIFIED |  | S9
C9 | 100nF/16V | 0.1 µF 16 V X7R | 0603 | 01_PWR | 2 | 2 | GND | GND | VERIFIED |  | S9
U2 | SY8089AAAC | SY8089A 5V->3.3V 2A | SOT-23-5 | 01_PWR | 1 | EN | EN_U2 | SIGNAL | VERIFIED |  | S10 | H05：3.3 V 容量按 800 mA 分配实测
U2 | SY8089AAAC | SY8089A 5V->3.3V 2A | SOT-23-5 | 01_PWR | 2 | GND | GND | GND | VERIFIED |  | S10 | H05：3.3 V 容量按 800 mA 分配实测
U2 | SY8089AAAC | SY8089A 5V->3.3V 2A | SOT-23-5 | 01_PWR | 3 | LX | SW_U2 | SIGNAL | VERIFIED |  | S10 | H05：3.3 V 容量按 800 mA 分配实测
U2 | SY8089AAAC | SY8089A 5V->3.3V 2A | SOT-23-5 | 01_PWR | 4 | IN | 5V_SYS | POWER | VERIFIED |  | S10 | H05：3.3 V 容量按 800 mA 分配实测
U2 | SY8089AAAC | SY8089A 5V->3.3V 2A | SOT-23-5 | 01_PWR | 5 | FB | FB_U2 | SIGNAL | VERIFIED |  | S10 | H05：3.3 V 容量按 800 mA 分配实测
R5 | 100k | 100 kΩ 1% | 0603 | 01_PWR | 1 | 1 | 5V_SYS | POWER | VERIFIED |  | S10
R5 | 100k | 100 kΩ 1% | 0603 | 01_PWR | 2 | 2 | EN_U2 | SIGNAL | VERIFIED |  | S10
C10 | 10uF/10V | 10 µF 10 V X5R | 0805 | 01_PWR | 1 | 1 | 5V_SYS | POWER | VERIFIED |  | S10
C10 | 10uF/10V | 10 µF 10 V X5R | 0805 | 01_PWR | 2 | 2 | GND | GND | VERIFIED |  | S10
L2 | 2.2uH/3A | 2.2 µH 3 A 屏蔽功率电感 | 0520 | 01_PWR | 1 | 1 | SW_U2 | SIGNAL | PROVISIONAL |  | S10
L2 | 2.2uH/3A | 2.2 µH 3 A 屏蔽功率电感 | 0520 | 01_PWR | 2 | 2 | 3V3 | POWER | PROVISIONAL |  | S10
R6 | 100k | 100 kΩ 1% | 0603 | 01_PWR | 1 | 1 | 3V3 | POWER | VERIFIED |  | S10
R6 | 100k | 100 kΩ 1% | 0603 | 01_PWR | 2 | 2 | FB_U2 | SIGNAL | VERIFIED |  | S10
R7 | 22.1k | 22.1 kΩ 1% | 0603 | 01_PWR | 1 | 1 | FB_U2 | SIGNAL | VERIFIED |  | S10
R7 | 22.1k | 22.1 kΩ 1% | 0603 | 01_PWR | 2 | 2 | GND | GND | VERIFIED |  | S10
C11 | 22uF/6.3V | 22 µF 6.3 V X5R | 0805 | 01_PWR | 1 | 1 | 3V3 | POWER | VERIFIED |  | S10
C11 | 22uF/6.3V | 22 µF 6.3 V X5R | 0805 | 01_PWR | 2 | 2 | GND | GND | VERIFIED |  | S10
C12 | 100nF/16V | 0.1 µF 16 V X7R | 0603 | 01_PWR | 1 | 1 | 3V3 | POWER | VERIFIED |  | S10
C12 | 100nF/16V | 0.1 µF 16 V X7R | 0603 | 01_PWR | 2 | 2 | GND | GND | VERIFIED |  | S10
Q1 | DMP3098L | P-MOSFET 30 V/3.8 A | SOT-23 | 01_PWR | 1 | G | Q1_G | SIGNAL | PROVISIONAL |  | S11 | H04
Q1 | DMP3098L | P-MOSFET 30 V/3.8 A | SOT-23 | 01_PWR | 2 | S | EXT12 | POWER | PROVISIONAL |  | S11 | H04
Q1 | DMP3098L | P-MOSFET 30 V/3.8 A | SOT-23 | 01_PWR | 3 | D | DRV_VDD | DRV | PROVISIONAL |  | S11 | H04
R8 | 100k | 100 kΩ 1% | 0603 | 01_PWR | 1 | 1 | EXT12 | POWER | VERIFIED |  | S11
R8 | 100k | 100 kΩ 1% | 0603 | 01_PWR | 2 | 2 | Q1_G | SIGNAL | VERIFIED |  | S11
Q2 | 2N7002 | N-MOSFET 60 V | SOT-23 | 01_PWR | 1 | G | Q2_G | SIGNAL | VERIFIED |  | S11
Q2 | 2N7002 | N-MOSFET 60 V | SOT-23 | 01_PWR | 2 | S | GND | GND | VERIFIED |  | S11
Q2 | 2N7002 | N-MOSFET 60 V | SOT-23 | 01_PWR | 3 | D | Q1_G | SIGNAL | VERIFIED |  | S11
R9 | 100Ω | 100 Ω 1% | 0603 | 01_PWR | 1 | 1 | DRV_VDD_EN | SIGNAL | VERIFIED |  | S11
R9 | 100Ω | 100 Ω 1% | 0603 | 01_PWR | 2 | 2 | Q2_G | SIGNAL | VERIFIED |  | S11
R10 | 100k | 100 kΩ 1% | 0603 | 01_PWR | 1 | 1 | Q2_G | SIGNAL | VERIFIED |  | S11
R10 | 100k | 100 kΩ 1% | 0603 | 01_PWR | 2 | 2 | GND | GND | VERIFIED |  | S11
C13 | 10uF/25V | 10 µF 25 V X5R | 1206 | 01_PWR | 1 | 1 | DRV_VDD | DRV | VERIFIED |  | S11
C13 | 10uF/25V | 10 µF 25 V X5R | 1206 | 01_PWR | 2 | 2 | GND | GND | VERIFIED |  | S11
C14 | 100nF/50V | 0.1 µF 50 V X7R | 0603 | 01_PWR | 1 | 1 | DRV_VDD | DRV | VERIFIED |  | S11
C14 | 100nF/50V | 0.1 µF 50 V X7R | 0603 | 01_PWR | 2 | 2 | GND | GND | VERIFIED |  | S11
U10 | ESP32-S3-WROOM-1-N8 | ESP32-S3 8MB Flash 无 PSRAM | WROOM-1 41pad | 02_MCU | 1 | GND | GND | GND | VERIFIED |  | S1 | S1 焊盘表；H08 天线/整机 RF
U10 | ESP32-S3-WROOM-1-N8 | ESP32-S3 8MB Flash 无 PSRAM | WROOM-1 41pad | 02_MCU | 2 | 3V3 | 3V3 | POWER | VERIFIED |  | S1 | S1 焊盘表；H08 天线/整机 RF
U10 | ESP32-S3-WROOM-1-N8 | ESP32-S3 8MB Flash 无 PSRAM | WROOM-1 41pad | 02_MCU | 3 | EN | EN_MCU | SIGNAL | VERIFIED |  | S1 | S1 焊盘表；H08 天线/整机 RF
U10 | ESP32-S3-WROOM-1-N8 | ESP32-S3 8MB Flash 无 PSRAM | WROOM-1 41pad | 02_MCU | 4 | IO4 | KEY_SET | SIGNAL | VERIFIED |  | S1 | S1 焊盘表；H08 天线/整机 RF
U10 | ESP32-S3-WROOM-1-N8 | ESP32-S3 8MB Flash 无 PSRAM | WROOM-1 41pad | 02_MCU | 5 | IO5 | KEY_PLUS | SIGNAL | VERIFIED |  | S1 | S1 焊盘表；H08 天线/整机 RF
U10 | ESP32-S3-WROOM-1-N8 | ESP32-S3 8MB Flash 无 PSRAM | WROOM-1 41pad | 02_MCU | 6 | IO6 | KEY_MINUS | SIGNAL | VERIFIED |  | S1 | S1 焊盘表；H08 天线/整机 RF
U10 | ESP32-S3-WROOM-1-N8 | ESP32-S3 8MB Flash 无 PSRAM | WROOM-1 41pad | 02_MCU | 7 | IO7 | HVF_NODE | SIGNAL | VERIFIED |  | S1 | S1 焊盘表；H08 天线/整机 RF
U10 | ESP32-S3-WROOM-1-N8 | ESP32-S3 8MB Flash 无 PSRAM | WROOM-1 41pad | 02_MCU | 8 | IO15 | DISP_ALLOW | SIGNAL | VERIFIED |  | S1 | S1 焊盘表；H08 天线/整机 RF
U10 | ESP32-S3-WROOM-1-N8 | ESP32-S3 8MB Flash 无 PSRAM | WROOM-1 41pad | 02_MCU | 9 | IO16 | HV_EN_REQ | SIGNAL | VERIFIED |  | S1 | S1 焊盘表；H08 天线/整机 RF
U10 | ESP32-S3-WROOM-1-N8 | ESP32-S3 8MB Flash 无 PSRAM | WROOM-1 41pad | 02_MCU | 10 | IO17 | STATUS_LED | SIGNAL | VERIFIED |  | S1 | S1 焊盘表；H08 天线/整机 RF
U10 | ESP32-S3-WROOM-1-N8 | ESP32-S3 8MB Flash 无 PSRAM | WROOM-1 41pad | 02_MCU | 11 | IO18 | OVP_RST | SIGNAL | VERIFIED |  | S1 | S1 焊盘表；H08 天线/整机 RF
U10 | ESP32-S3-WROOM-1-N8 | ESP32-S3 8MB Flash 无 PSRAM | WROOM-1 41pad | 02_MCU | 12 | IO8 | I2C_SDA | SIGNAL | VERIFIED |  | S1 | S1 焊盘表；H08 天线/整机 RF
U10 | ESP32-S3-WROOM-1-N8 | ESP32-S3 8MB Flash 无 PSRAM | WROOM-1 41pad | 02_MCU | 13 | IO19 | USB_DM_MCU | DIFF | VERIFIED |  | S1 | S1 焊盘表；H08 天线/整机 RF
U10 | ESP32-S3-WROOM-1-N8 | ESP32-S3 8MB Flash 无 PSRAM | WROOM-1 41pad | 02_MCU | 14 | IO20 | USB_DP_MCU | DIFF | VERIFIED |  | S1 | S1 焊盘表；H08 天线/整机 RF
U10 | ESP32-S3-WROOM-1-N8 | ESP32-S3 8MB Flash 无 PSRAM | WROOM-1 41pad | 02_MCU | 15 | IO3 |  |  | VERIFIED |  | S1 | S1 焊盘表；H08 天线/整机 RF
U10 | ESP32-S3-WROOM-1-N8 | ESP32-S3 8MB Flash 无 PSRAM | WROOM-1 41pad | 02_MCU | 16 | IO46 | GPIO46_STRAP | SIGNAL | VERIFIED |  | S1 | S1 焊盘表；H08 天线/整机 RF
U10 | ESP32-S3-WROOM-1-N8 | ESP32-S3 8MB Flash 无 PSRAM | WROOM-1 41pad | 02_MCU | 17 | IO9 | I2C_SCL | SIGNAL | VERIFIED |  | S1 | S1 焊盘表；H08 天线/整机 RF
U10 | ESP32-S3-WROOM-1-N8 | ESP32-S3 8MB Flash 无 PSRAM | WROOM-1 41pad | 02_MCU | 18 | IO10 |  |  | VERIFIED |  | S1 | S1 焊盘表；H08 天线/整机 RF
U10 | ESP32-S3-WROOM-1-N8 | ESP32-S3 8MB Flash 无 PSRAM | WROOM-1 41pad | 02_MCU | 19 | IO11 | DISP_DIN | SIGNAL | VERIFIED |  | S1 | S1 焊盘表；H08 天线/整机 RF
U10 | ESP32-S3-WROOM-1-N8 | ESP32-S3 8MB Flash 无 PSRAM | WROOM-1 41pad | 02_MCU | 20 | IO12 | DISP_CLK | SIGNAL | VERIFIED |  | S1 | S1 焊盘表；H08 天线/整机 RF
U10 | ESP32-S3-WROOM-1-N8 | ESP32-S3 8MB Flash 无 PSRAM | WROOM-1 41pad | 02_MCU | 21 | IO13 | EXP_IO13 | SIGNAL | VERIFIED |  | S1 | S1 焊盘表；H08 天线/整机 RF
U10 | ESP32-S3-WROOM-1-N8 | ESP32-S3 8MB Flash 无 PSRAM | WROOM-1 41pad | 02_MCU | 22 | IO14 | DISP_LAT | SIGNAL | VERIFIED |  | S1 | S1 焊盘表；H08 天线/整机 RF
U10 | ESP32-S3-WROOM-1-N8 | ESP32-S3 8MB Flash 无 PSRAM | WROOM-1 41pad | 02_MCU | 23 | IO21 | EXP_IO21 | SIGNAL | VERIFIED |  | S1 | S1 焊盘表；H08 天线/整机 RF
U10 | ESP32-S3-WROOM-1-N8 | ESP32-S3 8MB Flash 无 PSRAM | WROOM-1 41pad | 02_MCU | 24 | IO47 |  |  | VERIFIED |  | S1 | S1 焊盘表；H08 天线/整机 RF
U10 | ESP32-S3-WROOM-1-N8 | ESP32-S3 8MB Flash 无 PSRAM | WROOM-1 41pad | 02_MCU | 25 | IO48 |  |  | VERIFIED |  | S1 | S1 焊盘表；H08 天线/整机 RF
U10 | ESP32-S3-WROOM-1-N8 | ESP32-S3 8MB Flash 无 PSRAM | WROOM-1 41pad | 02_MCU | 26 | IO45 |  |  | VERIFIED |  | S1 | S1 焊盘表；H08 天线/整机 RF
U10 | ESP32-S3-WROOM-1-N8 | ESP32-S3 8MB Flash 无 PSRAM | WROOM-1 41pad | 02_MCU | 27 | IO0 | BOOT_N | SIGNAL | VERIFIED |  | S1 | S1 焊盘表；H08 天线/整机 RF
U10 | ESP32-S3-WROOM-1-N8 | ESP32-S3 8MB Flash 无 PSRAM | WROOM-1 41pad | 02_MCU | 28 | IO35 |  |  | VERIFIED |  | S1 | S1 焊盘表；H08 天线/整机 RF
U10 | ESP32-S3-WROOM-1-N8 | ESP32-S3 8MB Flash 无 PSRAM | WROOM-1 41pad | 02_MCU | 29 | IO36 |  |  | VERIFIED |  | S1 | S1 焊盘表；H08 天线/整机 RF
U10 | ESP32-S3-WROOM-1-N8 | ESP32-S3 8MB Flash 无 PSRAM | WROOM-1 41pad | 02_MCU | 30 | IO37 |  |  | VERIFIED |  | S1 | S1 焊盘表；H08 天线/整机 RF
U10 | ESP32-S3-WROOM-1-N8 | ESP32-S3 8MB Flash 无 PSRAM | WROOM-1 41pad | 02_MCU | 31 | IO38 |  |  | VERIFIED |  | S1 | S1 焊盘表；H08 天线/整机 RF
U10 | ESP32-S3-WROOM-1-N8 | ESP32-S3 8MB Flash 无 PSRAM | WROOM-1 41pad | 02_MCU | 32 | IO39 |  |  | VERIFIED |  | S1 | S1 焊盘表；H08 天线/整机 RF
U10 | ESP32-S3-WROOM-1-N8 | ESP32-S3 8MB Flash 无 PSRAM | WROOM-1 41pad | 02_MCU | 33 | IO40 |  |  | VERIFIED |  | S1 | S1 焊盘表；H08 天线/整机 RF
U10 | ESP32-S3-WROOM-1-N8 | ESP32-S3 8MB Flash 无 PSRAM | WROOM-1 41pad | 02_MCU | 34 | IO41 |  |  | VERIFIED |  | S1 | S1 焊盘表；H08 天线/整机 RF
U10 | ESP32-S3-WROOM-1-N8 | ESP32-S3 8MB Flash 无 PSRAM | WROOM-1 41pad | 02_MCU | 35 | IO42 |  |  | VERIFIED |  | S1 | S1 焊盘表；H08 天线/整机 RF
U10 | ESP32-S3-WROOM-1-N8 | ESP32-S3 8MB Flash 无 PSRAM | WROOM-1 41pad | 02_MCU | 36 | IO44/RXD0 | UART0_RX | SIGNAL | VERIFIED |  | S1 | S1 焊盘表；H08 天线/整机 RF
U10 | ESP32-S3-WROOM-1-N8 | ESP32-S3 8MB Flash 无 PSRAM | WROOM-1 41pad | 02_MCU | 37 | IO43/TXD0 | UART0_TX | SIGNAL | VERIFIED |  | S1 | S1 焊盘表；H08 天线/整机 RF
U10 | ESP32-S3-WROOM-1-N8 | ESP32-S3 8MB Flash 无 PSRAM | WROOM-1 41pad | 02_MCU | 38 | IO2 |  |  | VERIFIED |  | S1 | S1 焊盘表；H08 天线/整机 RF
U10 | ESP32-S3-WROOM-1-N8 | ESP32-S3 8MB Flash 无 PSRAM | WROOM-1 41pad | 02_MCU | 39 | IO1 | HV_SENSE_ADC | SIGNAL | VERIFIED |  | S1 | S1 焊盘表；H08 天线/整机 RF
U10 | ESP32-S3-WROOM-1-N8 | ESP32-S3 8MB Flash 无 PSRAM | WROOM-1 41pad | 02_MCU | 40 | GND | GND | GND | VERIFIED |  | S1 | S1 焊盘表；H08 天线/整机 RF
U10 | ESP32-S3-WROOM-1-N8 | ESP32-S3 8MB Flash 无 PSRAM | WROOM-1 41pad | 02_MCU | 41 | GND/EP | GND | GND | VERIFIED |  | S1 | S1 焊盘表；H08 天线/整机 RF
C16 | 22uF | 22uF 6.3V | 0805 | 02_MCU | 1 | 1 | 3V3 | POWER | VERIFIED |  | S3
C16 | 22uF | 22uF 6.3V | 0805 | 02_MCU | 2 | 2 | GND | GND | VERIFIED |  | S3
C17 | 1uF | 1uF 16V | 0603 | 02_MCU | 1 | 1 | 3V3 | POWER | VERIFIED |  | S3
C17 | 1uF | 1uF 16V | 0603 | 02_MCU | 2 | 2 | GND | GND | VERIFIED |  | S3
C18 | 100nF | 100nF 16V | 0603 | 02_MCU | 1 | 1 | 3V3 | POWER | VERIFIED |  | S3
C18 | 100nF | 100nF 16V | 0603 | 02_MCU | 2 | 2 | GND | GND | VERIFIED |  | S3
R11 | 10k | 10 kΩ 1% | 0603 | 02_MCU | 1 | 1 | 3V3 | POWER | VERIFIED |  | S3
R11 | 10k | 10 kΩ 1% | 0603 | 02_MCU | 2 | 2 | EN_MCU | SIGNAL | VERIFIED |  | S3
C19 | 1uF/16V | 1 µF 16 V X7R | 0603 | 02_MCU | 1 | 1 | EN_MCU | SIGNAL | VERIFIED |  | S3
C19 | 1uF/16V | 1 µF 16 V X7R | 0603 | 02_MCU | 2 | 2 | GND | GND | VERIFIED |  | S3
SW1 | TS-1187A | 复位按键 | 4P 6x6 SMD | 02_MCU | 1 | 1 | EN_MCU | SIGNAL | PROVISIONAL |  | S3
SW1 | TS-1187A | 复位按键 | 4P 6x6 SMD | 02_MCU | 2 | 2 | GND | GND | PROVISIONAL |  | S3
SW2 | TS-1187A | BOOT 按键 | 4P 6x6 SMD | 02_MCU | 1 | 1 | BOOT_N | SIGNAL | PROVISIONAL |  | S4
SW2 | TS-1187A | BOOT 按键 | 4P 6x6 SMD | 02_MCU | 2 | 2 | GND | GND | PROVISIONAL |  | S4
R12 | 10k | 10 kΩ 1% | 0603 | 02_MCU | 1 | 1 | 3V3 | POWER | VERIFIED |  | S4
R12 | 10k | 10 kΩ 1% | 0603 | 02_MCU | 2 | 2 | BOOT_N | SIGNAL | VERIFIED |  | S4
R13 | 10k | 10 kΩ 1% | 0603 | 02_MCU | 1 | 1 | GPIO46_STRAP | SIGNAL | VERIFIED |  | S3
R13 | 10k | 10 kΩ 1% | 0603 | 02_MCU | 2 | 2 | GND | GND | VERIFIED |  | S3
J2 | USB-C-16P-2.0 | USB-C 母座 16P USB2.0 | SMD 16P | 02_MCU | A1 | GND | GND | GND | PROVISIONAL |  | S2 | H05：封装/沉板形式待确认
J2 | USB-C-16P-2.0 | USB-C 母座 16P USB2.0 | SMD 16P | 02_MCU | A4 | VBUS | VBUS | POWER | PROVISIONAL |  | S2 | H05：封装/沉板形式待确认
J2 | USB-C-16P-2.0 | USB-C 母座 16P USB2.0 | SMD 16P | 02_MCU | A5 | CC1 | CC1 | SIGNAL | PROVISIONAL |  | S2 | H05：封装/沉板形式待确认
J2 | USB-C-16P-2.0 | USB-C 母座 16P USB2.0 | SMD 16P | 02_MCU | A6 | D+ | USB_DP_CON | DIFF | PROVISIONAL |  | S2 | H05：封装/沉板形式待确认
J2 | USB-C-16P-2.0 | USB-C 母座 16P USB2.0 | SMD 16P | 02_MCU | A7 | D- | USB_DM_CON | DIFF | PROVISIONAL |  | S2 | H05：封装/沉板形式待确认
J2 | USB-C-16P-2.0 | USB-C 母座 16P USB2.0 | SMD 16P | 02_MCU | A8 | SBU1 |  |  | PROVISIONAL |  | S2 | H05：封装/沉板形式待确认
J2 | USB-C-16P-2.0 | USB-C 母座 16P USB2.0 | SMD 16P | 02_MCU | A9 | VBUS | VBUS | POWER | PROVISIONAL |  | S2 | H05：封装/沉板形式待确认
J2 | USB-C-16P-2.0 | USB-C 母座 16P USB2.0 | SMD 16P | 02_MCU | A12 | GND | GND | GND | PROVISIONAL |  | S2 | H05：封装/沉板形式待确认
J2 | USB-C-16P-2.0 | USB-C 母座 16P USB2.0 | SMD 16P | 02_MCU | B1 | GND | GND | GND | PROVISIONAL |  | S2 | H05：封装/沉板形式待确认
J2 | USB-C-16P-2.0 | USB-C 母座 16P USB2.0 | SMD 16P | 02_MCU | B4 | VBUS | VBUS | POWER | PROVISIONAL |  | S2 | H05：封装/沉板形式待确认
J2 | USB-C-16P-2.0 | USB-C 母座 16P USB2.0 | SMD 16P | 02_MCU | B5 | CC2 | CC2 | SIGNAL | PROVISIONAL |  | S2 | H05：封装/沉板形式待确认
J2 | USB-C-16P-2.0 | USB-C 母座 16P USB2.0 | SMD 16P | 02_MCU | B6 | D+ | USB_DP_CON | DIFF | PROVISIONAL |  | S2 | H05：封装/沉板形式待确认
J2 | USB-C-16P-2.0 | USB-C 母座 16P USB2.0 | SMD 16P | 02_MCU | B7 | D- | USB_DM_CON | DIFF | PROVISIONAL |  | S2 | H05：封装/沉板形式待确认
J2 | USB-C-16P-2.0 | USB-C 母座 16P USB2.0 | SMD 16P | 02_MCU | B8 | SBU2 |  |  | PROVISIONAL |  | S2 | H05：封装/沉板形式待确认
J2 | USB-C-16P-2.0 | USB-C 母座 16P USB2.0 | SMD 16P | 02_MCU | B9 | VBUS | VBUS | POWER | PROVISIONAL |  | S2 | H05：封装/沉板形式待确认
J2 | USB-C-16P-2.0 | USB-C 母座 16P USB2.0 | SMD 16P | 02_MCU | B12 | GND | GND | GND | PROVISIONAL |  | S2 | H05：封装/沉板形式待确认
J2 | USB-C-16P-2.0 | USB-C 母座 16P USB2.0 | SMD 16P | 02_MCU | S1 | SHIELD | SHIELD | SIGNAL | PROVISIONAL |  | S2 | H05：封装/沉板形式待确认
J2 | USB-C-16P-2.0 | USB-C 母座 16P USB2.0 | SMD 16P | 02_MCU | S2 | SHIELD | SHIELD | SIGNAL | PROVISIONAL |  | S2 | H05：封装/沉板形式待确认
J2 | USB-C-16P-2.0 | USB-C 母座 16P USB2.0 | SMD 16P | 02_MCU | S3 | SHIELD | SHIELD | SIGNAL | PROVISIONAL |  | S2 | H05：封装/沉板形式待确认
J2 | USB-C-16P-2.0 | USB-C 母座 16P USB2.0 | SMD 16P | 02_MCU | S4 | SHIELD | SHIELD | SIGNAL | PROVISIONAL |  | S2 | H05：封装/沉板形式待确认
R14 | 5.1k | 5.1 kΩ 1% | 0603 | 02_MCU | 1 | 1 | CC1 | SIGNAL | VERIFIED |  | S2
R14 | 5.1k | 5.1 kΩ 1% | 0603 | 02_MCU | 2 | 2 | GND | GND | VERIFIED |  | S2
R15 | 5.1k | 5.1 kΩ 1% | 0603 | 02_MCU | 1 | 1 | CC2 | SIGNAL | VERIFIED |  | S2
R15 | 5.1k | 5.1 kΩ 1% | 0603 | 02_MCU | 2 | 2 | GND | GND | VERIFIED |  | S2
R16 | 1M | 1 MΩ 1% | 0603 | 02_MCU | 1 | 1 | SHIELD | SIGNAL | VERIFIED |  | S2
R16 | 1M | 1 MΩ 1% | 0603 | 02_MCU | 2 | 2 | GND | GND | VERIFIED |  | S2
C20 | 4.7nF/50V | 4.7 nF 50 V X7R | 0603 | 02_MCU | 1 | 1 | SHIELD | SIGNAL | VERIFIED |  | S2
C20 | 4.7nF/50V | 4.7 nF 50 V X7R | 0603 | 02_MCU | 2 | 2 | GND | GND | VERIFIED |  | S2
C21 | 1uF/16V | 1 µF 16 V X7R | 0603 | 02_MCU | 1 | 1 | VBUS | POWER | VERIFIED |  | S2
C21 | 1uF/16V | 1 µF 16 V X7R | 0603 | 02_MCU | 2 | 2 | GND | GND | VERIFIED |  | S2
C22 | 100nF/16V | 0.1 µF 16 V X7R | 0603 | 02_MCU | 1 | 1 | VBUS | POWER | VERIFIED |  | S2
C22 | 100nF/16V | 0.1 µF 16 V X7R | 0603 | 02_MCU | 2 | 2 | GND | GND | VERIFIED |  | S2
U11 | USBLC6-2SC6 | USB ESD 保护 | SOT-23-6 | 02_MCU | 1 | I/O1 | USB_DP_CON | DIFF | VERIFIED |  | S12
U11 | USBLC6-2SC6 | USB ESD 保护 | SOT-23-6 | 02_MCU | 2 | GND | GND | GND | VERIFIED |  | S12
U11 | USBLC6-2SC6 | USB ESD 保护 | SOT-23-6 | 02_MCU | 3 | I/O2 | USB_DM_CON | DIFF | VERIFIED |  | S12
U11 | USBLC6-2SC6 | USB ESD 保护 | SOT-23-6 | 02_MCU | 4 | I/O2 | USB_DM_ESD | SIGNAL | VERIFIED |  | S12
U11 | USBLC6-2SC6 | USB ESD 保护 | SOT-23-6 | 02_MCU | 5 | VBUS | VBUS | POWER | VERIFIED |  | S12
U11 | USBLC6-2SC6 | USB ESD 保护 | SOT-23-6 | 02_MCU | 6 | I/O1 | USB_DP_ESD | SIGNAL | VERIFIED |  | S12
R17 | 22Ω | 22 Ω 1% | 0402 | 02_MCU | 1 | 1 | USB_DP_ESD | SIGNAL | PROVISIONAL |  | S2
R17 | 22Ω | 22 Ω 1% | 0402 | 02_MCU | 2 | 2 | USB_DP_MCU | DIFF | PROVISIONAL |  | S2
R18 | 22Ω | 22 Ω 1% | 0402 | 02_MCU | 1 | 1 | USB_DM_ESD | SIGNAL | PROVISIONAL |  | S2
R18 | 22Ω | 22 Ω 1% | 0402 | 02_MCU | 2 | 2 | USB_DM_MCU | DIFF | PROVISIONAL |  | S2
C23 | 10pF/50V | 10 pF 50 V | 0402 | 02_MCU | 1 | 1 | USB_DP_MCU | DIFF | PROVISIONAL | DNP | S2
C23 | 10pF/50V | 10 pF 50 V | 0402 | 02_MCU | 2 | 2 | GND | GND | PROVISIONAL | DNP | S2
C24 | 10pF/50V | 10 pF 50 V | 0402 | 02_MCU | 1 | 1 | USB_DM_MCU | DIFF | PROVISIONAL | DNP | S2
C24 | 10pF/50V | 10 pF 50 V | 0402 | 02_MCU | 2 | 2 | GND | GND | PROVISIONAL | DNP | S2
J3 | HDR-1x6-2.54 | UART0 恢复排针 1x6 | 2.54mm | 02_MCU | 1 | 1 | GND | GND | VERIFIED |  | S3 | 3V3 参考点经 0Ω(DNP) 连接，不默认向外供电
J3 | HDR-1x6-2.54 | UART0 恢复排针 1x6 | 2.54mm | 02_MCU | 2 | 2 | UART_3V3_REF | SIGNAL | VERIFIED |  | S3 | 3V3 参考点经 0Ω(DNP) 连接，不默认向外供电
J3 | HDR-1x6-2.54 | UART0 恢复排针 1x6 | 2.54mm | 02_MCU | 3 | 3 | UART0_TX_H | SIGNAL | VERIFIED |  | S3 | 3V3 参考点经 0Ω(DNP) 连接，不默认向外供电
J3 | HDR-1x6-2.54 | UART0 恢复排针 1x6 | 2.54mm | 02_MCU | 4 | 4 | UART0_RX | SIGNAL | VERIFIED |  | S3 | 3V3 参考点经 0Ω(DNP) 连接，不默认向外供电
J3 | HDR-1x6-2.54 | UART0 恢复排针 1x6 | 2.54mm | 02_MCU | 5 | 5 | EN_MCU | SIGNAL | VERIFIED |  | S3 | 3V3 参考点经 0Ω(DNP) 连接，不默认向外供电
J3 | HDR-1x6-2.54 | UART0 恢复排针 1x6 | 2.54mm | 02_MCU | 6 | 6 | BOOT_N | SIGNAL | VERIFIED |  | S3 | 3V3 参考点经 0Ω(DNP) 连接，不默认向外供电
R19 | 499Ω | 499 Ω 1% | 0603 | 02_MCU | 1 | 1 | UART0_TX | SIGNAL | VERIFIED |  | S3
R19 | 499Ω | 499 Ω 1% | 0603 | 02_MCU | 2 | 2 | UART0_TX_H | SIGNAL | VERIFIED |  | S3
R20 | 0Ω | 0 Ω | 0603 | 02_MCU | 1 | 1 | 3V3 | POWER | VERIFIED | DNP | S3
R20 | 0Ω | 0 Ω | 0603 | 02_MCU | 2 | 2 | UART_3V3_REF | SIGNAL | VERIFIED | DNP | S3
SW3 | TS-1187A | SET 按键 | 4P 6x6 SMD | 02_MCU | 1 | 1 | KEY_SET | SIGNAL | PROVISIONAL |  | S3
SW3 | TS-1187A | SET 按键 | 4P 6x6 SMD | 02_MCU | 2 | 2 | GND | GND | PROVISIONAL |  | S3
SW4 | TS-1187A | PLUS 按键 | 4P 6x6 SMD | 02_MCU | 1 | 1 | KEY_PLUS | SIGNAL | PROVISIONAL |  | S3
SW4 | TS-1187A | PLUS 按键 | 4P 6x6 SMD | 02_MCU | 2 | 2 | GND | GND | PROVISIONAL |  | S3
SW5 | TS-1187A | MINUS 按键 | 4P 6x6 SMD | 02_MCU | 1 | 1 | KEY_MINUS | SIGNAL | PROVISIONAL |  | S3
SW5 | TS-1187A | MINUS 按键 | 4P 6x6 SMD | 02_MCU | 2 | 2 | GND | GND | PROVISIONAL |  | S3
R21 | 10k | 10 kΩ 1% | 0603 | 02_MCU | 1 | 1 | KEY_SET | SIGNAL | VERIFIED |  | S3
R21 | 10k | 10 kΩ 1% | 0603 | 02_MCU | 2 | 2 | 3V3 | POWER | VERIFIED |  | S3
R22 | 10k | 10 kΩ 1% | 0603 | 02_MCU | 1 | 1 | KEY_PLUS | SIGNAL | VERIFIED |  | S3
R22 | 10k | 10 kΩ 1% | 0603 | 02_MCU | 2 | 2 | 3V3 | POWER | VERIFIED |  | S3
R23 | 10k | 10 kΩ 1% | 0603 | 02_MCU | 1 | 1 | KEY_MINUS | SIGNAL | VERIFIED |  | S3
R23 | 10k | 10 kΩ 1% | 0603 | 02_MCU | 2 | 2 | 3V3 | POWER | VERIFIED |  | S3
C25 | 100nF/16V | 0.1 µF 16 V X7R | 0603 | 02_MCU | 1 | 1 | KEY_SET | SIGNAL | VERIFIED |  | S3
C25 | 100nF/16V | 0.1 µF 16 V X7R | 0603 | 02_MCU | 2 | 2 | GND | GND | VERIFIED |  | S3
C26 | 100nF/16V | 0.1 µF 16 V X7R | 0603 | 02_MCU | 1 | 1 | KEY_PLUS | SIGNAL | VERIFIED |  | S3
C26 | 100nF/16V | 0.1 µF 16 V X7R | 0603 | 02_MCU | 2 | 2 | GND | GND | VERIFIED |  | S3
C27 | 100nF/16V | 0.1 µF 16 V X7R | 0603 | 02_MCU | 1 | 1 | KEY_MINUS | SIGNAL | VERIFIED |  | S3
C27 | 100nF/16V | 0.1 µF 16 V X7R | 0603 | 02_MCU | 2 | 2 | GND | GND | VERIFIED |  | S3
LED1 | LTST-C190KRKT | 红色 LED | 0603 | 02_MCU | 1 | K | GND | GND | VERIFIED |  | S3
LED1 | LTST-C190KRKT | 红色 LED | 0603 | 02_MCU | 2 | A | LED1_A | SIGNAL | VERIFIED |  | S3
R24 | 1k | 1 kΩ 1% | 0603 | 02_MCU | 1 | 1 | STATUS_LED | SIGNAL | VERIFIED |  | S3
R24 | 1k | 1 kΩ 1% | 0603 | 02_MCU | 2 | 2 | LED1_A | SIGNAL | VERIFIED |  | S3
R25 | 4.7k | 4.7 kΩ 1% | 0603 | 02_MCU | 1 | 1 | 3V3 | POWER | VERIFIED | DNP | S3
R25 | 4.7k | 4.7 kΩ 1% | 0603 | 02_MCU | 2 | 2 | I2C_SDA | SIGNAL | VERIFIED | DNP | S3
R26 | 4.7k | 4.7 kΩ 1% | 0603 | 02_MCU | 1 | 1 | 3V3 | POWER | VERIFIED | DNP | S3
R26 | 4.7k | 4.7 kΩ 1% | 0603 | 02_MCU | 2 | 2 | I2C_SCL | SIGNAL | VERIFIED | DNP | S3
R27 | 1M | 1 MΩ 1% 1206 | 1206 | 02_MCU | 1 | 1 | HV_BUS | HV | PROVISIONAL |  | S3 | H06
R27 | 1M | 1 MΩ 1% 1206 | 1206 | 02_MCU | 2 | 2 | HVS_MID | HV | PROVISIONAL |  | S3 | H06
R28 | 1M | 1 MΩ 1% 1206 | 1206 | 02_MCU | 1 | 1 | HVS_MID | HV | PROVISIONAL |  | S3 | H06
R28 | 1M | 1 MΩ 1% 1206 | 1206 | 02_MCU | 2 | 2 | HVS_NODE | HV | PROVISIONAL |  | S3 | H06
R29 | 20k | 20 kΩ 1% | 0805 | 02_MCU | 1 | 1 | HVS_NODE | HV | PROVISIONAL |  | S3 | H06：分压比/钳位/回灌待复核
R29 | 20k | 20 kΩ 1% | 0805 | 02_MCU | 2 | 2 | GND | GND | PROVISIONAL |  | S3 | H06：分压比/钳位/回灌待复核
R30 | 1k | 1 kΩ 1% | 0603 | 02_MCU | 1 | 1 | HVS_NODE | HV | PROVISIONAL |  | S3
R30 | 1k | 1 kΩ 1% | 0603 | 02_MCU | 2 | 2 | HV_SENSE_ADC | SIGNAL | PROVISIONAL |  | S3
C28 | 100nF/16V | 0.1 µF 16 V X7R | 0603 | 02_MCU | 1 | 1 | HV_SENSE_ADC | SIGNAL | VERIFIED |  | S3
C28 | 100nF/16V | 0.1 µF 16 V X7R | 0603 | 02_MCU | 2 | 2 | GND | GND | VERIFIED |  | S3
D5 | BAT54 | 肖特基 30 V | SOD-323 | 02_MCU | 1 | K | 3V3 | POWER | VERIFIED |  | S3
D5 | BAT54 | 肖特基 30 V | SOD-323 | 02_MCU | 2 | A | HV_SENSE_ADC | SIGNAL | VERIFIED |  | S3
D6 | BAT54 | 肖特基 30 V | SOD-323 | 02_MCU | 1 | K | HV_SENSE_ADC | SIGNAL | VERIFIED |  | S3
D6 | BAT54 | 肖特基 30 V | SOD-323 | 02_MCU | 2 | A | GND | GND | VERIFIED |  | S3
R31 | 100k | 100 kΩ 1% | 0603 | 02_MCU | 1 | 1 | HV_FAULT_OD | SIGNAL | PROVISIONAL |  | S3 | H04
R31 | 100k | 100 kΩ 1% | 0603 | 02_MCU | 2 | 2 | HVF_NODE | SIGNAL | PROVISIONAL |  | S3 | H04
R32 | 36.5k | 36.5 kΩ 1% | 0603 | 02_MCU | 1 | 1 | HVF_NODE | SIGNAL | PROVISIONAL |  | S3
R32 | 36.5k | 36.5 kΩ 1% | 0603 | 02_MCU | 2 | 2 | GND | GND | PROVISIONAL |  | S3
C29 | 100nF/16V | 0.1 µF 16 V | 0603 | 02_MCU | 1 | 1 | HVF_NODE | SIGNAL | VERIFIED |  | S3
C29 | 100nF/16V | 0.1 µF 16 V | 0603 | 02_MCU | 2 | 2 | GND | GND | VERIFIED |  | S3
D7 | BAT54 | 肖特基 30 V | SOD-323 | 02_MCU | 1 | K | 3V3 | POWER | VERIFIED |  | S3
D7 | BAT54 | 肖特基 30 V | SOD-323 | 02_MCU | 2 | A | HVF_NODE | SIGNAL | VERIFIED |  | S3
D8 | BAT54 | 肖特基 30 V | SOD-323 | 02_MCU | 1 | K | HVF_NODE | SIGNAL | VERIFIED |  | S3
D8 | BAT54 | 肖特基 30 V | SOD-323 | 02_MCU | 2 | A | GND | GND | VERIFIED |  | S3
U3 | CD40109B | 四路低→高电平转换 #1 | SOIC-16 | 03_DRV | 1 | VCC | 3V3 | POWER | VERIFIED |  | S13
U3 | CD40109B | 四路低→高电平转换 #1 | SOIC-16 | 03_DRV | 2 | ENABLE A | 3V3 | POWER | VERIFIED |  | S13
U3 | CD40109B | 四路低→高电平转换 #1 | SOIC-16 | 03_DRV | 3 | A | DISP_DIN | SIGNAL | VERIFIED |  | S13
U3 | CD40109B | 四路低→高电平转换 #1 | SOIC-16 | 03_DRV | 4 | E | DRV_DIN | DRV | VERIFIED |  | S13
U3 | CD40109B | 四路低→高电平转换 #1 | SOIC-16 | 03_DRV | 5 | F | DRV_CLK | DRV | VERIFIED |  | S13
U3 | CD40109B | 四路低→高电平转换 #1 | SOIC-16 | 03_DRV | 6 | B | DISP_CLK | SIGNAL | VERIFIED |  | S13
U3 | CD40109B | 四路低→高电平转换 #1 | SOIC-16 | 03_DRV | 7 | ENABLE B | 3V3 | POWER | VERIFIED |  | S13
U3 | CD40109B | 四路低→高电平转换 #1 | SOIC-16 | 03_DRV | 8 | VSS | GND | GND | VERIFIED |  | S13
U3 | CD40109B | 四路低→高电平转换 #1 | SOIC-16 | 03_DRV | 9 | ENABLE C | 3V3 | POWER | VERIFIED |  | S13
U3 | CD40109B | 四路低→高电平转换 #1 | SOIC-16 | 03_DRV | 10 | C | DISP_LAT | SIGNAL | VERIFIED |  | S13
U3 | CD40109B | 四路低→高电平转换 #1 | SOIC-16 | 03_DRV | 11 | G | DRV_LAT | DRV | VERIFIED |  | S13
U3 | CD40109B | 四路低→高电平转换 #1 | SOIC-16 | 03_DRV | 12 | NC |  |  | VERIFIED |  | S13
U3 | CD40109B | 四路低→高电平转换 #1 | SOIC-16 | 03_DRV | 13 | H | DRV_BL | DRV | VERIFIED |  | S13
U3 | CD40109B | 四路低→高电平转换 #1 | SOIC-16 | 03_DRV | 14 | D | DISP_ALLOW | SIGNAL | VERIFIED |  | S13
U3 | CD40109B | 四路低→高电平转换 #1 | SOIC-16 | 03_DRV | 15 | ENABLE D | 3V3 | POWER | VERIFIED |  | S13
U3 | CD40109B | 四路低→高电平转换 #1 | SOIC-16 | 03_DRV | 16 | VDD | DRV_VDD | DRV | VERIFIED |  | S13
U4 | CD40109B | 四路低→高电平转换 #2 | SOIC-16 | 03_DRV | 1 | VCC | 3V3 | POWER | VERIFIED |  | S13
U4 | CD40109B | 四路低→高电平转换 #2 | SOIC-16 | 03_DRV | 2 | ENABLE A | 3V3 | POWER | VERIFIED |  | S13
U4 | CD40109B | 四路低→高电平转换 #2 | SOIC-16 | 03_DRV | 3 | A | HV_EN_REQ | SIGNAL | VERIFIED |  | S13
U4 | CD40109B | 四路低→高电平转换 #2 | SOIC-16 | 03_DRV | 4 | E | DRV_HV_EN_REQ | DRV | VERIFIED |  | S13
U4 | CD40109B | 四路低→高电平转换 #2 | SOIC-16 | 03_DRV | 5 | F |  |  | VERIFIED |  | S13
U4 | CD40109B | 四路低→高电平转换 #2 | SOIC-16 | 03_DRV | 6 | B | GND | GND | VERIFIED |  | S13
U4 | CD40109B | 四路低→高电平转换 #2 | SOIC-16 | 03_DRV | 7 | ENABLE B | 3V3 | POWER | VERIFIED |  | S13
U4 | CD40109B | 四路低→高电平转换 #2 | SOIC-16 | 03_DRV | 8 | VSS | GND | GND | VERIFIED |  | S13
U4 | CD40109B | 四路低→高电平转换 #2 | SOIC-16 | 03_DRV | 9 | ENABLE C | 3V3 | POWER | VERIFIED |  | S13
U4 | CD40109B | 四路低→高电平转换 #2 | SOIC-16 | 03_DRV | 10 | C | GND | GND | VERIFIED |  | S13
U4 | CD40109B | 四路低→高电平转换 #2 | SOIC-16 | 03_DRV | 11 | G |  |  | VERIFIED |  | S13
U4 | CD40109B | 四路低→高电平转换 #2 | SOIC-16 | 03_DRV | 12 | NC |  |  | VERIFIED |  | S13
U4 | CD40109B | 四路低→高电平转换 #2 | SOIC-16 | 03_DRV | 13 | H |  |  | VERIFIED |  | S13
U4 | CD40109B | 四路低→高电平转换 #2 | SOIC-16 | 03_DRV | 14 | D | GND | GND | VERIFIED |  | S13
U4 | CD40109B | 四路低→高电平转换 #2 | SOIC-16 | 03_DRV | 15 | ENABLE D | 3V3 | POWER | VERIFIED |  | S13
U4 | CD40109B | 四路低→高电平转换 #2 | SOIC-16 | 03_DRV | 16 | VDD | DRV_VDD | DRV | VERIFIED |  | S13
C30 | 100nF/16V | 0.1 µF 16 V | 0603 | 03_DRV | 1 | 1 | 3V3 | POWER | VERIFIED |  | S13
C30 | 100nF/16V | 0.1 µF 16 V | 0603 | 03_DRV | 2 | 2 | GND | GND | VERIFIED |  | S13
C31 | 100nF/50V | 0.1 µF 50 V | 0603 | 03_DRV | 1 | 1 | DRV_VDD | DRV | VERIFIED |  | S13
C31 | 100nF/50V | 0.1 µF 50 V | 0603 | 03_DRV | 2 | 2 | GND | GND | VERIFIED |  | S13
R33 | 10k | 10k 1% | 0603 | 03_DRV | 1 | 1 | DRV_DIN | DRV | VERIFIED |  | S3
R33 | 10k | 10k 1% | 0603 | 03_DRV | 2 | 2 | GND | GND | VERIFIED |  | S3
R34 | 10k | 10k 1% | 0603 | 03_DRV | 1 | 1 | DRV_CLK | DRV | VERIFIED |  | S3
R34 | 10k | 10k 1% | 0603 | 03_DRV | 2 | 2 | GND | GND | VERIFIED |  | S3
R35 | 10k | 10k 1% | 0603 | 03_DRV | 1 | 1 | DRV_LAT | DRV | VERIFIED |  | S3
R35 | 10k | 10k 1% | 0603 | 03_DRV | 2 | 2 | GND | GND | VERIFIED |  | S3
R36 | 10k | 10k 1% | 0603 | 03_DRV | 1 | 1 | DRV_BL | DRV | VERIFIED |  | S3
R36 | 10k | 10k 1% | 0603 | 03_DRV | 2 | 2 | GND | GND | VERIFIED |  | S3
R37 | 10k | 10k 1% | 0603 | 03_DRV | 1 | 1 | DRV_HV_EN_REQ | DRV | VERIFIED |  | S3
R37 | 10k | 10k 1% | 0603 | 03_DRV | 2 | 2 | GND | GND | VERIFIED |  | S3
U5 | LM393DR | 双比较器 #1（EXT12 / 3V3 监控） | SOIC-8 | 03_DRV | 1 | OUT1 | EXT12_PG | SIGNAL | VERIFIED |  | S14
U5 | LM393DR | 双比较器 #1（EXT12 / 3V3 监控） | SOIC-8 | 03_DRV | 2 | IN1- | VREF_2V5 | SIGNAL | VERIFIED |  | S14
U5 | LM393DR | 双比较器 #1（EXT12 / 3V3 监控） | SOIC-8 | 03_DRV | 3 | IN1+ | EXT12_SNS | SIGNAL | VERIFIED |  | S14
U5 | LM393DR | 双比较器 #1（EXT12 / 3V3 监控） | SOIC-8 | 03_DRV | 4 | GND | GND | GND | VERIFIED |  | S14
U5 | LM393DR | 双比较器 #1（EXT12 / 3V3 监控） | SOIC-8 | 03_DRV | 5 | IN2+ | P3V3_SNS | SIGNAL | VERIFIED |  | S14
U5 | LM393DR | 双比较器 #1（EXT12 / 3V3 监控） | SOIC-8 | 03_DRV | 6 | IN2- | VREF_2V5 | SIGNAL | VERIFIED |  | S14
U5 | LM393DR | 双比较器 #1（EXT12 / 3V3 监控） | SOIC-8 | 03_DRV | 7 | OUT2 | P3V3_PG | SIGNAL | VERIFIED |  | S14
U5 | LM393DR | 双比较器 #1（EXT12 / 3V3 监控） | SOIC-8 | 03_DRV | 8 | VCC | 3V3 | POWER | VERIFIED |  | S14
U8 | LM393DR | 双比较器 #2（DRV_VDD / 故障状态） | SOIC-8 | 03_DRV | 1 | OUT1 | DRV_PG | SIGNAL | VERIFIED |  | S14
U8 | LM393DR | 双比较器 #2（DRV_VDD / 故障状态） | SOIC-8 | 03_DRV | 2 | IN1- | VREF_2V5 | SIGNAL | VERIFIED |  | S14
U8 | LM393DR | 双比较器 #2（DRV_VDD / 故障状态） | SOIC-8 | 03_DRV | 3 | IN1+ | DRV_SNS | SIGNAL | VERIFIED |  | S14
U8 | LM393DR | 双比较器 #2（DRV_VDD / 故障状态） | SOIC-8 | 03_DRV | 4 | GND | GND | GND | VERIFIED |  | S14
U8 | LM393DR | 双比较器 #2（DRV_VDD / 故障状态） | SOIC-8 | 03_DRV | 5 | IN2+ | HVF_NODE | SIGNAL | VERIFIED |  | S14
U8 | LM393DR | 双比较器 #2（DRV_VDD / 故障状态） | SOIC-8 | 03_DRV | 6 | IN2- | VREF_2V5 | SIGNAL | VERIFIED |  | S14
U8 | LM393DR | 双比较器 #2（DRV_VDD / 故障状态） | SOIC-8 | 03_DRV | 7 | OUT2 | FAULT_OK | SIGNAL | VERIFIED |  | S14
U8 | LM393DR | 双比较器 #2（DRV_VDD / 故障状态） | SOIC-8 | 03_DRV | 8 | VCC | 3V3 | POWER | VERIFIED |  | S14
U6 | TL431 | 2.5 V 并联基准 | SOT-23 | 03_DRV | 1 | CATHODE | VREF_2V5 | SIGNAL | VERIFIED |  | S17
U6 | TL431 | 2.5 V 并联基准 | SOT-23 | 03_DRV | 2 | REF | VREF_2V5 | SIGNAL | VERIFIED |  | S17
U6 | TL431 | 2.5 V 并联基准 | SOT-23 | 03_DRV | 3 | ANODE | GND | GND | VERIFIED |  | S17
R38 | 680Ω | 680 Ω 1% | 0603 | 03_DRV | 1 | 1 | 3V3 | POWER | VERIFIED |  | S14
R38 | 680Ω | 680 Ω 1% | 0603 | 03_DRV | 2 | 2 | VREF_2V5 | SIGNAL | VERIFIED |  | S14
C32 | 100nF/16V | 0.1 µF 16 V | 0603 | 03_DRV | 1 | 1 | VREF_2V5 | SIGNAL | VERIFIED |  | S14
C32 | 100nF/16V | 0.1 µF 16 V | 0603 | 03_DRV | 2 | 2 | GND | GND | VERIFIED |  | S14
C33 | 100nF/16V | 0.1 µF 16 V | 0603 | 03_DRV | 1 | 1 | 3V3 | POWER | VERIFIED |  | S14
C33 | 100nF/16V | 0.1 µF 16 V | 0603 | 03_DRV | 2 | 2 | GND | GND | VERIFIED |  | S14
C34 | 100nF/16V | 0.1 µF 16 V | 0603 | 03_DRV | 1 | 1 | 3V3 | POWER | VERIFIED |  | S14
C34 | 100nF/16V | 0.1 µF 16 V | 0603 | 03_DRV | 2 | 2 | GND | GND | VERIFIED |  | S14
R39 | 100k | 100 kΩ 1% | 0603 | 03_DRV | 1 | 1 | EXT12 | POWER | VERIFIED |  | S14
R39 | 100k | 100 kΩ 1% | 0603 | 03_DRV | 2 | 2 | EXT12_SNS | SIGNAL | VERIFIED |  | S14
R40 | 30.1k | 30.1 kΩ 1% | 0603 | 03_DRV | 1 | 1 | EXT12_SNS | SIGNAL | VERIFIED |  | S14
R40 | 30.1k | 30.1 kΩ 1% | 0603 | 03_DRV | 2 | 2 | GND | GND | VERIFIED |  | S14
C35 | 100nF/16V | 0.1 µF 16 V | 0603 | 03_DRV | 1 | 1 | EXT12_SNS | SIGNAL | VERIFIED |  | S14
C35 | 100nF/16V | 0.1 µF 16 V | 0603 | 03_DRV | 2 | 2 | GND | GND | VERIFIED |  | S14
R41 | 10k | 10 kΩ 1% | 0603 | 03_DRV | 1 | 1 | EXT12_PG | SIGNAL | VERIFIED |  | S14
R41 | 10k | 10 kΩ 1% | 0603 | 03_DRV | 2 | 2 | 3V3 | POWER | VERIFIED |  | S14
R42 | 10k | 10 kΩ 1% | 0603 | 03_DRV | 1 | 1 | 3V3 | POWER | VERIFIED |  | S14
R42 | 10k | 10 kΩ 1% | 0603 | 03_DRV | 2 | 2 | P3V3_SNS | SIGNAL | VERIFIED |  | S14
R43 | 41.2k | 41.2 kΩ 1% | 0603 | 03_DRV | 1 | 1 | P3V3_SNS | SIGNAL | VERIFIED |  | S14
R43 | 41.2k | 41.2 kΩ 1% | 0603 | 03_DRV | 2 | 2 | GND | GND | VERIFIED |  | S14
C36 | 100nF/16V | 0.1 µF 16 V | 0603 | 03_DRV | 1 | 1 | P3V3_SNS | SIGNAL | VERIFIED |  | S14
C36 | 100nF/16V | 0.1 µF 16 V | 0603 | 03_DRV | 2 | 2 | GND | GND | VERIFIED |  | S14
R44 | 10k | 10 kΩ 1% | 0603 | 03_DRV | 1 | 1 | P3V3_PG | SIGNAL | VERIFIED |  | S14
R44 | 10k | 10 kΩ 1% | 0603 | 03_DRV | 2 | 2 | 3V3 | POWER | VERIFIED |  | S14
R45 | 100k | 100 kΩ 1% | 0603 | 03_DRV | 1 | 1 | DRV_VDD | DRV | VERIFIED |  | S14
R45 | 100k | 100 kΩ 1% | 0603 | 03_DRV | 2 | 2 | DRV_SNS | SIGNAL | VERIFIED |  | S14
R46 | 31.6k | 31.6 kΩ 1% | 0603 | 03_DRV | 1 | 1 | DRV_SNS | SIGNAL | VERIFIED |  | S14
R46 | 31.6k | 31.6 kΩ 1% | 0603 | 03_DRV | 2 | 2 | GND | GND | VERIFIED |  | S14
C37 | 100nF/16V | 0.1 µF 16 V | 0603 | 03_DRV | 1 | 1 | DRV_SNS | SIGNAL | VERIFIED |  | S14
C37 | 100nF/16V | 0.1 µF 16 V | 0603 | 03_DRV | 2 | 2 | GND | GND | VERIFIED |  | S14
R47 | 10k | 10 kΩ 1% | 0603 | 03_DRV | 1 | 1 | DRV_PG | SIGNAL | VERIFIED |  | S14
R47 | 10k | 10 kΩ 1% | 0603 | 03_DRV | 2 | 2 | 3V3 | POWER | VERIFIED |  | S14
R48 | 10k | 10 kΩ 1% | 0603 | 03_DRV | 1 | 1 | FAULT_OK | SIGNAL | VERIFIED |  | S14
R48 | 10k | 10 kΩ 1% | 0603 | 03_DRV | 2 | 2 | 3V3 | POWER | VERIFIED |  | S14
U7 | 74HC08 | 四路与门 | SOIC-14 | 03_DRV | 1 | 1A | EXT12_PG | SIGNAL | VERIFIED |  | S15
U7 | 74HC08 | 四路与门 | SOIC-14 | 03_DRV | 2 | 1B | P3V3_PG | SIGNAL | VERIFIED |  | S15
U7 | 74HC08 | 四路与门 | SOIC-14 | 03_DRV | 3 | 1Y | PG_12V3V | SIGNAL | VERIFIED |  | S15
U7 | 74HC08 | 四路与门 | SOIC-14 | 03_DRV | 4 | 2A | PG_12V3V | SIGNAL | VERIFIED |  | S15
U7 | 74HC08 | 四路与门 | SOIC-14 | 03_DRV | 5 | 2B | HV_EN_REQ | SIGNAL | VERIFIED |  | S15
U7 | 74HC08 | 四路与门 | SOIC-14 | 03_DRV | 6 | 2Y | DRV_VDD_EN | SIGNAL | VERIFIED |  | S15
U7 | 74HC08 | 四路与门 | SOIC-14 | 03_DRV | 7 | GND | GND | GND | VERIFIED |  | S15
U7 | 74HC08 | 四路与门 | SOIC-14 | 03_DRV | 8 | 3Y | DRV_OK | SIGNAL | VERIFIED |  | S15
U7 | 74HC08 | 四路与门 | SOIC-14 | 03_DRV | 9 | 3A | DRV_PG | SIGNAL | VERIFIED |  | S15
U7 | 74HC08 | 四路与门 | SOIC-14 | 03_DRV | 10 | 3B | FAULT_OK | SIGNAL | VERIFIED |  | S15
U7 | 74HC08 | 四路与门 | SOIC-14 | 03_DRV | 11 | 4Y | HV_EN | SIGNAL | VERIFIED |  | S15
U7 | 74HC08 | 四路与门 | SOIC-14 | 03_DRV | 12 | 4A | DRV_OK | SIGNAL | VERIFIED |  | S15
U7 | 74HC08 | 四路与门 | SOIC-14 | 03_DRV | 13 | 4B | HV_EN_REQ | SIGNAL | VERIFIED |  | S15
U7 | 74HC08 | 四路与门 | SOIC-14 | 03_DRV | 14 | VCC | 3V3 | POWER | VERIFIED |  | S15
C38 | 100nF/16V | 0.1 µF 16 V | 0603 | 03_DRV | 1 | 1 | 3V3 | POWER | VERIFIED |  | S15
C38 | 100nF/16V | 0.1 µF 16 V | 0603 | 03_DRV | 2 | 2 | GND | GND | VERIFIED |  | S15
R49 | 100k | 100 kΩ 1% | 0603 | 03_DRV | 1 | 1 | HV_EN | SIGNAL | VERIFIED |  | S15
R49 | 100k | 100 kΩ 1% | 0603 | 03_DRV | 2 | 2 | GND | GND | VERIFIED |  | S15
R51 | 100k | 100 kΩ 1% | 0603 | 03_DRV | 1 | 1 | HV_EN_REQ | SIGNAL | VERIFIED |  | S3
R51 | 100k | 100 kΩ 1% | 0603 | 03_DRV | 2 | 2 | GND | GND | VERIFIED |  | S3
R52 | 100k | 100 kΩ 1% | 0603 | 03_DRV | 1 | 1 | DISP_ALLOW | SIGNAL | VERIFIED |  | S3
R52 | 100k | 100 kΩ 1% | 0603 | 03_DRV | 2 | 2 | GND | GND | VERIFIED |  | S3
U21 | HV5622PJ | HV5622 32 路开漏高压驱动 | PQFP-44 | 03_DRV | 1 | HVOUT22 | K_T3_1 | HV | VERIFIED |  | S5 | S5：VPP 推荐 ≤220 V，绝对最大 230 V；VDD 10.8–13.2 V
U21 | HV5622PJ | HV5622 32 路开漏高压驱动 | PQFP-44 | 03_DRV | 2 | HVOUT21 | K_T3_0 | HV | VERIFIED |  | S5 | S5：VPP 推荐 ≤220 V，绝对最大 230 V；VDD 10.8–13.2 V
U21 | HV5622PJ | HV5622 32 路开漏高压驱动 | PQFP-44 | 03_DRV | 3 | HVOUT20 | K_T2_9 | HV | VERIFIED |  | S5 | S5：VPP 推荐 ≤220 V，绝对最大 230 V；VDD 10.8–13.2 V
U21 | HV5622PJ | HV5622 32 路开漏高压驱动 | PQFP-44 | 03_DRV | 4 | HVOUT19 | K_T2_8 | HV | VERIFIED |  | S5 | S5：VPP 推荐 ≤220 V，绝对最大 230 V；VDD 10.8–13.2 V
U21 | HV5622PJ | HV5622 32 路开漏高压驱动 | PQFP-44 | 03_DRV | 5 | HVOUT18 | K_T2_7 | HV | VERIFIED |  | S5 | S5：VPP 推荐 ≤220 V，绝对最大 230 V；VDD 10.8–13.2 V
U21 | HV5622PJ | HV5622 32 路开漏高压驱动 | PQFP-44 | 03_DRV | 6 | HVOUT17 | K_T2_6 | HV | VERIFIED |  | S5 | S5：VPP 推荐 ≤220 V，绝对最大 230 V；VDD 10.8–13.2 V
U21 | HV5622PJ | HV5622 32 路开漏高压驱动 | PQFP-44 | 03_DRV | 7 | HVOUT16 | K_T2_5 | HV | VERIFIED |  | S5 | S5：VPP 推荐 ≤220 V，绝对最大 230 V；VDD 10.8–13.2 V
U21 | HV5622PJ | HV5622 32 路开漏高压驱动 | PQFP-44 | 03_DRV | 8 | HVOUT15 | K_T2_4 | HV | VERIFIED |  | S5 | S5：VPP 推荐 ≤220 V，绝对最大 230 V；VDD 10.8–13.2 V
U21 | HV5622PJ | HV5622 32 路开漏高压驱动 | PQFP-44 | 03_DRV | 9 | HVOUT14 | K_T2_3 | HV | VERIFIED |  | S5 | S5：VPP 推荐 ≤220 V，绝对最大 230 V；VDD 10.8–13.2 V
U21 | HV5622PJ | HV5622 32 路开漏高压驱动 | PQFP-44 | 03_DRV | 10 | HVOUT13 | K_T2_2 | HV | VERIFIED |  | S5 | S5：VPP 推荐 ≤220 V，绝对最大 230 V；VDD 10.8–13.2 V
U21 | HV5622PJ | HV5622 32 路开漏高压驱动 | PQFP-44 | 03_DRV | 11 | HVOUT12 | K_T2_1 | HV | VERIFIED |  | S5 | S5：VPP 推荐 ≤220 V，绝对最大 230 V；VDD 10.8–13.2 V
U21 | HV5622PJ | HV5622 32 路开漏高压驱动 | PQFP-44 | 03_DRV | 12 | HVOUT11 | K_T2_0 | HV | VERIFIED |  | S5 | S5：VPP 推荐 ≤220 V，绝对最大 230 V；VDD 10.8–13.2 V
U21 | HV5622PJ | HV5622 32 路开漏高压驱动 | PQFP-44 | 03_DRV | 13 | HVOUT10 | K_T1_9 | HV | VERIFIED |  | S5 | S5：VPP 推荐 ≤220 V，绝对最大 230 V；VDD 10.8–13.2 V
U21 | HV5622PJ | HV5622 32 路开漏高压驱动 | PQFP-44 | 03_DRV | 14 | HVOUT9 | K_T1_8 | HV | VERIFIED |  | S5 | S5：VPP 推荐 ≤220 V，绝对最大 230 V；VDD 10.8–13.2 V
U21 | HV5622PJ | HV5622 32 路开漏高压驱动 | PQFP-44 | 03_DRV | 15 | HVOUT8 | K_T1_7 | HV | VERIFIED |  | S5 | S5：VPP 推荐 ≤220 V，绝对最大 230 V；VDD 10.8–13.2 V
U21 | HV5622PJ | HV5622 32 路开漏高压驱动 | PQFP-44 | 03_DRV | 16 | HVOUT7 | K_T1_6 | HV | VERIFIED |  | S5 | S5：VPP 推荐 ≤220 V，绝对最大 230 V；VDD 10.8–13.2 V
U21 | HV5622PJ | HV5622 32 路开漏高压驱动 | PQFP-44 | 03_DRV | 17 | HVOUT6 | K_T1_5 | HV | VERIFIED |  | S5 | S5：VPP 推荐 ≤220 V，绝对最大 230 V；VDD 10.8–13.2 V
U21 | HV5622PJ | HV5622 32 路开漏高压驱动 | PQFP-44 | 03_DRV | 18 | HVOUT5 | K_T1_4 | HV | VERIFIED |  | S5 | S5：VPP 推荐 ≤220 V，绝对最大 230 V；VDD 10.8–13.2 V
U21 | HV5622PJ | HV5622 32 路开漏高压驱动 | PQFP-44 | 03_DRV | 19 | HVOUT4 | K_T1_3 | HV | VERIFIED |  | S5 | S5：VPP 推荐 ≤220 V，绝对最大 230 V；VDD 10.8–13.2 V
U21 | HV5622PJ | HV5622 32 路开漏高压驱动 | PQFP-44 | 03_DRV | 20 | HVOUT3 | K_T1_2 | HV | VERIFIED |  | S5 | S5：VPP 推荐 ≤220 V，绝对最大 230 V；VDD 10.8–13.2 V
U21 | HV5622PJ | HV5622 32 路开漏高压驱动 | PQFP-44 | 03_DRV | 21 | HVOUT2 | K_T1_1 | HV | VERIFIED |  | S5 | S5：VPP 推荐 ≤220 V，绝对最大 230 V；VDD 10.8–13.2 V
U21 | HV5622PJ | HV5622 32 路开漏高压驱动 | PQFP-44 | 03_DRV | 22 | HVOUT1 | K_T1_0 | HV | VERIFIED |  | S5 | S5：VPP 推荐 ≤220 V，绝对最大 230 V；VDD 10.8–13.2 V
U21 | HV5622PJ | HV5622 32 路开漏高压驱动 | PQFP-44 | 03_DRV | 23 | DATA OUT | DRV1_DOUT | SIGNAL | VERIFIED |  | S5 | S5：VPP 推荐 ≤220 V，绝对最大 230 V；VDD 10.8–13.2 V
U21 | HV5622PJ | HV5622 32 路开漏高压驱动 | PQFP-44 | 03_DRV | 24 | NC |  |  | VERIFIED |  | S5 | S5：VPP 推荐 ≤220 V，绝对最大 230 V；VDD 10.8–13.2 V
U21 | HV5622PJ | HV5622 32 路开漏高压驱动 | PQFP-44 | 03_DRV | 25 | NC |  |  | VERIFIED |  | S5 | S5：VPP 推荐 ≤220 V，绝对最大 230 V；VDD 10.8–13.2 V
U21 | HV5622PJ | HV5622 32 路开漏高压驱动 | PQFP-44 | 03_DRV | 26 | NC |  |  | VERIFIED |  | S5 | S5：VPP 推荐 ≤220 V，绝对最大 230 V；VDD 10.8–13.2 V
U21 | HV5622PJ | HV5622 32 路开漏高压驱动 | PQFP-44 | 03_DRV | 27 | POL | DRV_VDD | DRV | VERIFIED |  | S5 | S5：VPP 推荐 ≤220 V，绝对最大 230 V；VDD 10.8–13.2 V
U21 | HV5622PJ | HV5622 32 路开漏高压驱动 | PQFP-44 | 03_DRV | 28 | CLK | DRV_CLK | DRV | VERIFIED |  | S5 | S5：VPP 推荐 ≤220 V，绝对最大 230 V；VDD 10.8–13.2 V
U21 | HV5622PJ | HV5622 32 路开漏高压驱动 | PQFP-44 | 03_DRV | 29 | VSS | GND | GND | VERIFIED |  | S5 | S5：VPP 推荐 ≤220 V，绝对最大 230 V；VDD 10.8–13.2 V
U21 | HV5622PJ | HV5622 32 路开漏高压驱动 | PQFP-44 | 03_DRV | 30 | VDD | DRV_VDD | DRV | VERIFIED |  | S5 | S5：VPP 推荐 ≤220 V，绝对最大 230 V；VDD 10.8–13.2 V
U21 | HV5622PJ | HV5622 32 路开漏高压驱动 | PQFP-44 | 03_DRV | 31 | LE | DRV_LAT | DRV | VERIFIED |  | S5 | S5：VPP 推荐 ≤220 V，绝对最大 230 V；VDD 10.8–13.2 V
U21 | HV5622PJ | HV5622 32 路开漏高压驱动 | PQFP-44 | 03_DRV | 32 | DATA IN | DRV_DIN | DRV | VERIFIED |  | S5 | S5：VPP 推荐 ≤220 V，绝对最大 230 V；VDD 10.8–13.2 V
U21 | HV5622PJ | HV5622 32 路开漏高压驱动 | PQFP-44 | 03_DRV | 33 | BL | DRV_BL | DRV | VERIFIED |  | S5 | S5：VPP 推荐 ≤220 V，绝对最大 230 V；VDD 10.8–13.2 V
U21 | HV5622PJ | HV5622 32 路开漏高压驱动 | PQFP-44 | 03_DRV | 34 | NC |  |  | VERIFIED |  | S5 | S5：VPP 推荐 ≤220 V，绝对最大 230 V；VDD 10.8–13.2 V
U21 | HV5622PJ | HV5622 32 路开漏高压驱动 | PQFP-44 | 03_DRV | 35 | HVOUT32 | K_T4_1 | HV | VERIFIED |  | S5 | S5：VPP 推荐 ≤220 V，绝对最大 230 V；VDD 10.8–13.2 V
U21 | HV5622PJ | HV5622 32 路开漏高压驱动 | PQFP-44 | 03_DRV | 36 | HVOUT31 | K_T4_0 | HV | VERIFIED |  | S5 | S5：VPP 推荐 ≤220 V，绝对最大 230 V；VDD 10.8–13.2 V
U21 | HV5622PJ | HV5622 32 路开漏高压驱动 | PQFP-44 | 03_DRV | 37 | HVOUT30 | K_T3_9 | HV | VERIFIED |  | S5 | S5：VPP 推荐 ≤220 V，绝对最大 230 V；VDD 10.8–13.2 V
U21 | HV5622PJ | HV5622 32 路开漏高压驱动 | PQFP-44 | 03_DRV | 38 | HVOUT29 | K_T3_8 | HV | VERIFIED |  | S5 | S5：VPP 推荐 ≤220 V，绝对最大 230 V；VDD 10.8–13.2 V
U21 | HV5622PJ | HV5622 32 路开漏高压驱动 | PQFP-44 | 03_DRV | 39 | HVOUT28 | K_T3_7 | HV | VERIFIED |  | S5 | S5：VPP 推荐 ≤220 V，绝对最大 230 V；VDD 10.8–13.2 V
U21 | HV5622PJ | HV5622 32 路开漏高压驱动 | PQFP-44 | 03_DRV | 40 | HVOUT27 | K_T3_6 | HV | VERIFIED |  | S5 | S5：VPP 推荐 ≤220 V，绝对最大 230 V；VDD 10.8–13.2 V
U21 | HV5622PJ | HV5622 32 路开漏高压驱动 | PQFP-44 | 03_DRV | 41 | HVOUT26 | K_T3_5 | HV | VERIFIED |  | S5 | S5：VPP 推荐 ≤220 V，绝对最大 230 V；VDD 10.8–13.2 V
U21 | HV5622PJ | HV5622 32 路开漏高压驱动 | PQFP-44 | 03_DRV | 42 | HVOUT25 | K_T3_4 | HV | VERIFIED |  | S5 | S5：VPP 推荐 ≤220 V，绝对最大 230 V；VDD 10.8–13.2 V
U21 | HV5622PJ | HV5622 32 路开漏高压驱动 | PQFP-44 | 03_DRV | 43 | HVOUT24 | K_T3_3 | HV | VERIFIED |  | S5 | S5：VPP 推荐 ≤220 V，绝对最大 230 V；VDD 10.8–13.2 V
U21 | HV5622PJ | HV5622 32 路开漏高压驱动 | PQFP-44 | 03_DRV | 44 | HVOUT23 | K_T3_2 | HV | VERIFIED |  | S5 | S5：VPP 推荐 ≤220 V，绝对最大 230 V；VDD 10.8–13.2 V
C39 | 10uF/25V | 10 µF 25 V X5R | 1206 | 03_DRV | 1 | 1 | DRV_VDD | DRV | VERIFIED |  | S5
C39 | 10uF/25V | 10 µF 25 V X5R | 1206 | 03_DRV | 2 | 2 | GND | GND | VERIFIED |  | S5
C41 | 100nF/50V | 0.1 µF 50 V X7R | 0603 | 03_DRV | 1 | 1 | DRV_VDD | DRV | VERIFIED |  | S5
C41 | 100nF/50V | 0.1 µF 50 V X7R | 0603 | 03_DRV | 2 | 2 | GND | GND | VERIFIED |  | S5
U22 | HV5622PJ | HV5622 32 路开漏高压驱动 | PQFP-44 | 03_DRV | 1 | HVOUT22 | K_T6_3 | HV | VERIFIED |  | S5 | S5：VPP 推荐 ≤220 V，绝对最大 230 V；VDD 10.8–13.2 V
U22 | HV5622PJ | HV5622 32 路开漏高压驱动 | PQFP-44 | 03_DRV | 2 | HVOUT21 | K_T6_2 | HV | VERIFIED |  | S5 | S5：VPP 推荐 ≤220 V，绝对最大 230 V；VDD 10.8–13.2 V
U22 | HV5622PJ | HV5622 32 路开漏高压驱动 | PQFP-44 | 03_DRV | 3 | HVOUT20 | K_T6_1 | HV | VERIFIED |  | S5 | S5：VPP 推荐 ≤220 V，绝对最大 230 V；VDD 10.8–13.2 V
U22 | HV5622PJ | HV5622 32 路开漏高压驱动 | PQFP-44 | 03_DRV | 4 | HVOUT19 | K_T6_0 | HV | VERIFIED |  | S5 | S5：VPP 推荐 ≤220 V，绝对最大 230 V；VDD 10.8–13.2 V
U22 | HV5622PJ | HV5622 32 路开漏高压驱动 | PQFP-44 | 03_DRV | 5 | HVOUT18 | K_T5_9 | HV | VERIFIED |  | S5 | S5：VPP 推荐 ≤220 V，绝对最大 230 V；VDD 10.8–13.2 V
U22 | HV5622PJ | HV5622 32 路开漏高压驱动 | PQFP-44 | 03_DRV | 6 | HVOUT17 | K_T5_8 | HV | VERIFIED |  | S5 | S5：VPP 推荐 ≤220 V，绝对最大 230 V；VDD 10.8–13.2 V
U22 | HV5622PJ | HV5622 32 路开漏高压驱动 | PQFP-44 | 03_DRV | 7 | HVOUT16 | K_T5_7 | HV | VERIFIED |  | S5 | S5：VPP 推荐 ≤220 V，绝对最大 230 V；VDD 10.8–13.2 V
U22 | HV5622PJ | HV5622 32 路开漏高压驱动 | PQFP-44 | 03_DRV | 8 | HVOUT15 | K_T5_6 | HV | VERIFIED |  | S5 | S5：VPP 推荐 ≤220 V，绝对最大 230 V；VDD 10.8–13.2 V
U22 | HV5622PJ | HV5622 32 路开漏高压驱动 | PQFP-44 | 03_DRV | 9 | HVOUT14 | K_T5_5 | HV | VERIFIED |  | S5 | S5：VPP 推荐 ≤220 V，绝对最大 230 V；VDD 10.8–13.2 V
U22 | HV5622PJ | HV5622 32 路开漏高压驱动 | PQFP-44 | 03_DRV | 10 | HVOUT13 | K_T5_4 | HV | VERIFIED |  | S5 | S5：VPP 推荐 ≤220 V，绝对最大 230 V；VDD 10.8–13.2 V
U22 | HV5622PJ | HV5622 32 路开漏高压驱动 | PQFP-44 | 03_DRV | 11 | HVOUT12 | K_T5_3 | HV | VERIFIED |  | S5 | S5：VPP 推荐 ≤220 V，绝对最大 230 V；VDD 10.8–13.2 V
U22 | HV5622PJ | HV5622 32 路开漏高压驱动 | PQFP-44 | 03_DRV | 12 | HVOUT11 | K_T5_2 | HV | VERIFIED |  | S5 | S5：VPP 推荐 ≤220 V，绝对最大 230 V；VDD 10.8–13.2 V
U22 | HV5622PJ | HV5622 32 路开漏高压驱动 | PQFP-44 | 03_DRV | 13 | HVOUT10 | K_T5_1 | HV | VERIFIED |  | S5 | S5：VPP 推荐 ≤220 V，绝对最大 230 V；VDD 10.8–13.2 V
U22 | HV5622PJ | HV5622 32 路开漏高压驱动 | PQFP-44 | 03_DRV | 14 | HVOUT9 | K_T5_0 | HV | VERIFIED |  | S5 | S5：VPP 推荐 ≤220 V，绝对最大 230 V；VDD 10.8–13.2 V
U22 | HV5622PJ | HV5622 32 路开漏高压驱动 | PQFP-44 | 03_DRV | 15 | HVOUT8 | K_T4_9 | HV | VERIFIED |  | S5 | S5：VPP 推荐 ≤220 V，绝对最大 230 V；VDD 10.8–13.2 V
U22 | HV5622PJ | HV5622 32 路开漏高压驱动 | PQFP-44 | 03_DRV | 16 | HVOUT7 | K_T4_8 | HV | VERIFIED |  | S5 | S5：VPP 推荐 ≤220 V，绝对最大 230 V；VDD 10.8–13.2 V
U22 | HV5622PJ | HV5622 32 路开漏高压驱动 | PQFP-44 | 03_DRV | 17 | HVOUT6 | K_T4_7 | HV | VERIFIED |  | S5 | S5：VPP 推荐 ≤220 V，绝对最大 230 V；VDD 10.8–13.2 V
U22 | HV5622PJ | HV5622 32 路开漏高压驱动 | PQFP-44 | 03_DRV | 18 | HVOUT5 | K_T4_6 | HV | VERIFIED |  | S5 | S5：VPP 推荐 ≤220 V，绝对最大 230 V；VDD 10.8–13.2 V
U22 | HV5622PJ | HV5622 32 路开漏高压驱动 | PQFP-44 | 03_DRV | 19 | HVOUT4 | K_T4_5 | HV | VERIFIED |  | S5 | S5：VPP 推荐 ≤220 V，绝对最大 230 V；VDD 10.8–13.2 V
U22 | HV5622PJ | HV5622 32 路开漏高压驱动 | PQFP-44 | 03_DRV | 20 | HVOUT3 | K_T4_4 | HV | VERIFIED |  | S5 | S5：VPP 推荐 ≤220 V，绝对最大 230 V；VDD 10.8–13.2 V
U22 | HV5622PJ | HV5622 32 路开漏高压驱动 | PQFP-44 | 03_DRV | 21 | HVOUT2 | K_T4_3 | HV | VERIFIED |  | S5 | S5：VPP 推荐 ≤220 V，绝对最大 230 V；VDD 10.8–13.2 V
U22 | HV5622PJ | HV5622 32 路开漏高压驱动 | PQFP-44 | 03_DRV | 22 | HVOUT1 | K_T4_2 | HV | VERIFIED |  | S5 | S5：VPP 推荐 ≤220 V，绝对最大 230 V；VDD 10.8–13.2 V
U22 | HV5622PJ | HV5622 32 路开漏高压驱动 | PQFP-44 | 03_DRV | 23 | DATA OUT | DRV2_DOUT | SIGNAL | VERIFIED |  | S5 | S5：VPP 推荐 ≤220 V，绝对最大 230 V；VDD 10.8–13.2 V
U22 | HV5622PJ | HV5622 32 路开漏高压驱动 | PQFP-44 | 03_DRV | 24 | NC |  |  | VERIFIED |  | S5 | S5：VPP 推荐 ≤220 V，绝对最大 230 V；VDD 10.8–13.2 V
U22 | HV5622PJ | HV5622 32 路开漏高压驱动 | PQFP-44 | 03_DRV | 25 | NC |  |  | VERIFIED |  | S5 | S5：VPP 推荐 ≤220 V，绝对最大 230 V；VDD 10.8–13.2 V
U22 | HV5622PJ | HV5622 32 路开漏高压驱动 | PQFP-44 | 03_DRV | 26 | NC |  |  | VERIFIED |  | S5 | S5：VPP 推荐 ≤220 V，绝对最大 230 V；VDD 10.8–13.2 V
U22 | HV5622PJ | HV5622 32 路开漏高压驱动 | PQFP-44 | 03_DRV | 27 | POL | DRV_VDD | DRV | VERIFIED |  | S5 | S5：VPP 推荐 ≤220 V，绝对最大 230 V；VDD 10.8–13.2 V
U22 | HV5622PJ | HV5622 32 路开漏高压驱动 | PQFP-44 | 03_DRV | 28 | CLK | DRV_CLK | DRV | VERIFIED |  | S5 | S5：VPP 推荐 ≤220 V，绝对最大 230 V；VDD 10.8–13.2 V
U22 | HV5622PJ | HV5622 32 路开漏高压驱动 | PQFP-44 | 03_DRV | 29 | VSS | GND | GND | VERIFIED |  | S5 | S5：VPP 推荐 ≤220 V，绝对最大 230 V；VDD 10.8–13.2 V
U22 | HV5622PJ | HV5622 32 路开漏高压驱动 | PQFP-44 | 03_DRV | 30 | VDD | DRV_VDD | DRV | VERIFIED |  | S5 | S5：VPP 推荐 ≤220 V，绝对最大 230 V；VDD 10.8–13.2 V
U22 | HV5622PJ | HV5622 32 路开漏高压驱动 | PQFP-44 | 03_DRV | 31 | LE | DRV_LAT | DRV | VERIFIED |  | S5 | S5：VPP 推荐 ≤220 V，绝对最大 230 V；VDD 10.8–13.2 V
U22 | HV5622PJ | HV5622 32 路开漏高压驱动 | PQFP-44 | 03_DRV | 32 | DATA IN | DRV1_DOUT | SIGNAL | VERIFIED |  | S5 | S5：VPP 推荐 ≤220 V，绝对最大 230 V；VDD 10.8–13.2 V
U22 | HV5622PJ | HV5622 32 路开漏高压驱动 | PQFP-44 | 03_DRV | 33 | BL | DRV_BL | DRV | VERIFIED |  | S5 | S5：VPP 推荐 ≤220 V，绝对最大 230 V；VDD 10.8–13.2 V
U22 | HV5622PJ | HV5622 32 路开漏高压驱动 | PQFP-44 | 03_DRV | 34 | NC |  |  | VERIFIED |  | S5 | S5：VPP 推荐 ≤220 V，绝对最大 230 V；VDD 10.8–13.2 V
U22 | HV5622PJ | HV5622 32 路开漏高压驱动 | PQFP-44 | 03_DRV | 35 | HVOUT32 |  |  | VERIFIED |  | S5 | S5：VPP 推荐 ≤220 V，绝对最大 230 V；VDD 10.8–13.2 V
U22 | HV5622PJ | HV5622 32 路开漏高压驱动 | PQFP-44 | 03_DRV | 36 | HVOUT31 |  |  | VERIFIED |  | S5 | S5：VPP 推荐 ≤220 V，绝对最大 230 V；VDD 10.8–13.2 V
U22 | HV5622PJ | HV5622 32 路开漏高压驱动 | PQFP-44 | 03_DRV | 37 | HVOUT30 |  |  | VERIFIED |  | S5 | S5：VPP 推荐 ≤220 V，绝对最大 230 V；VDD 10.8–13.2 V
U22 | HV5622PJ | HV5622 32 路开漏高压驱动 | PQFP-44 | 03_DRV | 38 | HVOUT29 |  |  | VERIFIED |  | S5 | S5：VPP 推荐 ≤220 V，绝对最大 230 V；VDD 10.8–13.2 V
U22 | HV5622PJ | HV5622 32 路开漏高压驱动 | PQFP-44 | 03_DRV | 39 | HVOUT28 | K_T6_9 | HV | VERIFIED |  | S5 | S5：VPP 推荐 ≤220 V，绝对最大 230 V；VDD 10.8–13.2 V
U22 | HV5622PJ | HV5622 32 路开漏高压驱动 | PQFP-44 | 03_DRV | 40 | HVOUT27 | K_T6_8 | HV | VERIFIED |  | S5 | S5：VPP 推荐 ≤220 V，绝对最大 230 V；VDD 10.8–13.2 V
U22 | HV5622PJ | HV5622 32 路开漏高压驱动 | PQFP-44 | 03_DRV | 41 | HVOUT26 | K_T6_7 | HV | VERIFIED |  | S5 | S5：VPP 推荐 ≤220 V，绝对最大 230 V；VDD 10.8–13.2 V
U22 | HV5622PJ | HV5622 32 路开漏高压驱动 | PQFP-44 | 03_DRV | 42 | HVOUT25 | K_T6_6 | HV | VERIFIED |  | S5 | S5：VPP 推荐 ≤220 V，绝对最大 230 V；VDD 10.8–13.2 V
U22 | HV5622PJ | HV5622 32 路开漏高压驱动 | PQFP-44 | 03_DRV | 43 | HVOUT24 | K_T6_5 | HV | VERIFIED |  | S5 | S5：VPP 推荐 ≤220 V，绝对最大 230 V；VDD 10.8–13.2 V
U22 | HV5622PJ | HV5622 32 路开漏高压驱动 | PQFP-44 | 03_DRV | 44 | HVOUT23 | K_T6_4 | HV | VERIFIED |  | S5 | S5：VPP 推荐 ≤220 V，绝对最大 230 V；VDD 10.8–13.2 V
C40 | 10uF/25V | 10 µF 25 V X5R | 1206 | 03_DRV | 1 | 1 | DRV_VDD | DRV | VERIFIED |  | S5
C40 | 10uF/25V | 10 µF 25 V X5R | 1206 | 03_DRV | 2 | 2 | GND | GND | VERIFIED |  | S5
C42 | 100nF/50V | 0.1 µF 50 V X7R | 0603 | 03_DRV | 1 | 1 | DRV_VDD | DRV | VERIFIED |  | S5
C42 | 100nF/50V | 0.1 µF 50 V X7R | 0603 | 03_DRV | 2 | 2 | GND | GND | VERIFIED |  | S5
J31 | J13-1A-SOCKET | 13 脚可拆管座 (QS30-1) | 13P socket | 05_TUBE | 1 | IC_KEEP_OPEN |  |  | HOLD |  | S6 | H03：J13-1A 尺寸/触点/1 脚视图/1:1 比对
J31 | J13-1A-SOCKET | 13 脚可拆管座 (QS30-1) | 13P socket | 05_TUBE | 2 | A | A_T1 | HV | HOLD |  | S6 | H03：J13-1A 尺寸/触点/1 脚视图/1:1 比对
J31 | J13-1A-SOCKET | 13 脚可拆管座 (QS30-1) | 13P socket | 05_TUBE | 3 | K0 | K_T1_0 | HV | HOLD |  | S6 | H03：J13-1A 尺寸/触点/1 脚视图/1:1 比对
J31 | J13-1A-SOCKET | 13 脚可拆管座 (QS30-1) | 13P socket | 05_TUBE | 4 | K9 | K_T1_9 | HV | HOLD |  | S6 | H03：J13-1A 尺寸/触点/1 脚视图/1:1 比对
J31 | J13-1A-SOCKET | 13 脚可拆管座 (QS30-1) | 13P socket | 05_TUBE | 5 | K8 | K_T1_8 | HV | HOLD |  | S6 | H03：J13-1A 尺寸/触点/1 脚视图/1:1 比对
J31 | J13-1A-SOCKET | 13 脚可拆管座 (QS30-1) | 13P socket | 05_TUBE | 6 | K7 | K_T1_7 | HV | HOLD |  | S6 | H03：J13-1A 尺寸/触点/1 脚视图/1:1 比对
J31 | J13-1A-SOCKET | 13 脚可拆管座 (QS30-1) | 13P socket | 05_TUBE | 7 | K6 | K_T1_6 | HV | HOLD |  | S6 | H03：J13-1A 尺寸/触点/1 脚视图/1:1 比对
J31 | J13-1A-SOCKET | 13 脚可拆管座 (QS30-1) | 13P socket | 05_TUBE | 8 | IC8_KEEP_OPEN |  |  | HOLD |  | S6 | H03：J13-1A 尺寸/触点/1 脚视图/1:1 比对
J31 | J13-1A-SOCKET | 13 脚可拆管座 (QS30-1) | 13P socket | 05_TUBE | 9 | K5 | K_T1_5 | HV | HOLD |  | S6 | H03：J13-1A 尺寸/触点/1 脚视图/1:1 比对
J31 | J13-1A-SOCKET | 13 脚可拆管座 (QS30-1) | 13P socket | 05_TUBE | 10 | K4 | K_T1_4 | HV | HOLD |  | S6 | H03：J13-1A 尺寸/触点/1 脚视图/1:1 比对
J31 | J13-1A-SOCKET | 13 脚可拆管座 (QS30-1) | 13P socket | 05_TUBE | 11 | K3 | K_T1_3 | HV | HOLD |  | S6 | H03：J13-1A 尺寸/触点/1 脚视图/1:1 比对
J31 | J13-1A-SOCKET | 13 脚可拆管座 (QS30-1) | 13P socket | 05_TUBE | 12 | K2 | K_T1_2 | HV | HOLD |  | S6 | H03：J13-1A 尺寸/触点/1 脚视图/1:1 比对
J31 | J13-1A-SOCKET | 13 脚可拆管座 (QS30-1) | 13P socket | 05_TUBE | 13 | K1 | K_T1_1 | HV | HOLD |  | S6 | H03：J13-1A 尺寸/触点/1 脚视图/1:1 比对
R90 | 10k 2W | 10 kΩ 2 W 厚膜 | 2512 | 05_TUBE | 1 | 1 | HV_BUS | HV | PROVISIONAL |  | S6 | H06：故障耗散 1.45 W 需实测/降额
R90 | 10k 2W | 10 kΩ 2 W 厚膜 | 2512 | 05_TUBE | 2 | 2 | A_MID1 | HV | PROVISIONAL |  | S6 | H06：故障耗散 1.45 W 需实测/降额
R91 | 10k 2W | 10 kΩ 2 W 厚膜 | 2512 | 05_TUBE | 1 | 1 | A_MID1 | HV | PROVISIONAL |  | S6 | H06
R91 | 10k 2W | 10 kΩ 2 W 厚膜 | 2512 | 05_TUBE | 2 | 2 | A_T1 | HV | PROVISIONAL |  | S6 | H06
J32 | J13-1A-SOCKET | 13 脚可拆管座 (QS30-1) | 13P socket | 05_TUBE | 1 | IC_KEEP_OPEN |  |  | HOLD |  | S6 | H03：J13-1A 尺寸/触点/1 脚视图/1:1 比对
J32 | J13-1A-SOCKET | 13 脚可拆管座 (QS30-1) | 13P socket | 05_TUBE | 2 | A | A_T2 | HV | HOLD |  | S6 | H03：J13-1A 尺寸/触点/1 脚视图/1:1 比对
J32 | J13-1A-SOCKET | 13 脚可拆管座 (QS30-1) | 13P socket | 05_TUBE | 3 | K0 | K_T2_0 | HV | HOLD |  | S6 | H03：J13-1A 尺寸/触点/1 脚视图/1:1 比对
J32 | J13-1A-SOCKET | 13 脚可拆管座 (QS30-1) | 13P socket | 05_TUBE | 4 | K9 | K_T2_9 | HV | HOLD |  | S6 | H03：J13-1A 尺寸/触点/1 脚视图/1:1 比对
J32 | J13-1A-SOCKET | 13 脚可拆管座 (QS30-1) | 13P socket | 05_TUBE | 5 | K8 | K_T2_8 | HV | HOLD |  | S6 | H03：J13-1A 尺寸/触点/1 脚视图/1:1 比对
J32 | J13-1A-SOCKET | 13 脚可拆管座 (QS30-1) | 13P socket | 05_TUBE | 6 | K7 | K_T2_7 | HV | HOLD |  | S6 | H03：J13-1A 尺寸/触点/1 脚视图/1:1 比对
J32 | J13-1A-SOCKET | 13 脚可拆管座 (QS30-1) | 13P socket | 05_TUBE | 7 | K6 | K_T2_6 | HV | HOLD |  | S6 | H03：J13-1A 尺寸/触点/1 脚视图/1:1 比对
J32 | J13-1A-SOCKET | 13 脚可拆管座 (QS30-1) | 13P socket | 05_TUBE | 8 | IC8_KEEP_OPEN |  |  | HOLD |  | S6 | H03：J13-1A 尺寸/触点/1 脚视图/1:1 比对
J32 | J13-1A-SOCKET | 13 脚可拆管座 (QS30-1) | 13P socket | 05_TUBE | 9 | K5 | K_T2_5 | HV | HOLD |  | S6 | H03：J13-1A 尺寸/触点/1 脚视图/1:1 比对
J32 | J13-1A-SOCKET | 13 脚可拆管座 (QS30-1) | 13P socket | 05_TUBE | 10 | K4 | K_T2_4 | HV | HOLD |  | S6 | H03：J13-1A 尺寸/触点/1 脚视图/1:1 比对
J32 | J13-1A-SOCKET | 13 脚可拆管座 (QS30-1) | 13P socket | 05_TUBE | 11 | K3 | K_T2_3 | HV | HOLD |  | S6 | H03：J13-1A 尺寸/触点/1 脚视图/1:1 比对
J32 | J13-1A-SOCKET | 13 脚可拆管座 (QS30-1) | 13P socket | 05_TUBE | 12 | K2 | K_T2_2 | HV | HOLD |  | S6 | H03：J13-1A 尺寸/触点/1 脚视图/1:1 比对
J32 | J13-1A-SOCKET | 13 脚可拆管座 (QS30-1) | 13P socket | 05_TUBE | 13 | K1 | K_T2_1 | HV | HOLD |  | S6 | H03：J13-1A 尺寸/触点/1 脚视图/1:1 比对
R92 | 10k 2W | 10 kΩ 2 W 厚膜 | 2512 | 05_TUBE | 1 | 1 | HV_BUS | HV | PROVISIONAL |  | S6 | H06：故障耗散 1.45 W 需实测/降额
R92 | 10k 2W | 10 kΩ 2 W 厚膜 | 2512 | 05_TUBE | 2 | 2 | A_MID2 | HV | PROVISIONAL |  | S6 | H06：故障耗散 1.45 W 需实测/降额
R93 | 10k 2W | 10 kΩ 2 W 厚膜 | 2512 | 05_TUBE | 1 | 1 | A_MID2 | HV | PROVISIONAL |  | S6 | H06
R93 | 10k 2W | 10 kΩ 2 W 厚膜 | 2512 | 05_TUBE | 2 | 2 | A_T2 | HV | PROVISIONAL |  | S6 | H06
J33 | J13-1A-SOCKET | 13 脚可拆管座 (QS30-1) | 13P socket | 05_TUBE | 1 | IC_KEEP_OPEN |  |  | HOLD |  | S6 | H03：J13-1A 尺寸/触点/1 脚视图/1:1 比对
J33 | J13-1A-SOCKET | 13 脚可拆管座 (QS30-1) | 13P socket | 05_TUBE | 2 | A | A_T3 | HV | HOLD |  | S6 | H03：J13-1A 尺寸/触点/1 脚视图/1:1 比对
J33 | J13-1A-SOCKET | 13 脚可拆管座 (QS30-1) | 13P socket | 05_TUBE | 3 | K0 | K_T3_0 | HV | HOLD |  | S6 | H03：J13-1A 尺寸/触点/1 脚视图/1:1 比对
J33 | J13-1A-SOCKET | 13 脚可拆管座 (QS30-1) | 13P socket | 05_TUBE | 4 | K9 | K_T3_9 | HV | HOLD |  | S6 | H03：J13-1A 尺寸/触点/1 脚视图/1:1 比对
J33 | J13-1A-SOCKET | 13 脚可拆管座 (QS30-1) | 13P socket | 05_TUBE | 5 | K8 | K_T3_8 | HV | HOLD |  | S6 | H03：J13-1A 尺寸/触点/1 脚视图/1:1 比对
J33 | J13-1A-SOCKET | 13 脚可拆管座 (QS30-1) | 13P socket | 05_TUBE | 6 | K7 | K_T3_7 | HV | HOLD |  | S6 | H03：J13-1A 尺寸/触点/1 脚视图/1:1 比对
J33 | J13-1A-SOCKET | 13 脚可拆管座 (QS30-1) | 13P socket | 05_TUBE | 7 | K6 | K_T3_6 | HV | HOLD |  | S6 | H03：J13-1A 尺寸/触点/1 脚视图/1:1 比对
J33 | J13-1A-SOCKET | 13 脚可拆管座 (QS30-1) | 13P socket | 05_TUBE | 8 | IC8_KEEP_OPEN |  |  | HOLD |  | S6 | H03：J13-1A 尺寸/触点/1 脚视图/1:1 比对
J33 | J13-1A-SOCKET | 13 脚可拆管座 (QS30-1) | 13P socket | 05_TUBE | 9 | K5 | K_T3_5 | HV | HOLD |  | S6 | H03：J13-1A 尺寸/触点/1 脚视图/1:1 比对
J33 | J13-1A-SOCKET | 13 脚可拆管座 (QS30-1) | 13P socket | 05_TUBE | 10 | K4 | K_T3_4 | HV | HOLD |  | S6 | H03：J13-1A 尺寸/触点/1 脚视图/1:1 比对
J33 | J13-1A-SOCKET | 13 脚可拆管座 (QS30-1) | 13P socket | 05_TUBE | 11 | K3 | K_T3_3 | HV | HOLD |  | S6 | H03：J13-1A 尺寸/触点/1 脚视图/1:1 比对
J33 | J13-1A-SOCKET | 13 脚可拆管座 (QS30-1) | 13P socket | 05_TUBE | 12 | K2 | K_T3_2 | HV | HOLD |  | S6 | H03：J13-1A 尺寸/触点/1 脚视图/1:1 比对
J33 | J13-1A-SOCKET | 13 脚可拆管座 (QS30-1) | 13P socket | 05_TUBE | 13 | K1 | K_T3_1 | HV | HOLD |  | S6 | H03：J13-1A 尺寸/触点/1 脚视图/1:1 比对
R94 | 10k 2W | 10 kΩ 2 W 厚膜 | 2512 | 05_TUBE | 1 | 1 | HV_BUS | HV | PROVISIONAL |  | S6 | H06：故障耗散 1.45 W 需实测/降额
R94 | 10k 2W | 10 kΩ 2 W 厚膜 | 2512 | 05_TUBE | 2 | 2 | A_MID3 | HV | PROVISIONAL |  | S6 | H06：故障耗散 1.45 W 需实测/降额
R95 | 10k 2W | 10 kΩ 2 W 厚膜 | 2512 | 05_TUBE | 1 | 1 | A_MID3 | HV | PROVISIONAL |  | S6 | H06
R95 | 10k 2W | 10 kΩ 2 W 厚膜 | 2512 | 05_TUBE | 2 | 2 | A_T3 | HV | PROVISIONAL |  | S6 | H06
J34 | J13-1A-SOCKET | 13 脚可拆管座 (QS30-1) | 13P socket | 05_TUBE | 1 | IC_KEEP_OPEN |  |  | HOLD |  | S6 | H03：J13-1A 尺寸/触点/1 脚视图/1:1 比对
J34 | J13-1A-SOCKET | 13 脚可拆管座 (QS30-1) | 13P socket | 05_TUBE | 2 | A | A_T4 | HV | HOLD |  | S6 | H03：J13-1A 尺寸/触点/1 脚视图/1:1 比对
J34 | J13-1A-SOCKET | 13 脚可拆管座 (QS30-1) | 13P socket | 05_TUBE | 3 | K0 | K_T4_0 | HV | HOLD |  | S6 | H03：J13-1A 尺寸/触点/1 脚视图/1:1 比对
J34 | J13-1A-SOCKET | 13 脚可拆管座 (QS30-1) | 13P socket | 05_TUBE | 4 | K9 | K_T4_9 | HV | HOLD |  | S6 | H03：J13-1A 尺寸/触点/1 脚视图/1:1 比对
J34 | J13-1A-SOCKET | 13 脚可拆管座 (QS30-1) | 13P socket | 05_TUBE | 5 | K8 | K_T4_8 | HV | HOLD |  | S6 | H03：J13-1A 尺寸/触点/1 脚视图/1:1 比对
J34 | J13-1A-SOCKET | 13 脚可拆管座 (QS30-1) | 13P socket | 05_TUBE | 6 | K7 | K_T4_7 | HV | HOLD |  | S6 | H03：J13-1A 尺寸/触点/1 脚视图/1:1 比对
J34 | J13-1A-SOCKET | 13 脚可拆管座 (QS30-1) | 13P socket | 05_TUBE | 7 | K6 | K_T4_6 | HV | HOLD |  | S6 | H03：J13-1A 尺寸/触点/1 脚视图/1:1 比对
J34 | J13-1A-SOCKET | 13 脚可拆管座 (QS30-1) | 13P socket | 05_TUBE | 8 | IC8_KEEP_OPEN |  |  | HOLD |  | S6 | H03：J13-1A 尺寸/触点/1 脚视图/1:1 比对
J34 | J13-1A-SOCKET | 13 脚可拆管座 (QS30-1) | 13P socket | 05_TUBE | 9 | K5 | K_T4_5 | HV | HOLD |  | S6 | H03：J13-1A 尺寸/触点/1 脚视图/1:1 比对
J34 | J13-1A-SOCKET | 13 脚可拆管座 (QS30-1) | 13P socket | 05_TUBE | 10 | K4 | K_T4_4 | HV | HOLD |  | S6 | H03：J13-1A 尺寸/触点/1 脚视图/1:1 比对
J34 | J13-1A-SOCKET | 13 脚可拆管座 (QS30-1) | 13P socket | 05_TUBE | 11 | K3 | K_T4_3 | HV | HOLD |  | S6 | H03：J13-1A 尺寸/触点/1 脚视图/1:1 比对
J34 | J13-1A-SOCKET | 13 脚可拆管座 (QS30-1) | 13P socket | 05_TUBE | 12 | K2 | K_T4_2 | HV | HOLD |  | S6 | H03：J13-1A 尺寸/触点/1 脚视图/1:1 比对
J34 | J13-1A-SOCKET | 13 脚可拆管座 (QS30-1) | 13P socket | 05_TUBE | 13 | K1 | K_T4_1 | HV | HOLD |  | S6 | H03：J13-1A 尺寸/触点/1 脚视图/1:1 比对
R96 | 10k 2W | 10 kΩ 2 W 厚膜 | 2512 | 05_TUBE | 1 | 1 | HV_BUS | HV | PROVISIONAL |  | S6 | H06：故障耗散 1.45 W 需实测/降额
R96 | 10k 2W | 10 kΩ 2 W 厚膜 | 2512 | 05_TUBE | 2 | 2 | A_MID4 | HV | PROVISIONAL |  | S6 | H06：故障耗散 1.45 W 需实测/降额
R97 | 10k 2W | 10 kΩ 2 W 厚膜 | 2512 | 05_TUBE | 1 | 1 | A_MID4 | HV | PROVISIONAL |  | S6 | H06
R97 | 10k 2W | 10 kΩ 2 W 厚膜 | 2512 | 05_TUBE | 2 | 2 | A_T4 | HV | PROVISIONAL |  | S6 | H06
J35 | J13-1A-SOCKET | 13 脚可拆管座 (QS30-1) | 13P socket | 05_TUBE | 1 | IC_KEEP_OPEN |  |  | HOLD |  | S6 | H03：J13-1A 尺寸/触点/1 脚视图/1:1 比对
J35 | J13-1A-SOCKET | 13 脚可拆管座 (QS30-1) | 13P socket | 05_TUBE | 2 | A | A_T5 | HV | HOLD |  | S6 | H03：J13-1A 尺寸/触点/1 脚视图/1:1 比对
J35 | J13-1A-SOCKET | 13 脚可拆管座 (QS30-1) | 13P socket | 05_TUBE | 3 | K0 | K_T5_0 | HV | HOLD |  | S6 | H03：J13-1A 尺寸/触点/1 脚视图/1:1 比对
J35 | J13-1A-SOCKET | 13 脚可拆管座 (QS30-1) | 13P socket | 05_TUBE | 4 | K9 | K_T5_9 | HV | HOLD |  | S6 | H03：J13-1A 尺寸/触点/1 脚视图/1:1 比对
J35 | J13-1A-SOCKET | 13 脚可拆管座 (QS30-1) | 13P socket | 05_TUBE | 5 | K8 | K_T5_8 | HV | HOLD |  | S6 | H03：J13-1A 尺寸/触点/1 脚视图/1:1 比对
J35 | J13-1A-SOCKET | 13 脚可拆管座 (QS30-1) | 13P socket | 05_TUBE | 6 | K7 | K_T5_7 | HV | HOLD |  | S6 | H03：J13-1A 尺寸/触点/1 脚视图/1:1 比对
J35 | J13-1A-SOCKET | 13 脚可拆管座 (QS30-1) | 13P socket | 05_TUBE | 7 | K6 | K_T5_6 | HV | HOLD |  | S6 | H03：J13-1A 尺寸/触点/1 脚视图/1:1 比对
J35 | J13-1A-SOCKET | 13 脚可拆管座 (QS30-1) | 13P socket | 05_TUBE | 8 | IC8_KEEP_OPEN |  |  | HOLD |  | S6 | H03：J13-1A 尺寸/触点/1 脚视图/1:1 比对
J35 | J13-1A-SOCKET | 13 脚可拆管座 (QS30-1) | 13P socket | 05_TUBE | 9 | K5 | K_T5_5 | HV | HOLD |  | S6 | H03：J13-1A 尺寸/触点/1 脚视图/1:1 比对
J35 | J13-1A-SOCKET | 13 脚可拆管座 (QS30-1) | 13P socket | 05_TUBE | 10 | K4 | K_T5_4 | HV | HOLD |  | S6 | H03：J13-1A 尺寸/触点/1 脚视图/1:1 比对
J35 | J13-1A-SOCKET | 13 脚可拆管座 (QS30-1) | 13P socket | 05_TUBE | 11 | K3 | K_T5_3 | HV | HOLD |  | S6 | H03：J13-1A 尺寸/触点/1 脚视图/1:1 比对
J35 | J13-1A-SOCKET | 13 脚可拆管座 (QS30-1) | 13P socket | 05_TUBE | 12 | K2 | K_T5_2 | HV | HOLD |  | S6 | H03：J13-1A 尺寸/触点/1 脚视图/1:1 比对
J35 | J13-1A-SOCKET | 13 脚可拆管座 (QS30-1) | 13P socket | 05_TUBE | 13 | K1 | K_T5_1 | HV | HOLD |  | S6 | H03：J13-1A 尺寸/触点/1 脚视图/1:1 比对
R98 | 10k 2W | 10 kΩ 2 W 厚膜 | 2512 | 05_TUBE | 1 | 1 | HV_BUS | HV | PROVISIONAL |  | S6 | H06：故障耗散 1.45 W 需实测/降额
R98 | 10k 2W | 10 kΩ 2 W 厚膜 | 2512 | 05_TUBE | 2 | 2 | A_MID5 | HV | PROVISIONAL |  | S6 | H06：故障耗散 1.45 W 需实测/降额
R99 | 10k 2W | 10 kΩ 2 W 厚膜 | 2512 | 05_TUBE | 1 | 1 | A_MID5 | HV | PROVISIONAL |  | S6 | H06
R99 | 10k 2W | 10 kΩ 2 W 厚膜 | 2512 | 05_TUBE | 2 | 2 | A_T5 | HV | PROVISIONAL |  | S6 | H06
J36 | J13-1A-SOCKET | 13 脚可拆管座 (QS30-1) | 13P socket | 05_TUBE | 1 | IC_KEEP_OPEN |  |  | HOLD |  | S6 | H03：J13-1A 尺寸/触点/1 脚视图/1:1 比对
J36 | J13-1A-SOCKET | 13 脚可拆管座 (QS30-1) | 13P socket | 05_TUBE | 2 | A | A_T6 | HV | HOLD |  | S6 | H03：J13-1A 尺寸/触点/1 脚视图/1:1 比对
J36 | J13-1A-SOCKET | 13 脚可拆管座 (QS30-1) | 13P socket | 05_TUBE | 3 | K0 | K_T6_0 | HV | HOLD |  | S6 | H03：J13-1A 尺寸/触点/1 脚视图/1:1 比对
J36 | J13-1A-SOCKET | 13 脚可拆管座 (QS30-1) | 13P socket | 05_TUBE | 4 | K9 | K_T6_9 | HV | HOLD |  | S6 | H03：J13-1A 尺寸/触点/1 脚视图/1:1 比对
J36 | J13-1A-SOCKET | 13 脚可拆管座 (QS30-1) | 13P socket | 05_TUBE | 5 | K8 | K_T6_8 | HV | HOLD |  | S6 | H03：J13-1A 尺寸/触点/1 脚视图/1:1 比对
J36 | J13-1A-SOCKET | 13 脚可拆管座 (QS30-1) | 13P socket | 05_TUBE | 6 | K7 | K_T6_7 | HV | HOLD |  | S6 | H03：J13-1A 尺寸/触点/1 脚视图/1:1 比对
J36 | J13-1A-SOCKET | 13 脚可拆管座 (QS30-1) | 13P socket | 05_TUBE | 7 | K6 | K_T6_6 | HV | HOLD |  | S6 | H03：J13-1A 尺寸/触点/1 脚视图/1:1 比对
J36 | J13-1A-SOCKET | 13 脚可拆管座 (QS30-1) | 13P socket | 05_TUBE | 8 | IC8_KEEP_OPEN |  |  | HOLD |  | S6 | H03：J13-1A 尺寸/触点/1 脚视图/1:1 比对
J36 | J13-1A-SOCKET | 13 脚可拆管座 (QS30-1) | 13P socket | 05_TUBE | 9 | K5 | K_T6_5 | HV | HOLD |  | S6 | H03：J13-1A 尺寸/触点/1 脚视图/1:1 比对
J36 | J13-1A-SOCKET | 13 脚可拆管座 (QS30-1) | 13P socket | 05_TUBE | 10 | K4 | K_T6_4 | HV | HOLD |  | S6 | H03：J13-1A 尺寸/触点/1 脚视图/1:1 比对
J36 | J13-1A-SOCKET | 13 脚可拆管座 (QS30-1) | 13P socket | 05_TUBE | 11 | K3 | K_T6_3 | HV | HOLD |  | S6 | H03：J13-1A 尺寸/触点/1 脚视图/1:1 比对
J36 | J13-1A-SOCKET | 13 脚可拆管座 (QS30-1) | 13P socket | 05_TUBE | 12 | K2 | K_T6_2 | HV | HOLD |  | S6 | H03：J13-1A 尺寸/触点/1 脚视图/1:1 比对
J36 | J13-1A-SOCKET | 13 脚可拆管座 (QS30-1) | 13P socket | 05_TUBE | 13 | K1 | K_T6_1 | HV | HOLD |  | S6 | H03：J13-1A 尺寸/触点/1 脚视图/1:1 比对
R100 | 10k 2W | 10 kΩ 2 W 厚膜 | 2512 | 05_TUBE | 1 | 1 | HV_BUS | HV | PROVISIONAL |  | S6 | H06：故障耗散 1.45 W 需实测/降额
R100 | 10k 2W | 10 kΩ 2 W 厚膜 | 2512 | 05_TUBE | 2 | 2 | A_MID6 | HV | PROVISIONAL |  | S6 | H06：故障耗散 1.45 W 需实测/降额
R101 | 10k 2W | 10 kΩ 2 W 厚膜 | 2512 | 05_TUBE | 1 | 1 | A_MID6 | HV | PROVISIONAL |  | S6 | H06
R101 | 10k 2W | 10 kΩ 2 W 厚膜 | 2512 | 05_TUBE | 2 | 2 | A_T6 | HV | PROVISIONAL |  | S6 | H06
Q26 | DMP3098L | P-MOSFET 30 V/3.8 A | SOT-23 | 04_HV | 1 | G | Q26_G | SIGNAL | PROVISIONAL |  | S16 | H06
Q26 | DMP3098L | P-MOSFET 30 V/3.8 A | SOT-23 | 04_HV | 2 | S | EXT12 | POWER | PROVISIONAL |  | S16 | H06
Q26 | DMP3098L | P-MOSFET 30 V/3.8 A | SOT-23 | 04_HV | 3 | D | HV_IN | POWER | PROVISIONAL |  | S16 | H06
R87 | 100k | 100 kΩ 1% | 0603 | 04_HV | 1 | 1 | EXT12 | POWER | VERIFIED |  | S16
R87 | 100k | 100 kΩ 1% | 0603 | 04_HV | 2 | 2 | Q26_G | SIGNAL | VERIFIED |  | S16
R88 | 100Ω | 100 Ω 1% | 0603 | 04_HV | 1 | 1 | HV_EN | SIGNAL | VERIFIED |  | S16
R88 | 100Ω | 100 Ω 1% | 0603 | 04_HV | 2 | 2 | HV_EN_G | SIGNAL | VERIFIED |  | S16
Q27 | 2N7002 | N-MOSFET 60 V | SOT-23 | 04_HV | 1 | G | HV_EN_G | SIGNAL | VERIFIED |  | S16
Q27 | 2N7002 | N-MOSFET 60 V | SOT-23 | 04_HV | 2 | S | GND | GND | VERIFIED |  | S16
Q27 | 2N7002 | N-MOSFET 60 V | SOT-23 | 04_HV | 3 | D | Q26_G | SIGNAL | VERIFIED |  | S16
R89 | 100k | 100 kΩ 1% | 0603 | 04_HV | 1 | 1 | HV_EN_G | SIGNAL | VERIFIED |  | S16
R89 | 100k | 100 kΩ 1% | 0603 | 04_HV | 2 | 2 | GND | GND | VERIFIED |  | S16
C43 | 10uF/25V | 10 µF 25 V X5R | 1206 | 04_HV | 1 | 1 | HV_IN | POWER | VERIFIED |  | S16
C43 | 10uF/25V | 10 µF 25 V X5R | 1206 | 04_HV | 2 | 2 | GND | GND | VERIFIED |  | S16
U20 | UC3843AN | UC3843 电流型 PWM 控制器 | DIP-8/SOIC-8 | 04_HV | 1 | COMP | COMP_N | HV | VERIFIED |  | S17 | H06：开关频率/占空比/环路待实测
U20 | UC3843AN | UC3843 电流型 PWM 控制器 | DIP-8/SOIC-8 | 04_HV | 2 | FB | FB_HV | HV | VERIFIED |  | S17 | H06：开关频率/占空比/环路待实测
U20 | UC3843AN | UC3843 电流型 PWM 控制器 | DIP-8/SOIC-8 | 04_HV | 3 | CS | CS_FILT | SIGNAL | VERIFIED |  | S17 | H06：开关频率/占空比/环路待实测
U20 | UC3843AN | UC3843 电流型 PWM 控制器 | DIP-8/SOIC-8 | 04_HV | 4 | RT/CT | RCT_N | SIGNAL | VERIFIED |  | S17 | H06：开关频率/占空比/环路待实测
U20 | UC3843AN | UC3843 电流型 PWM 控制器 | DIP-8/SOIC-8 | 04_HV | 5 | GND | GND | GND | VERIFIED |  | S17 | H06：开关频率/占空比/环路待实测
U20 | UC3843AN | UC3843 电流型 PWM 控制器 | DIP-8/SOIC-8 | 04_HV | 6 | OUT | GATE_N | SIGNAL | VERIFIED |  | S17 | H06：开关频率/占空比/环路待实测
U20 | UC3843AN | UC3843 电流型 PWM 控制器 | DIP-8/SOIC-8 | 04_HV | 7 | VCC | VCC_HV | SIGNAL | VERIFIED |  | S17 | H06：开关频率/占空比/环路待实测
U20 | UC3843AN | UC3843 电流型 PWM 控制器 | DIP-8/SOIC-8 | 04_HV | 8 | VREF | VREF5_HV | SIGNAL | VERIFIED |  | S17 | H06：开关频率/占空比/环路待实测
R60 | 10Ω | 10 Ω 1% | 0805 | 04_HV | 1 | 1 | HV_IN | POWER | VERIFIED |  | S17
R60 | 10Ω | 10 Ω 1% | 0805 | 04_HV | 2 | 2 | VCC_HV | SIGNAL | VERIFIED |  | S17
C44 | 10uF/25V | 10 µF 25 V X5R | 1206 | 04_HV | 1 | 1 | VCC_HV | SIGNAL | VERIFIED |  | S17
C44 | 10uF/25V | 10 µF 25 V X5R | 1206 | 04_HV | 2 | 2 | GND | GND | VERIFIED |  | S17
C45 | 100nF/25V | 0.1 µF 25 V | 0603 | 04_HV | 1 | 1 | VCC_HV | SIGNAL | VERIFIED |  | S17
C45 | 100nF/25V | 0.1 µF 25 V | 0603 | 04_HV | 2 | 2 | GND | GND | VERIFIED |  | S17
C46 | 100nF/16V | 0.1 µF 16 V | 0603 | 04_HV | 1 | 1 | VREF5_HV | SIGNAL | VERIFIED |  | S17
C46 | 100nF/16V | 0.1 µF 16 V | 0603 | 04_HV | 2 | 2 | GND | GND | VERIFIED |  | S17
R61 | 10k | 10 kΩ 1% | 0603 | 04_HV | 1 | 1 | VREF5_HV | SIGNAL | VERIFIED |  | S17
R61 | 10k | 10 kΩ 1% | 0603 | 04_HV | 2 | 2 | RCT_N | SIGNAL | VERIFIED |  | S17
C47 | 2.2nF/50V | 2.2 nF 50 V | 0603 | 04_HV | 1 | 1 | RCT_N | SIGNAL | VERIFIED |  | S17
C47 | 2.2nF/50V | 2.2 nF 50 V | 0603 | 04_HV | 2 | 2 | GND | GND | VERIFIED |  | S17
R62 | 1Ω 1W | 1 Ω 1 W 合金采样 | 2512 | 04_HV | 1 | 1 | CS_N | HV | PROVISIONAL |  | S17 | H06
R62 | 1Ω 1W | 1 Ω 1 W 合金采样 | 2512 | 04_HV | 2 | 2 | GND | GND | PROVISIONAL |  | S17 | H06
R63 | 100Ω | 100 Ω 1% | 0603 | 04_HV | 1 | 1 | CS_N | HV | VERIFIED |  | S17
R63 | 100Ω | 100 Ω 1% | 0603 | 04_HV | 2 | 2 | CS_FILT | SIGNAL | VERIFIED |  | S17
C48 | 470pF/50V | 470 pF 50 V | 0603 | 04_HV | 1 | 1 | CS_FILT | SIGNAL | VERIFIED |  | S17
C48 | 470pF/50V | 470 pF 50 V | 0603 | 04_HV | 2 | 2 | GND | GND | VERIFIED |  | S17
R64 | 22Ω | 22 Ω 1% | 0603 | 04_HV | 1 | 1 | GATE_N | SIGNAL | VERIFIED |  | S17
R64 | 22Ω | 22 Ω 1% | 0603 | 04_HV | 2 | 2 | Q20_G | SIGNAL | VERIFIED |  | S17
R65 | 10k | 10 kΩ 1% | 0603 | 04_HV | 1 | 1 | Q20_G | SIGNAL | VERIFIED |  | S17
R65 | 10k | 10 kΩ 1% | 0603 | 04_HV | 2 | 2 | GND | GND | VERIFIED |  | S17
Q20 | IRF740 | N-MOSFET 400 V/10 A | TO-220 | 04_HV | 1 | G | Q20_G | SIGNAL | VERIFIED |  | S18 | H06：需实测 Vds 振铃/温升/雪崩
Q20 | IRF740 | N-MOSFET 400 V/10 A | TO-220 | 04_HV | 2 | D | SW_HV | HV | VERIFIED |  | S18 | H06：需实测 Vds 振铃/温升/雪崩
Q20 | IRF740 | N-MOSFET 400 V/10 A | TO-220 | 04_HV | 3 | S | CS_N | HV | VERIFIED |  | S18 | H06：需实测 Vds 振铃/温升/雪崩
L20 | 220uH/5A | 220 µH ≥5 A 功率电感（Isat≥5A） | 12x12 屏蔽 | 04_HV | 1 | 1 | HV_IN | POWER | PROVISIONAL |  | S17 | H06：ΔI≈0.65 A @78 kHz
L20 | 220uH/5A | 220 µH ≥5 A 功率电感（Isat≥5A） | 12x12 屏蔽 | 04_HV | 2 | 2 | SW_HV | HV | PROVISIONAL |  | S17 | H06：ΔI≈0.65 A @78 kHz
D20 | UF4007 | 1000 V 1 A 快恢复 | SMA/DO-41 | 04_HV | 1 | K | HV_BUS | HV | VERIFIED |  | S17
D20 | UF4007 | 1000 V 1 A 快恢复 | SMA/DO-41 | 04_HV | 2 | A | SW_HV | HV | VERIFIED |  | S17
D21 | UF4007 | 1000 V 1 A 快恢复 | SMA/DO-41 | 04_HV | 1 | K | CLAMP_N | HV | VERIFIED |  | S17
D21 | UF4007 | 1000 V 1 A 快恢复 | SMA/DO-41 | 04_HV | 2 | A | SW_HV | HV | VERIFIED |  | S17
C49 | 10nF/630V | 10 nF 630 V X7R | 1206 | 04_HV | 1 | 1 | CLAMP_N | HV | VERIFIED |  | S17
C49 | 10nF/630V | 10 nF 630 V X7R | 1206 | 04_HV | 2 | 2 | HV_BUS | HV | VERIFIED |  | S17
R66 | 100k 2W | 100 kΩ 2 W | 2512 | 04_HV | 1 | 1 | CLAMP_N | HV | PROVISIONAL |  | S17 | H06
R66 | 100k 2W | 100 kΩ 2 W | 2512 | 04_HV | 2 | 2 | HV_BUS | HV | PROVISIONAL |  | S17 | H06
C50 | 10uF/250V | 10 µF 250 V 电解 | 10x12.5 SMD | 04_HV | 1 | 1 | HV_BUS | HV | PROVISIONAL |  | S17 | H06
C50 | 10uF/250V | 10 µF 250 V 电解 | 10x12.5 SMD | 04_HV | 2 | 2 | GND | GND | PROVISIONAL |  | S17 | H06
C51 | 10uF/250V | 10 µF 250 V 电解 | 10x12.5 SMD | 04_HV | 1 | 1 | HV_BUS | HV | PROVISIONAL |  | S17 | H06
C51 | 10uF/250V | 10 µF 250 V 电解 | 10x12.5 SMD | 04_HV | 2 | 2 | GND | GND | PROVISIONAL |  | S17 | H06
C52 | 100nF/630V | 0.1 µF 630 V | 1206 | 04_HV | 1 | 1 | HV_BUS | HV | VERIFIED |  | S17
C52 | 100nF/630V | 0.1 µF 630 V | 1206 | 04_HV | 2 | 2 | GND | GND | VERIFIED |  | S17
R67 | 100k | 100 kΩ 1% | 1206 | 04_HV | 1 | 1 | HV_BUS | HV | VERIFIED |  | S17
R67 | 100k | 100 kΩ 1% | 1206 | 04_HV | 2 | 2 | BLEED_MID | HV | VERIFIED |  | S17
R68 | 100k | 100 kΩ 1% | 1206 | 04_HV | 1 | 1 | BLEED_MID | HV | VERIFIED |  | S17
R68 | 100k | 100 kΩ 1% | 1206 | 04_HV | 2 | 2 | GND | GND | VERIFIED |  | S17
C53 | 100nF/50V | 0.1 µF 50 V | 0603 | 04_HV | 1 | 1 | BLEED_MID | HV | VERIFIED |  | S17
C53 | 100nF/50V | 0.1 µF 50 V | 0603 | 04_HV | 2 | 2 | GND | GND | VERIFIED |  | S17
R69 | 750k | 750 kΩ 1% | 1206 | 04_HV | 1 | 1 | HV_BUS | HV | VERIFIED |  | S17
R69 | 750k | 750 kΩ 1% | 1206 | 04_HV | 2 | 2 | FB_MID | HV | VERIFIED |  | S17
R70 | 750k | 750 kΩ 1% | 1206 | 04_HV | 1 | 1 | FB_MID | HV | VERIFIED |  | S17
R70 | 750k | 750 kΩ 1% | 1206 | 04_HV | 2 | 2 | FB_HV | HV | VERIFIED |  | S17
R71 | 22.1k | 22.1 kΩ 1% | 0603 | 04_HV | 1 | 1 | FB_HV | HV | VERIFIED |  | S17
R71 | 22.1k | 22.1 kΩ 1% | 0603 | 04_HV | 2 | 2 | GND | GND | VERIFIED |  | S17
C54 | 100nF/50V | 0.1 µF 50 V | 0603 | 04_HV | 1 | 1 | FB_HV | HV | VERIFIED |  | S17
C54 | 100nF/50V | 0.1 µF 50 V | 0603 | 04_HV | 2 | 2 | GND | GND | VERIFIED |  | S17
C55 | 22uF/16V | 22 µF 16 V X5R | 0805 | 04_HV | 1 | 1 | COMP_N | HV | VERIFIED |  | S17
C55 | 22uF/16V | 22 µF 16 V X5R | 0805 | 04_HV | 2 | 2 | GND | GND | VERIFIED |  | S17
R72 | 10k | 10 kΩ 1% | 0603 | 04_HV | 1 | 1 | COMP_N | HV | VERIFIED |  | S17
R72 | 10k | 10 kΩ 1% | 0603 | 04_HV | 2 | 2 | COMP_R | SIGNAL | VERIFIED |  | S17
C56 | 100nF/16V | 0.1 µF 16 V | 0603 | 04_HV | 1 | 1 | COMP_R | SIGNAL | VERIFIED |  | S17
C56 | 100nF/16V | 0.1 µF 16 V | 0603 | 04_HV | 2 | 2 | GND | GND | VERIFIED |  | S17
U23 | LM393DR | OVP 比较器 | SOIC-8 | 04_HV | 1 | OUT1 | OVP_SET | HV | VERIFIED |  | S19
U23 | LM393DR | OVP 比较器 | SOIC-8 | 04_HV | 2 | IN1- | VREF_OVP | HV | VERIFIED |  | S19
U23 | LM393DR | OVP 比较器 | SOIC-8 | 04_HV | 3 | IN1+ | OVP_SNS | HV | VERIFIED |  | S19
U23 | LM393DR | OVP 比较器 | SOIC-8 | 04_HV | 4 | GND | GND | GND | VERIFIED |  | S19
U23 | LM393DR | OVP 比较器 | SOIC-8 | 04_HV | 5 | IN2+ |  |  | VERIFIED |  | S19
U23 | LM393DR | OVP 比较器 | SOIC-8 | 04_HV | 6 | IN2- |  |  | VERIFIED |  | S19
U23 | LM393DR | OVP 比较器 | SOIC-8 | 04_HV | 7 | OUT2 |  |  | VERIFIED |  | S19
U23 | LM393DR | OVP 比较器 | SOIC-8 | 04_HV | 8 | VCC | EXT12 | POWER | VERIFIED |  | S19
U24 | TL431 | 2.5 V 基准 | SOT-23 | 04_HV | 1 | CATHODE | VREF_OVP | HV | VERIFIED |  | S17
U24 | TL431 | 2.5 V 基准 | SOT-23 | 04_HV | 2 | REF | VREF_OVP | HV | VERIFIED |  | S17
U24 | TL431 | 2.5 V 基准 | SOT-23 | 04_HV | 3 | ANODE | GND | GND | VERIFIED |  | S17
R74 | 4.7k | 4.7 kΩ 1% | 0603 | 04_HV | 1 | 1 | EXT12 | POWER | VERIFIED |  | S19
R74 | 4.7k | 4.7 kΩ 1% | 0603 | 04_HV | 2 | 2 | VREF_OVP | HV | VERIFIED |  | S19
C57 | 100nF/16V | 0.1 µF 16 V | 0603 | 04_HV | 1 | 1 | VREF_OVP | HV | VERIFIED |  | S19
C57 | 100nF/16V | 0.1 µF 16 V | 0603 | 04_HV | 2 | 2 | GND | GND | VERIFIED |  | S19
R75 | 750k | 750 kΩ 1% | 1206 | 04_HV | 1 | 1 | HV_BUS | HV | VERIFIED |  | S19
R75 | 750k | 750 kΩ 1% | 1206 | 04_HV | 2 | 2 | OVP_MID | HV | VERIFIED |  | S19
R76 | 750k | 750 kΩ 1% | 1206 | 04_HV | 1 | 1 | OVP_MID | HV | VERIFIED |  | S19
R76 | 750k | 750 kΩ 1% | 1206 | 04_HV | 2 | 2 | OVP_SNS | HV | VERIFIED |  | S19
R77 | 19.1k | 19.1 kΩ 1% | 0603 | 04_HV | 1 | 1 | OVP_SNS | HV | VERIFIED |  | S19
R77 | 19.1k | 19.1 kΩ 1% | 0603 | 04_HV | 2 | 2 | GND | GND | VERIFIED |  | S19
C58 | 100nF/50V | 0.1 µF 50 V | 0603 | 04_HV | 1 | 1 | OVP_SNS | HV | VERIFIED |  | S19
C58 | 100nF/50V | 0.1 µF 50 V | 0603 | 04_HV | 2 | 2 | GND | GND | VERIFIED |  | S19
R78 | 10k | 10 kΩ 1% | 0603 | 04_HV | 1 | 1 | OVP_SET | HV | VERIFIED |  | S19
R78 | 10k | 10 kΩ 1% | 0603 | 04_HV | 2 | 2 | EXT12 | POWER | VERIFIED |  | S19
C59 | 100nF/25V | 0.1 µF 25 V | 0603 | 04_HV | 1 | 1 | EXT12 | POWER | VERIFIED |  | S19
C59 | 100nF/25V | 0.1 µF 25 V | 0603 | 04_HV | 2 | 2 | GND | GND | VERIFIED |  | S19
Q21 | MMBT3906 | PNP 40 V | SOT-23 | 04_HV | 1 | B | LATCH_B | HV | VERIFIED |  | S19
Q21 | MMBT3906 | PNP 40 V | SOT-23 | 04_HV | 2 | E | EXT12 | POWER | VERIFIED |  | S19
Q21 | MMBT3906 | PNP 40 V | SOT-23 | 04_HV | 3 | C | OVP_LATCH | HV | VERIFIED |  | S19
Q22 | MMBT3904 | NPN 40 V | SOT-23 | 04_HV | 1 | B | OVP_LATCH | HV | VERIFIED |  | S19
Q22 | MMBT3904 | NPN 40 V | SOT-23 | 04_HV | 2 | E | GND | GND | VERIFIED |  | S19
Q22 | MMBT3904 | NPN 40 V | SOT-23 | 04_HV | 3 | C | LATCH_B | HV | VERIFIED |  | S19
R79 | 100k | 100 kΩ 1% | 0603 | 04_HV | 1 | 1 | LATCH_B | HV | VERIFIED |  | S19
R79 | 100k | 100 kΩ 1% | 0603 | 04_HV | 2 | 2 | EXT12 | POWER | VERIFIED |  | S19
R80 | 10k | 10 kΩ 1% | 0603 | 04_HV | 1 | 1 | OVP_SET | HV | VERIFIED |  | S19
R80 | 10k | 10 kΩ 1% | 0603 | 04_HV | 2 | 2 | LATCH_B | HV | VERIFIED |  | S19
R81 | 100k | 100 kΩ 1% | 0603 | 04_HV | 1 | 1 | OVP_LATCH | HV | VERIFIED |  | S19
R81 | 100k | 100 kΩ 1% | 0603 | 04_HV | 2 | 2 | GND | GND | VERIFIED |  | S19
C60 | 100nF/25V | 0.1 µF 25 V | 0603 | 04_HV | 1 | 1 | OVP_LATCH | HV | VERIFIED |  | S19
C60 | 100nF/25V | 0.1 µF 25 V | 0603 | 04_HV | 2 | 2 | GND | GND | VERIFIED |  | S19
Q23 | MMBT3904 | NPN 40 V | SOT-23 | 04_HV | 1 | B | Q23_B | SIGNAL | VERIFIED |  | S19
Q23 | MMBT3904 | NPN 40 V | SOT-23 | 04_HV | 2 | E | GND | GND | VERIFIED |  | S19
Q23 | MMBT3904 | NPN 40 V | SOT-23 | 04_HV | 3 | C | COMP_N | HV | VERIFIED |  | S19
R82 | 47k | 47 kΩ 1% | 0603 | 04_HV | 1 | 1 | OVP_LATCH | HV | VERIFIED |  | S19
R82 | 47k | 47 kΩ 1% | 0603 | 04_HV | 2 | 2 | Q23_B | SIGNAL | VERIFIED |  | S19
Q24 | MMBT3904 | NPN 40 V | SOT-23 | 04_HV | 1 | B | Q24_B | SIGNAL | VERIFIED |  | S19
Q24 | MMBT3904 | NPN 40 V | SOT-23 | 04_HV | 2 | E | GND | GND | VERIFIED |  | S19
Q24 | MMBT3904 | NPN 40 V | SOT-23 | 04_HV | 3 | C | HV_FAULT_OD | SIGNAL | VERIFIED |  | S19
R83 | 47k | 47 kΩ 1% | 0603 | 04_HV | 1 | 1 | OVP_LATCH | HV | VERIFIED |  | S19
R83 | 47k | 47 kΩ 1% | 0603 | 04_HV | 2 | 2 | Q24_B | SIGNAL | VERIFIED |  | S19
R84 | 100k | 100 kΩ 1% | 0603 | 04_HV | 1 | 1 | HV_FAULT_OD | SIGNAL | VERIFIED |  | S19
R84 | 100k | 100 kΩ 1% | 0603 | 04_HV | 2 | 2 | DRV_VDD | DRV | VERIFIED |  | S19
Q25 | 2N7002 | N-MOSFET 60 V | SOT-23 | 04_HV | 1 | G | OVP_RST_G | SIGNAL | VERIFIED |  | S19
Q25 | 2N7002 | N-MOSFET 60 V | SOT-23 | 04_HV | 2 | S | GND | GND | VERIFIED |  | S19
Q25 | 2N7002 | N-MOSFET 60 V | SOT-23 | 04_HV | 3 | D | OVP_LATCH | HV | VERIFIED |  | S19
R85 | 1k | 1 kΩ 1% | 0603 | 04_HV | 1 | 1 | OVP_RST | SIGNAL | VERIFIED |  | S19
R85 | 1k | 1 kΩ 1% | 0603 | 04_HV | 2 | 2 | OVP_RST_G | SIGNAL | VERIFIED |  | S19
R86 | 100k | 100 kΩ 1% | 0603 | 04_HV | 1 | 1 | OVP_RST_G | SIGNAL | VERIFIED |  | S19
R86 | 100k | 100 kΩ 1% | 0603 | 04_HV | 2 | 2 | GND | GND | VERIFIED |  | S19
C61 | 100nF/16V | 0.1 µF 16 V | 0603 | 04_HV | 1 | 1 | OVP_RST_G | SIGNAL | VERIFIED |  | S19
C61 | 100nF/16V | 0.1 µF 16 V | 0603 | 04_HV | 2 | 2 | GND | GND | VERIFIED |  | S19
TP1 | TP-EXT12 | 测试点 EXT12 | 1.0mm pad | 06_TP | 1 | 1 | EXT12 | POWER | VERIFIED |  | S20
TP2 | TP-EXT5 | 测试点 EXT5 | 1.0mm pad | 06_TP | 1 | 1 | EXT5 | POWER | VERIFIED |  | S20
TP3 | TP-5V_SYS | 测试点 5V_SYS | 1.0mm pad | 06_TP | 1 | 1 | 5V_SYS | POWER | VERIFIED |  | S20
TP4 | TP-3V3 | 测试点 3V3 | 1.0mm pad | 06_TP | 1 | 1 | 3V3 | POWER | VERIFIED |  | S20
TP5 | TP-DRV_VDD | 测试点 DRV_VDD | 1.0mm pad | 06_TP | 1 | 1 | DRV_VDD | DRV | VERIFIED |  | S20
TP6 | TP-HV_BUS | 测试点 HV_BUS | 1.0mm pad | 06_TP | 1 | 1 | HV_BUS | HV | VERIFIED |  | S20
TP7 | TP-GND | 测试点 GND | 1.0mm pad | 06_TP | 1 | 1 | GND | GND | VERIFIED |  | S20
TP8 | TP-EN_MCU | 测试点 EN_MCU | 1.0mm pad | 06_TP | 1 | 1 | EN_MCU | SIGNAL | VERIFIED |  | S20
TP9 | TP-BOOT_N | 测试点 BOOT_N | 1.0mm pad | 06_TP | 1 | 1 | BOOT_N | SIGNAL | VERIFIED |  | S20
TP10 | TP-UART0_TX | 测试点 UART0_TX | 1.0mm pad | 06_TP | 1 | 1 | UART0_TX | SIGNAL | VERIFIED |  | S20
TP11 | TP-UART0_RX | 测试点 UART0_RX | 1.0mm pad | 06_TP | 1 | 1 | UART0_RX | SIGNAL | VERIFIED |  | S20
TP12 | TP-HV_SENSE_ADC | 测试点 HV_SENSE_ADC | 1.0mm pad | 06_TP | 1 | 1 | HV_SENSE_ADC | SIGNAL | VERIFIED |  | S20
TP13 | TP-HVF_NODE | 测试点 HVF_NODE | 1.0mm pad | 06_TP | 1 | 1 | HVF_NODE | SIGNAL | VERIFIED |  | S20
TP14 | TP-EXT12_PG | 测试点 EXT12_PG | 1.0mm pad | 06_TP | 1 | 1 | EXT12_PG | SIGNAL | VERIFIED |  | S20
TP15 | TP-P3V3_PG | 测试点 P3V3_PG | 1.0mm pad | 06_TP | 1 | 1 | P3V3_PG | SIGNAL | VERIFIED |  | S20
TP16 | TP-DRV_PG | 测试点 DRV_PG | 1.0mm pad | 06_TP | 1 | 1 | DRV_PG | SIGNAL | VERIFIED |  | S20
TP17 | TP-HV_EN | 测试点 HV_EN | 1.0mm pad | 06_TP | 1 | 1 | HV_EN | SIGNAL | VERIFIED |  | S20
TP18 | TP-DRV_HV_EN_REQ | 测试点 DRV_HV_EN_REQ | 1.0mm pad | 06_TP | 1 | 1 | DRV_HV_EN_REQ | DRV | VERIFIED |  | S20
TP19 | TP-OVP_LATCH | 测试点 OVP_LATCH | 1.0mm pad | 06_TP | 1 | 1 | OVP_LATCH | HV | VERIFIED |  | S20
TP20 | TP-DRV2_DOUT | 测试点 DRV2_DOUT | 1.0mm pad | 06_TP | 1 | 1 | DRV2_DOUT | SIGNAL | VERIFIED |  | S20
J4 | HDR-1x6-2.54 | 扩展接口 1x6 | 2.54mm | 06_TP | 1 | 1 | 3V3 | POWER | VERIFIED |  | S3
J4 | HDR-1x6-2.54 | 扩展接口 1x6 | 2.54mm | 06_TP | 2 | 2 | GND | GND | VERIFIED |  | S3
J4 | HDR-1x6-2.54 | 扩展接口 1x6 | 2.54mm | 06_TP | 3 | 3 | EXP_IO13 | SIGNAL | VERIFIED |  | S3
J4 | HDR-1x6-2.54 | 扩展接口 1x6 | 2.54mm | 06_TP | 4 | 4 | EXP_IO21 | SIGNAL | VERIFIED |  | S3
J4 | HDR-1x6-2.54 | 扩展接口 1x6 | 2.54mm | 06_TP | 5 | 5 | I2C_SDA | SIGNAL | VERIFIED |  | S3
J4 | HDR-1x6-2.54 | 扩展接口 1x6 | 2.54mm | 06_TP | 6 | 6 | I2C_SCL | SIGNAL | VERIFIED |  | S3
