langxie29-cpu/QS30-driver/sim/results/02_load_and_line_step.png

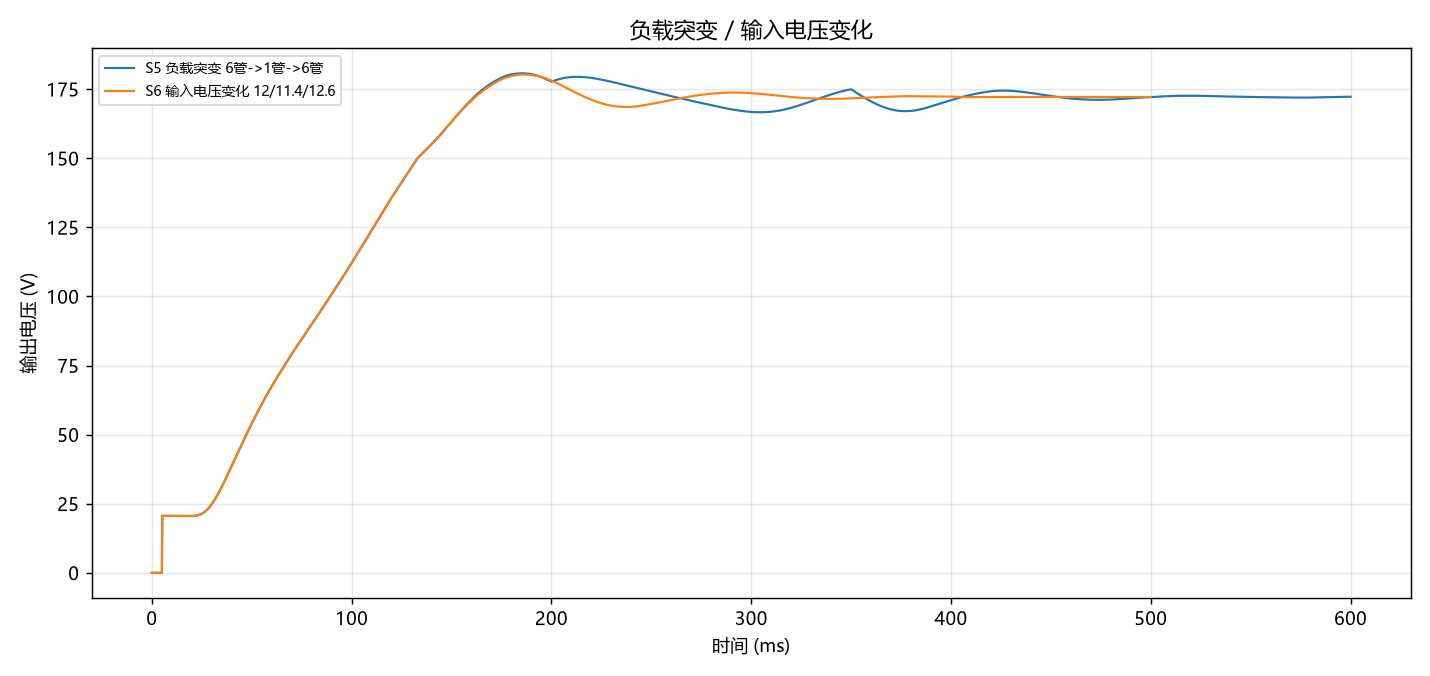
sim/results/02_load_and_line_step.png
