langxie29-cpu/QS30-driver/docs/test_plan.md

# QS30-6 REV.A 首轮上电与验证计划

版本 r1 ｜ 2026-10-18 ｜ 适用于 REV.A 样机（HOLD 全部关闭前不得投板）

记录要求：每个阶段保存 **输入电压、测点、负载、仪器型号、固件版本、环境温度、原始截图/波形、结论**。
任何失败必须生成可追溯问题单（编号 I-xx/H-xx），修改变更写入 `REV_A_CHANGELOG.md`。

---

## 阶段 A — 纯低压（高压物理禁用）

**前置**：高压输入开关 Q26 不装或 HV_IN 断开；只焊低压部分。

| 序号 | 测试 | 判据 | 记录 |
|---|---|---|---|
| A1 | 12 V 上电，测 EXT12/EXT5/5V_SYS/3V3/DRV_VDD | 5.08 V ±3%；5V_SYS ≥4.4 V；3.3 V +3.315 V ±2%；DRV_VDD 11.45 V ±0.3 V | 万用表 4 位半 |
| A2 | 仅 USB-C 供电（不接 12 V） | 5V_SYS ≈4.65 V；3.3 V 正常；USB 输入电流 ≤500 mA；HV_EN=0 | 电子负载/电流表 |
| A3 | 电源切换四状态：仅 12 V / 仅 USB / 同时 / 拔插 | 5V_SYS 无回灌（USB 侧反向电流 ≈0）；3.3 V 不跌落至复位阈值以下 | 双通道示波器 + 电流探头 |
| A4 | BOOT/RESET/EN 时序 | EN 上升沿经 10 kΩ×1 µF 延时；BOOT 按住可进下载；GPIO46=0 | 示波器 |
| A5 | USB 原生下载与 UART0 恢复 | esptool 识别；UART0 收发正常；TXD0 波形无过冲 | 逻辑分析仪 |
| A6 | GPIO 默认状态与 HV_EN_REQ | 复位期间 HV_EN=0、DRV_BL=0、DISPLAY 相关均为 0；HV_EN_REQ 仅由固件置 1 | 逻辑分析仪 |
| A7 | Wi-Fi 发射峰值电流与 3.3 V 压降 | 3V3 最低 >3.0 V；模组供电入口纹波满足 S1；平均/峰值电流记录 | 示波器 + 电流探头 |
| A8 | 按键/LED/I2C 预留 | 消抖有效；LED 由 GPIO17 高有效 | 目视/示波器 |

## 阶段 B — 低压驱动逻辑（高压物理断开）

**前置**：HV_BUS 不建立；HV5622 的 VPP 端不接高压（悬空或接低压测试负载）。

| 序号 | 测试 | 判据 |
|---|---|---|
| B1 | 3.3 V→12 V 电平转换 | DIN/CLK/LAT/ALLOW 逻辑同相；3.3 V 断电后 12 V 域全部为低/高阻 |
| B2 | 64 bit 帧时序 | CLK 下降沿移位；LE 高装载；帧长 64 bit；起始 100 kHz 无误码 |
| B3 | walking-one 位序 | 逐位点亮单一通道，回填 `channel_mapping.csv` 的"串行位序"列；确认 U21/U22 近端/远端 |
| B4 | 60 路通道映射 | 每个"管位×数字"只对应一个 HV5622 输出；无重复、无交换、无镜像 |
| B5 | 消隐与全关 | DRV_BL=0 时全部 HVOUT 关断；POL 始终保持高 |
| B6 | 上电/复位默认态 | 上电、复位、掉 3.3 V、掉 12 V 过程中无任何输出意外导通 |
| B7 | 更新流程 | 消隐→移位→锁存→恢复；自检不出现全数字同时导通 |

> 阶段 B 用低压（例如 HVOUT 接 5 V + 电阻）验证开关动作，**不得**当作高压耐压验证。

## 阶段 C — 独立高压电源（隔离测试区）

**前置**：H06 证据齐备；使用高压假负载（等效 6 管：6×(20 kΩ+125 V 模型) 或电阻负载）；
所有测量用高压差分探头；设置隔离与放电等待。

| 序号 | 测试 | 判据 |
|---|---|---|
| C0 | PCB 高压间距/爬电实测（投板后、上高压前） | 实测 ≥ H07 定稿要求；记录最小间距位置 |
| C1 | 空载/单管/六管稳态 | 172 V ±3 V；纹波记录；效率记录 |
| C2 | 启动与软启动 | 过冲 ≤190 V（仿真 180.7 V）；无 OVP 误触发 |
| C3 | 输入 11.4/12/12.6 V | 输出稳定；EXT12_PG/DRV_PG 状态符合门限 |
| C4 | 负载突变 6→1→6 管 | 恢复时间与过冲记录；无 OVP 误触发 |
| C5 | 反馈分压开路 | OVP 在 198.8 V ±1.5 V 内动作并锁存；COMP 被拉低 |
| C6 | 输出短路 10 Ω | 峰值限流工作；无器件损坏；OVP 不误动作 |
| C7 | 输入突然断开 | 泄放到 50 V 时间 ≤5 s（仿真 3.84 s）；给出安全等待时间并写入装配说明 |
| C8 | 浪涌电流 | 峰值 ≤3.5 A；PPTC 不动作；电感/L20 温升可接受 |
| C9 | 阳极电阻单管短路 | 电阻温升 ≤额定 50%；无碳化/变色 |
| C10 | 长时运行 | 30 min 满载：MOSFET/二极管/电感/电阻/驱动 IC 温升记录 |

## 阶段 D — 单管验证（独立限流夹具）

| 序号 | 测试 | 判据 |
|---|---|---|
| D1 | 逐脚限流点亮 | 2=A 阳极；3=K0、4=K9、5=K8、6=K7、7=K6、9=K5、10=K4、11=K3、12=K2、13=K1；1/8 脚无显示 |
| D2 | 起辉/熄灭电压 | 实测与 S6（≤150 V / ≥100 V）对比 |
| D3 | 工作点 | 172 V + 20 kΩ 下电流 1.5–3 mA；亮度/颜色记录 |
| D4 | 管座插拔 | 13 触点全部导通；插拔力/高度与封装 1:1 图一致 |
| D5 | 批次记录 | 商标、批次、缺口/1 脚方向照片归档（H02 关闭证据） |

## 阶段 E — 六管整机

| 序号 | 测试 | 判据 |
|---|---|---|
| E1 | 静态六位显示 000000–999999 | 无重影/串亮；每位数字独立 |
| E2 | 整机功耗与温升 | 12 V 输入 ≤0.8 A；各分区温升记录 |
| E3 | Wi-Fi 三状态干扰 | 升压关/带载/六管切换时信号强度、吞吐、重连、距离对比；装壳复测 |
| E4 | 长时间显示与轮换 | ≥8 h；阴极电流/亮度变化记录（原厂寿命 1000 h 限制说明） |
| E5 | 故障注入 | 复位、看门狗、掉电、OVP、单管短路；全部进入安全态并可恢复；**OVP 复位脉宽 ≥0.2 ms 且仅当 HV<198.8 V 时执行；OVP 后读 HVF_NODE 判故障**（见 firmware_constraints.md F07/F08） |
| E6 | 失效状态与下载恢复 | 3.3 V/12 V 掉电顺序测试；UART0 恢复可用 |

## 仪器与安全

- 高压差分探头（≥1 kV，≥100:1）、电流探头、4 位半万用表、可调隔离电源、假负载、红外测温。
- 高压区操作：单人、断电后按实测等待时间（建议 ≥15 s）再接触；先测电压再插拔电子管。
- 任何阶段不得"让未验证的 PCB 直接承受全电压"来替代缺失设计输入。
