langxie29-cpu/QS30-driver/sim/results/spice_validation.md

# SPICE 验证（仓库自带 minispice 求解器）

## 1. 求解器自检（对照解析解）

| 测试 | 网表 | 指标 | 实测误差 | 判据 | 结果 |
|---|---|---|---|---|---|
| RC 充电（τ=1 ms，5 V） | `sim/spice_tests/01_rc.cir` | max |V_sim - V_analytic| (V) | 1.838e-03 | < 0.01 | PASS |
| RL 电流上升（τ=100 µs，5 V/10 Ω） | `sim/spice_tests/02_rl.cir` | max |I_sim - I_analytic| (A) | 4.589e-04 | < 0.005 | PASS |
| 二极管正向导通（Is=1e-9, N=1.05） | `sim/spice_tests/03_diode.cir` | |Vd_sim - Vd_analytic| (V) | 5.551e-17 | < 0.02 | PASS |
| B 源（V 跟随 + I 积分） | `sim/spice_tests/07_b_source.cir` | max|V(buf)-V(a)| (V) / max|V(c)-解析| (V，扣除 2 步延迟) | 1.000e-02 | < 0.05 | PASS |

## 2. 升压功率级（开环、D=0.73=DCM 工作点占空比）

- 网表：`sim/spice_tests/04_boost_power_stage.cir`
- 稳态输出：**171.99 V**；解析 DCM 预测 171.95 V（偏差 +0.02%）
- 输出纹波（最后一个开关周期）：**8.7 mVpp**（含开关边沿尖峰；单周期电荷法估算 9.0 mVpp）
- 电感电流：均值 200 mA，峰值 503 mA（DCM 峰值解析值 510 mA）
- 二极管导通时间 t2 = 0.70 µs；单周期电荷 0.179 µC ≈ 负载单周期电荷 0.190 µC（功率平衡自洽）
- 单周期能量平衡：输入 2.388 W，负载 2.553 W，电容储能变化 -263.3 mW，效率 **95.9%**（含后向欧拉数值阻尼；步长敏感性见下表）
- 开关节点峰值电压：172.5 V（≈Vout+二极管压降，无振铃模型）

### 与行为模型（S4，六管稳态）对照

| 项目 | 行为模型 S4（闭环） | SPICE 功率级（开环 DCM） | 说明 |
|---|---|---|---|
| 输出均值 | 172.08 V | 171.99 V | 闭环 vs 开环，占空比按 DCM 工作点取 0.73 |
| 电感峰值电流 | 2912 mA | 503 mA | 行为模型的“峰值”含启动浪涌 2.9 A，不能与稳态峰值直接比较 |
| 纹波 | 1106 mVpp | 9 mVpp | 行为模型纹波含控制器离散/极限环成分；SPICE 为功率级真实纹波 |

### 步长敏感性（同一网表，Csw=1 pF）

| 步长 | 网表 | Vout (V) | 纹波 (mVpp) | 电感峰值 (mA) | 效率 |
|---|---|---|---|---|---|
| 50 ns | `sim/spice_tests/05_boost_h50ns.cir` | 171.981 | 8.7 | 501 | 90.0% |
| 20 ns | `sim/spice_tests/05_boost_h20ns.cir` | 171.985 | 8.7 | 502 | 94.4% |
| 10 ns | `sim/spice_tests/05_boost_h10ns.cir` | 171.987 | 8.7 | 503 | 95.9% |

纹波/电感峰值随步长几乎不变（<3%），效率随步长变细收敛（50→10 ns：89.9%→95.8%），说明效率偏差主要来自后向欧拉数值阻尼，而非电路行为。因此：**纹波/峰值/电压比可直接采用 h=10 ns 结果；效率结论需按步长收敛后引用**。

### Coss 敏感性（工程提示）

把 100 pF 开关节点电容加入同一网表（代表 MOSFET Coss+布局电容，不做能量回收，`sim/spice_tests/06_boost_coss100p.cir`）：效率 95.9% → **91.0%**；周期损耗 99 mW → 252 mW（增加 154 mW，½·C·V²·f ≈ 115 mW）。在 2.6 W 输出功率下这是显著项 → 必须选低 Coss 器件并实测（H06）。

## 3. 平均模型闭环（控制参数与 BOM 一致：CINT 22 µF / Ki 1.3e-4 / Kp 0.05）

开关级闭环需 ≈13000 个周期才稳定（>10⁶ 步，超出算力），因此用**平均模型**（去掉开关纹波、保留能量关系与同一组控制参数）验证闭环：

| 项目 | 启动/稳态模型 | 负载+输入阶跃模型 |
|---|---|---|
| 稳态输出 | 172.18 V（误差 3.3 mV） | 172.18 V（误差 2.0 mV） |
| 输出电压范围（稳态） | 172.00–172.33 V | 168.28–172.33 V（输入阶跃最低点） |
| 稳态占空比 | 0.931 | 0.935（输入跌到 11.4 V 后） |
| 电感平均电流 / 峰值 | 219 mA / 300 mA | 340 mA / 711 mA（负载 +50%） |
| 负载 +50%（0.15 s） | — | 下探 0.25 V，恢复 0 ms |
| 输入 12→11.4 V（0.30 s） | — | 下探 3.90 V，恢复 8 ms |
| 输入阶跃 12→11.4 V | — | 最终误差 3.3 mV |

闭环判定：**全部通过**（8/8）。稳态量（172.18 V / 占空比 0.93 / iL≈219 mA）与设计计算自洽。

- 说明：本模型初值取工作点（启动暂态由行为模型 S1 覆盖），不含开关纹波，器件应力与纹波以第 2 节开关级结果为准；负载恢复 ≈158 ms 是当前 PI 参数（CINT 22 µF）下的结果——静态显示时每管恒有 1 路阴极导通，负载变化很小，故可接受；实际环路补偿（R72/C56）仍需在 H06 实测确认相位裕度。

## 3.5 独立 OVP 保护逻辑（行为模型，`sim/boost_ovp_logic.cir`）

在 SPICE 侧验证：**触发 → 锁存 → 关断 → 泄放 → 受控复位 → 故障未消除则再次锁存**。
（把升压级等效为限流受控电流源 + 输出电容；这是保护逻辑的时序/阈值验证，不涉及电感/开关动力学，后者见第 2 节。）

| 项目 | 结果 |
|---|---|
| 首次 OVP 触发电压 | **198.92 V**（1.14 ms） |
| 触发后锁存并关断 | 是（0.05–0.59 s 期间 latch≈1、EN=0） |
| 泄放（0.3 s 时电压） | 123.1 V（<150 V 判据） |
| 复位脉冲释放锁存 | 是（对应 MCU GPIO18→Q25） |
| 故障未消除 → 再次锁存 | 是 |
| 全过程最大电压 | 201.92 V（≤205 V 判据；OVP 阈值 198.8 V） |
| 最终状态 | 保持锁存/关断 |

OVP 判据：**全部通过**（7/7）；波形见 `sim/results/spice_ovp_latch.png`。

边界：本模型不含 SCR 器件级非理想（维持电流、门极触发延迟、结温），器件级与实物时序仍须 H06 验证；行为模型 S7/S8 提供另一路独立证据。

## 4. 结论与边界

- 求解器自检：全部 PASS；RC/RL/二极管误差在 0.2–2% 内，符合一阶后向欧拉精度。
- 功率级 SPICE 已由本仓库求解器执行（不是未运行网表）：输出、电感峰值、二极管导通时间、功率平衡均与解析 DCM 公式自洽。
- 模型局限：理想 L/C、二极管忽略 Rs/Cjo、开关线性过渡、无寄生振铃；因此开关尖峰/EMI/温升仍须实物与器件级 SPICE 验证（H06）。
- 参考 ngspice 网表 `sim/boost_uc3843.cir` 仍未执行（无 ngspice），本文件是其替代证据之一；闭环与保护逻辑由 `design/sim_boost.py` 覆盖。
