langxie29-cpu/QS30-driver/docs/evidence/H03_socket_measurement.csv

item | description | sample1 | sample2 | sample3 | unit | note
M1 | 节圆直径（13 焊脚所在圆） | FILL | FILL | FILL | mm | 非等分时改为逐个极坐标
M2 | 相邻焊脚中心距（实测 3 处） | FILL | FILL | FILL | mm | 记录 3 个位置
M3 | 焊脚直径/宽度 | FILL | FILL | FILL | mm | 3 个样本
M4 | 焊脚长度（座底面以下） | FILL | FILL | FILL | mm | 3 个样本
M5 | 座体最大外径 | FILL | FILL | FILL | mm | 3 个样本
M6 | 座高（PCB 面到插管面） | FILL | FILL | FILL | mm | 3 个样本
M7 | 安装孔位置/孔径 | FILL | FILL | FILL | mm | 相对 1 脚
M8 | 外形轮廓（方/圆/倒角/缺口） | FILL | FILL | FILL | - | 照片+描述
M9 | 定位缺口/1 脚特征 | FILL | FILL | FILL | - | 照片+描述
M10 | 插拔行程/插拔力 | FILL | FILL | FILL | mm/N | 记录仪器
