langxie29-cpu/QS30-driver/sim/results/convergence.md

# 升压仿真数值收敛性检查

同一场景在 3 种积分步长下重复运行；以最细步长（Ts/160）为参考。

| 场景 | 步长 | 稳态电压 (V) | 峰值 (V) | 峰值电流 (A) | OVP 触发 (ms) | ΔV稳态 | ΔV峰值 | ΔI峰值 |
|---|---|---|---|---|---|---|---|---|
| startup6 | Ts/40 | 194.538 | 196.366 | 2.9346 | — | 13.464% | 8.652% | 1.19% |
| startup6 | Ts/80 | 171.46 | 180.748 | 2.9116 | — | 0.003% | 0.01% | 0.397% |
| startup6 | Ts/160 | 171.454 | 180.73 | 2.9001 | — | 0.0% | 0.0% | 0.0% |
| load6 | Ts/40 | 189.403 | 194.83 | 2.9346 | — | 9.02% | 7.802% | 1.19% |
| load6 | Ts/80 | 173.935 | 180.748 | 2.9116 | — | 0.117% | 0.01% | 0.397% |
| load6 | Ts/160 | 173.732 | 180.73 | 2.9001 | — | 0.0% | 0.0% | 0.0% |
| fb_open | Ts/40 | 165.715 | 198.801 | 3.1745 | 0.291 | 14.529% | -0.005% | 1.904% |
| fb_open | Ts/80 | 145.163 | 198.802 | 3.135 | 0.142 | 0.325% | -0.004% | 0.636% |
| fb_open | Ts/160 | 144.693 | 198.81 | 3.1152 | 0.129 | 0.0% | 0.0% | 0.0% |

判据：最粗步长（Ts/40）相对参考的稳态电压偏差应 <1%，峰值电压偏差 <2%，峰值电流偏差 <5%；否则需要减小步长后重跑。
