langxie29-cpu/QS30-driver/docs/evidence/H02_tube_pin_test.csv

tube_id | pin | expected_function | expect_glow | glow_observed_Y/N | pin_current_mA | note
J_T1 | 1 | IC_KEEP_OPEN | N | FILL | FILL
J_T1 | 2 | A | Y | FILL | FILL
J_T1 | 3 | K0 | Y | FILL | FILL
J_T1 | 4 | K9 | Y | FILL | FILL
J_T1 | 5 | K8 | Y | FILL | FILL
J_T1 | 6 | K7 | Y | FILL | FILL
J_T1 | 7 | K6 | Y | FILL | FILL
J_T1 | 8 | IC8_KEEP_OPEN | N | FILL | FILL
J_T1 | 9 | K5 | Y | FILL | FILL
J_T1 | 10 | K4 | Y | FILL | FILL
J_T1 | 11 | K3 | Y | FILL | FILL
J_T1 | 12 | K2 | Y | FILL | FILL
J_T1 | 13 | K1 | Y | FILL | FILL
J_T2 | 1 | IC_KEEP_OPEN | N | FILL | FILL
J_T2 | 2 | A | Y | FILL | FILL
J_T2 | 3 | K0 | Y | FILL | FILL
J_T2 | 4 | K9 | Y | FILL | FILL
J_T2 | 5 | K8 | Y | FILL | FILL
J_T2 | 6 | K7 | Y | FILL | FILL
J_T2 | 7 | K6 | Y | FILL | FILL
J_T2 | 8 | IC8_KEEP_OPEN | N | FILL | FILL
J_T2 | 9 | K5 | Y | FILL | FILL
J_T2 | 10 | K4 | Y | FILL | FILL
J_T2 | 11 | K3 | Y | FILL | FILL
J_T2 | 12 | K2 | Y | FILL | FILL
J_T2 | 13 | K1 | Y | FILL | FILL
J_T3 | 1 | IC_KEEP_OPEN | N | FILL | FILL
J_T3 | 2 | A | Y | FILL | FILL
J_T3 | 3 | K0 | Y | FILL | FILL
J_T3 | 4 | K9 | Y | FILL | FILL
J_T3 | 5 | K8 | Y | FILL | FILL
J_T3 | 6 | K7 | Y | FILL | FILL
J_T3 | 7 | K6 | Y | FILL | FILL
J_T3 | 8 | IC8_KEEP_OPEN | N | FILL | FILL
J_T3 | 9 | K5 | Y | FILL | FILL
J_T3 | 10 | K4 | Y | FILL | FILL
J_T3 | 11 | K3 | Y | FILL | FILL
J_T3 | 12 | K2 | Y | FILL | FILL
J_T3 | 13 | K1 | Y | FILL | FILL
J_T4 | 1 | IC_KEEP_OPEN | N | FILL | FILL
J_T4 | 2 | A | Y | FILL | FILL
J_T4 | 3 | K0 | Y | FILL | FILL
J_T4 | 4 | K9 | Y | FILL | FILL
J_T4 | 5 | K8 | Y | FILL | FILL
J_T4 | 6 | K7 | Y | FILL | FILL
J_T4 | 7 | K6 | Y | FILL | FILL
J_T4 | 8 | IC8_KEEP_OPEN | N | FILL | FILL
J_T4 | 9 | K5 | Y | FILL | FILL
J_T4 | 10 | K4 | Y | FILL | FILL
J_T4 | 11 | K3 | Y | FILL | FILL
J_T4 | 12 | K2 | Y | FILL | FILL
J_T4 | 13 | K1 | Y | FILL | FILL
J_T5 | 1 | IC_KEEP_OPEN | N | FILL | FILL
J_T5 | 2 | A | Y | FILL | FILL
J_T5 | 3 | K0 | Y | FILL | FILL
J_T5 | 4 | K9 | Y | FILL | FILL
J_T5 | 5 | K8 | Y | FILL | FILL
J_T5 | 6 | K7 | Y | FILL | FILL
J_T5 | 7 | K6 | Y | FILL | FILL
J_T5 | 8 | IC8_KEEP_OPEN | N | FILL | FILL
J_T5 | 9 | K5 | Y | FILL | FILL
J_T5 | 10 | K4 | Y | FILL | FILL
J_T5 | 11 | K3 | Y | FILL | FILL
J_T5 | 12 | K2 | Y | FILL | FILL
J_T5 | 13 | K1 | Y | FILL | FILL
J_T6 | 1 | IC_KEEP_OPEN | N | FILL | FILL
J_T6 | 2 | A | Y | FILL | FILL
J_T6 | 3 | K0 | Y | FILL | FILL
J_T6 | 4 | K9 | Y | FILL | FILL
J_T6 | 5 | K8 | Y | FILL | FILL
J_T6 | 6 | K7 | Y | FILL | FILL
J_T6 | 7 | K6 | Y | FILL | FILL
J_T6 | 8 | IC8_KEEP_OPEN | N | FILL | FILL
J_T6 | 9 | K5 | Y | FILL | FILL
J_T6 | 10 | K4 | Y | FILL | FILL
J_T6 | 11 | K3 | Y | FILL | FILL
J_T6 | 12 | K2 | Y | FILL | FILL
J_T6 | 13 | K1 | Y | FILL | FILL
