langxie29-cpu/QS30-driver/sim/results/csv_S1.csv

t_ms | vout_V | iL_mA | ipk_ref | latch | hv_en
0.0000 | -0.0000 | 0.0000 | 0.0001 | 0 | 0
0.0128 | -0.0000 | 0.0000 | 0.0002 | 0 | 0
0.0256 | -0.0000 | 0.0000 | 0.0002 | 0 | 0
0.0385 | -0.0000 | 0.0000 | 0.0003 | 0 | 0
0.0513 | -0.0000 | 0.0000 | 0.0004 | 0 | 0
0.0641 | -0.0000 | 0.0000 | 0.0005 | 0 | 0
0.0769 | -0.0000 | 0.0000 | 0.0005 | 0 | 0
0.0897 | -0.0000 | 0.0000 | 0.0006 | 0 | 0
0.1026 | -0.0000 | 0.0000 | 0.0007 | 0 | 0
0.1154 | -0.0000 | 0.0000 | 0.0008 | 0 | 0
0.1282 | -0.0000 | 0.0000 | 0.0008 | 0 | 0
0.1410 | -0.0000 | 0.0000 | 0.0009 | 0 | 0
0.1538 | -0.0000 | 0.0000 | 0.0010 | 0 | 0
0.1667 | -0.0001 | 0.0000 | 0.0011 | 0 | 0
0.1795 | -0.0001 | 0.0000 | 0.0012 | 0 | 0
0.1923 | -0.0001 | 0.0000 | 0.0012 | 0 | 0
0.2051 | -0.0001 | 0.0000 | 0.0013 | 0 | 0
0.2179 | -0.0001 | 0.0000 | 0.0014 | 0 | 0
0.2308 | -0.0001 | 0.0000 | 0.0015 | 0 | 0
0.2436 | -0.0001 | 0.0000 | 0.0016 | 0 | 0
0.2564 | -0.0001 | 0.0000 | 0.0016 | 0 | 0
0.2692 | -0.0001 | 0.0000 | 0.0017 | 0 | 0
0.2821 | -0.0001 | 0.0000 | 0.0018 | 0 | 0
0.2949 | -0.0001 | 0.0000 | 0.0019 | 0 | 0
0.3077 | -0.0001 | 0.0000 | 0.0020 | 0 | 0
0.3205 | -0.0001 | 0.0000 | 0.0021 | 0 | 0
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
