langxie29-cpu/QS30-driver/sim/results/01_startup_and_loads.png

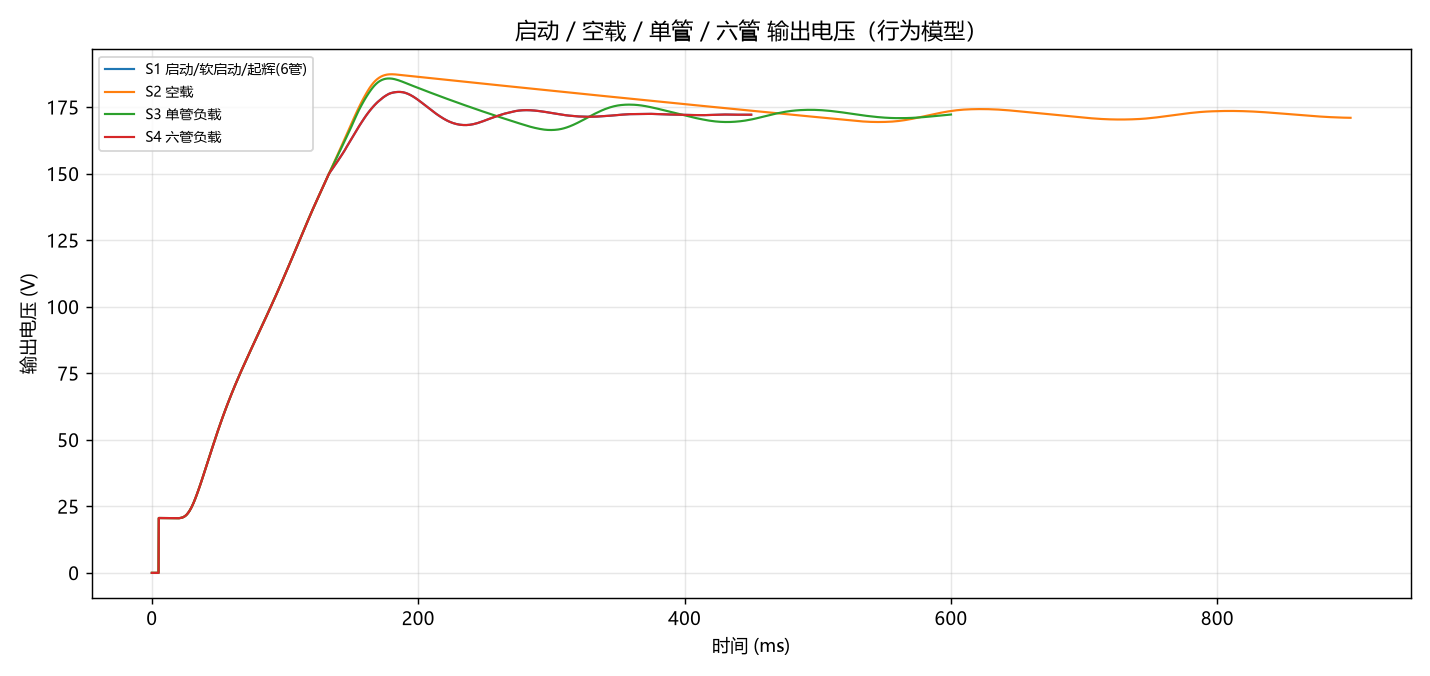
sim/results/01_startup_and_loads.png
