langxie29-cpu/QS30-driver/sim/results/03_ovp_latch_and_reset.png

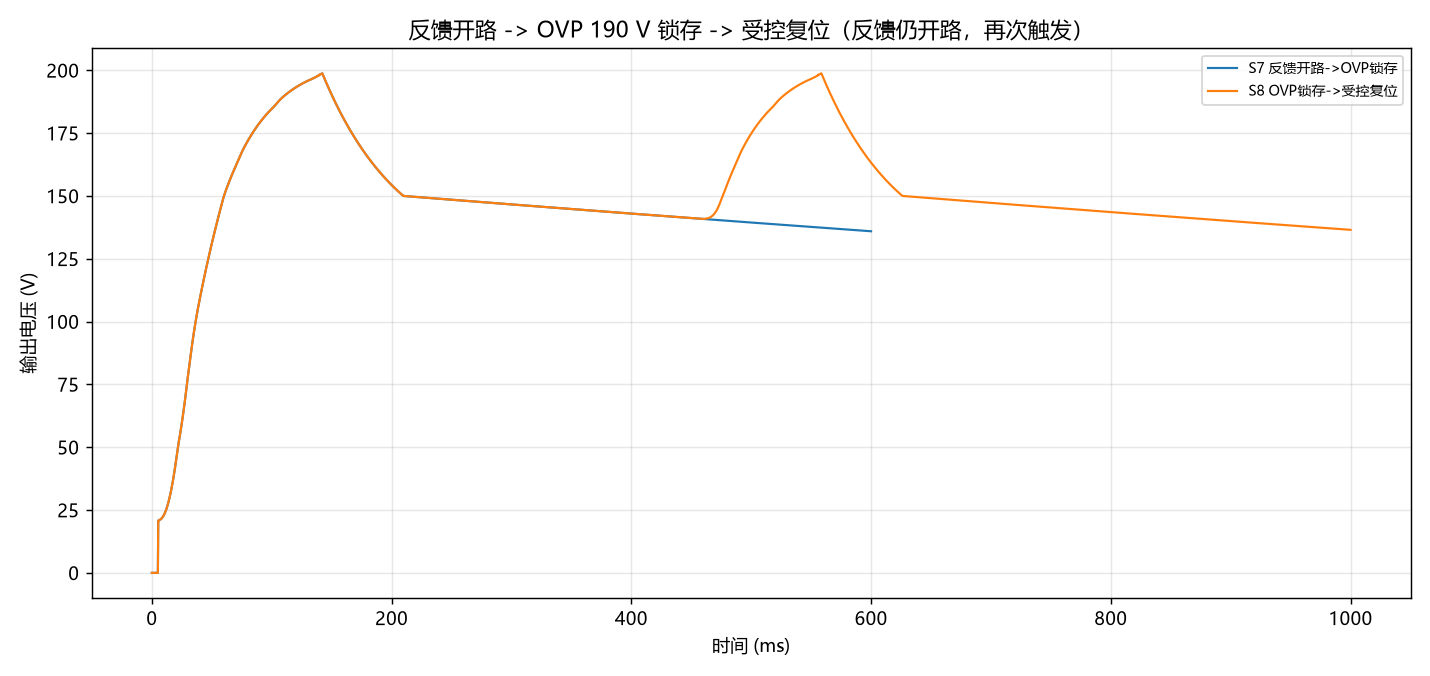
sim/results/03_ovp_latch_and_reset.png
