langxie29-cpu/QS30-driver/sim/results/04_discharge.png

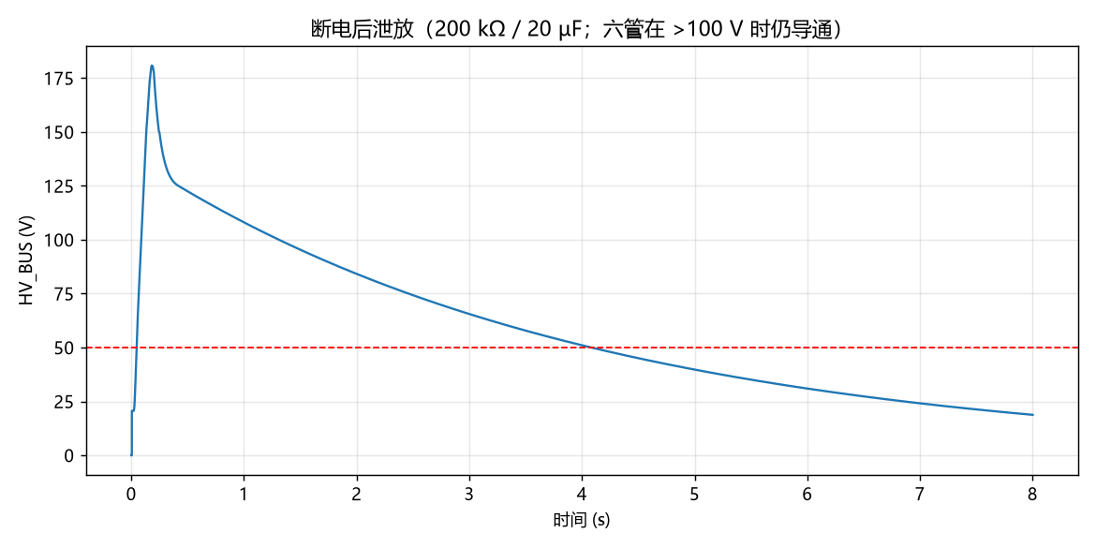
sim/results/04_discharge.png
