langxie29-cpu/QS30-driver/sim/results/05_output_short.png

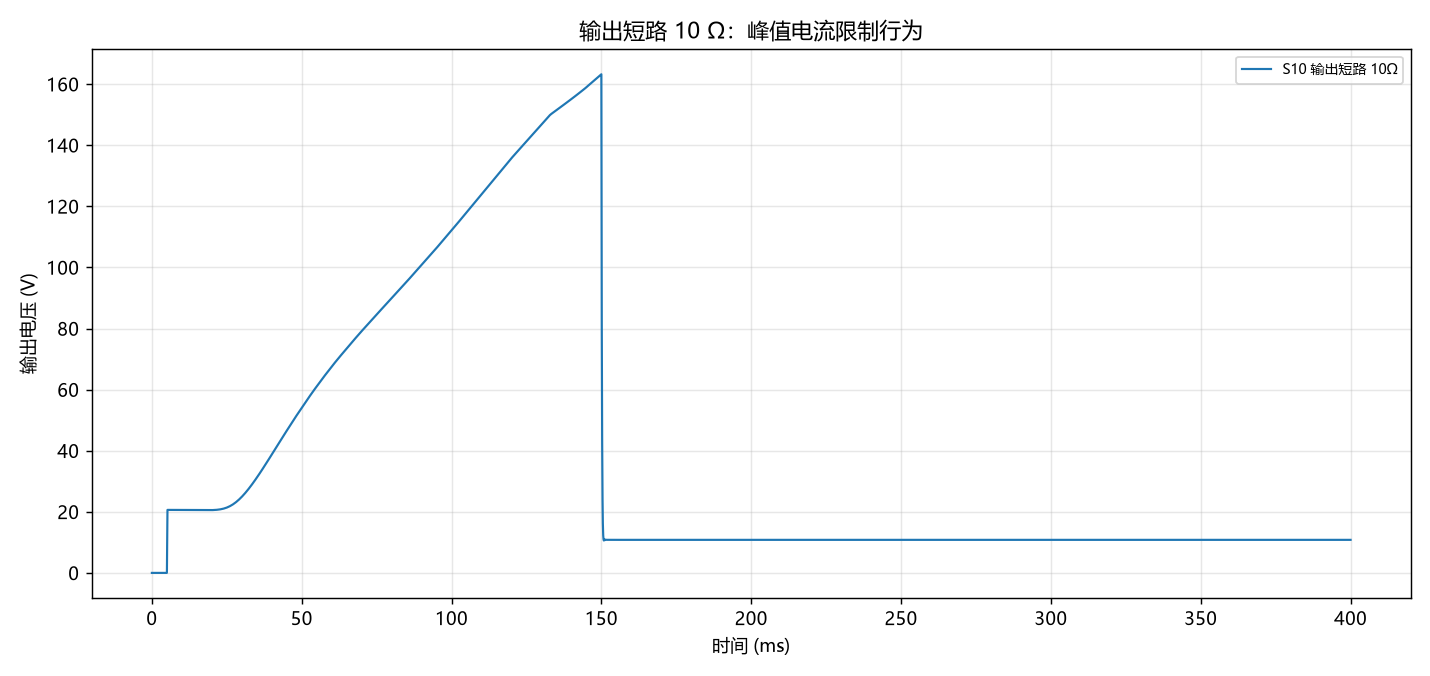
sim/results/05_output_short.png
