langxie29-cpu/QS30-driver/sim/results/loop_scan_heatmap.png

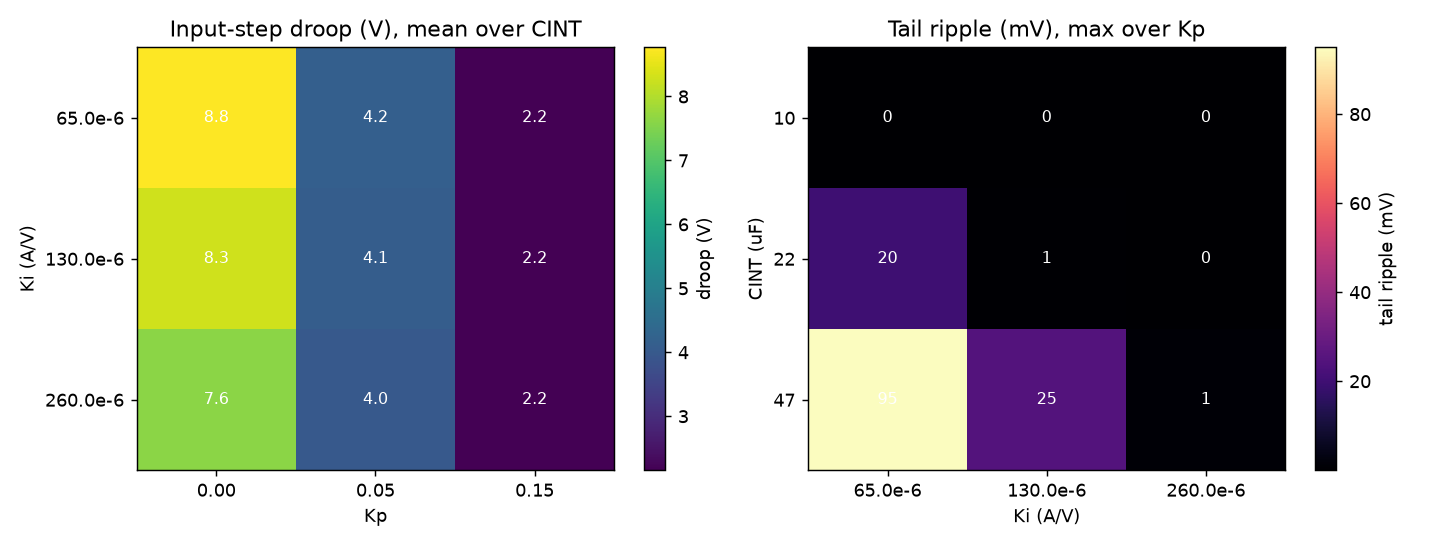
sim/results/loop_scan_heatmap.png
