langxie29-cpu/QS30-driver/sim/results/ovp_timing.png

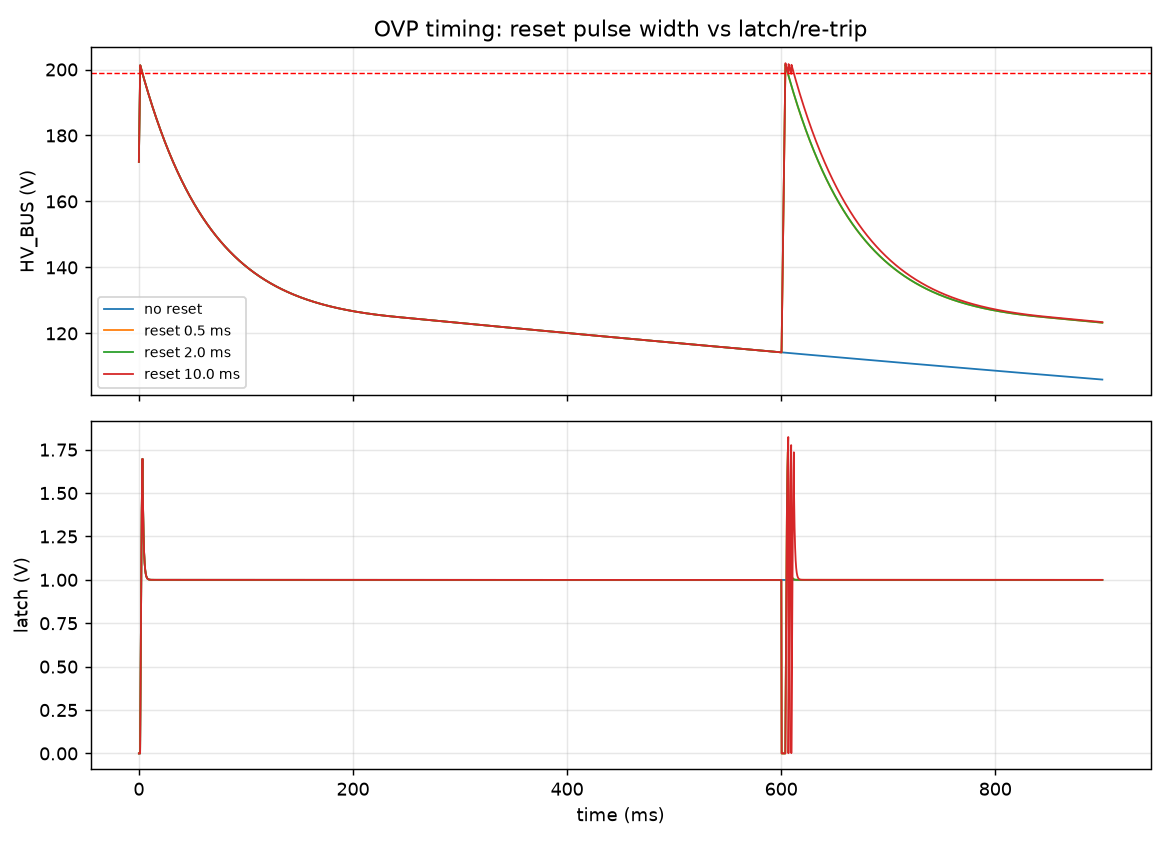
sim/results/ovp_timing.png
