langxie29-cpu/QS30-driver/sim/results/spice_averaged_closed_loop.png

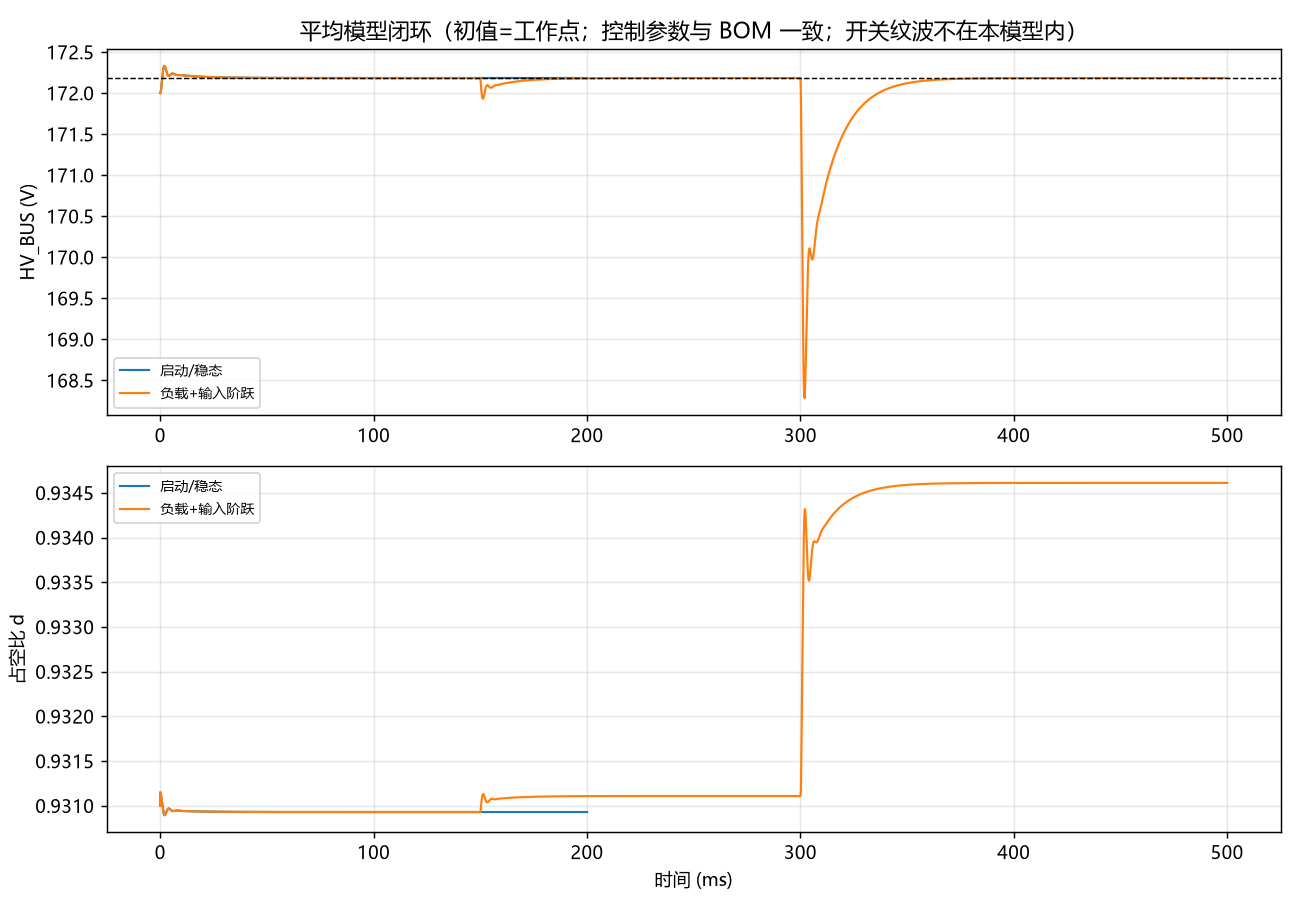
sim/results/spice_averaged_closed_loop.png
