langxie29-cpu/QS30-driver/sim/results/spice_boost_waveforms.png

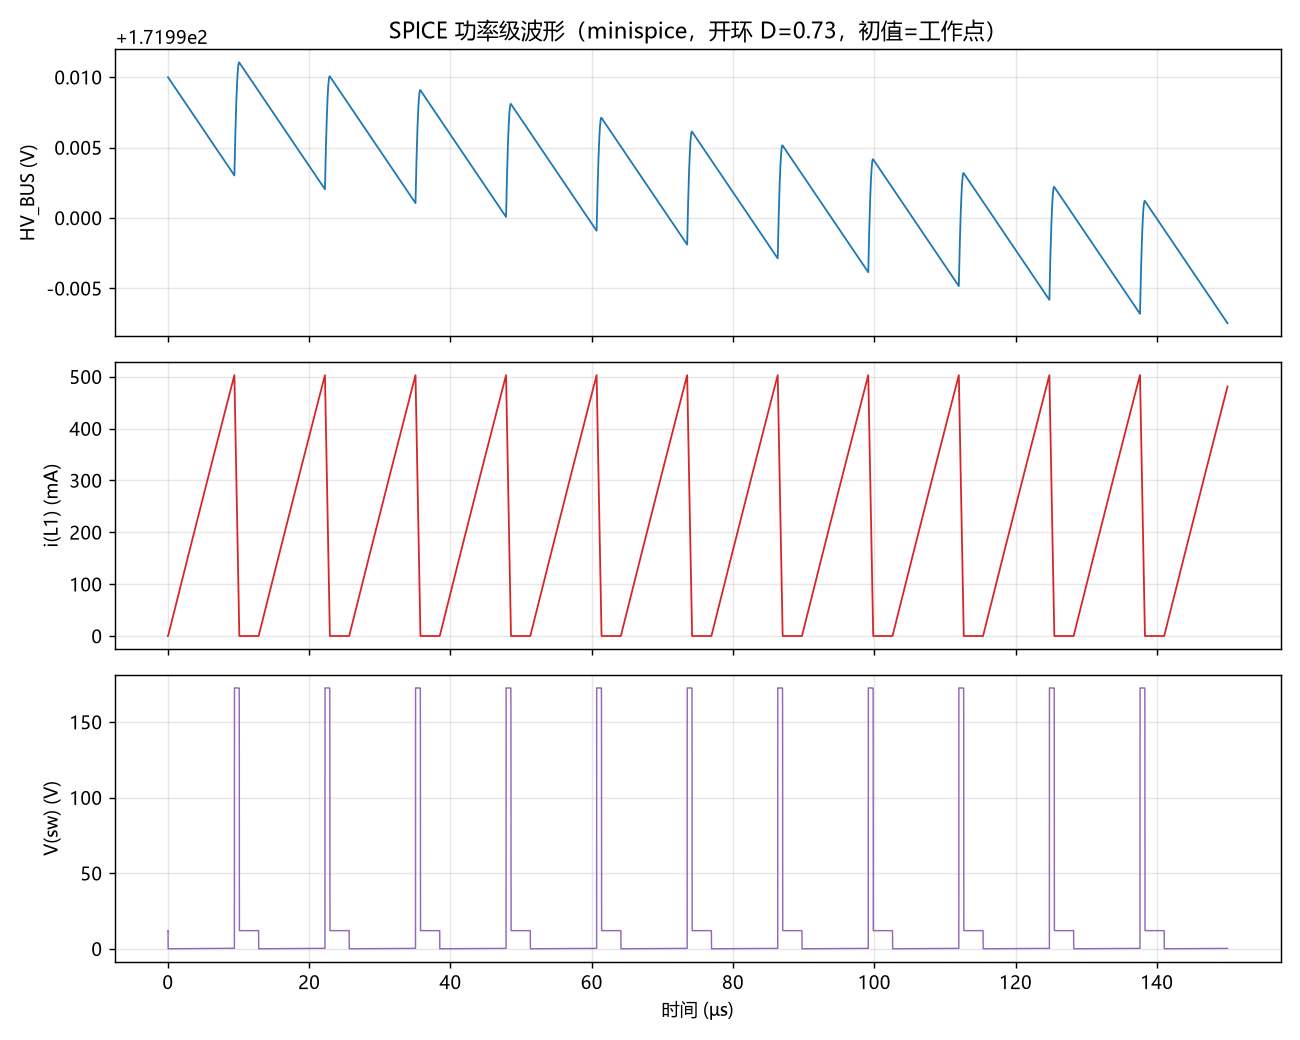
sim/results/spice_boost_waveforms.png
