langxie29-cpu/QS30-driver/sim/results/spice_ovp_latch.png

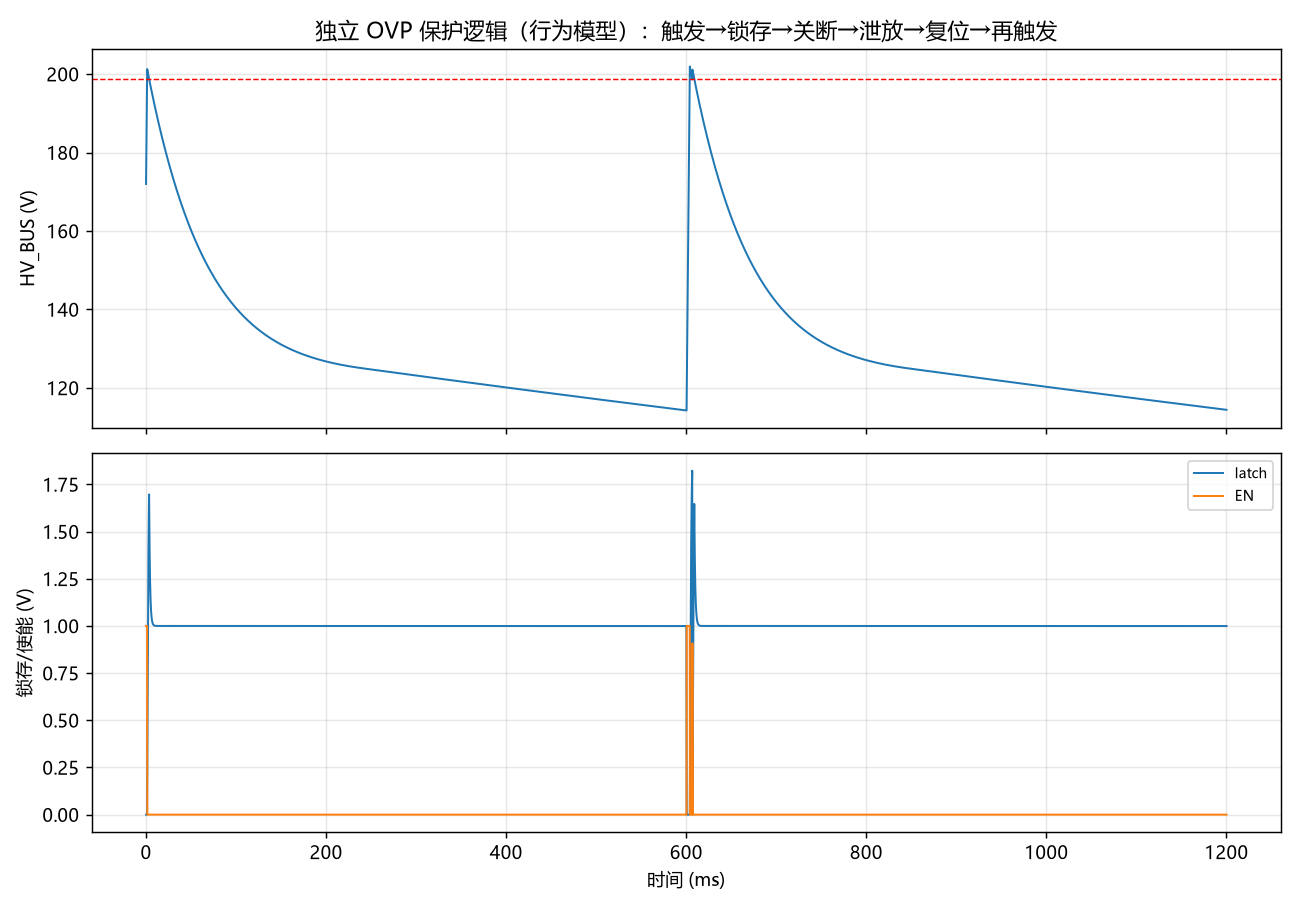
sim/results/spice_ovp_latch.png
