langxie29-cpu/QS30-driver/open_issues.md

# QS30-6 REV.A 未关闭问题清单（open issues）

更新：2026-10-18 ｜ 与 `HOLD_REGISTER.md` 配套使用。`阻塞` = 是否阻止设计冻结/投板。

| 编号 | 问题 | 级别 | 阻塞 | 现状与证据 | 下一步动作 | 关联 HOLD |
|---|---|---|---|---|---|---|
| I-01 | 旧交接文件中的完整原理图/网表未进入本基线，无法做逐行红线对比 | 高 | 是 | 本仓库只有交接 docx；无旧原理图文件 | 把旧原理图/网表纳入版本库，做逐网络 diff | H01 |
| I-02 | J13-1A 管座无原文尺寸；GB 787-74 正文未取得 | 高 | 是 | 仅知管基型号；管座可采购型号未锁定 | 购样实测：13 触点通断表、焊脚 XY/孔径、1 脚视图、1:1 打印比对 | H03 |
| I-03 | QS30-1 批次/辉光电压/电流未实测 | 高 | 是 | 原厂图与参数已 VERIFIED，但批次一致性未证 | 单管夹具逐脚点亮，记录 U_tube、I、亮度、起辉/熄灭电压 | H02 |
| I-04 | 启动浪涌 2.9–3.1 A（仿真）是否触发 PPTC / 超电感 Isat | 高 | 是 | S1–S6 仿真峰值 2.91–3.14 A；L20 需 Isat ≥5 A | 实测浪涌波形；确认 PPTC I²t；必要时加 NTC/预充 | H06 |
| I-05 | 高压间距/爬电距离未按标准冻结 | 高 | 是 | 网络类别已建，但间距是 1.0 mm 占位 | 确定最大电压/材料/污染等级/适用标准后重算 | H07 |
| I-06 | 反馈分压开路时 OVP 只在仿真中验证 | 高 | 是 | S7/S8 仿真：142 ms 触发、复位后再触发 | 实物断路试验 + 阈值容差（198.8 V ±~1.1 V） | H06 |
| I-07 | 串行位序/近远端器件未实测 | 中 | 是（固件冻结前） | `channel_mapping.csv` 中位序标注 PROVISIONAL | walking-one 逐位测试，回填映射表 | H04 |
| I-08 | 空载（消隐）时过冲 8.8%（187.4 V） | 中 | 否 | S2 仿真；仍 < OVP 198.8 V，但裕量 11.4 V | 实物验证消隐稳态纹波/过冲；必要时加大 Cout 或调环路 | H06 |
| I-09 | 仅 USB 供电时可能超过 500 mA 默认电流 | 中 | 是（H05 验收前） | 3.3 V 满载 0.8 A → 5V 侧 ≈0.63 A；USB 默认 500 mA | 固件在 USB-only 关闭 Wi-Fi/限流；实测 USB 电流 | H05 |
| I-10 | CD40109B 在 3.3 V/12 V 下的时序与失电回灌未实测 | 中 | 是（H04） | 引脚与功能 VERIFIED；延迟按 ≤600 ns 暂估 | 示波器测 tPHL/tPLH；断 3.3 V/12 V 顺序测输出状态 | H04 |
| I-11 | HV5622 上电瞬间输出状态（VDD 爬升、BL 低） | 中 | 否（靠 HV 互锁） | 数据手册 Table 3-2：POL/BL 均低时"All On" | 验证 HV 母线在 DRV_PG 前不建立；记录时序 | H04/H06 |
| I-12 | 阳极电阻故障耗散 1.48 W 的实际降额/温升 | 中 | 否 | 计算 0.74 W/只（2 W 件） | 单管短路 10 min 温升测试 | H06 |
| I-13 | 天线净空与整机 RF 未验证 | 中 | 是（结构冻结前） | 预布局已画禁布；外壳未定 | 装壳后测 Wi-Fi 吞吐/重连/距离，三状态对比 | H08 |
| I-14 | 3.3 V 热/纹波/Wi-Fi 瞬态压降未实测 | 中 | 是（H05） | 预算 800 mA；TPS54202/SY8089A 候选 | 实测启动、TX 峰值、压降、温升 | H05 |
| I-15 | 立创EDA 原生 ERC/DRC 未执行 | 中 | 是（H09） | 本环境无立创EDA；仅做了网表级自动检查 | 按 `docs/lceda_implementation_guide.md` 建工程后跑 ERC/DRC 并登记 | H09 |
| I-16 | 管座封装焊盘坐标/孔径未定 | 高 | 是 | 已建立参数化草案 `symbols/QS30-1_socket_footprint_draft.json`（全部 TBD，脚本校验“无猜测数值”）+ 1:1 校对页 + 实测工作表；仍无坐标/孔径 | 按工作表实测后填 TBD → 生成封装 v2 → 1:1 叠图 | H03 |
| I-19 | 厂商 SPICE 引擎不可用：KiCad 需管理员安装、ngspice 下载被 403 | 中 | 否（已有替代） | 仓库自带 `sim/minispice.py` 已执行升压功率级 SPICE 并经解析解验证；`sim/boost_uc3843.cir`（厂商网表）仍未执行 | 在有权限环境运行 ngspice 网表并归档日志 | H06 |
| I-22 | 开关节点 Coss 使效率下降：100 pF 时 95.9%→91.0%（SPICE 敏感性） | 中 | 是（H06） | 2.6 W 输出下 0.12 W 显著；IRF740 Coss 偏大 | 选低 Coss 器件、评估缓冲/软开关，实测开关损耗与温升 | H06 |
| I-20 | 无可编辑原生 EDA 工程（无立创EDA/KiCad） | 中 | 是（H09） | 已提供逐引脚网表、BOM、连接表式原理图 PDF、建库说明、审查包；**新增网表级 DRC 预检 10/10 PASS**；原生工程与原生 ERC/DRC 仍缺 | 在装有立创EDA 的机器按 `docs/lceda_implementation_guide.md` 重建，跑 ERC/DRC 并登记 | H09 |
| I-23 | **开关级**闭环 SPICE 未执行（环路时间常数 ≈170 ms，>10⁶ 步超出本环境算力） | 低 | 否 | 已用**平均模型闭环**补齐（172.18 V/duty 0.931/负载与输入阶跃 8/8）；**OVP 保护逻辑已由 `boost_ovp_logic.cir` 在 SPICE 侧验证（7/7）**；开关级器件应力由开环功率级覆盖 | 在有 ngspice 的机器运行 `sim/boost_uc3843.cir` 做器件级交叉验证 | H06 |
| I-24 | HOLD 证据全部未提交（无实物数据，属正常状态） | — | 是（H02–H08） | 证据模板与自动校验框架已就绪（0/7 已提交）；自测证明判据有效 | 现场测试后填表 → `evidence_check.py` → 人工签署 | H02–H08 |
| I-25 | PPTC I²t/触发曲线、HV5622 VDD 电流/Von/Rth_ja 未从手册核实 | 低 | 否（有保守估算） | 热/浪涌复核用参数区间：温升 0.7–6.3 °C、I²t 0.0010 A²s（远低于 0.1 下限） | 查手册 + H05/H06 实测波形回填 | H05/H06 |
| I-21 | 1:1 校对页的物理比例依赖打印机设置 | 低 | 否 | 页内已含 100 mm 标尺与“实际大小/100%”提示 | 打印后先量标尺，偏差>0.5 mm 则重打 | H03 |
| I-17 | QS30-1 寿命 1000 h，长期常亮场景未评估 | 低 | 否 | 原厂参数表 | 决定是否轮换数字/降低电流，并记录 | H02 |
| I-18 | 无 PSRAM 版本 N8 的采购状态未核实 | 低 | 否 | S1 只给型号规则 | 采购前核对订货型号与立创商城料号 | H05 |

## 已知并已修正的问题（保留记录）

| 编号 | 问题 | 处理 |
|---|---|---|
| F-01 | TL431 DBZ(SOT-23-3) 引脚被按 DBV(SOT-23-5) 顺序写成 1=REF/2=ANODE/3=CATHODE | 依据 S17 Table 5-1 改为 1=CATHODE/2=REF/3=ANODE，并同步连接（REF 与 CATHODE 短接） |
| F-02 | 泄放电阻 440 kΩ 使 172 V→50 V 需 ≈10.7 s | 改为 2×100 kΩ=200 kΩ，仿真 3.84 s |
| F-03 | EXT12_PG 门限 11.0 V 会导致 12 V−5% 输入（EXT12=10.9 V）禁止高压 | 改为 10.80 V（=HV5622 VDD 下限） |
| F-04 | L20 标称 3 A 小于启动浪涌 2.9 A 峰值 | 改标 Isat ≥5 A（值仍 220 µH） |
| F-05 | HV5622 按 3 片/96 bit 规划 | 按 S5 重算为 2 片/64 bit，见 D-03 |
| F-06 | 数值仿真在 Ts/40 步长下稳态电压偏差 +13.5%，若直接采用会得出错误结论 | 已做步长收敛性检查，主仿真固定 Ts/80（相对 Ts/160 偏差 ≤0.4%），并把步长写入结论 |
