langxie29-cpu/QS30-driver/(commit log)

2026-10-18 QS30-6 REV.A: QS30-1 six-tube static HV5622 driver - engineering package (schematics/netlist/BOM/sim/ERC-DRC/test plan; RELEASE BLOCKED pending HOLDs)
    [01_PWR_nets.csv, 02_MCU_nets.csv, 03_DRV_nets.csv, 04_HV_nets.csv, 05_TUBE_nets.csv, 06_TP_nets.csv, H02_tube_operating_point.csv, H02_tube_pin_test.csv]
2026-10-25 docs: add project-specific agent safety and Σ sync protocol
